freesurfer-rge/slothpu16/README.md

# slothpu16

This is a major revision of [an earlier project](http://www.github.com/freesurfer-rge/slothpu/) to build a computer from 7400-series logic.
This implements a simple 16-bit CPU with a load/store architecture.
