freesurfer-rge/slothpu16/python/ReadMe.md

# Python Code

This directory contains code other than that required for testing the PCBs.
