freesurfer-rge/slothpu16/(threads)

Thread 15 (2025-02-02):

[PCB] Missing silkscreen on ALU Carrier

freesurfer-rge, 2025-02-02:
Forgot to label the various edge connectors on the ALU carrier board.

Closed 2025-04-06.

Thread 20 (2025-05-16):

[PCB] Register File Carrier uses two 74HC04

freesurfer-rge, 2025-05-16:
When putting the JLCPCB order together, noticed that there were two different 74HC04 (hex inverters) present. Since neither was triggering the 'extended item' charges at the time, I didn't fix it. But if there is an revised board, this should be straightened out.
