freesurfer-rge/slothpu16/pcbs/SlothPU Backplane/SlothPU Backplane.kicad_pcb

## KiCad design pcbs/SlothPU Backplane/SlothPU Backplane.kicad_pcb (2025-09-15)

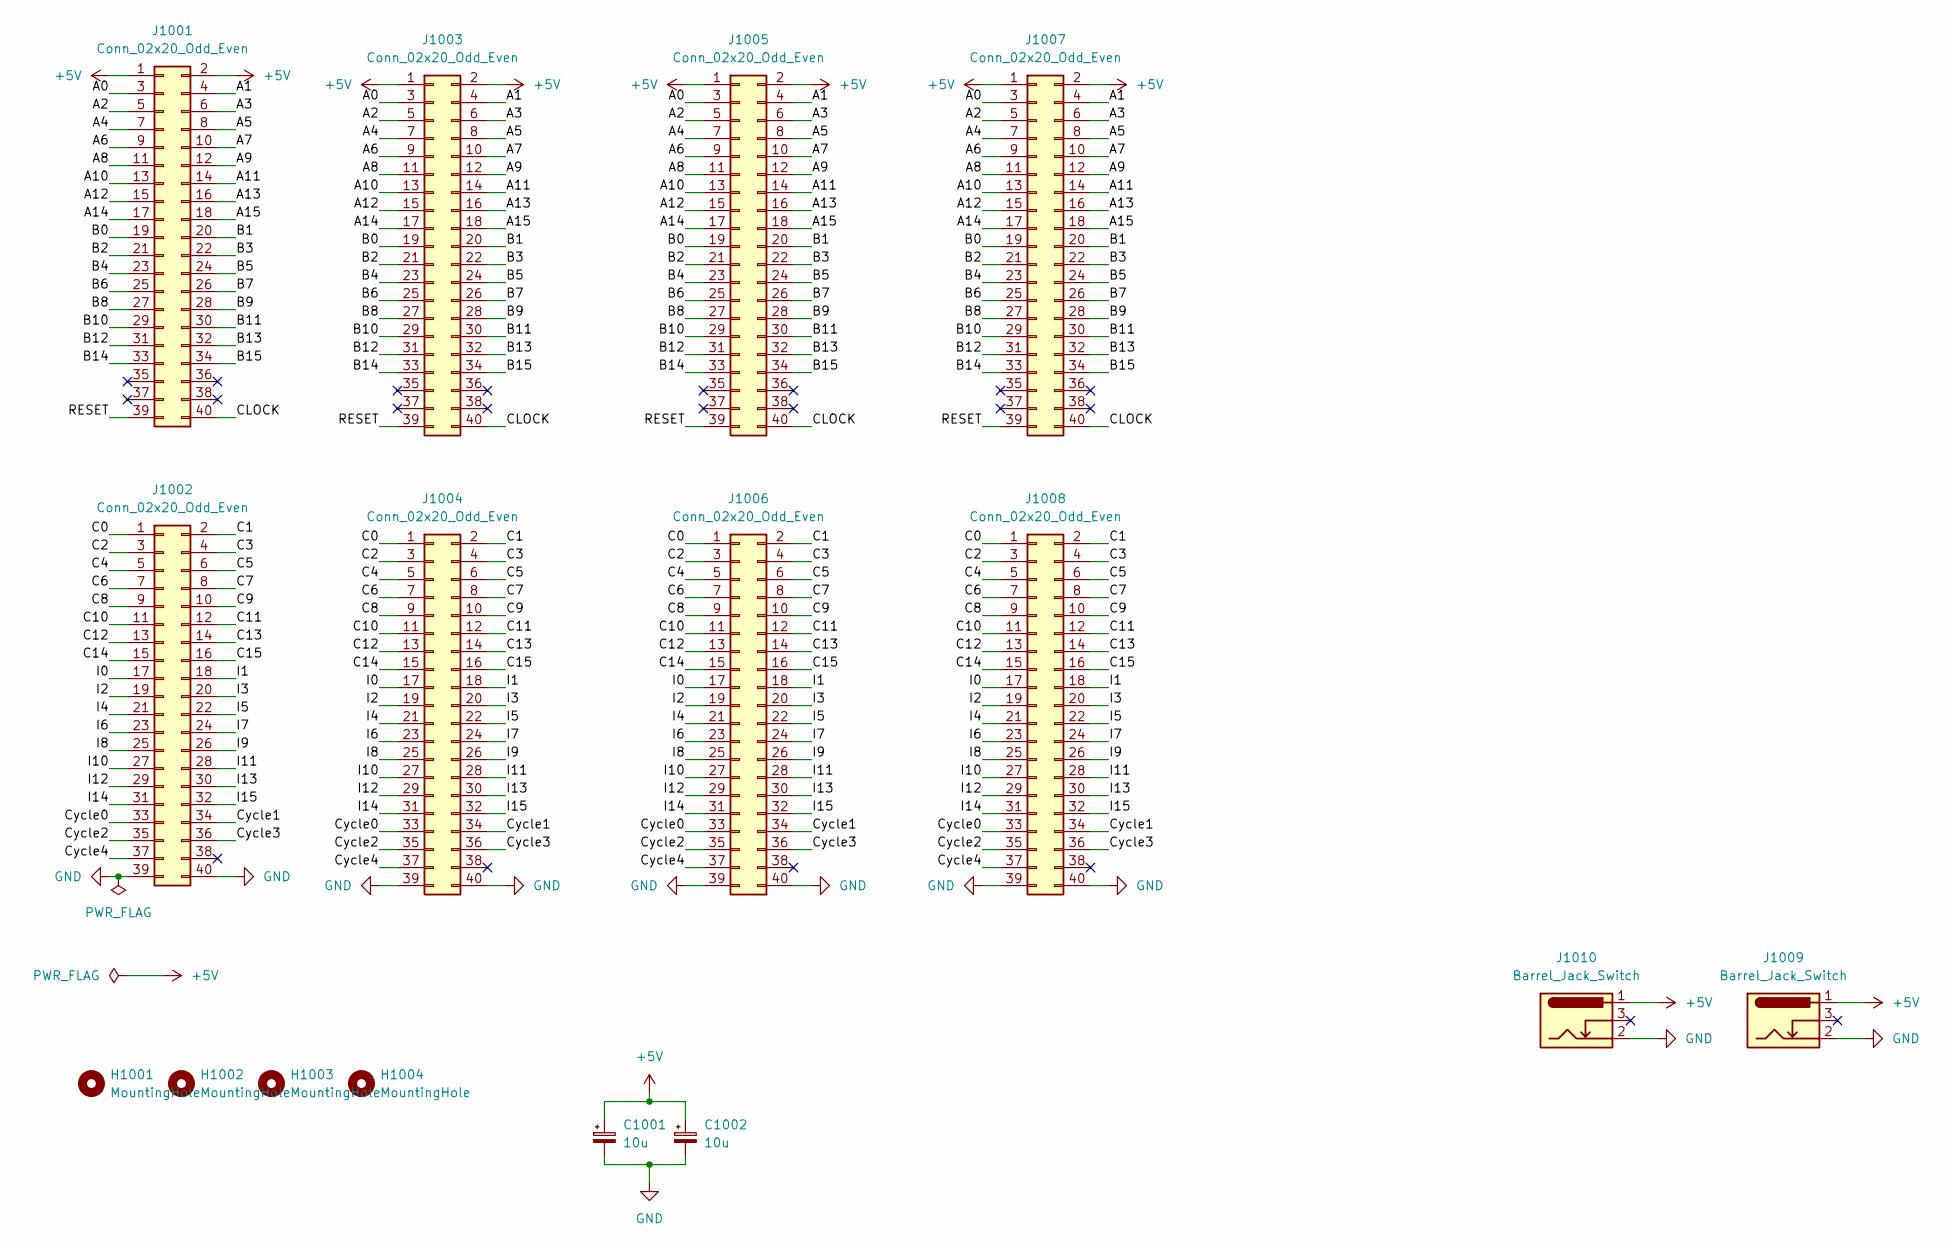
[picture p1: schematic SlothPU Backplane.kicad_sch]

Parts:
C1001, C1002: 10u; CP_Radial_D4.0mm_P1.50mm
H1001, H1002, H1003, H1004: MountingHole; MountingHole_2.7mm_M2.5_ISO7380
J1001, J1002, J1003, J1004, J1005, J1006, J1007, J1008: Conn_02x20_Odd_Even; PinHeader_2x20_P2.54mm_Vertical
J1009, J1010: Barrel_Jack_Switch; BarrelJack_Horizontal

Connections:
+5V: C1001.1, C1002.1, J1001.1, J1001.2, J1003.1, J1003.2, J1005.1, J1005.2, J1007.1, J1007.2, J1009.1, J1010.1
/A0: J1001.3, J1003.3, J1005.3, J1007.3
/A1: J1001.4, J1003.4, J1005.4, J1007.4
/A2: J1001.5, J1003.5, J1005.5, J1007.5
/A3: J1001.6, J1003.6, J1005.6, J1007.6
/A4: J1001.7, J1003.7, J1005.7, J1007.7
/A5: J1001.8, J1003.8, J1005.8, J1007.8
/A6: J1001.9, J1003.9, J1005.9, J1007.9
/A7: J1001.10, J1003.10, J1005.10, J1007.10
/A8: J1001.11, J1003.11, J1005.11, J1007.11
/A9: J1001.12, J1003.12, J1005.12, J1007.12
/A10: J1001.13, J1003.13, J1005.13, J1007.13
/A11: J1001.14, J1003.14, J1005.14, J1007.14
/A12: J1001.15, J1003.15, J1005.15, J1007.15
/A13: J1001.16, J1003.16, J1005.16, J1007.16
/A14: J1001.17, J1003.17, J1005.17, J1007.17
/A15: J1001.18, J1003.18, J1005.18, J1007.18
/B0: J1001.19, J1003.19, J1005.19, J1007.19
/B1: J1001.20, J1003.20, J1005.20, J1007.20
/B2: J1001.21, J1003.21, J1005.21, J1007.21
/B3: J1001.22, J1003.22, J1005.22, J1007.22
/B4: J1001.23, J1003.23, J1005.23, J1007.23
/B5: J1001.24, J1003.24, J1005.24, J1007.24
/B6: J1001.25, J1003.25, J1005.25, J1007.25
/B7: J1001.26, J1003.26, J1005.26, J1007.26
/B8: J1001.27, J1003.27, J1005.27, J1007.27
/B9: J1001.28, J1003.28, J1005.28, J1007.28
/B10: J1001.29, J1003.29, J1005.29, J1007.29
/B11: J1001.30, J1003.30, J1005.30, J1007.30
/B12: J1001.31, J1003.31, J1005.31, J1007.31
/B13: J1001.32, J1003.32, J1005.32, J1007.32
/B14: J1001.33, J1003.33, J1005.33, J1007.33
/B15: J1001.34, J1003.34, J1005.34, J1007.34
/C0: J1002.1, J1004.1, J1006.1, J1008.1
/C1: J1002.2, J1004.2, J1006.2, J1008.2
/C2: J1002.3, J1004.3, J1006.3, J1008.3
/C3: J1002.4, J1004.4, J1006.4, J1008.4
/C4: J1002.5, J1004.5, J1006.5, J1008.5
/C5: J1002.6, J1004.6, J1006.6, J1008.6
/C6: J1002.7, J1004.7, J1006.7, J1008.7
/C7: J1002.8, J1004.8, J1006.8, J1008.8
/C8: J1002.9, J1004.9, J1006.9, J1008.9
/C9: J1002.10, J1004.10, J1006.10, J1008.10
/C10: J1002.11, J1004.11, J1006.11, J1008.11
/C11: J1002.12, J1004.12, J1006.12, J1008.12
/C12: J1002.13, J1004.13, J1006.13, J1008.13
/C13: J1002.14, J1004.14, J1006.14, J1008.14
/C14: J1002.15, J1004.15, J1006.15, J1008.15
/C15: J1002.16, J1004.16, J1006.16, J1008.16
/CLOCK: J1001.40, J1003.40, J1005.40, J1007.40
/Cycle0: J1002.33, J1004.33, J1006.33, J1008.33
/Cycle1: J1002.34, J1004.34, J1006.34, J1008.34
/Cycle2: J1002.35, J1004.35, J1006.35, J1008.35
/Cycle3: J1002.36, J1004.36, J1006.36, J1008.36
/Cycle4: J1002.37, J1004.37, J1006.37, J1008.37
/I0: J1002.17, J1004.17, J1006.17, J1008.17
/I1: J1002.18, J1004.18, J1006.18, J1008.18
/I2: J1002.19, J1004.19, J1006.19, J1008.19
/I3: J1002.20, J1004.20, J1006.20, J1008.20
/I4: J1002.21, J1004.21, J1006.21, J1008.21
/I5: J1002.22, J1004.22, J1006.22, J1008.22
/I6: J1002.23, J1004.23, J1006.23, J1008.23
/I7: J1002.24, J1004.24, J1006.24, J1008.24
/I8: J1002.25, J1004.25, J1006.25, J1008.25
/I9: J1002.26, J1004.26, J1006.26, J1008.26
/I10: J1002.27, J1004.27, J1006.27, J1008.27
/I11: J1002.28, J1004.28, J1006.28, J1008.28
/I12: J1002.29, J1004.29, J1006.29, J1008.29
/I13: J1002.30, J1004.30, J1006.30, J1008.30
/I14: J1002.31, J1004.31, J1006.31, J1008.31
/I15: J1002.32, J1004.32, J1006.32, J1008.32
/RESET: J1001.39, J1003.39, J1005.39, J1007.39
GND: C1001.2, C1002.2, J1002.39, J1002.40, J1004.39, J1004.40, J1006.39, J1006.40, J1008.39, J1008.40, J1009.2, J1010.2

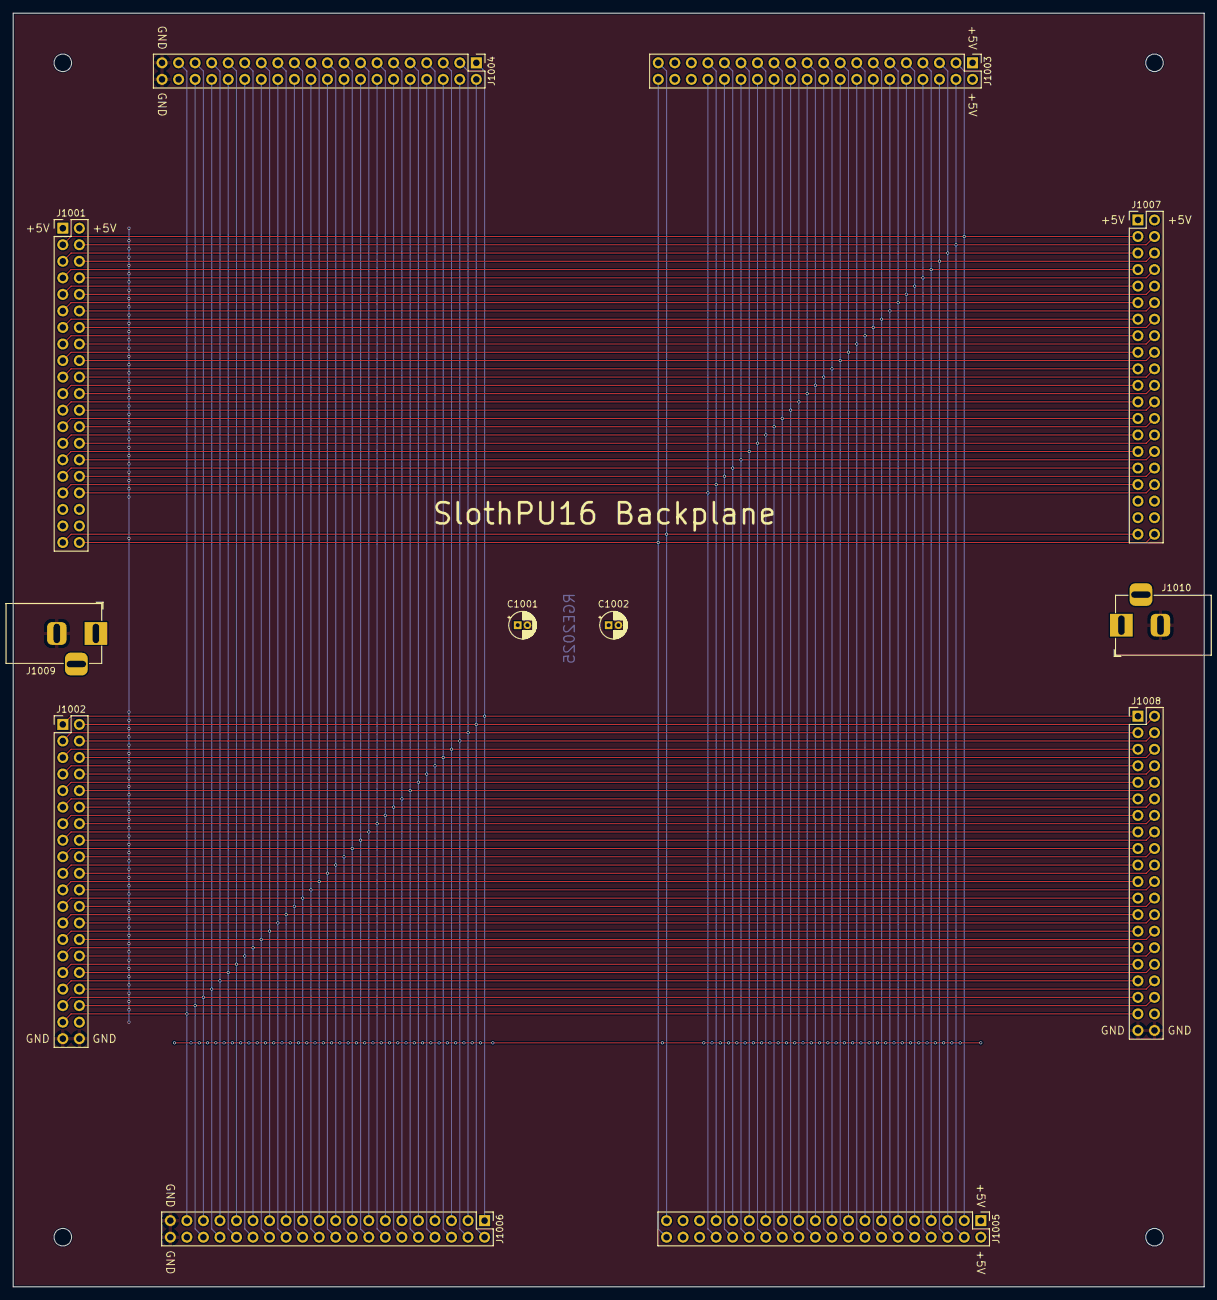
[picture p2: board SlothPU Backplane.kicad_pcb from above]

Board: 2 copper layers, 182.9 x 195.6 mm, 16 parts (0 on the bottom side), 73 nets.
