freesurfer-rge/slothpu16/pcbs/Instruction Register/Instruction Register.kicad_pcb

## KiCad design pcbs/Instruction Register/Instruction Register.kicad_pcb (2025-08-27)

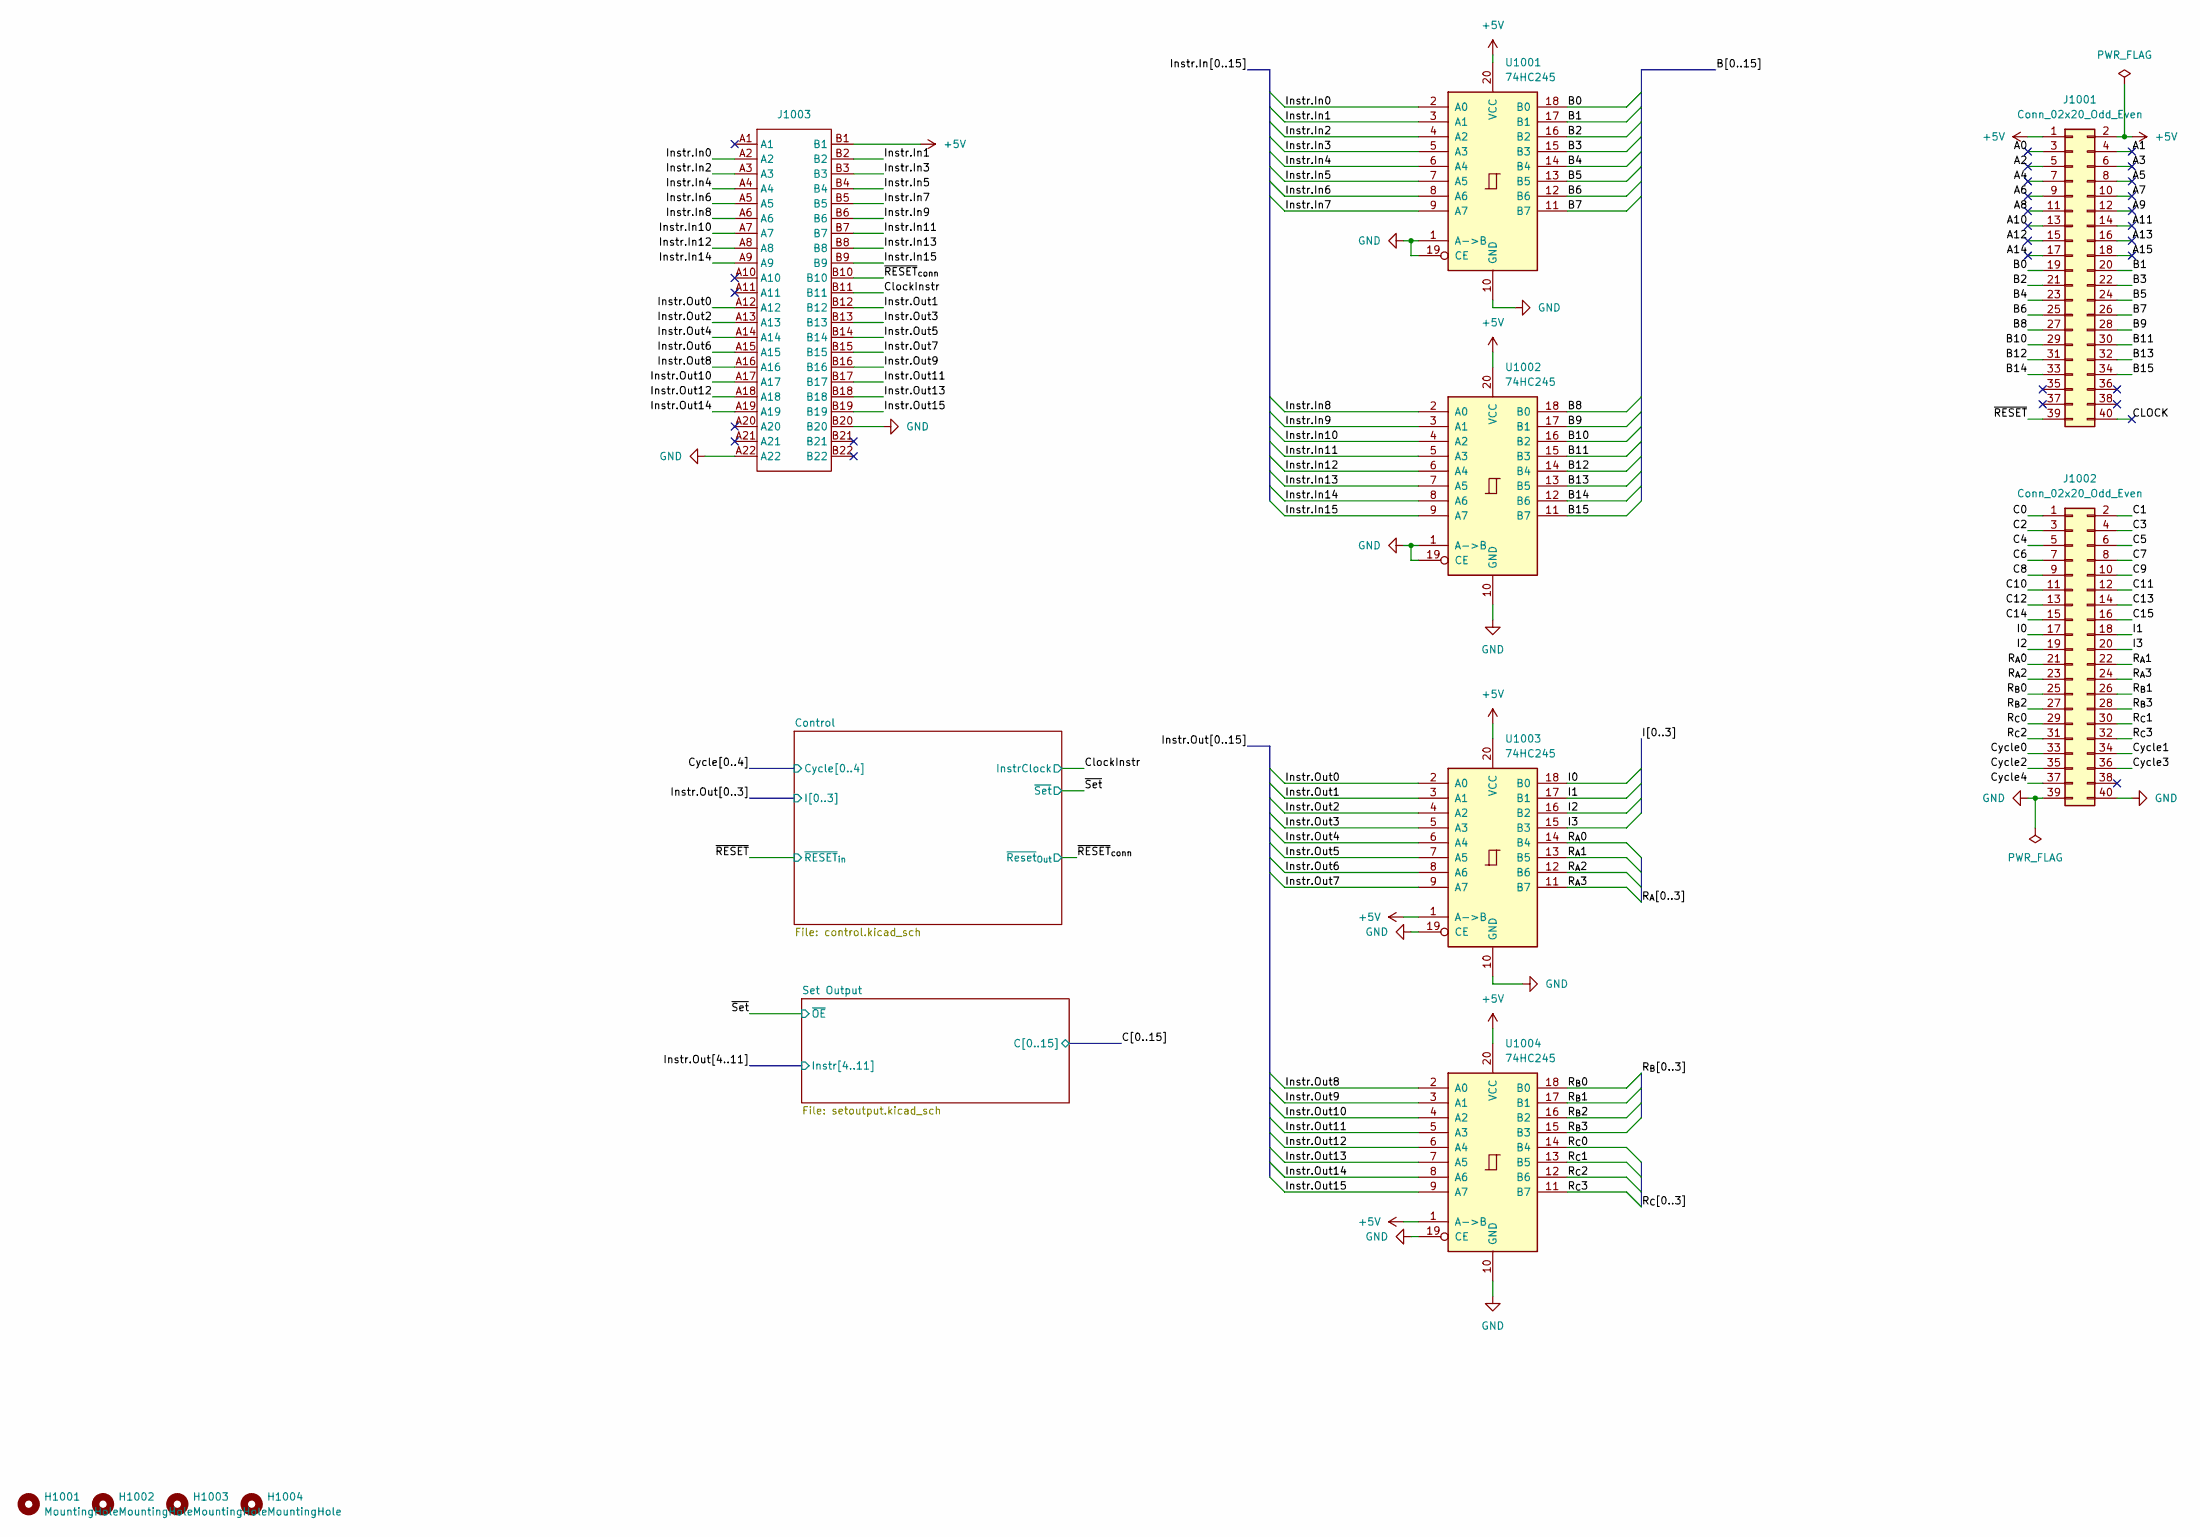
[picture p3: schematic Instruction Register.kicad_sch]

Parts:
H1001, H1002, H1003, H1004: MountingHole; MountingHole_2.7mm_M2.5_ISO7380
J1001, J1002: Conn_02x20_Odd_Even; PinHeader_2x20_P2.54mm_Vertical
J1003: TE-5530843-4-Mount
U1001, U1002, U1003, U1004: 74HC245; SOIC-20W_7.5x12.8mm_P1.27mm; LCSC C5625

Connections:
+5V: J1001.1, J1001.2, J1003.B1, U1001.20 (VCC), U1002.20 (VCC), U1003.1 (A->B), U1003.20 (VCC), U1004.1 (A->B), U1004.20 (VCC); also elsewhere on the board
/A0: J1001.3
/A1: J1001.4
/A2: J1001.5
/A3: J1001.6
/A4: J1001.7
/A5: J1001.8
/A6: J1001.9
/A7: J1001.10
/A8: J1001.11
/A9: J1001.12
/A10: J1001.13
/A11: J1001.14
/A12: J1001.15
/A13: J1001.16
/A14: J1001.17
/A15: J1001.18
/B0: J1001.19, U1001.18 (B0)
/B1: J1001.20, U1001.17 (B1)
/B2: J1001.21, U1001.16 (B2)
/B3: J1001.22, U1001.15 (B3)
/B4: J1001.23, U1001.14 (B4)
/B5: J1001.24, U1001.13 (B5)
/B6: J1001.25, U1001.12 (B6)
/B7: J1001.26, U1001.11 (B7)
/B8: J1001.27, U1002.18 (B0)
/B9: J1001.28, U1002.17 (B1)
/B10: J1001.29, U1002.16 (B2)
/B11: J1001.30, U1002.15 (B3)
/B12: J1001.31, U1002.14 (B4)
/B13: J1001.32, U1002.13 (B5)
/B14: J1001.33, U1002.12 (B6)
/B15: J1001.34, U1002.11 (B7)
/C0: J1002.1; also elsewhere on the board
/C1: J1002.2; also elsewhere on the board
/C2: J1002.3; also elsewhere on the board
/C3: J1002.4; also elsewhere on the board
/C4: J1002.5; also elsewhere on the board
/C5: J1002.6; also elsewhere on the board
/C6: J1002.7; also elsewhere on the board
/C7: J1002.8; also elsewhere on the board
/C8: J1002.9; also elsewhere on the board
/C9: J1002.10; also elsewhere on the board
/C10: J1002.11; also elsewhere on the board
/C11: J1002.12; also elsewhere on the board
/C12: J1002.13; also elsewhere on the board
/C13: J1002.14; also elsewhere on the board
/C14: J1002.15; also elsewhere on the board
/C15: J1002.16; also elsewhere on the board
/CLOCK: J1001.40
/ClockInstr: J1003.B11; also elsewhere on the board
/Cycle0: J1002.33
/Cycle1: J1002.34; also elsewhere on the board
/Cycle2: J1002.35; also elsewhere on the board
/Cycle3: J1002.36; also elsewhere on the board
/Cycle4: J1002.37; also elsewhere on the board
/I0: J1002.17, U1003.18 (B0)
/I1: J1002.18, U1003.17 (B1)
/I2: J1002.19, U1003.16 (B2)
/I3: J1002.20, U1003.15 (B3)
/Instr.In0: J1003.A2, U1001.2 (A0)
/Instr.In1: J1003.B2, U1001.3 (A1)
/Instr.In2: J1003.A3, U1001.4 (A2)
/Instr.In3: J1003.B3, U1001.5 (A3)
/Instr.In4: J1003.A4, U1001.6 (A4)
/Instr.In5: J1003.B4, U1001.7 (A5)
/Instr.In6: J1003.A5, U1001.8 (A6)
/Instr.In7: J1003.B5, U1001.9 (A7)
/Instr.In8: J1003.A6, U1002.2 (A0)
/Instr.In9: J1003.B6, U1002.3 (A1)
/Instr.In10: J1003.A7, U1002.4 (A2)
/Instr.In11: J1003.B7, U1002.5 (A3)
/Instr.In12: J1003.A8, U1002.6 (A4)
/Instr.In13: J1003.B8, U1002.7 (A5)
/Instr.In14: J1003.A9, U1002.8 (A6)
/Instr.In15: J1003.B9, U1002.9 (A7)
/Instr.Out0: J1003.A12, U1003.2 (A0); also elsewhere on the board
/Instr.Out1: J1003.B12, U1003.3 (A1); also elsewhere on the board
/Instr.Out2: J1003.A13, U1003.4 (A2); also elsewhere on the board
/Instr.Out3: J1003.B13, U1003.5 (A3); also elsewhere on the board
/Instr.Out4: J1003.A14, U1003.6 (A4); also elsewhere on the board
/Instr.Out5: J1003.B14, U1003.7 (A5); also elsewhere on the board
/Instr.Out6: J1003.A15, U1003.8 (A6); also elsewhere on the board
/Instr.Out7: J1003.B15, U1003.9 (A7); also elsewhere on the board
/Instr.Out8: J1003.A16, U1004.2 (A0); also elsewhere on the board
/Instr.Out9: J1003.B16, U1004.3 (A1); also elsewhere on the board
/Instr.Out10: J1003.A17, U1004.4 (A2); also elsewhere on the board
/Instr.Out11: J1003.B17, U1004.5 (A3); also elsewhere on the board
/Instr.Out12: J1003.A18, U1004.6 (A4)
/Instr.Out13: J1003.B18, U1004.7 (A5)
/Instr.Out14: J1003.A19, U1004.8 (A6)
/Instr.Out15: J1003.B19, U1004.9 (A7)
/R_{A}0: J1002.21, U1003.14 (B4)
/R_{A}1: J1002.22, U1003.13 (B5)
/R_{A}2: J1002.23, U1003.12 (B6)
/R_{A}3: J1002.24, U1003.11 (B7)
/R_{B}0: J1002.25, U1004.18 (B0)
/R_{B}1: J1002.26, U1004.17 (B1)
/R_{B}2: J1002.27, U1004.16 (B2)
/R_{B}3: J1002.28, U1004.15 (B3)
/R_{C}0: J1002.29, U1004.14 (B4)
/R_{C}1: J1002.30, U1004.13 (B5)
/R_{C}2: J1002.31, U1004.12 (B6)
/R_{C}3: J1002.32, U1004.11 (B7)
/~RESET: J1001.39; also elsewhere on the board
/~RESET_{conn}: J1003.B10; also elsewhere on the board
GND: J1002.39, J1002.40, J1003.A22, J1003.B20, U1001.1 (A->B), U1001.10 (GND), U1001.19 (CE), U1002.1 (A->B), U1002.10 (GND), U1002.19 (CE), U1003.10 (GND), U1003.19 (CE), U1004.10 (GND), U1004.19 (CE); also elsewhere on the board

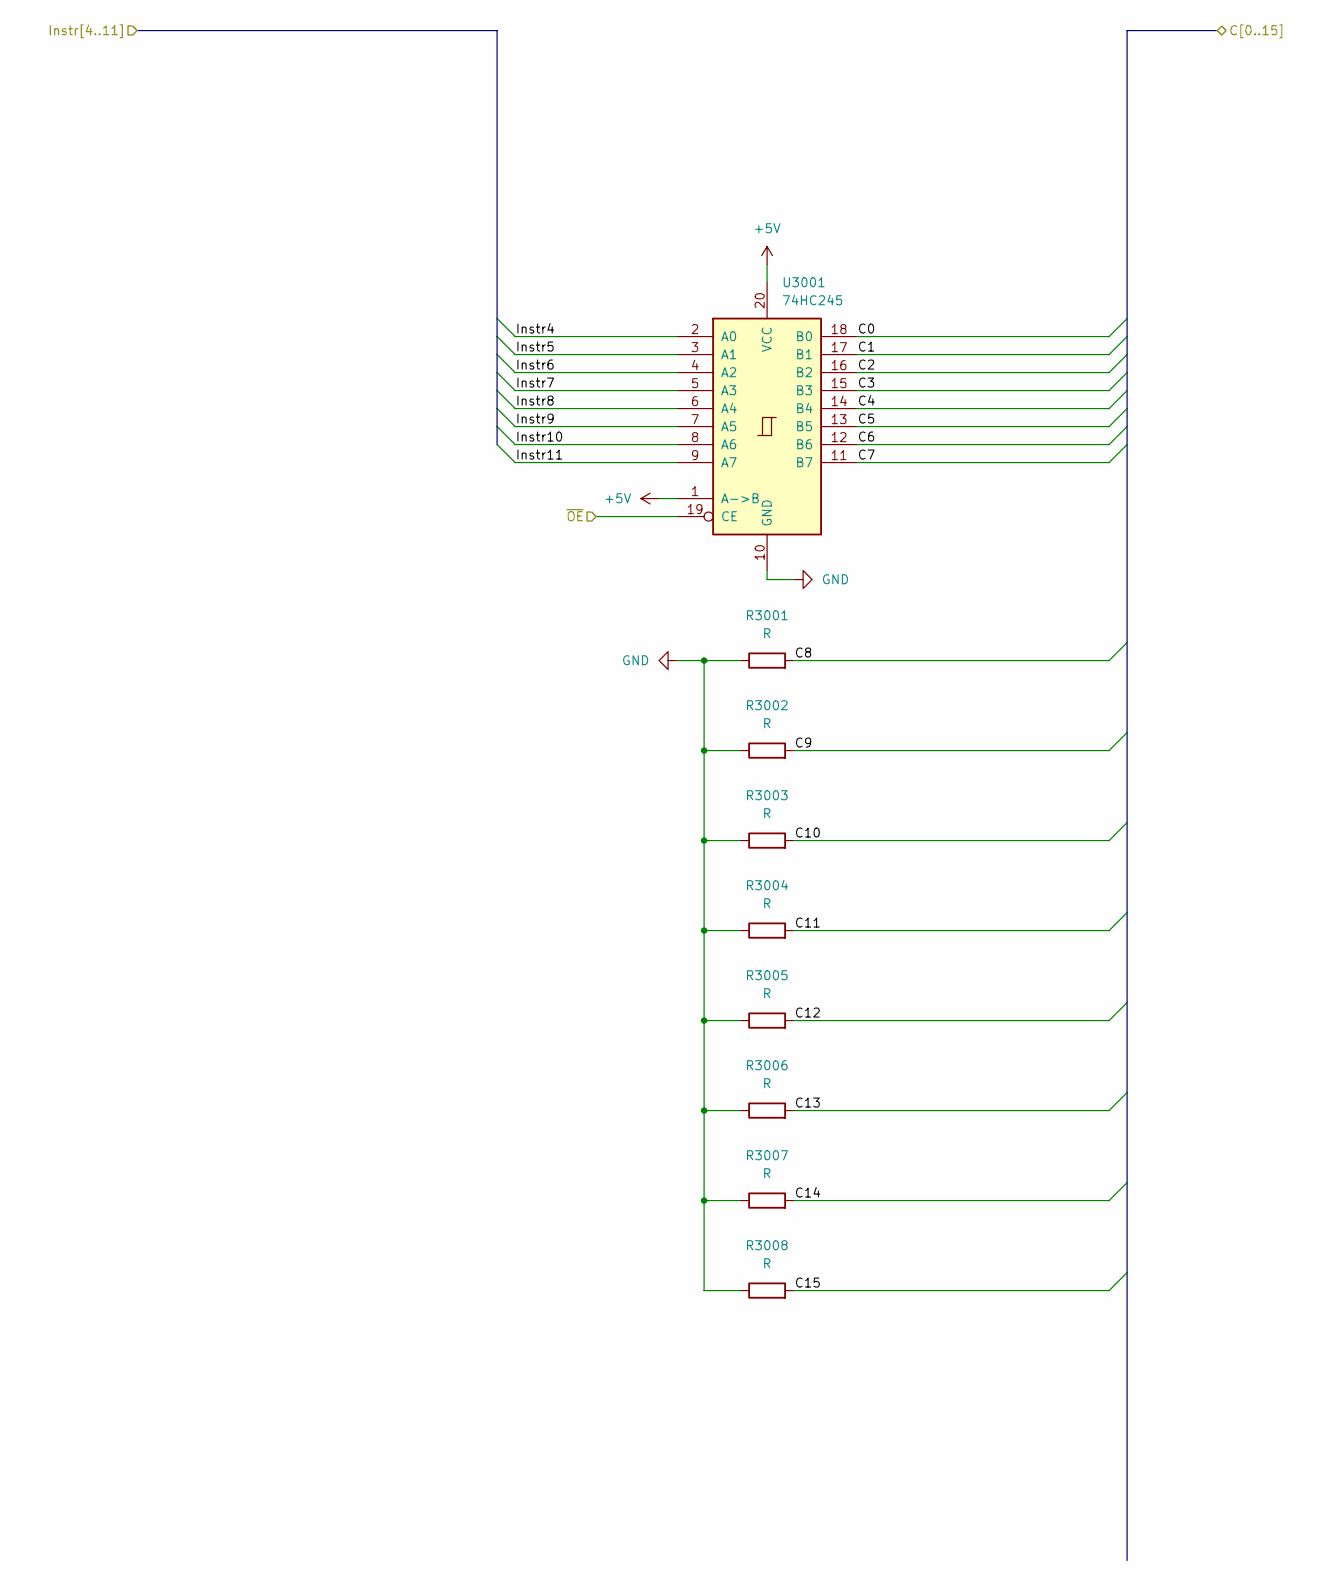
[picture p4: schematic setoutput.kicad_sch]

Parts:
R3001, R3002, R3003, R3004, R3005, R3006, R3007, R3008: R; R_0603_1608Metric; LCSC C22935
U3001: 74HC245; SOIC-20W_7.5x12.8mm_P1.27mm; LCSC C5625

Connections:
+5V: U3001.1 (A->B), U3001.20 (VCC); also elsewhere on the board
/C0: U3001.18 (B0); also elsewhere on the board
/C1: U3001.17 (B1); also elsewhere on the board
/C2: U3001.16 (B2); also elsewhere on the board
/C3: U3001.15 (B3); also elsewhere on the board
/C4: U3001.14 (B4); also elsewhere on the board
/C5: U3001.13 (B5); also elsewhere on the board
/C6: U3001.12 (B6); also elsewhere on the board
/C7: U3001.11 (B7); also elsewhere on the board
/C8: R3001.2; also elsewhere on the board
/C9: R3002.2; also elsewhere on the board
/C10: R3003.2; also elsewhere on the board
/C11: R3004.2; also elsewhere on the board
/C12: R3005.2; also elsewhere on the board
/C13: R3006.2; also elsewhere on the board
/C14: R3007.2; also elsewhere on the board
/C15: R3008.2; also elsewhere on the board
/Instr.Out4: U3001.2 (A0); also elsewhere on the board
/Instr.Out5: U3001.3 (A1); also elsewhere on the board
/Instr.Out6: U3001.4 (A2); also elsewhere on the board
/Instr.Out7: U3001.5 (A3); also elsewhere on the board
/Instr.Out8: U3001.6 (A4); also elsewhere on the board
/Instr.Out9: U3001.7 (A5); also elsewhere on the board
/Instr.Out10: U3001.8 (A6); also elsewhere on the board
/Instr.Out11: U3001.9 (A7); also elsewhere on the board
/~Set: U3001.19 (CE); also elsewhere on the board
GND: R3001.1, R3002.1, R3003.1, R3004.1, R3005.1, R3006.1, R3007.1, R3008.1, U3001.10 (GND); also elsewhere on the board

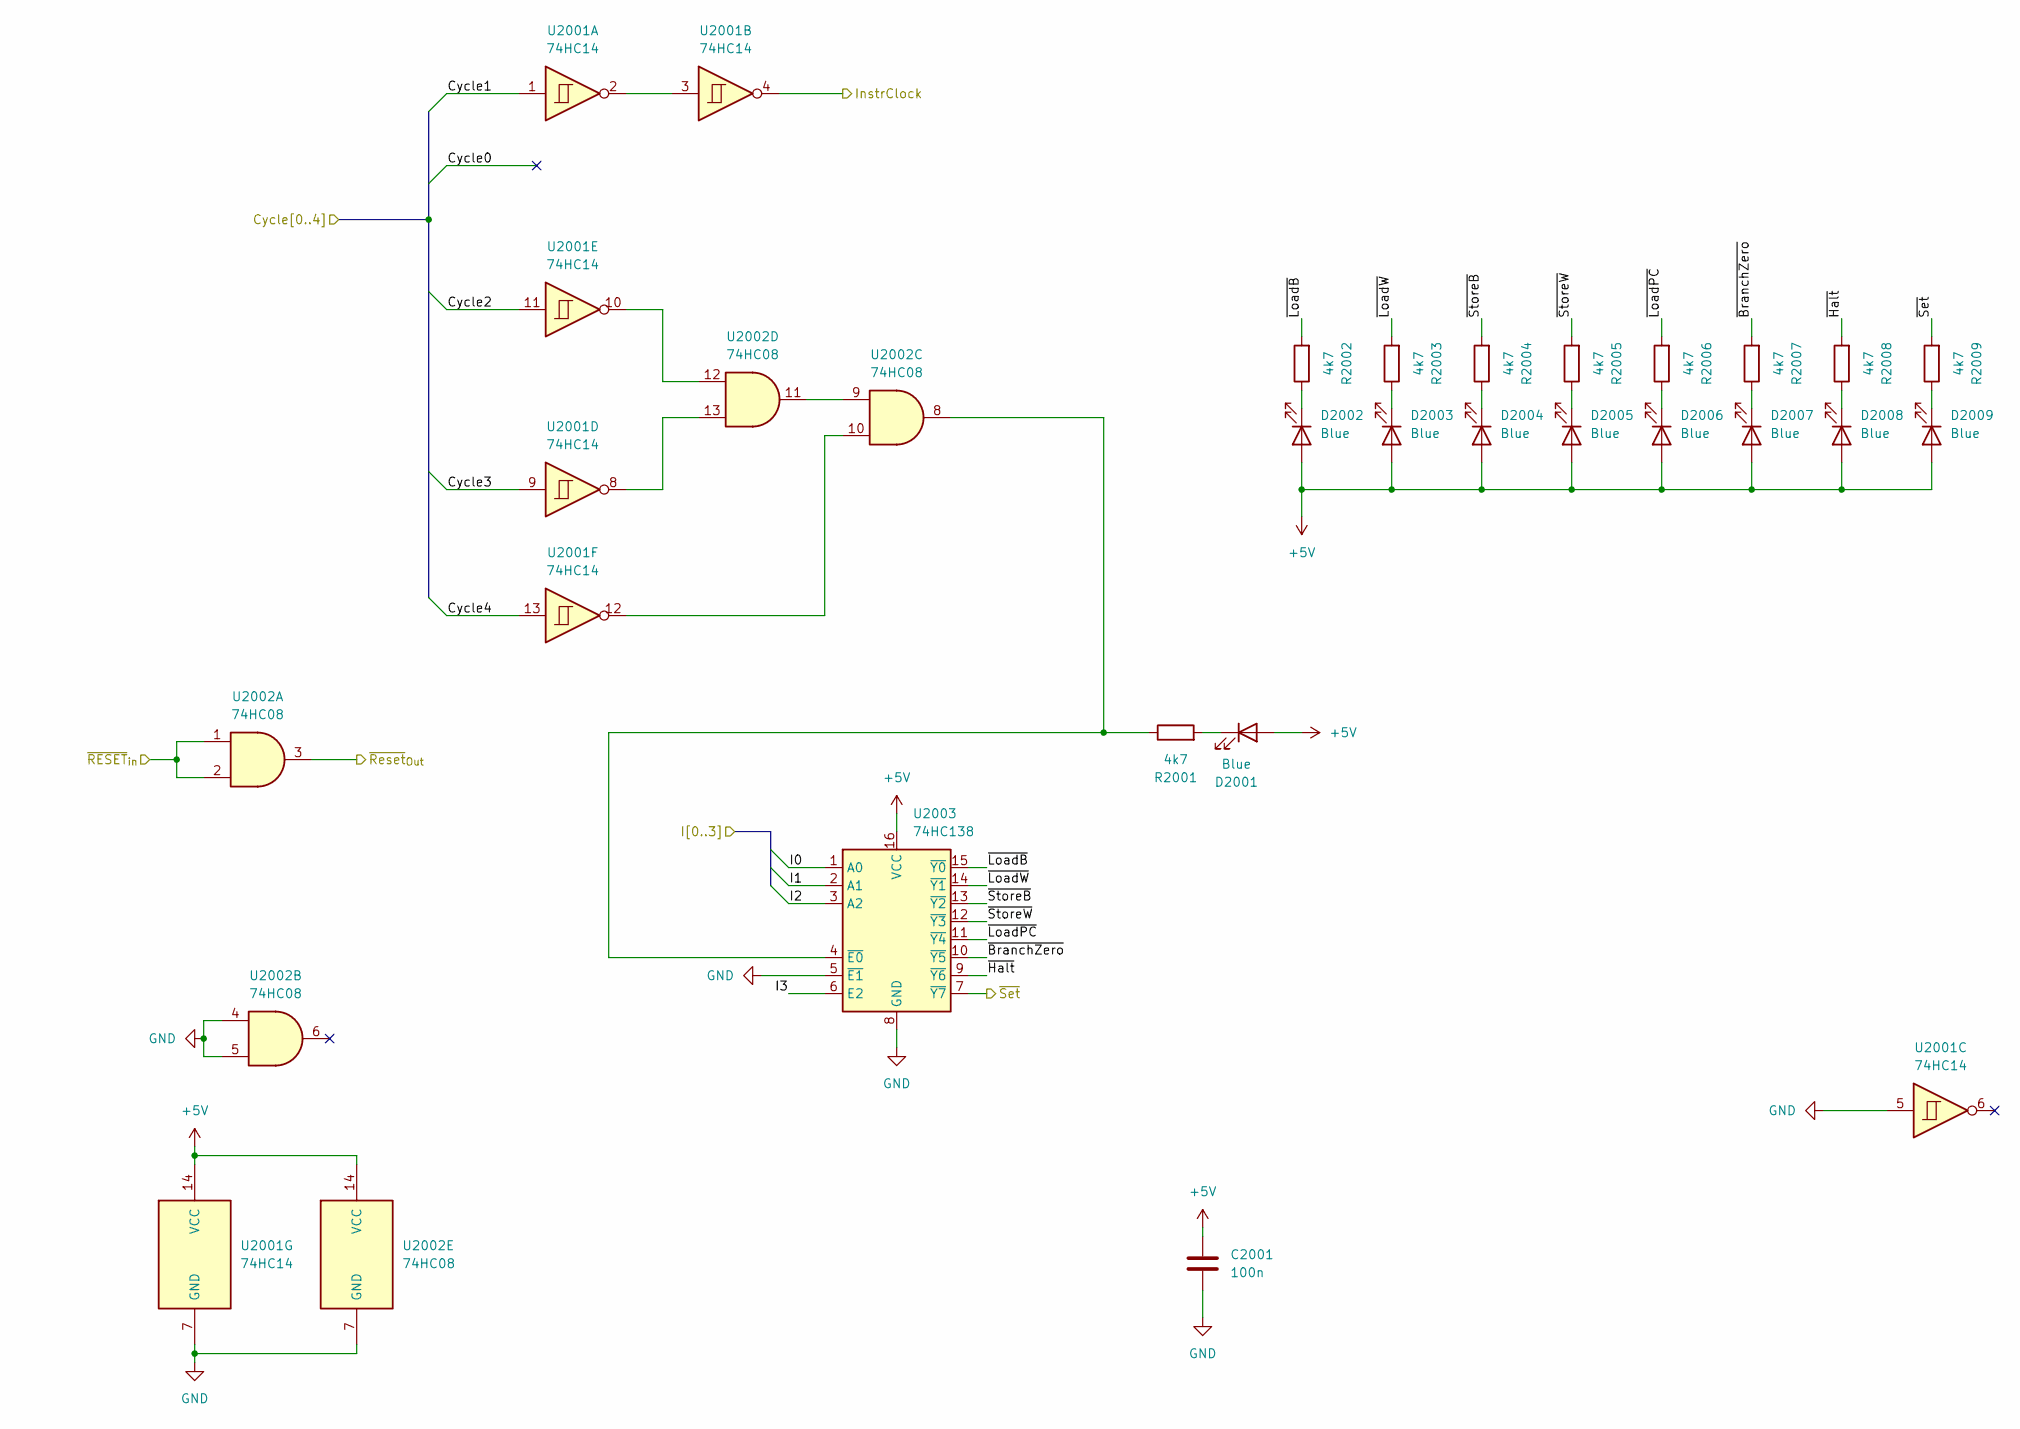
[picture p5: schematic control.kicad_sch]

Parts:
C2001: 100n; C_0603_1608Metric; LCSC C14663
D2001, D2002, D2003, D2004, D2005, D2006, D2007, D2008, D2009: Blue; LED_0603_1608Metric; LCSC C72041
R2001, R2002, R2003, R2004, R2005, R2006, R2007, R2008, R2009: 4k7; R_0603_1608Metric; LCSC C23162
U2001: 74HC14; SOIC-14_3.9x8.7mm_P1.27mm; LCSC C5605
U2002: 74HC08; SOIC-14_3.9x8.7mm_P1.27mm; LCSC C5593
U2003: 74HC138; DIP-16_W7.62mm_Socket

Connections:
+5V: C2001.1, D2001.2 (A), D2002.2 (A), D2003.2 (A), D2004.2 (A), D2005.2 (A), D2006.2 (A), D2007.2 (A), D2008.2 (A), D2009.2 (A), U2001.14 (VCC), U2002.14 (VCC), U2003.16 (VCC); also elsewhere on the board
/ClockInstr: U2001.4; also elsewhere on the board
/Control/~BranchZero: R2007.2, U2003.10 (~Y5)
/Control/~Halt: R2008.2, U2003.9 (~Y6)
/Control/~LoadB: R2002.2, U2003.15 (~Y0)
/Control/~LoadPC: R2006.2, U2003.11 (~Y4)
/Control/~LoadW: R2003.2, U2003.14 (~Y1)
/Control/~StoreB: R2004.2, U2003.13 (~Y2)
/Control/~StoreW: R2005.2, U2003.12 (~Y3)
/Cycle1: U2001.1; also elsewhere on the board
/Cycle2: U2001.11; also elsewhere on the board
/Cycle3: U2001.9; also elsewhere on the board
/Cycle4: U2001.13; also elsewhere on the board
/Instr.Out0: U2003.1 (A0); also elsewhere on the board
/Instr.Out1: U2003.2 (A1); also elsewhere on the board
/Instr.Out2: U2003.3 (A2); also elsewhere on the board
/Instr.Out3: U2003.6 (E2); also elsewhere on the board
/~RESET: U2002.1, U2002.2; also elsewhere on the board
/~RESET_{conn}: U2002.3; also elsewhere on the board
/~Set: R2009.2, U2003.7 (~Y7); also elsewhere on the board
GND: C2001.2, U2001.5, U2001.7 (GND), U2002.4, U2002.5, U2002.7 (GND), U2003.5 (~E1), U2003.8 (GND); also elsewhere on the board
unnamed: D2001.1 (K), R2001.2
unnamed: D2002.1 (K), R2002.1
unnamed: D2003.1 (K), R2003.1
unnamed: D2004.1 (K), R2004.1
unnamed: D2005.1 (K), R2005.1
unnamed: D2006.1 (K), R2006.1
unnamed: D2007.1 (K), R2007.1
unnamed: D2008.1 (K), R2008.1
unnamed: D2009.1 (K), R2009.1
unnamed: U2001.2, U2001.3
unnamed: U2001.8, U2002.13
unnamed: U2001.10, U2002.12
unnamed: U2001.12, U2002.10
unnamed: U2002.9, U2002.11
unnamed: R2001.1, U2002.8, U2003.4 (~E0)

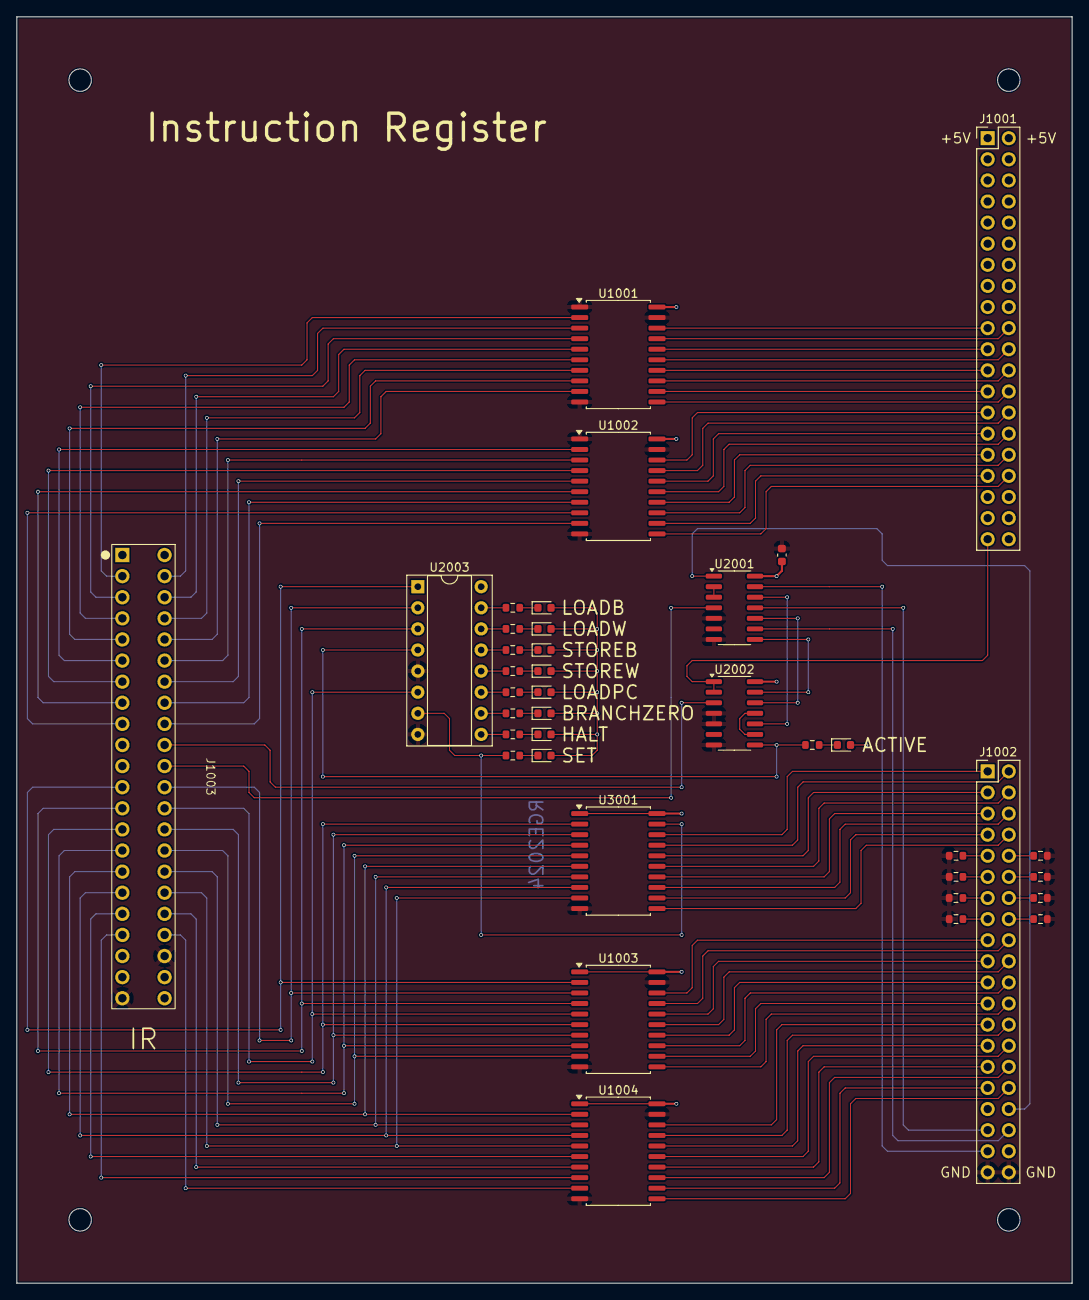
[picture p6: board Instruction Register.kicad_pcb from above]

Board: 2 copper layers, 127.0 x 152.4 mm, 42 parts (0 on the bottom side), 112 nets.
