freesurfer-rge/slothpu16/pcbs/Program Counter/Program Counter.kicad_pcb

## KiCad design pcbs/Program Counter/Program Counter.kicad_pcb (2025-07-27)

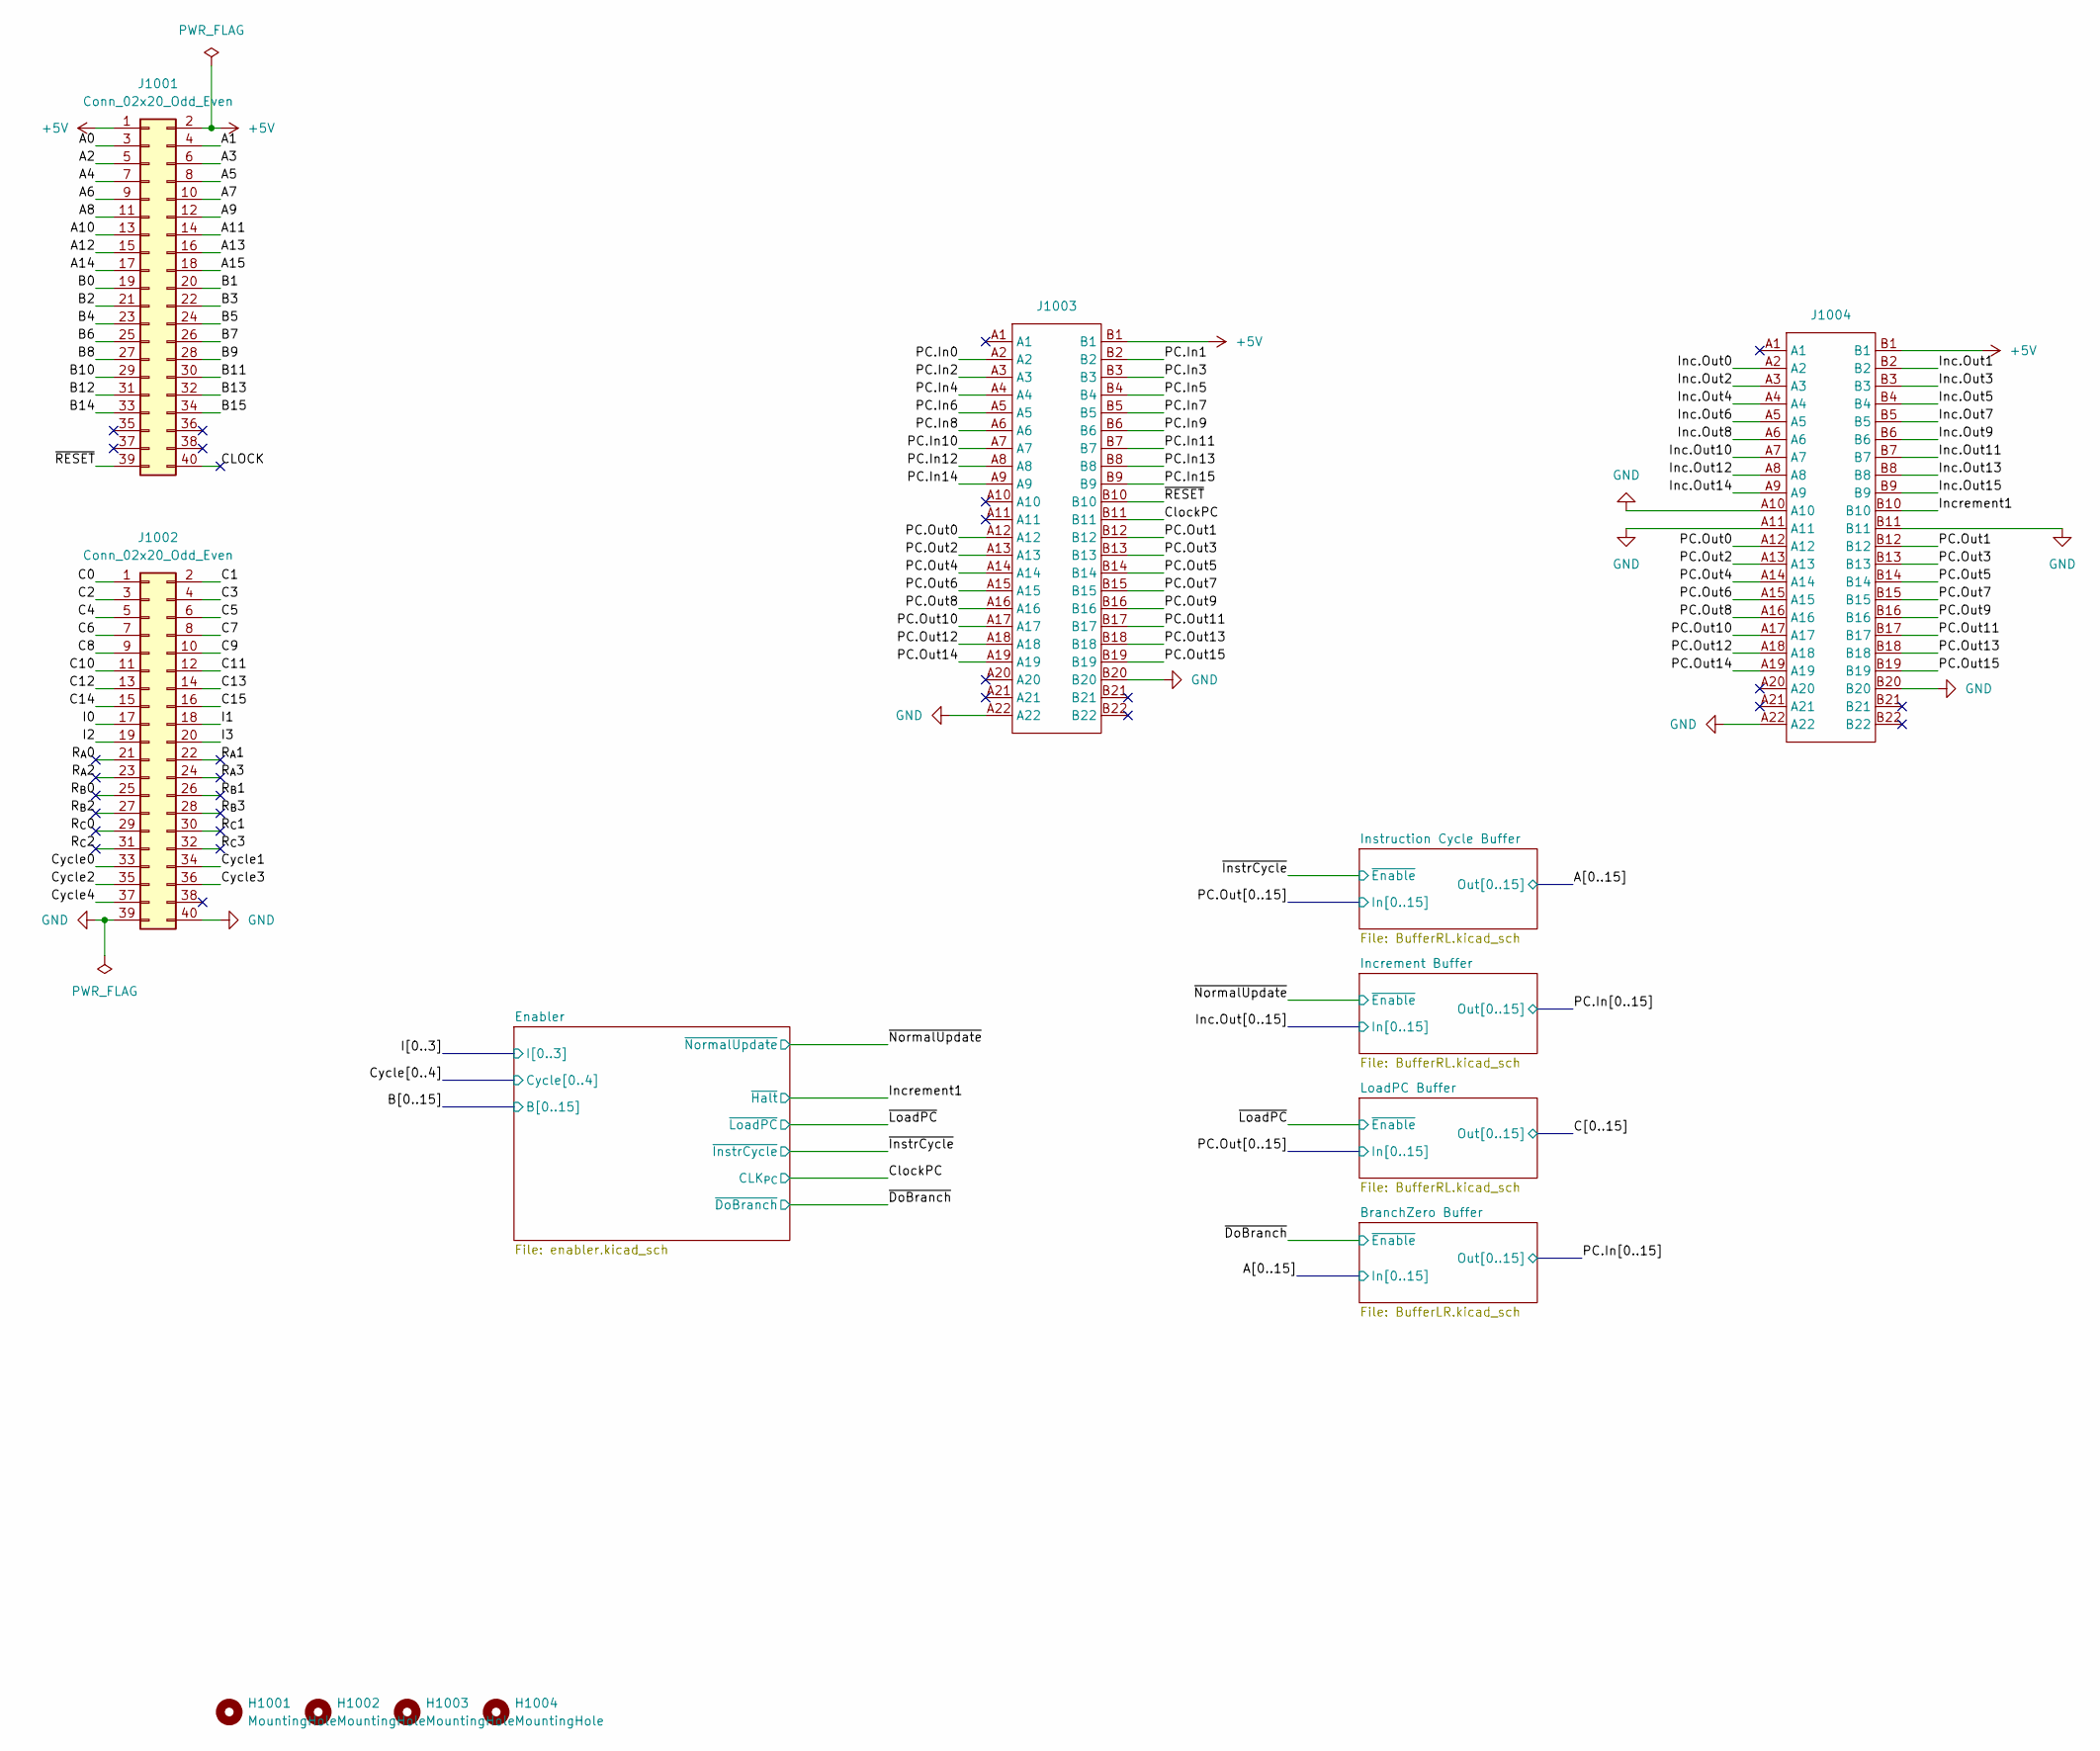
[picture p7: schematic Program Counter.kicad_sch]

Parts:
H1001, H1002, H1003, H1004: MountingHole; MountingHole_2.7mm_M2.5_ISO7380
J1001, J1002: Conn_02x20_Odd_Even; PinHeader_2x20_P2.54mm_Vertical
J1003, J1004: TE-5530843-4-Mount

Connections:
+5V: J1001.1, J1001.2, J1003.B1, J1004.B1; also elsewhere on the board
/A0: J1001.3; also elsewhere on the board
/A1: J1001.4; also elsewhere on the board
/A2: J1001.5; also elsewhere on the board
/A3: J1001.6; also elsewhere on the board
/A4: J1001.7; also elsewhere on the board
/A5: J1001.8; also elsewhere on the board
/A6: J1001.9; also elsewhere on the board
/A7: J1001.10; also elsewhere on the board
/A8: J1001.11; also elsewhere on the board
/A9: J1001.12; also elsewhere on the board
/A10: J1001.13; also elsewhere on the board
/A11: J1001.14; also elsewhere on the board
/A12: J1001.15; also elsewhere on the board
/A13: J1001.16; also elsewhere on the board
/A14: J1001.17; also elsewhere on the board
/A15: J1001.18; also elsewhere on the board
/B0: J1001.19; also elsewhere on the board
/B1: J1001.20; also elsewhere on the board
/B2: J1001.21; also elsewhere on the board
/B3: J1001.22; also elsewhere on the board
/B4: J1001.23; also elsewhere on the board
/B5: J1001.24; also elsewhere on the board
/B6: J1001.25; also elsewhere on the board
/B7: J1001.26; also elsewhere on the board
/B8: J1001.27; also elsewhere on the board
/B9: J1001.28; also elsewhere on the board
/B10: J1001.29; also elsewhere on the board
/B11: J1001.30; also elsewhere on the board
/B12: J1001.31; also elsewhere on the board
/B13: J1001.32; also elsewhere on the board
/B14: J1001.33; also elsewhere on the board
/B15: J1001.34; also elsewhere on the board
/C0: J1002.1; also elsewhere on the board
/C1: J1002.2; also elsewhere on the board
/C2: J1002.3; also elsewhere on the board
/C3: J1002.4; also elsewhere on the board
/C4: J1002.5; also elsewhere on the board
/C5: J1002.6; also elsewhere on the board
/C6: J1002.7; also elsewhere on the board
/C7: J1002.8; also elsewhere on the board
/C8: J1002.9; also elsewhere on the board
/C9: J1002.10; also elsewhere on the board
/C10: J1002.11; also elsewhere on the board
/C11: J1002.12; also elsewhere on the board
/C12: J1002.13; also elsewhere on the board
/C13: J1002.14; also elsewhere on the board
/C14: J1002.15; also elsewhere on the board
/C15: J1002.16; also elsewhere on the board
/CLOCK: J1001.40
/ClockPC: J1003.B11; also elsewhere on the board
/Cycle0: J1002.33; also elsewhere on the board
/Cycle1: J1002.34; also elsewhere on the board
/Cycle2: J1002.35; also elsewhere on the board
/Cycle3: J1002.36; also elsewhere on the board
/Cycle4: J1002.37; also elsewhere on the board
/I0: J1002.17; also elsewhere on the board
/I1: J1002.18; also elsewhere on the board
/I2: J1002.19; also elsewhere on the board
/I3: J1002.20; also elsewhere on the board
/Inc.Out0: J1004.A2; also elsewhere on the board
/Inc.Out1: J1004.B2; also elsewhere on the board
/Inc.Out2: J1004.A3; also elsewhere on the board
/Inc.Out3: J1004.B3; also elsewhere on the board
/Inc.Out4: J1004.A4; also elsewhere on the board
/Inc.Out5: J1004.B4; also elsewhere on the board
/Inc.Out6: J1004.A5; also elsewhere on the board
/Inc.Out7: J1004.B5; also elsewhere on the board
/Inc.Out8: J1004.A6; also elsewhere on the board
/Inc.Out9: J1004.B6; also elsewhere on the board
/Inc.Out10: J1004.A7; also elsewhere on the board
/Inc.Out11: J1004.B7; also elsewhere on the board
/Inc.Out12: J1004.A8; also elsewhere on the board
/Inc.Out13: J1004.B8; also elsewhere on the board
/Inc.Out14: J1004.A9; also elsewhere on the board
/Inc.Out15: J1004.B9; also elsewhere on the board
/Increment1: J1004.B10; also elsewhere on the board
/PC.In0: J1003.A2; also elsewhere on the board
/PC.In1: J1003.B2; also elsewhere on the board
/PC.In2: J1003.A3; also elsewhere on the board
/PC.In3: J1003.B3; also elsewhere on the board
/PC.In4: J1003.A4; also elsewhere on the board
/PC.In5: J1003.B4; also elsewhere on the board
/PC.In6: J1003.A5; also elsewhere on the board
/PC.In7: J1003.B5; also elsewhere on the board
/PC.In8: J1003.A6; also elsewhere on the board
/PC.In9: J1003.B6; also elsewhere on the board
/PC.In10: J1003.A7; also elsewhere on the board
/PC.In11: J1003.B7; also elsewhere on the board
/PC.In12: J1003.A8; also elsewhere on the board
/PC.In13: J1003.B8; also elsewhere on the board
/PC.In14: J1003.A9; also elsewhere on the board
/PC.In15: J1003.B9; also elsewhere on the board
/PC.Out0: J1003.A12, J1004.A12; also elsewhere on the board
/PC.Out1: J1003.B12, J1004.B12; also elsewhere on the board
/PC.Out2: J1003.A13, J1004.A13; also elsewhere on the board
/PC.Out3: J1003.B13, J1004.B13; also elsewhere on the board
/PC.Out4: J1003.A14, J1004.A14; also elsewhere on the board
/PC.Out5: J1003.B14, J1004.B14; also elsewhere on the board
/PC.Out6: J1003.A15, J1004.A15; also elsewhere on the board
/PC.Out7: J1003.B15, J1004.B15; also elsewhere on the board
/PC.Out8: J1003.A16, J1004.A16; also elsewhere on the board
/PC.Out9: J1003.B16, J1004.B16; also elsewhere on the board
/PC.Out10: J1003.A17, J1004.A17; also elsewhere on the board
/PC.Out11: J1003.B17, J1004.B17; also elsewhere on the board
/PC.Out12: J1003.A18, J1004.A18; also elsewhere on the board
/PC.Out13: J1003.B18, J1004.B18; also elsewhere on the board
/PC.Out14: J1003.A19, J1004.A19; also elsewhere on the board
/PC.Out15: J1003.B19, J1004.B19; also elsewhere on the board
/R_{A}0: J1002.21
/R_{A}1: J1002.22
/R_{A}2: J1002.23
/R_{A}3: J1002.24
/R_{B}0: J1002.25
/R_{B}1: J1002.26
/R_{B}2: J1002.27
/R_{B}3: J1002.28
/R_{C}0: J1002.29
/R_{C}1: J1002.30
/R_{C}2: J1002.31
/R_{C}3: J1002.32
/~RESET: J1001.39, J1003.B10
GND: J1002.39, J1002.40, J1003.A22, J1003.B20, J1004.A10, J1004.A11, J1004.A22, J1004.B11, J1004.B20; also elsewhere on the board

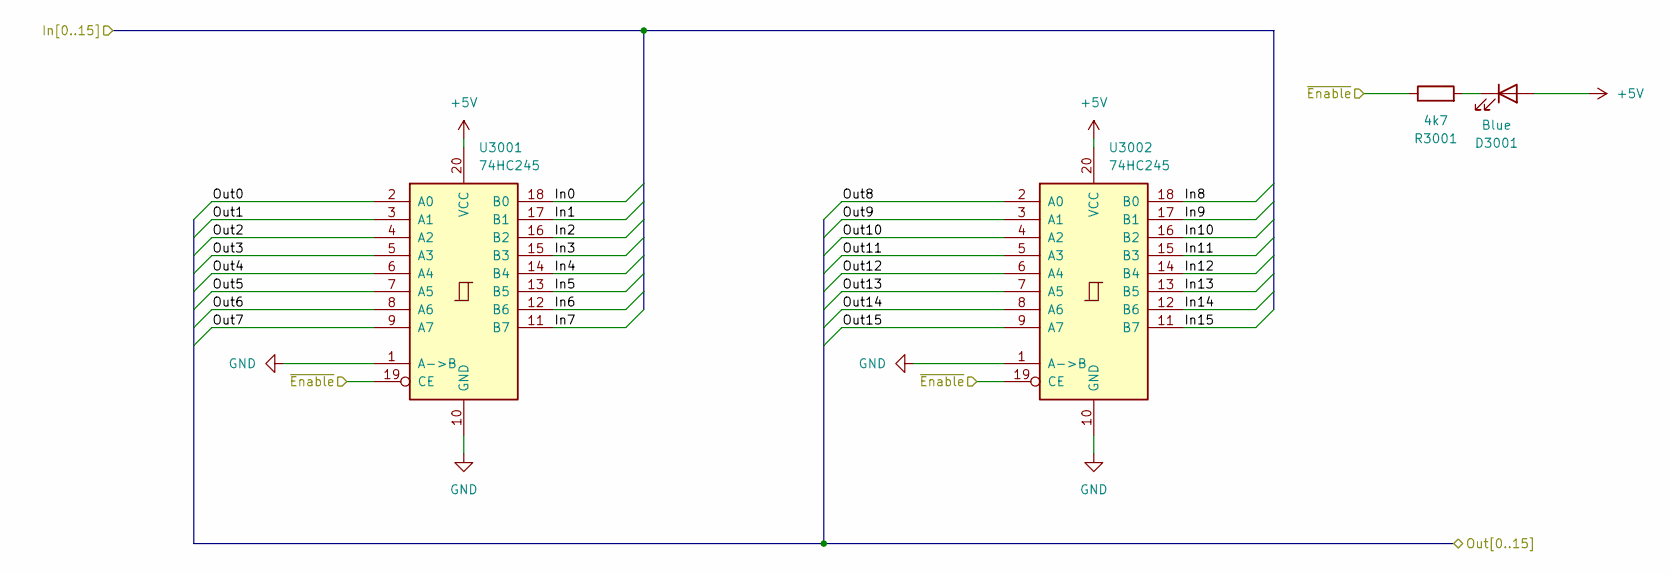
[picture p8: schematic BufferRL.kicad_sch]

Parts:
D3001: Blue; LED_0603_1608Metric; LCSC C72041
R3001: 4k7; R_0603_1608Metric; LCSC C23162
U3001, U3002: 74HC245; SOIC-20W_7.5x12.8mm_P1.27mm; LCSC C5625

Connections:
+5V: D3001.2 (A), U3001.20 (VCC), U3002.20 (VCC); also elsewhere on the board
/Inc.Out0: U3001.18 (B0); also elsewhere on the board
/Inc.Out1: U3001.17 (B1); also elsewhere on the board
/Inc.Out2: U3001.16 (B2); also elsewhere on the board
/Inc.Out3: U3001.15 (B3); also elsewhere on the board
/Inc.Out4: U3001.14 (B4); also elsewhere on the board
/Inc.Out5: U3001.13 (B5); also elsewhere on the board
/Inc.Out6: U3001.12 (B6); also elsewhere on the board
/Inc.Out7: U3001.11 (B7); also elsewhere on the board
/Inc.Out8: U3002.18 (B0); also elsewhere on the board
/Inc.Out9: U3002.17 (B1); also elsewhere on the board
/Inc.Out10: U3002.16 (B2); also elsewhere on the board
/Inc.Out11: U3002.15 (B3); also elsewhere on the board
/Inc.Out12: U3002.14 (B4); also elsewhere on the board
/Inc.Out13: U3002.13 (B5); also elsewhere on the board
/Inc.Out14: U3002.12 (B6); also elsewhere on the board
/Inc.Out15: U3002.11 (B7); also elsewhere on the board
/PC.In0: U3001.2 (A0); also elsewhere on the board
/PC.In1: U3001.3 (A1); also elsewhere on the board
/PC.In2: U3001.4 (A2); also elsewhere on the board
/PC.In3: U3001.5 (A3); also elsewhere on the board
/PC.In4: U3001.6 (A4); also elsewhere on the board
/PC.In5: U3001.7 (A5); also elsewhere on the board
/PC.In6: U3001.8 (A6); also elsewhere on the board
/PC.In7: U3001.9 (A7); also elsewhere on the board
/PC.In8: U3002.2 (A0); also elsewhere on the board
/PC.In9: U3002.3 (A1); also elsewhere on the board
/PC.In10: U3002.4 (A2); also elsewhere on the board
/PC.In11: U3002.5 (A3); also elsewhere on the board
/PC.In12: U3002.6 (A4); also elsewhere on the board
/PC.In13: U3002.7 (A5); also elsewhere on the board
/PC.In14: U3002.8 (A6); also elsewhere on the board
/PC.In15: U3002.9 (A7); also elsewhere on the board
/~NormalUpdate: R3001.1, U3001.19 (CE), U3002.19 (CE); also elsewhere on the board
GND: U3001.1 (A->B), U3001.10 (GND), U3002.1 (A->B), U3002.10 (GND); also elsewhere on the board
unnamed: D3001.1 (K), R3001.2

Parts of its further copies:
D2001, D4001: Blue; LED_0603_1608Metric; LCSC C72041
R2001, R4001: 4k7; R_0603_1608Metric; LCSC C23162
U2001, U2002, U4001, U4002: 74HC245; SOIC-20W_7.5x12.8mm_P1.27mm; LCSC C5625

Connections of its further copies:
+5V: D2001.2 (A), D4001.2 (A), U2001.20 (VCC), U2002.20 (VCC), U4001.20 (VCC), U4002.20 (VCC); also elsewhere on the board
/A0: U2001.2 (A0); also elsewhere on the board
/A1: U2001.3 (A1); also elsewhere on the board
/A2: U2001.4 (A2); also elsewhere on the board
/A3: U2001.5 (A3); also elsewhere on the board
/A4: U2001.6 (A4); also elsewhere on the board
/A5: U2001.7 (A5); also elsewhere on the board
/A6: U2001.8 (A6); also elsewhere on the board
/A7: U2001.9 (A7); also elsewhere on the board
/A8: U2002.2 (A0); also elsewhere on the board
/A9: U2002.3 (A1); also elsewhere on the board
/A10: U2002.4 (A2); also elsewhere on the board
/A11: U2002.5 (A3); also elsewhere on the board
/A12: U2002.6 (A4); also elsewhere on the board
/A13: U2002.7 (A5); also elsewhere on the board
/A14: U2002.8 (A6); also elsewhere on the board
/A15: U2002.9 (A7); also elsewhere on the board
/C0: U4001.2 (A0); also elsewhere on the board
/C1: U4001.3 (A1); also elsewhere on the board
/C2: U4001.4 (A2); also elsewhere on the board
/C3: U4001.5 (A3); also elsewhere on the board
/C4: U4001.6 (A4); also elsewhere on the board
/C5: U4001.7 (A5); also elsewhere on the board
/C6: U4001.8 (A6); also elsewhere on the board
/C7: U4001.9 (A7); also elsewhere on the board
/C8: U4002.2 (A0); also elsewhere on the board
/C9: U4002.3 (A1); also elsewhere on the board
/C10: U4002.4 (A2); also elsewhere on the board
/C11: U4002.5 (A3); also elsewhere on the board
/C12: U4002.6 (A4); also elsewhere on the board
/C13: U4002.7 (A5); also elsewhere on the board
/C14: U4002.8 (A6); also elsewhere on the board
/C15: U4002.9 (A7); also elsewhere on the board
/PC.Out0: U2001.18 (B0), U4001.18 (B0); also elsewhere on the board
/PC.Out1: U2001.17 (B1), U4001.17 (B1); also elsewhere on the board
/PC.Out2: U2001.16 (B2), U4001.16 (B2); also elsewhere on the board
/PC.Out3: U2001.15 (B3), U4001.15 (B3); also elsewhere on the board
/PC.Out4: U2001.14 (B4), U4001.14 (B4); also elsewhere on the board
/PC.Out5: U2001.13 (B5), U4001.13 (B5); also elsewhere on the board
/PC.Out6: U2001.12 (B6), U4001.12 (B6); also elsewhere on the board
/PC.Out7: U2001.11 (B7), U4001.11 (B7); also elsewhere on the board
/PC.Out8: U2002.18 (B0), U4002.18 (B0); also elsewhere on the board
/PC.Out9: U2002.17 (B1), U4002.17 (B1); also elsewhere on the board
/PC.Out10: U2002.16 (B2), U4002.16 (B2); also elsewhere on the board
/PC.Out11: U2002.15 (B3), U4002.15 (B3); also elsewhere on the board
/PC.Out12: U2002.14 (B4), U4002.14 (B4); also elsewhere on the board
/PC.Out13: U2002.13 (B5), U4002.13 (B5); also elsewhere on the board
/PC.Out14: U2002.12 (B6), U4002.12 (B6); also elsewhere on the board
/PC.Out15: U2002.11 (B7), U4002.11 (B7); also elsewhere on the board
/~InstrCycle: R2001.1, U2001.19 (CE), U2002.19 (CE); also elsewhere on the board
/~LoadPC: R4001.1, U4001.19 (CE), U4002.19 (CE); also elsewhere on the board
GND: U2001.1 (A->B), U2001.10 (GND), U2002.1 (A->B), U2002.10 (GND), U4001.1 (A->B), U4001.10 (GND), U4002.1 (A->B), U4002.10 (GND); also elsewhere on the board
unnamed: D2001.1 (K), R2001.2
unnamed: D4001.1 (K), R4001.2

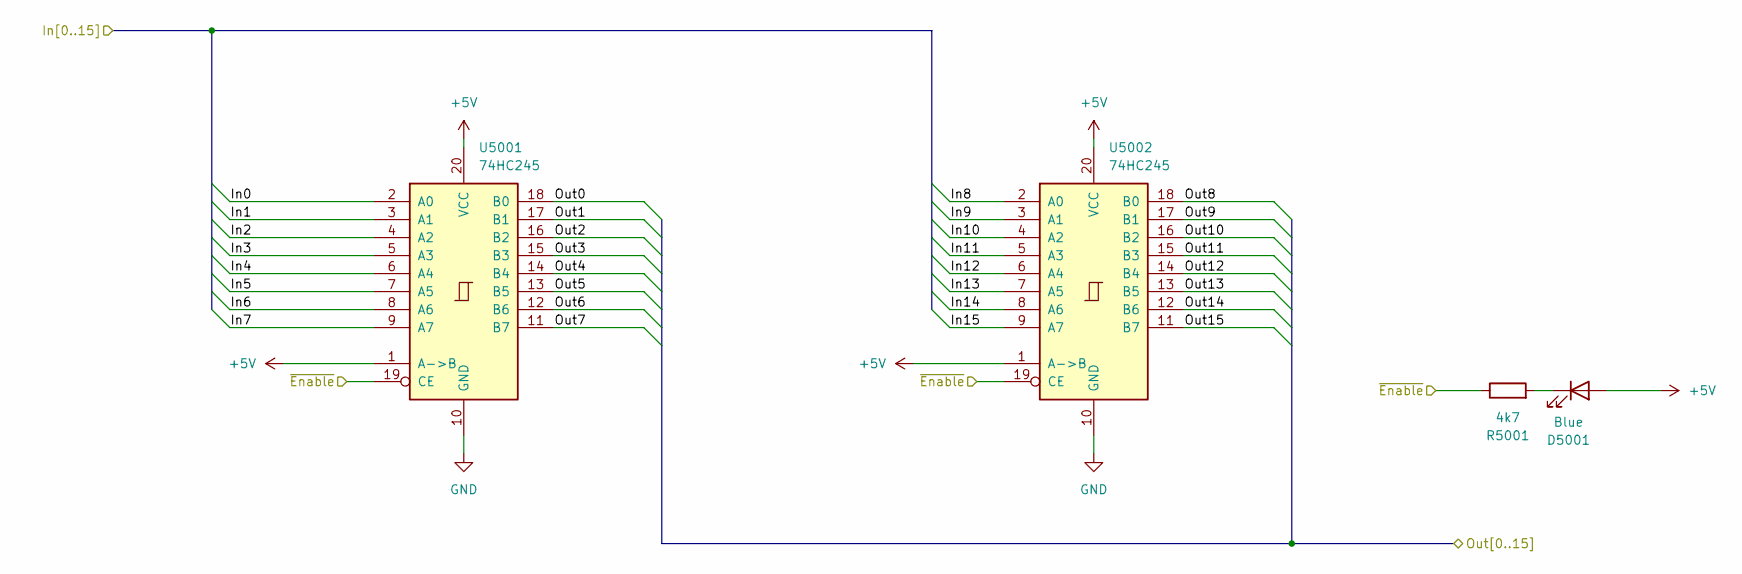
[picture p9: schematic BufferLR.kicad_sch]

Parts:
D5001: Blue; LED_0603_1608Metric; LCSC C72041
R5001: 4k7; R_0603_1608Metric; LCSC C23162
U5001, U5002: 74HC245; SOIC-20W_7.5x12.8mm_P1.27mm; LCSC C5625

Connections:
+5V: D5001.2 (A), U5001.1 (A->B), U5001.20 (VCC), U5002.1 (A->B), U5002.20 (VCC); also elsewhere on the board
/A0: U5001.2 (A0); also elsewhere on the board
/A1: U5001.3 (A1); also elsewhere on the board
/A2: U5001.4 (A2); also elsewhere on the board
/A3: U5001.5 (A3); also elsewhere on the board
/A4: U5001.6 (A4); also elsewhere on the board
/A5: U5001.7 (A5); also elsewhere on the board
/A6: U5001.8 (A6); also elsewhere on the board
/A7: U5001.9 (A7); also elsewhere on the board
/A8: U5002.2 (A0); also elsewhere on the board
/A9: U5002.3 (A1); also elsewhere on the board
/A10: U5002.4 (A2); also elsewhere on the board
/A11: U5002.5 (A3); also elsewhere on the board
/A12: U5002.6 (A4); also elsewhere on the board
/A13: U5002.7 (A5); also elsewhere on the board
/A14: U5002.8 (A6); also elsewhere on the board
/A15: U5002.9 (A7); also elsewhere on the board
/PC.In0: U5001.18 (B0); also elsewhere on the board
/PC.In1: U5001.17 (B1); also elsewhere on the board
/PC.In2: U5001.16 (B2); also elsewhere on the board
/PC.In3: U5001.15 (B3); also elsewhere on the board
/PC.In4: U5001.14 (B4); also elsewhere on the board
/PC.In5: U5001.13 (B5); also elsewhere on the board
/PC.In6: U5001.12 (B6); also elsewhere on the board
/PC.In7: U5001.11 (B7); also elsewhere on the board
/PC.In8: U5002.18 (B0); also elsewhere on the board
/PC.In9: U5002.17 (B1); also elsewhere on the board
/PC.In10: U5002.16 (B2); also elsewhere on the board
/PC.In11: U5002.15 (B3); also elsewhere on the board
/PC.In12: U5002.14 (B4); also elsewhere on the board
/PC.In13: U5002.13 (B5); also elsewhere on the board
/PC.In14: U5002.12 (B6); also elsewhere on the board
/PC.In15: U5002.11 (B7); also elsewhere on the board
/~DoBranch: R5001.1, U5001.19 (CE), U5002.19 (CE); also elsewhere on the board
GND: U5001.10 (GND), U5002.10 (GND); also elsewhere on the board
unnamed: D5001.1 (K), R5001.2

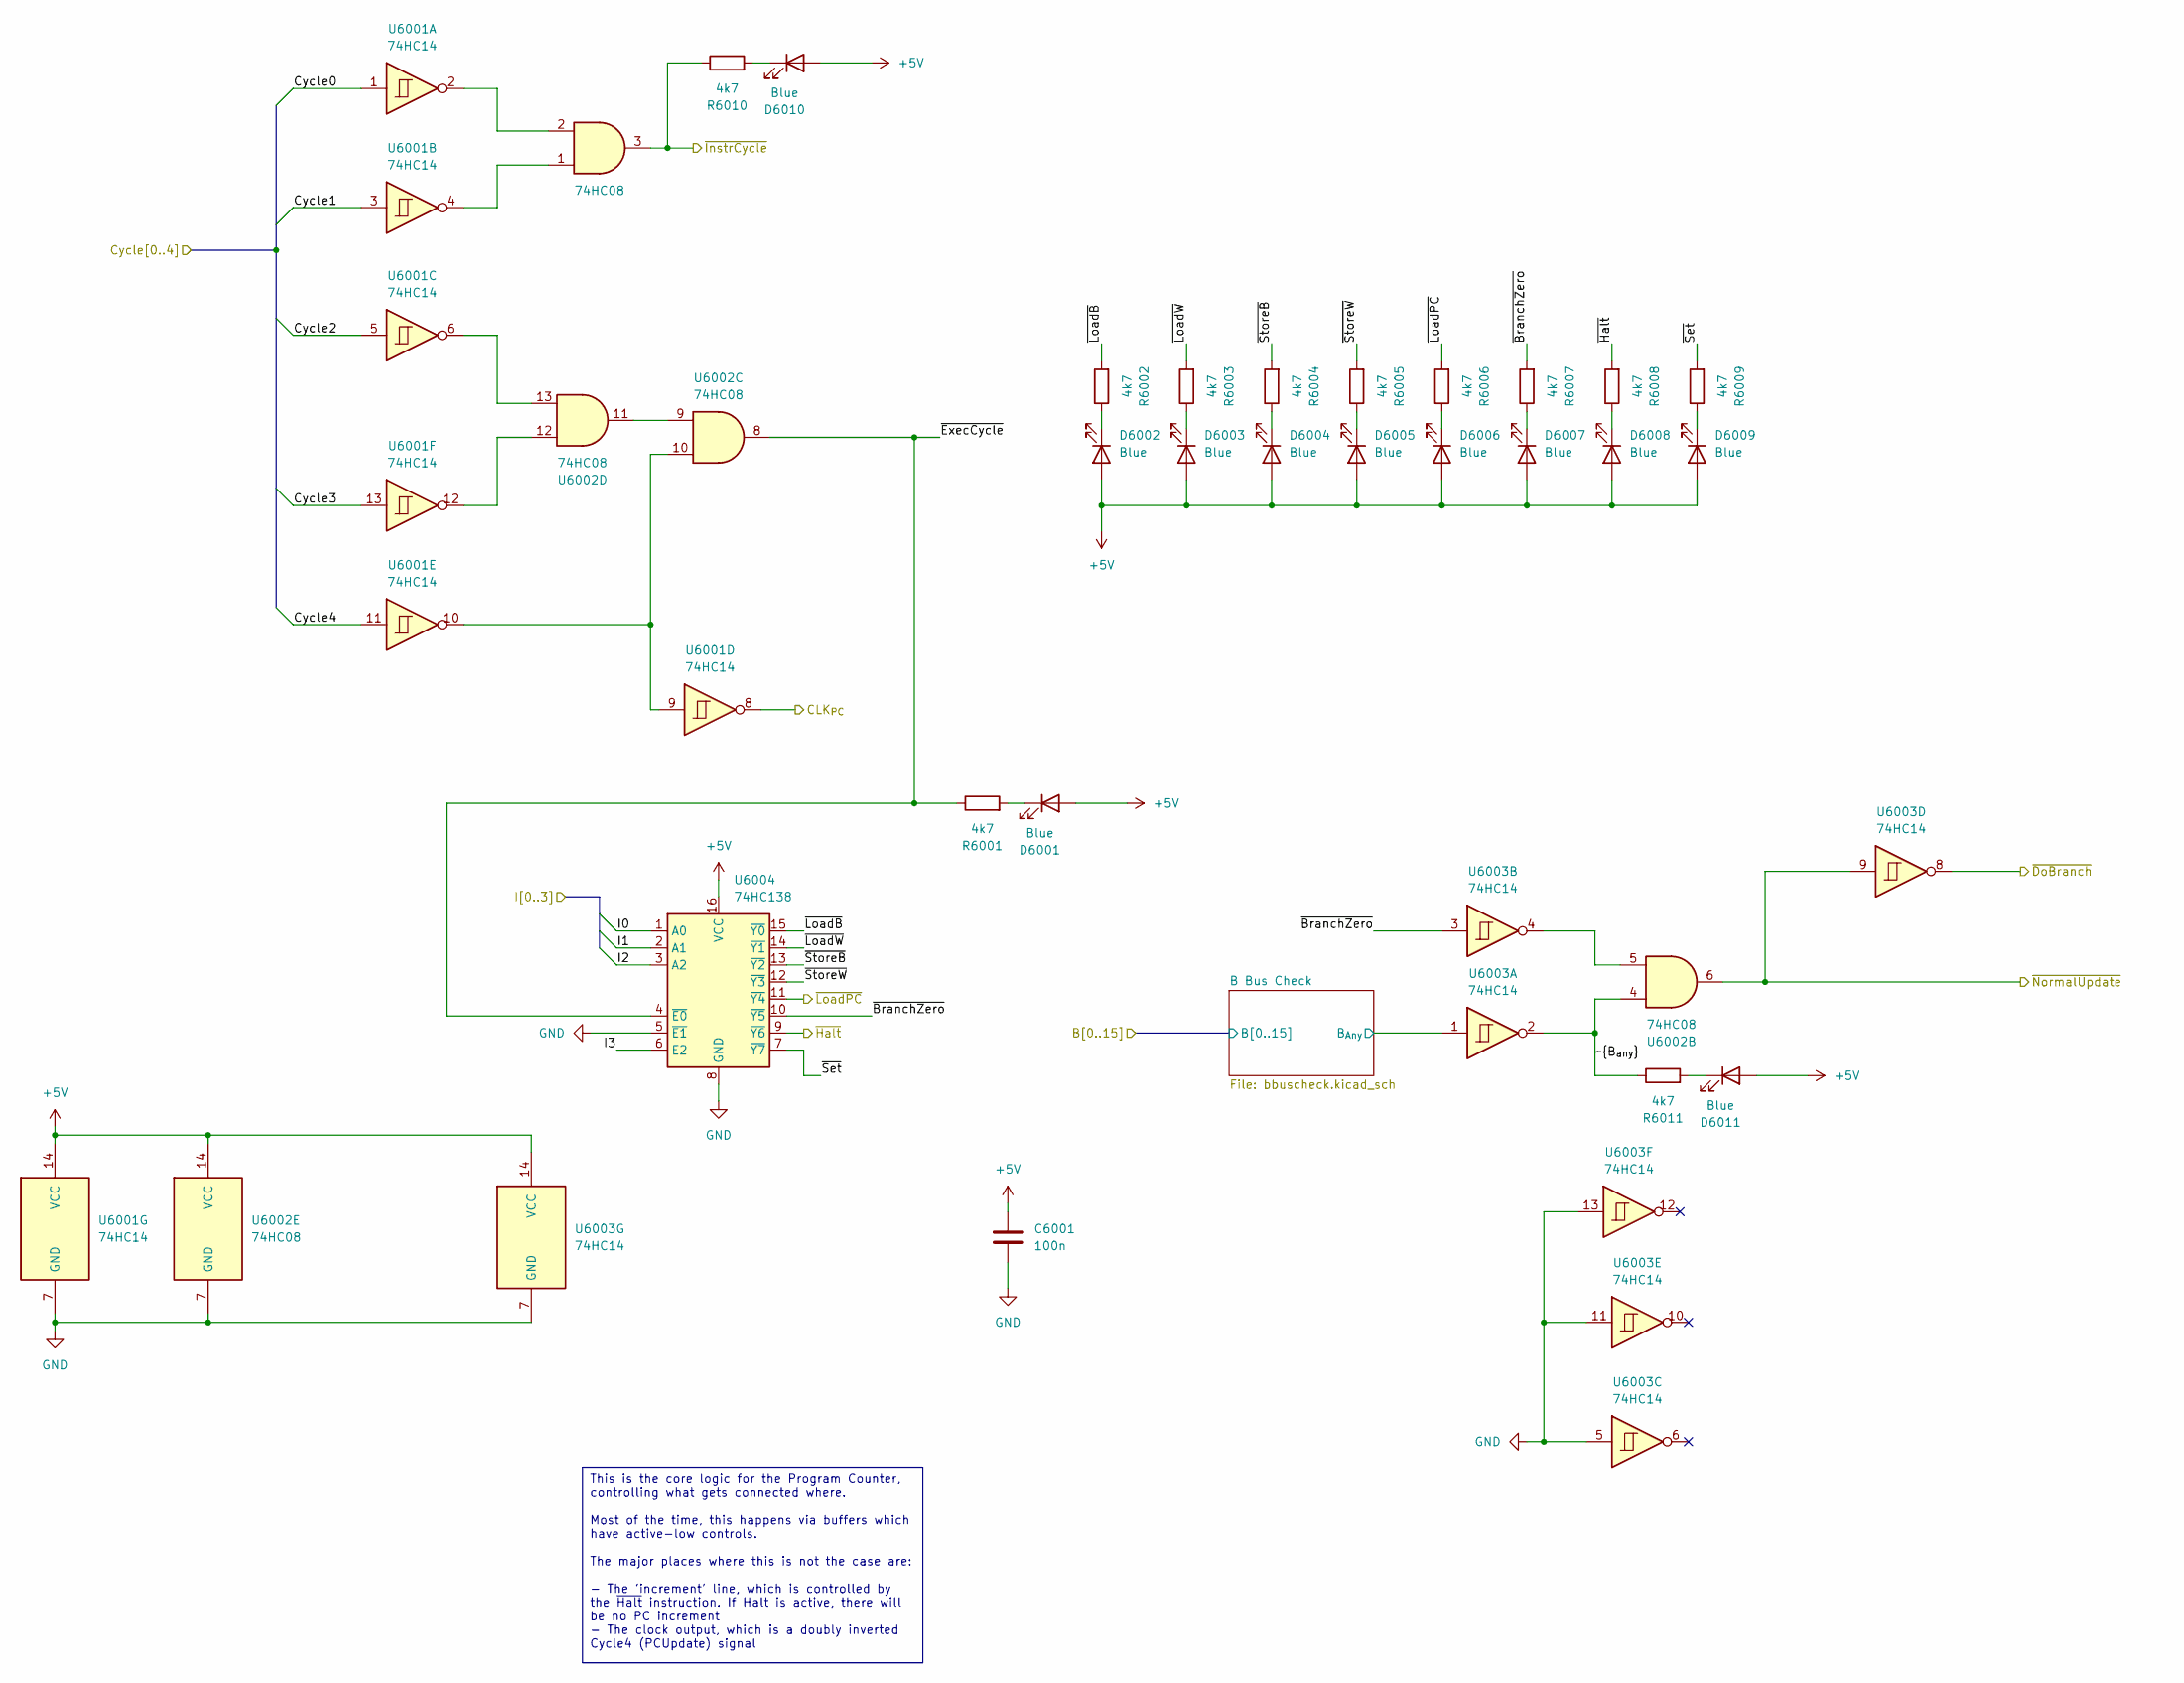
[picture p10: schematic enabler.kicad_sch]

Parts:
C6001: 100n; C_0603_1608Metric; LCSC C14663
D6001, D6002, D6003, D6004, D6005, D6006, D6007, D6008, D6009, D6010, D6011: Blue; LED_0603_1608Metric; LCSC C72041
R6001, R6002, R6003, R6004, R6005, R6006, R6007, R6008, R6009, R6010, R6011: 4k7; R_0603_1608Metric; LCSC C23162
U6001, U6003: 74HC14; SOIC-14_3.9x8.7mm_P1.27mm; LCSC C5605
U6002: 74HC08; SOIC-14_3.9x8.7mm_P1.27mm; LCSC C5593
U6004: 74HC138; DIP-16_W7.62mm_Socket

Connections:
+5V: C6001.1, D6001.2 (A), D6002.2 (A), D6003.2 (A), D6004.2 (A), D6005.2 (A), D6006.2 (A), D6007.2 (A), D6008.2 (A), D6009.2 (A), D6010.2 (A), D6011.2 (A), U6001.14 (VCC), U6002.14 (VCC), U6003.14 (VCC), U6004.16 (VCC); also elsewhere on the board
/ClockPC: U6001.8; also elsewhere on the board
/Cycle0: U6001.1; also elsewhere on the board
/Cycle1: U6001.3; also elsewhere on the board
/Cycle2: U6001.5; also elsewhere on the board
/Cycle3: U6001.13; also elsewhere on the board
/Cycle4: U6001.11; also elsewhere on the board
/Enabler/B Bus Check/B_{Any}: U6003.1; also elsewhere on the board
/Enabler/~B_{any}: R6011.1, U6002.4, U6003.2
/Enabler/~BranchZero: R6007.2, U6003.3, U6004.10 (~Y5)
/Enabler/~ExecCycle: R6001.1, U6002.8, U6004.4 (~E0)
/Enabler/~LoadB: R6002.2, U6004.15 (~Y0)
/Enabler/~LoadW: R6003.2, U6004.14 (~Y1)
/Enabler/~Set: R6009.2, U6004.7 (~Y7)
/Enabler/~StoreB: R6004.2, U6004.13 (~Y2)
/Enabler/~StoreW: R6005.2, U6004.12 (~Y3)
/I0: U6004.1 (A0); also elsewhere on the board
/I1: U6004.2 (A1); also elsewhere on the board
/I2: U6004.3 (A2); also elsewhere on the board
/I3: U6004.6 (E2); also elsewhere on the board
/Increment1: R6008.2, U6004.9 (~Y6); also elsewhere on the board
/~DoBranch: U6003.8; also elsewhere on the board
/~InstrCycle: R6010.1, U6002.3; also elsewhere on the board
/~LoadPC: R6006.2, U6004.11 (~Y4); also elsewhere on the board
/~NormalUpdate: U6002.6, U6003.9; also elsewhere on the board
GND: C6001.2, U6001.7 (GND), U6002.7 (GND), U6003.5, U6003.7 (GND), U6003.11, U6003.13, U6004.5 (~E1), U6004.8 (GND); also elsewhere on the board
unnamed: D6001.1 (K), R6001.2
unnamed: D6002.1 (K), R6002.1
unnamed: D6003.1 (K), R6003.1
unnamed: D6004.1 (K), R6004.1
unnamed: D6005.1 (K), R6005.1
unnamed: D6006.1 (K), R6006.1
unnamed: D6007.1 (K), R6007.1
unnamed: D6008.1 (K), R6008.1
unnamed: D6009.1 (K), R6009.1
unnamed: D6010.1 (K), R6010.2
unnamed: D6011.1 (K), R6011.2
unnamed: U6001.2, U6002.2
unnamed: U6001.4, U6002.1
unnamed: U6001.6, U6002.13
unnamed: U6001.9, U6001.10, U6002.10
unnamed: U6001.12, U6002.12
unnamed: U6002.5, U6003.4
unnamed: U6002.9, U6002.11

Notes on the sheet:
This is the core logic for the Program Counter, controlling what gets connected where. Most of the time, this happens via buffers which have active-low controls. The major places where this is not the case are: - The 'increment' line, which is controlled by the ~{Halt} instruction. If Halt is activ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

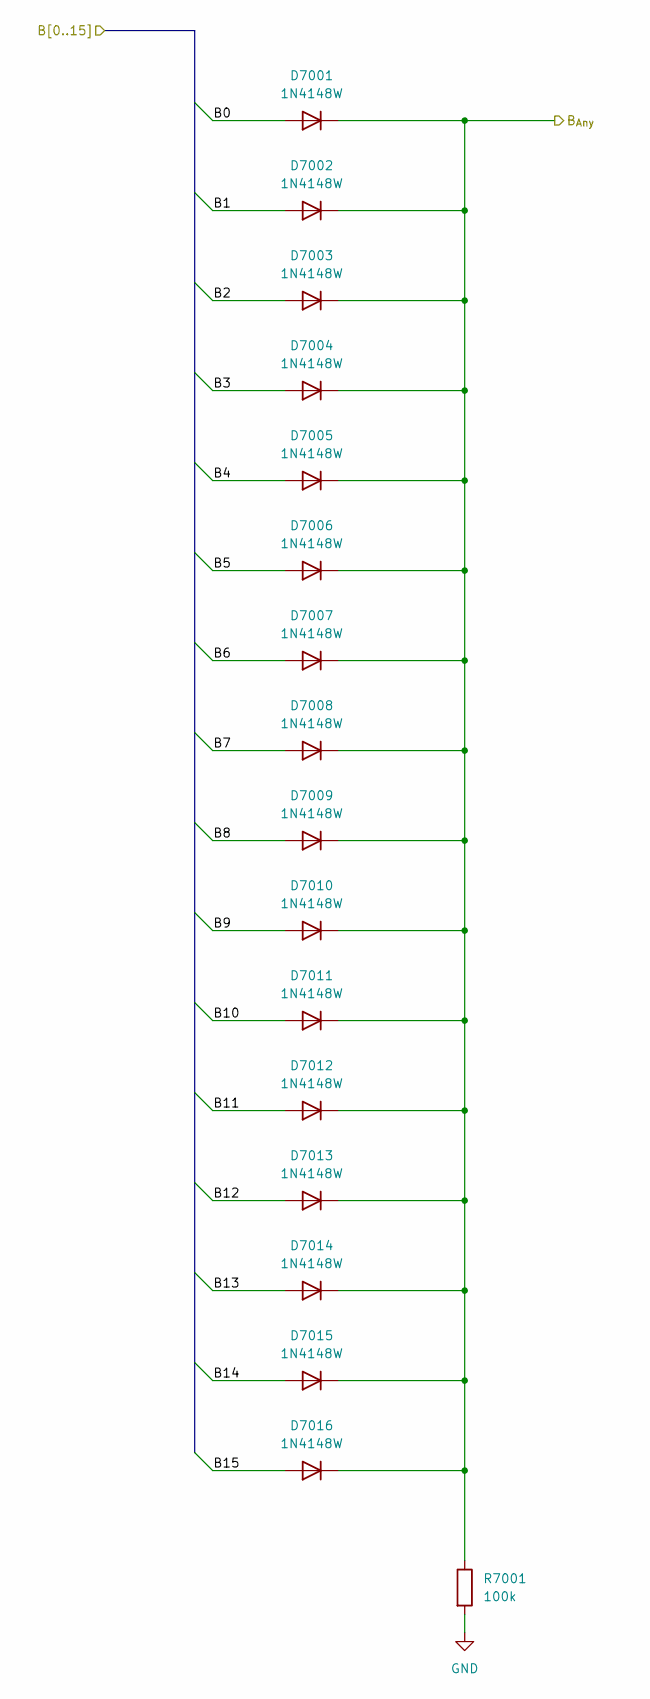
[picture p11: schematic bbuscheck.kicad_sch]

Parts:
D7001, D7002, D7003, D7004, D7005, D7006, D7007, D7008, D7009, D7010, D7011, D7012, D7013, D7014, D7015, D7016: 1N4148W; D_SOD-323; LCSC C2128
R7001: 100k; R_0603_1608Metric; LCSC C25803

Connections:
/B0: D7001.2 (A); also elsewhere on the board
/B1: D7002.2 (A); also elsewhere on the board
/B2: D7003.2 (A); also elsewhere on the board
/B3: D7004.2 (A); also elsewhere on the board
/B4: D7005.2 (A); also elsewhere on the board
/B5: D7006.2 (A); also elsewhere on the board
/B6: D7007.2 (A); also elsewhere on the board
/B7: D7008.2 (A); also elsewhere on the board
/B8: D7009.2 (A); also elsewhere on the board
/B9: D7010.2 (A); also elsewhere on the board
/B10: D7011.2 (A); also elsewhere on the board
/B11: D7012.2 (A); also elsewhere on the board
/B12: D7013.2 (A); also elsewhere on the board
/B13: D7014.2 (A); also elsewhere on the board
/B14: D7015.2 (A); also elsewhere on the board
/B15: D7016.2 (A); also elsewhere on the board
/Enabler/B Bus Check/B_{Any}: D7001.1 (K), D7002.1 (K), D7003.1 (K), D7004.1 (K), D7005.1 (K), D7006.1 (K), D7007.1 (K), D7008.1 (K), D7009.1 (K), D7010.1 (K), D7011.1 (K), D7012.1 (K), D7013.1 (K), D7014.1 (K), D7015.1 (K), D7016.1 (K), R7001.1; also elsewhere on the board
GND: R7001.2; also elsewhere on the board

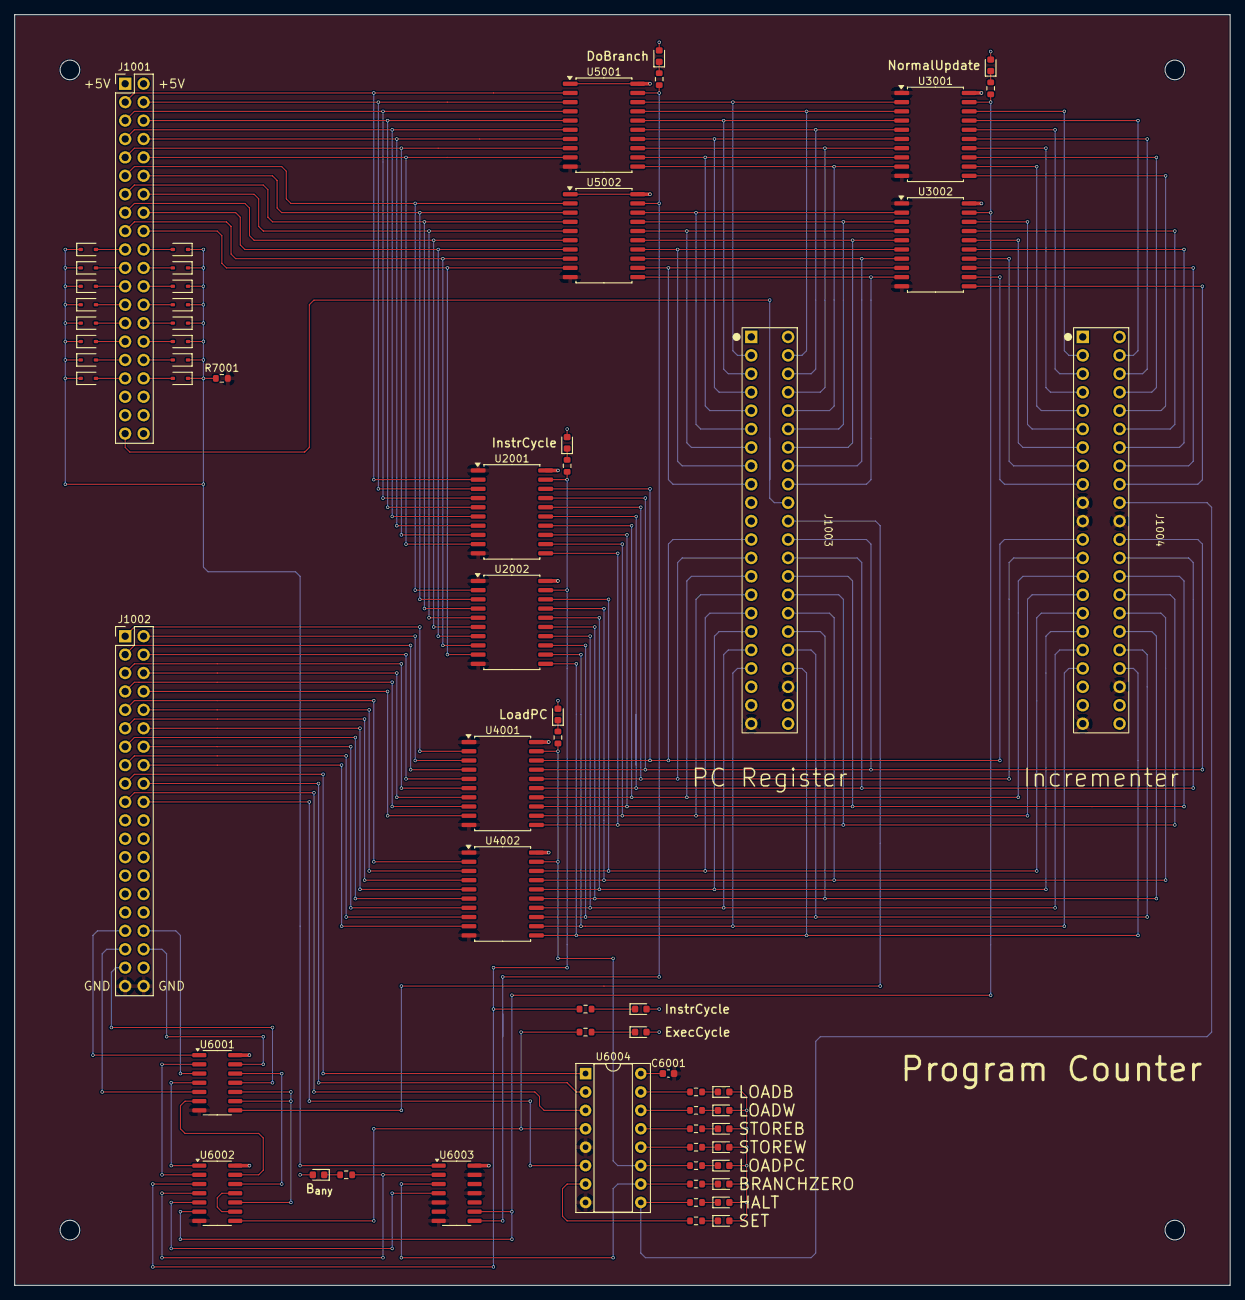
[picture p12: board Program Counter.kicad_pcb from above]

Board: 2 copper layers, 167.6 x 175.3 mm, 68 parts (0 on the bottom side), 145 nets.
