freesurfer-rge/slothpu16/pcbs/Register File Carrier/Register File Carrier.kicad_pcb

## KiCad design pcbs/Register File Carrier/Register File Carrier.kicad_pcb (2025-05-26)

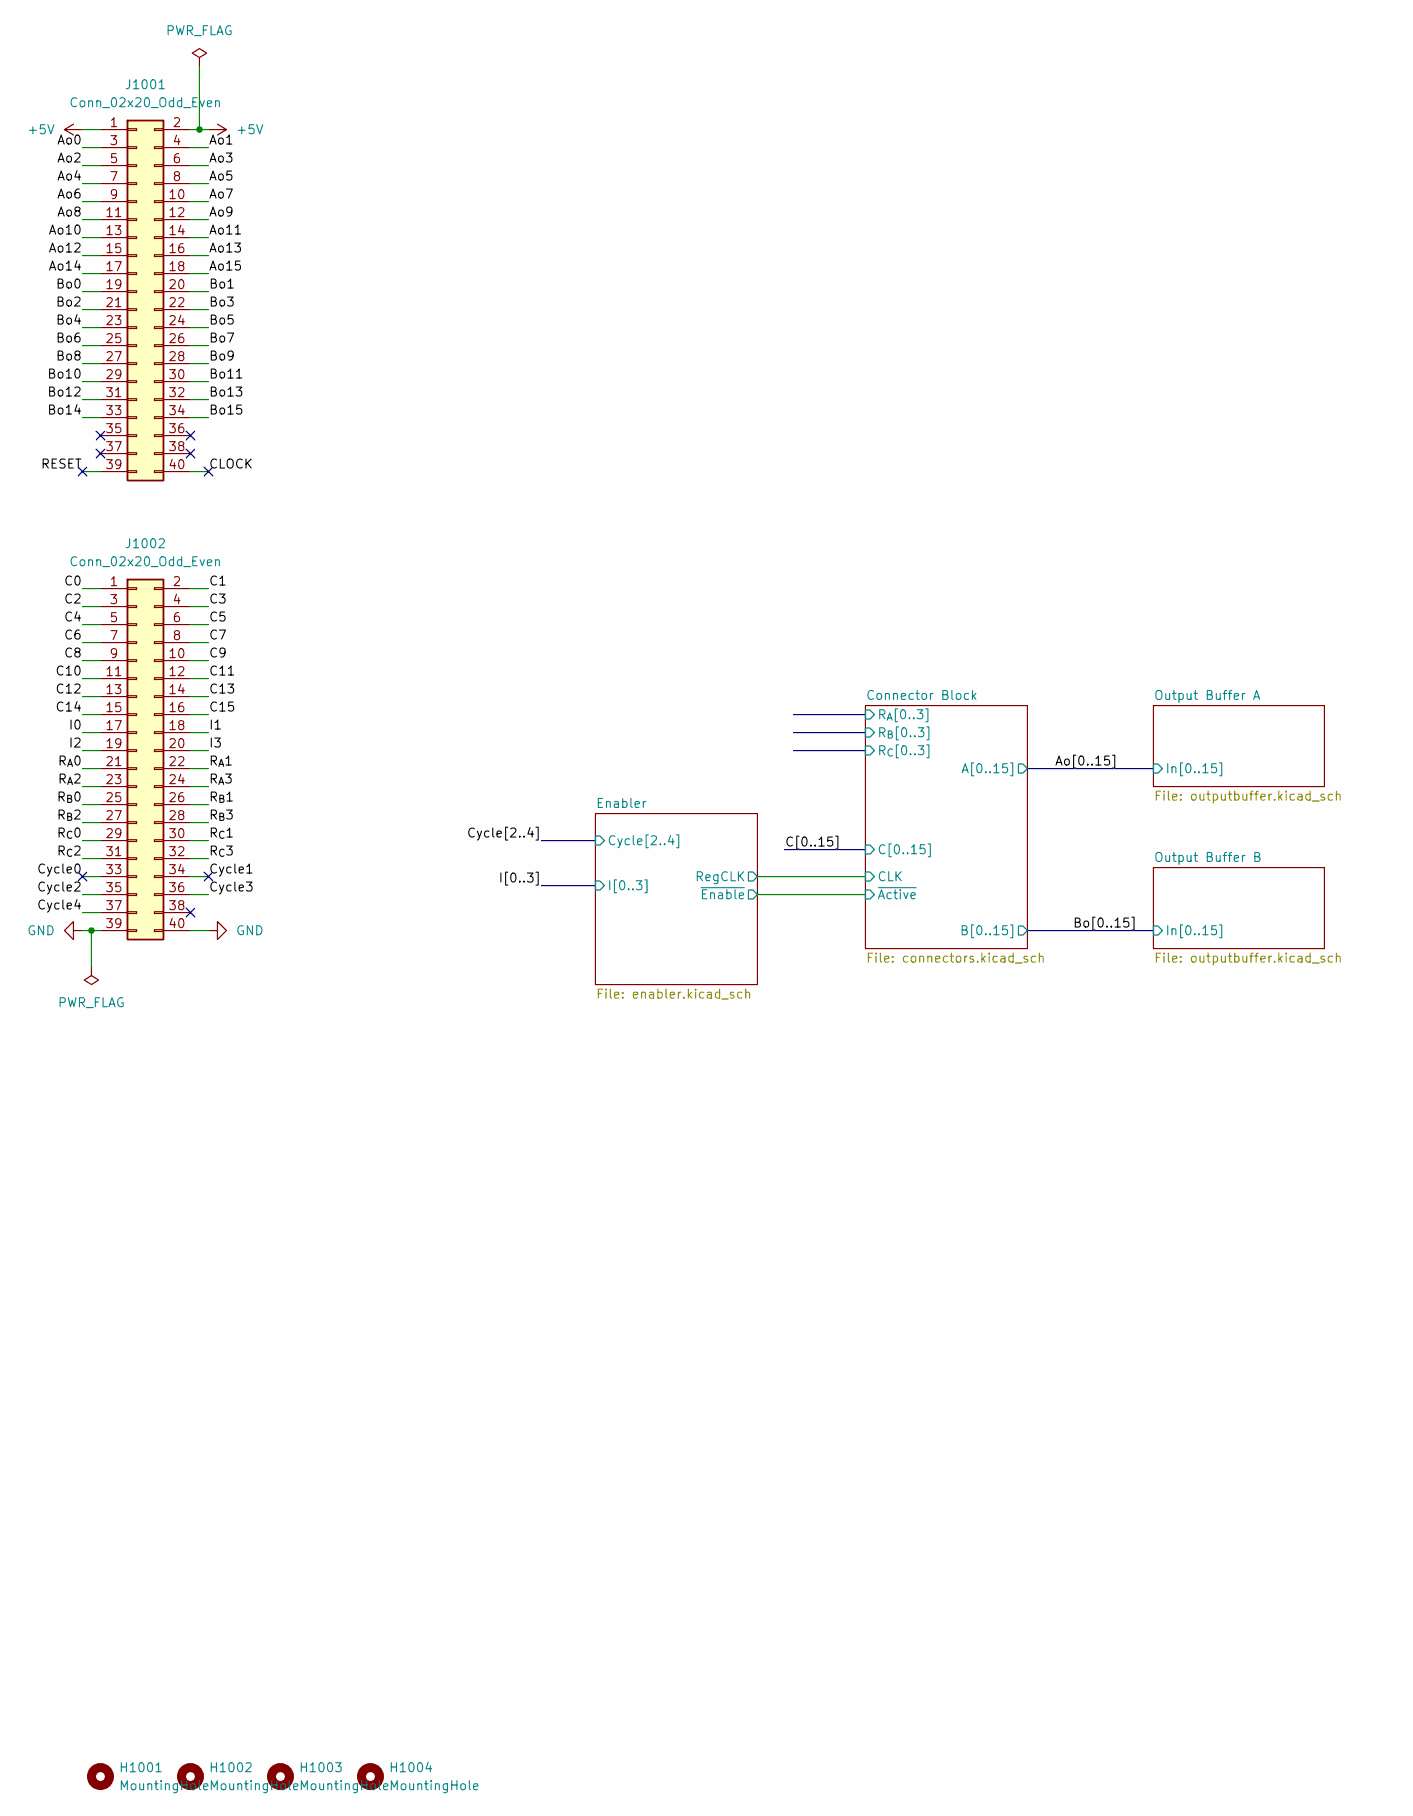
[picture p13: schematic Register File Carrier.kicad_sch]

Parts:
H1001, H1002, H1003, H1004: MountingHole; MountingHole_2.7mm_M2.5_ISO7380
J1001, J1002: Conn_02x20_Odd_Even; PinHeader_2x20_P2.54mm_Vertical

Connections:
+5V: J1001.1, J1001.2; also elsewhere on the board
/Ao0: J1001.3; also elsewhere on the board
/Ao1: J1001.4; also elsewhere on the board
/Ao2: J1001.5; also elsewhere on the board
/Ao3: J1001.6; also elsewhere on the board
/Ao4: J1001.7; also elsewhere on the board
/Ao5: J1001.8; also elsewhere on the board
/Ao6: J1001.9; also elsewhere on the board
/Ao7: J1001.10; also elsewhere on the board
/Ao8: J1001.11; also elsewhere on the board
/Ao9: J1001.12; also elsewhere on the board
/Ao10: J1001.13; also elsewhere on the board
/Ao11: J1001.14; also elsewhere on the board
/Ao12: J1001.15; also elsewhere on the board
/Ao13: J1001.16; also elsewhere on the board
/Ao14: J1001.17; also elsewhere on the board
/Ao15: J1001.18; also elsewhere on the board
/Bo0: J1001.19; also elsewhere on the board
/Bo1: J1001.20; also elsewhere on the board
/Bo2: J1001.21; also elsewhere on the board
/Bo3: J1001.22; also elsewhere on the board
/Bo4: J1001.23; also elsewhere on the board
/Bo5: J1001.24; also elsewhere on the board
/Bo6: J1001.25; also elsewhere on the board
/Bo7: J1001.26; also elsewhere on the board
/Bo8: J1001.27; also elsewhere on the board
/Bo9: J1001.28; also elsewhere on the board
/Bo10: J1001.29; also elsewhere on the board
/Bo11: J1001.30; also elsewhere on the board
/Bo12: J1001.31; also elsewhere on the board
/Bo13: J1001.32; also elsewhere on the board
/Bo14: J1001.33; also elsewhere on the board
/Bo15: J1001.34; also elsewhere on the board
/C0: J1002.1; also elsewhere on the board
/C1: J1002.2; also elsewhere on the board
/C2: J1002.3; also elsewhere on the board
/C3: J1002.4; also elsewhere on the board
/C4: J1002.5; also elsewhere on the board
/C5: J1002.6; also elsewhere on the board
/C6: J1002.7; also elsewhere on the board
/C7: J1002.8; also elsewhere on the board
/C8: J1002.9; also elsewhere on the board
/C9: J1002.10; also elsewhere on the board
/C10: J1002.11; also elsewhere on the board
/C11: J1002.12; also elsewhere on the board
/C12: J1002.13; also elsewhere on the board
/C13: J1002.14; also elsewhere on the board
/C14: J1002.15; also elsewhere on the board
/C15: J1002.16; also elsewhere on the board
/CLOCK: J1001.40
/Connector Block/R_{A}0: J1002.21; also elsewhere on the board
/Connector Block/R_{A}1: J1002.22; also elsewhere on the board
/Connector Block/R_{A}2: J1002.23; also elsewhere on the board
/Connector Block/R_{A}3: J1002.24; also elsewhere on the board
/Connector Block/R_{B}0: J1002.25; also elsewhere on the board
/Connector Block/R_{B}1: J1002.26; also elsewhere on the board
/Connector Block/R_{B}2: J1002.27; also elsewhere on the board
/Connector Block/R_{B}3: J1002.28; also elsewhere on the board
/Connector Block/R_{C}0: J1002.29; also elsewhere on the board
/Connector Block/R_{C}1: J1002.30; also elsewhere on the board
/Connector Block/R_{C}2: J1002.31; also elsewhere on the board
/Connector Block/R_{C}3: J1002.32; also elsewhere on the board
/Cycle0: J1002.33
/Cycle1: J1002.34
/Cycle2: J1002.35; also elsewhere on the board
/Cycle3: J1002.36; also elsewhere on the board
/Cycle4: J1002.37; also elsewhere on the board
/I0: J1002.17; also elsewhere on the board
/I1: J1002.18; also elsewhere on the board
/I2: J1002.19; also elsewhere on the board
/I3: J1002.20; also elsewhere on the board
/RESET: J1001.39
GND: J1002.39, J1002.40; also elsewhere on the board

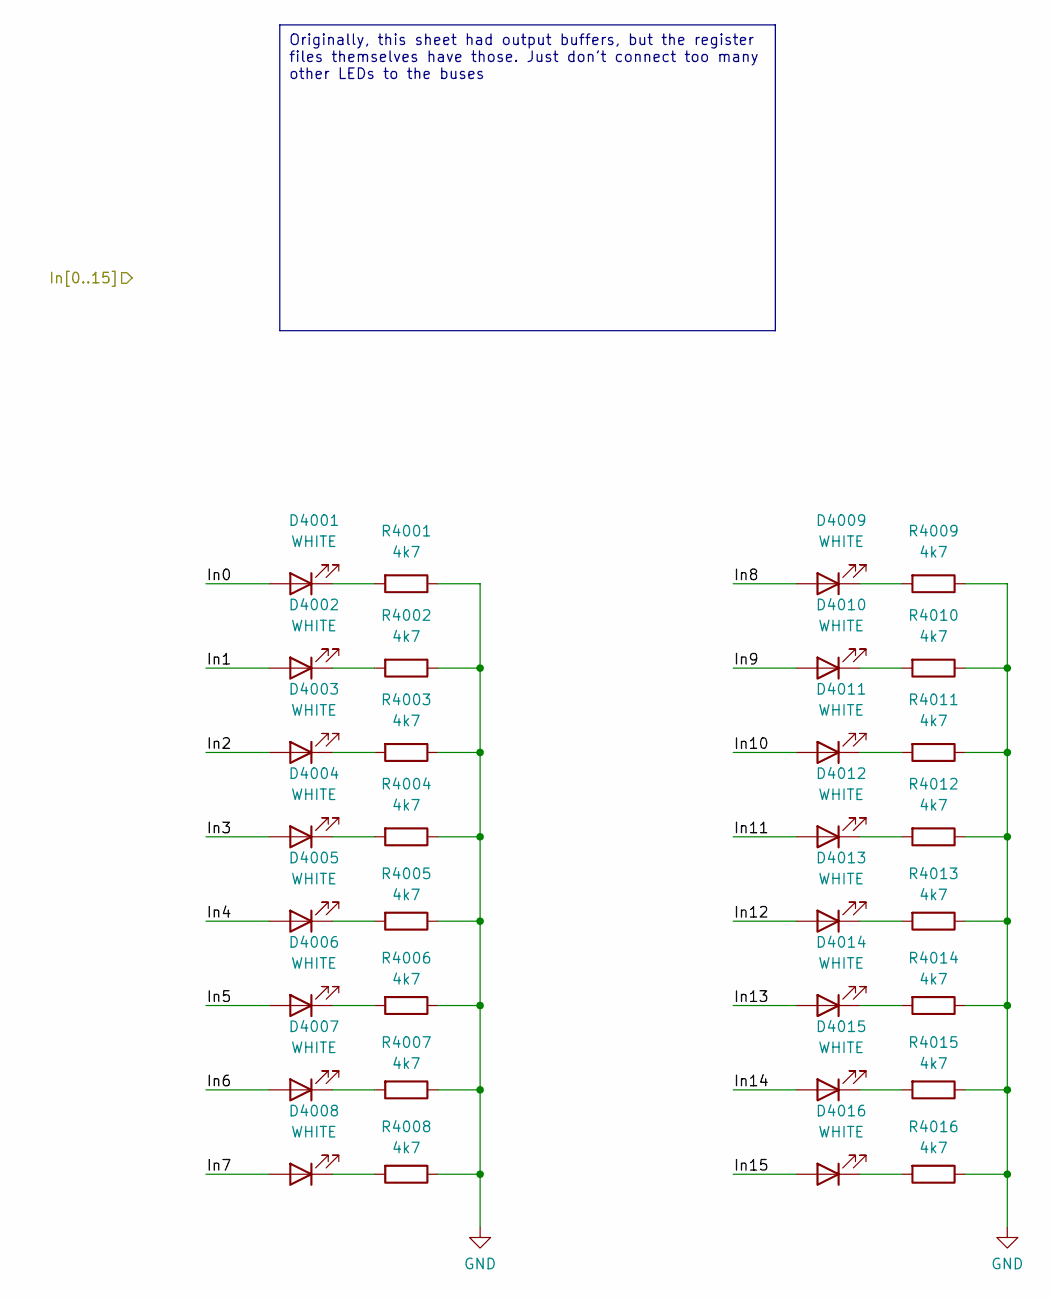
[picture p14: schematic outputbuffer.kicad_sch]

Parts:
D4001, D4002, D4003, D4004, D4005, D4006, D4007, D4008, D4009, D4010, D4011, D4012, D4013, D4014, D4015, D4016: WHITE; LED_0603_1608Metric; LCSC C2290
R4001, R4002, R4003, R4004, R4005, R4006, R4007, R4008, R4009, R4010, R4011, R4012, R4013, R4014, R4015, R4016: 4k7; R_0603_1608Metric; LCSC C23162

Connections:
/Ao0: D4001.2 (A); also elsewhere on the board
/Ao1: D4002.2 (A); also elsewhere on the board
/Ao2: D4003.2 (A); also elsewhere on the board
/Ao3: D4004.2 (A); also elsewhere on the board
/Ao4: D4005.2 (A); also elsewhere on the board
/Ao5: D4006.2 (A); also elsewhere on the board
/Ao6: D4007.2 (A); also elsewhere on the board
/Ao7: D4008.2 (A); also elsewhere on the board
/Ao8: D4009.2 (A); also elsewhere on the board
/Ao9: D4010.2 (A); also elsewhere on the board
/Ao10: D4011.2 (A); also elsewhere on the board
/Ao11: D4012.2 (A); also elsewhere on the board
/Ao12: D4013.2 (A); also elsewhere on the board
/Ao13: D4014.2 (A); also elsewhere on the board
/Ao14: D4015.2 (A); also elsewhere on the board
/Ao15: D4016.2 (A); also elsewhere on the board
GND: R4001.1, R4002.1, R4003.1, R4004.1, R4005.1, R4006.1, R4007.1, R4008.1, R4009.1, R4010.1, R4011.1, R4012.1, R4013.1, R4014.1, R4015.1, R4016.1; also elsewhere on the board
unnamed: D4001.1 (K), R4001.2
unnamed: D4002.1 (K), R4002.2
unnamed: D4003.1 (K), R4003.2
unnamed: D4004.1 (K), R4004.2
unnamed: D4005.1 (K), R4005.2
unnamed: D4006.1 (K), R4006.2
unnamed: D4007.1 (K), R4007.2
unnamed: D4008.1 (K), R4008.2
unnamed: D4009.1 (K), R4009.2
unnamed: D4010.1 (K), R4010.2
unnamed: D4011.1 (K), R4011.2
unnamed: D4012.1 (K), R4012.2
unnamed: D4013.1 (K), R4013.2
unnamed: D4014.1 (K), R4014.2
unnamed: D4015.1 (K), R4015.2
unnamed: D4016.1 (K), R4016.2

Parts of its further copies:
D5001, D5002, D5003, D5004, D5005, D5006, D5007, D5008, D5009, D5010, D5011, D5012, D5013, D5014, D5015, D5016: WHITE; LED_0603_1608Metric; LCSC C2290
R5001, R5002, R5003, R5004, R5005, R5006, R5007, R5008, R5009, R5010, R5011, R5012, R5013, R5014, R5015, R5016: 4k7; R_0603_1608Metric; LCSC C23162

Connections of its further copies:
/Bo0: D5001.2 (A); also elsewhere on the board
/Bo1: D5002.2 (A); also elsewhere on the board
/Bo2: D5003.2 (A); also elsewhere on the board
/Bo3: D5004.2 (A); also elsewhere on the board
/Bo4: D5005.2 (A); also elsewhere on the board
/Bo5: D5006.2 (A); also elsewhere on the board
/Bo6: D5007.2 (A); also elsewhere on the board
/Bo7: D5008.2 (A); also elsewhere on the board
/Bo8: D5009.2 (A); also elsewhere on the board
/Bo9: D5010.2 (A); also elsewhere on the board
/Bo10: D5011.2 (A); also elsewhere on the board
/Bo11: D5012.2 (A); also elsewhere on the board
/Bo12: D5013.2 (A); also elsewhere on the board
/Bo13: D5014.2 (A); also elsewhere on the board
/Bo14: D5015.2 (A); also elsewhere on the board
/Bo15: D5016.2 (A); also elsewhere on the board
GND: R5001.1, R5002.1, R5003.1, R5004.1, R5005.1, R5006.1, R5007.1, R5008.1, R5009.1, R5010.1, R5011.1, R5012.1, R5013.1, R5014.1, R5015.1, R5016.1; also elsewhere on the board
unnamed: D5001.1 (K), R5001.2
unnamed: D5002.1 (K), R5002.2
unnamed: D5003.1 (K), R5003.2
unnamed: D5004.1 (K), R5004.2
unnamed: D5005.1 (K), R5005.2
unnamed: D5006.1 (K), R5006.2
unnamed: D5007.1 (K), R5007.2
unnamed: D5008.1 (K), R5008.2
unnamed: D5009.1 (K), R5009.2
unnamed: D5010.1 (K), R5010.2
unnamed: D5011.1 (K), R5011.2
unnamed: D5012.1 (K), R5012.2
unnamed: D5013.1 (K), R5013.2
unnamed: D5014.1 (K), R5014.2
unnamed: D5015.1 (K), R5015.2
unnamed: D5016.1 (K), R5016.2

Notes on the sheet:
Originally, this sheet had output buffers, but the register files themselves have those. Just don't connect too many other LEDs to the buses

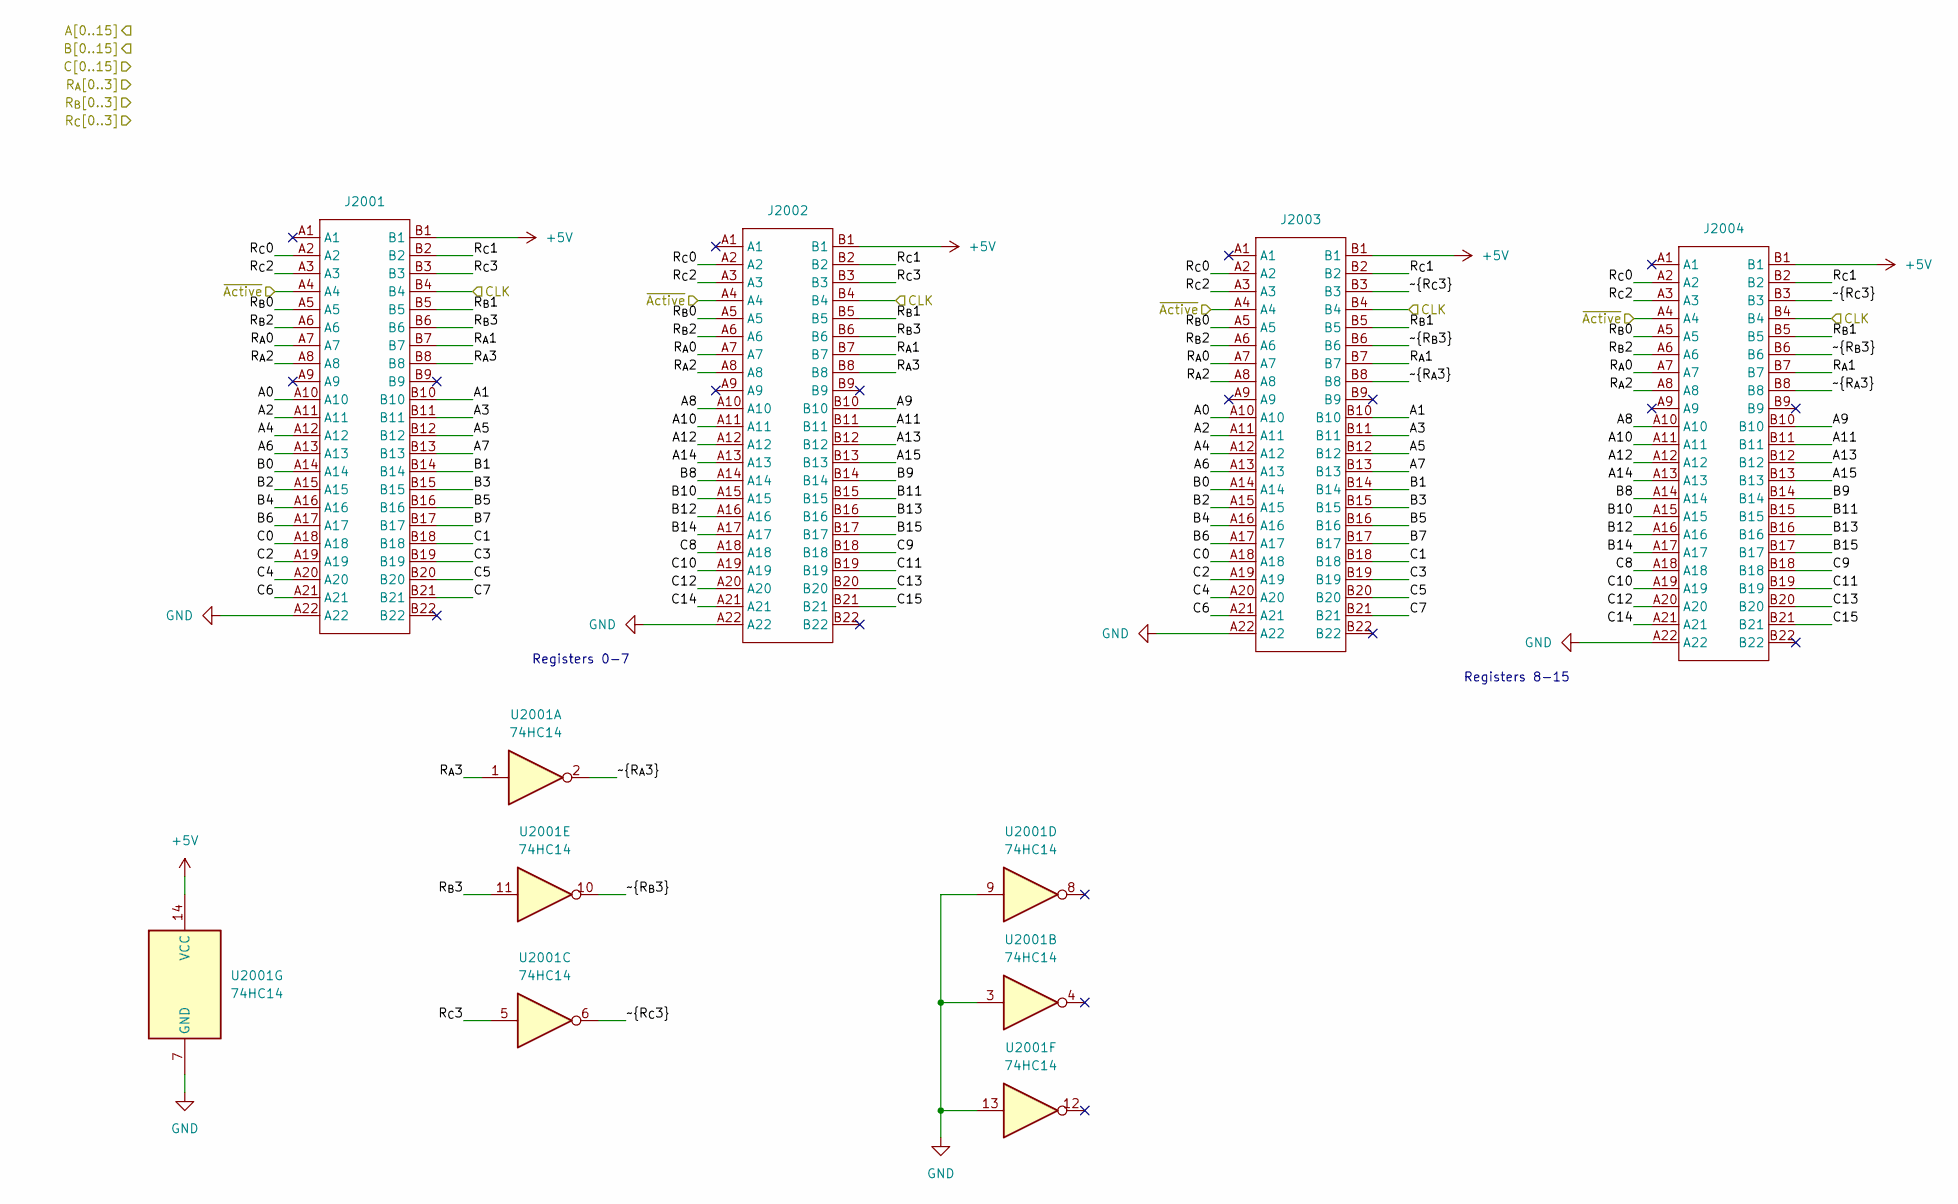
[picture p15: schematic connectors.kicad_sch]

Parts:
J2001, J2002, J2003, J2004: TE-5530843-4-Mount
U2001: 74HC14; SOIC-14_3.9x8.7mm_P1.27mm; LCSC C5605

Connections:
+5V: J2001.B1, J2002.B1, J2003.B1, J2004.B1, U2001.14 (VCC); also elsewhere on the board
/Ao0: J2001.A10, J2003.A10; also elsewhere on the board
/Ao1: J2001.B10, J2003.B10; also elsewhere on the board
/Ao2: J2001.A11, J2003.A11; also elsewhere on the board
/Ao3: J2001.B11, J2003.B11; also elsewhere on the board
/Ao4: J2001.A12, J2003.A12; also elsewhere on the board
/Ao5: J2001.B12, J2003.B12; also elsewhere on the board
/Ao6: J2001.A13, J2003.A13; also elsewhere on the board
/Ao7: J2001.B13, J2003.B13; also elsewhere on the board
/Ao8: J2002.A10, J2004.A10; also elsewhere on the board
/Ao9: J2002.B10, J2004.B10; also elsewhere on the board
/Ao10: J2002.A11, J2004.A11; also elsewhere on the board
/Ao11: J2002.B11, J2004.B11; also elsewhere on the board
/Ao12: J2002.A12, J2004.A12; also elsewhere on the board
/Ao13: J2002.B12, J2004.B12; also elsewhere on the board
/Ao14: J2002.A13, J2004.A13; also elsewhere on the board
/Ao15: J2002.B13, J2004.B13; also elsewhere on the board
/Bo0: J2001.A14, J2003.A14; also elsewhere on the board
/Bo1: J2001.B14, J2003.B14; also elsewhere on the board
/Bo2: J2001.A15, J2003.A15; also elsewhere on the board
/Bo3: J2001.B15, J2003.B15; also elsewhere on the board
/Bo4: J2001.A16, J2003.A16; also elsewhere on the board
/Bo5: J2001.B16, J2003.B16; also elsewhere on the board
/Bo6: J2001.A17, J2003.A17; also elsewhere on the board
/Bo7: J2001.B17, J2003.B17; also elsewhere on the board
/Bo8: J2002.A14, J2004.A14; also elsewhere on the board
/Bo9: J2002.B14, J2004.B14; also elsewhere on the board
/Bo10: J2002.A15, J2004.A15; also elsewhere on the board
/Bo11: J2002.B15, J2004.B15; also elsewhere on the board
/Bo12: J2002.A16, J2004.A16; also elsewhere on the board
/Bo13: J2002.B16, J2004.B16; also elsewhere on the board
/Bo14: J2002.A17, J2004.A17; also elsewhere on the board
/Bo15: J2002.B17, J2004.B17; also elsewhere on the board
/C0: J2001.A18, J2003.A18; also elsewhere on the board
/C1: J2001.B18, J2003.B18; also elsewhere on the board
/C2: J2001.A19, J2003.A19; also elsewhere on the board
/C3: J2001.B19, J2003.B19; also elsewhere on the board
/C4: J2001.A20, J2003.A20; also elsewhere on the board
/C5: J2001.B20, J2003.B20; also elsewhere on the board
/C6: J2001.A21, J2003.A21; also elsewhere on the board
/C7: J2001.B21, J2003.B21; also elsewhere on the board
/C8: J2002.A18, J2004.A18; also elsewhere on the board
/C9: J2002.B18, J2004.B18; also elsewhere on the board
/C10: J2002.A19, J2004.A19; also elsewhere on the board
/C11: J2002.B19, J2004.B19; also elsewhere on the board
/C12: J2002.A20, J2004.A20; also elsewhere on the board
/C13: J2002.B20, J2004.B20; also elsewhere on the board
/C14: J2002.A21, J2004.A21; also elsewhere on the board
/C15: J2002.B21, J2004.B21; also elsewhere on the board
/Connector Block/CLK: J2001.B4, J2002.B4, J2003.B4, J2004.B4; also elsewhere on the board
/Connector Block/R_{A}0: J2001.A7, J2002.A7, J2003.A7, J2004.A7; also elsewhere on the board
/Connector Block/R_{A}1: J2001.B7, J2002.B7, J2003.B7, J2004.B7; also elsewhere on the board
/Connector Block/R_{A}2: J2001.A8, J2002.A8, J2003.A8, J2004.A8; also elsewhere on the board
/Connector Block/R_{A}3: J2001.B8, J2002.B8, U2001.1; also elsewhere on the board
/Connector Block/R_{B}0: J2001.A5, J2002.A5, J2003.A5, J2004.A5; also elsewhere on the board
/Connector Block/R_{B}1: J2001.B5, J2002.B5, J2003.B5, J2004.B5; also elsewhere on the board
/Connector Block/R_{B}2: J2001.A6, J2002.A6, J2003.A6, J2004.A6; also elsewhere on the board
/Connector Block/R_{B}3: J2001.B6, J2002.B6, U2001.11; also elsewhere on the board
/Connector Block/R_{C}0: J2001.A2, J2002.A2, J2003.A2, J2004.A2; also elsewhere on the board
/Connector Block/R_{C}1: J2001.B2, J2002.B2, J2003.B2, J2004.B2; also elsewhere on the board
/Connector Block/R_{C}2: J2001.A3, J2002.A3, J2003.A3, J2004.A3; also elsewhere on the board
/Connector Block/R_{C}3: J2001.B3, J2002.B3, U2001.5; also elsewhere on the board
/Connector Block/~Active: J2001.A4, J2002.A4, J2003.A4, J2004.A4; also elsewhere on the board
/Connector Block/~R_{A3}: J2003.B8, J2004.B8, U2001.2
/Connector Block/~R_{B3}: J2003.B6, J2004.B6, U2001.10
/Connector Block/~R_{C3}: J2003.B3, J2004.B3, U2001.6
GND: J2001.A22, J2002.A22, J2003.A22, J2004.A22, U2001.3, U2001.7 (GND), U2001.9, U2001.13; also elsewhere on the board

Notes on the sheet:
Registers 8-15
Registers 0-7

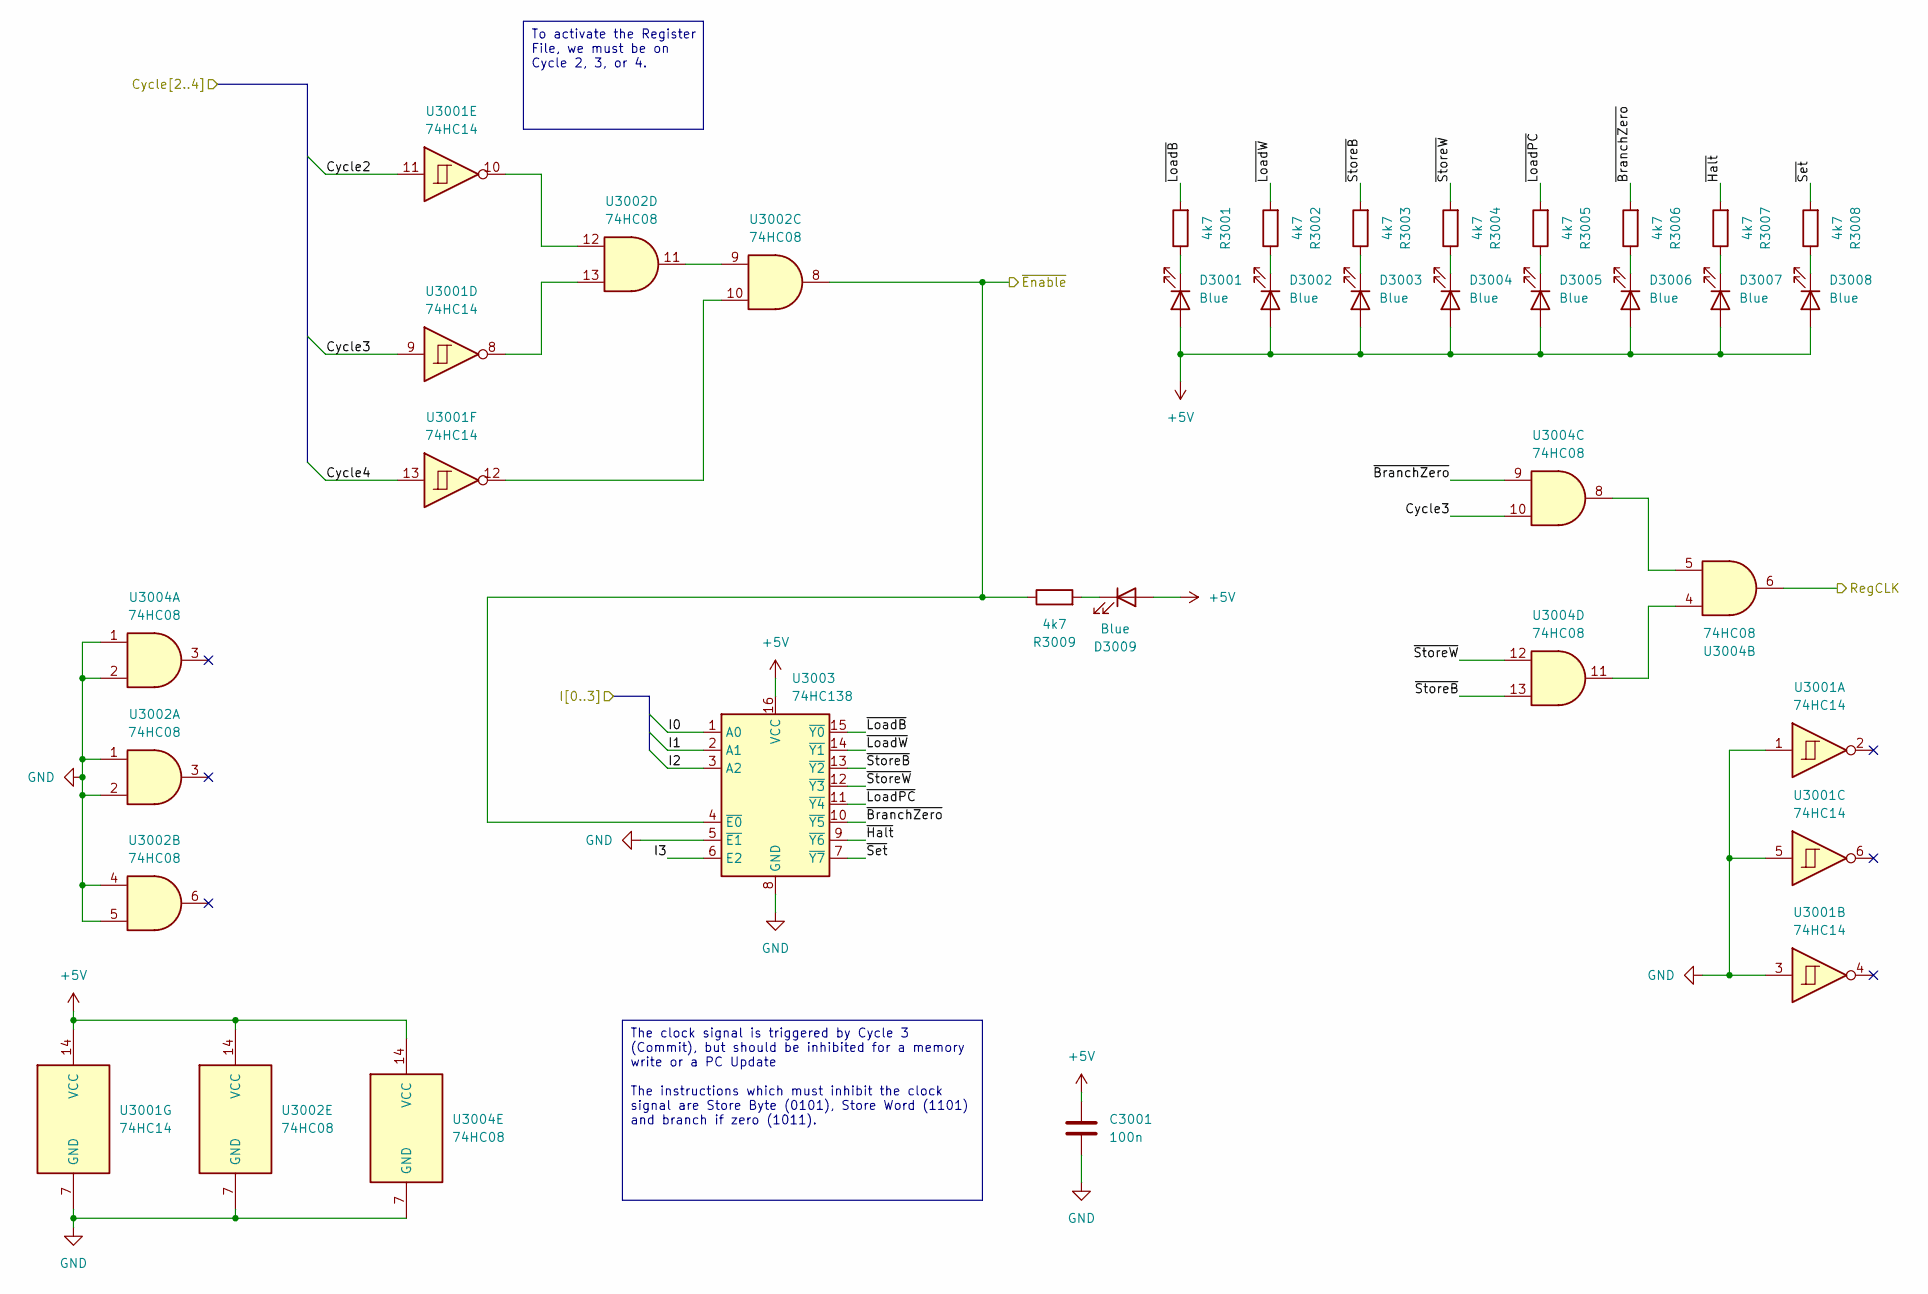
[picture p16: schematic enabler.kicad_sch]

Parts:
C3001: 100n; C_0603_1608Metric; LCSC C14663
D3001, D3002, D3003, D3004, D3005, D3006, D3007, D3008, D3009: Blue; LED_0603_1608Metric; LCSC C72041
R3001, R3002, R3003, R3004, R3005, R3006, R3007, R3008, R3009: 4k7; R_0603_1608Metric; LCSC C23162
U3001: 74HC14; SOIC-14_3.9x8.7mm_P1.27mm; LCSC C5605
U3002, U3004: 74HC08; SOIC-14_3.9x8.7mm_P1.27mm; LCSC C5593
U3003: 74HC138; DIP-16_W7.62mm_Socket

Connections:
+5V: C3001.1, D3001.2 (A), D3002.2 (A), D3003.2 (A), D3004.2 (A), D3005.2 (A), D3006.2 (A), D3007.2 (A), D3008.2 (A), D3009.2 (A), U3001.14 (VCC), U3002.14 (VCC), U3003.16 (VCC), U3004.14 (VCC); also elsewhere on the board
/Connector Block/CLK: U3004.6; also elsewhere on the board
/Connector Block/~Active: R3009.1, U3002.8, U3003.4 (~E0); also elsewhere on the board
/Cycle2: U3001.11; also elsewhere on the board
/Cycle3: U3001.9, U3004.10; also elsewhere on the board
/Cycle4: U3001.13; also elsewhere on the board
/Enabler/~BranchZero: R3006.2, U3003.10 (~Y5), U3004.9
/Enabler/~Halt: R3007.2, U3003.9 (~Y6)
/Enabler/~LoadB: R3001.2, U3003.15 (~Y0)
/Enabler/~LoadPC: R3005.2, U3003.11 (~Y4)
/Enabler/~LoadW: R3002.2, U3003.14 (~Y1)
/Enabler/~Set: R3008.2, U3003.7 (~Y7)
/Enabler/~StoreB: R3003.2, U3003.13 (~Y2), U3004.13
/Enabler/~StoreW: R3004.2, U3003.12 (~Y3), U3004.12
/I0: U3003.1 (A0); also elsewhere on the board
/I1: U3003.2 (A1); also elsewhere on the board
/I2: U3003.3 (A2); also elsewhere on the board
/I3: U3003.6 (E2); also elsewhere on the board
GND: C3001.2, U3001.1, U3001.3, U3001.5, U3001.7 (GND), U3002.1, U3002.2, U3002.4, U3002.5, U3002.7 (GND), U3003.5 (~E1), U3003.8 (GND), U3004.1, U3004.2, U3004.7 (GND); also elsewhere on the board
unnamed: D3001.1 (K), R3001.1
unnamed: D3002.1 (K), R3002.1
unnamed: D3003.1 (K), R3003.1
unnamed: D3004.1 (K), R3004.1
unnamed: D3005.1 (K), R3005.1
unnamed: D3006.1 (K), R3006.1
unnamed: D3007.1 (K), R3007.1
unnamed: D3008.1 (K), R3008.1
unnamed: D3009.1 (K), R3009.2
unnamed: U3001.8, U3002.13
unnamed: U3001.10, U3002.12
unnamed: U3001.12, U3002.10
unnamed: U3002.9, U3002.11
unnamed: U3004.5, U3004.8
unnamed: U3004.4, U3004.11

Notes on the sheet:
The clock signal is triggered by Cycle 3 (Commit), but should be inhibited for a memory write or a PC Update The instructions which must inhibit the clock signal are Store Byte (0101), Store Word (1101) and branch if zero (1011).
To activate the Register File, we must be on Cycle 2, 3, or 4.

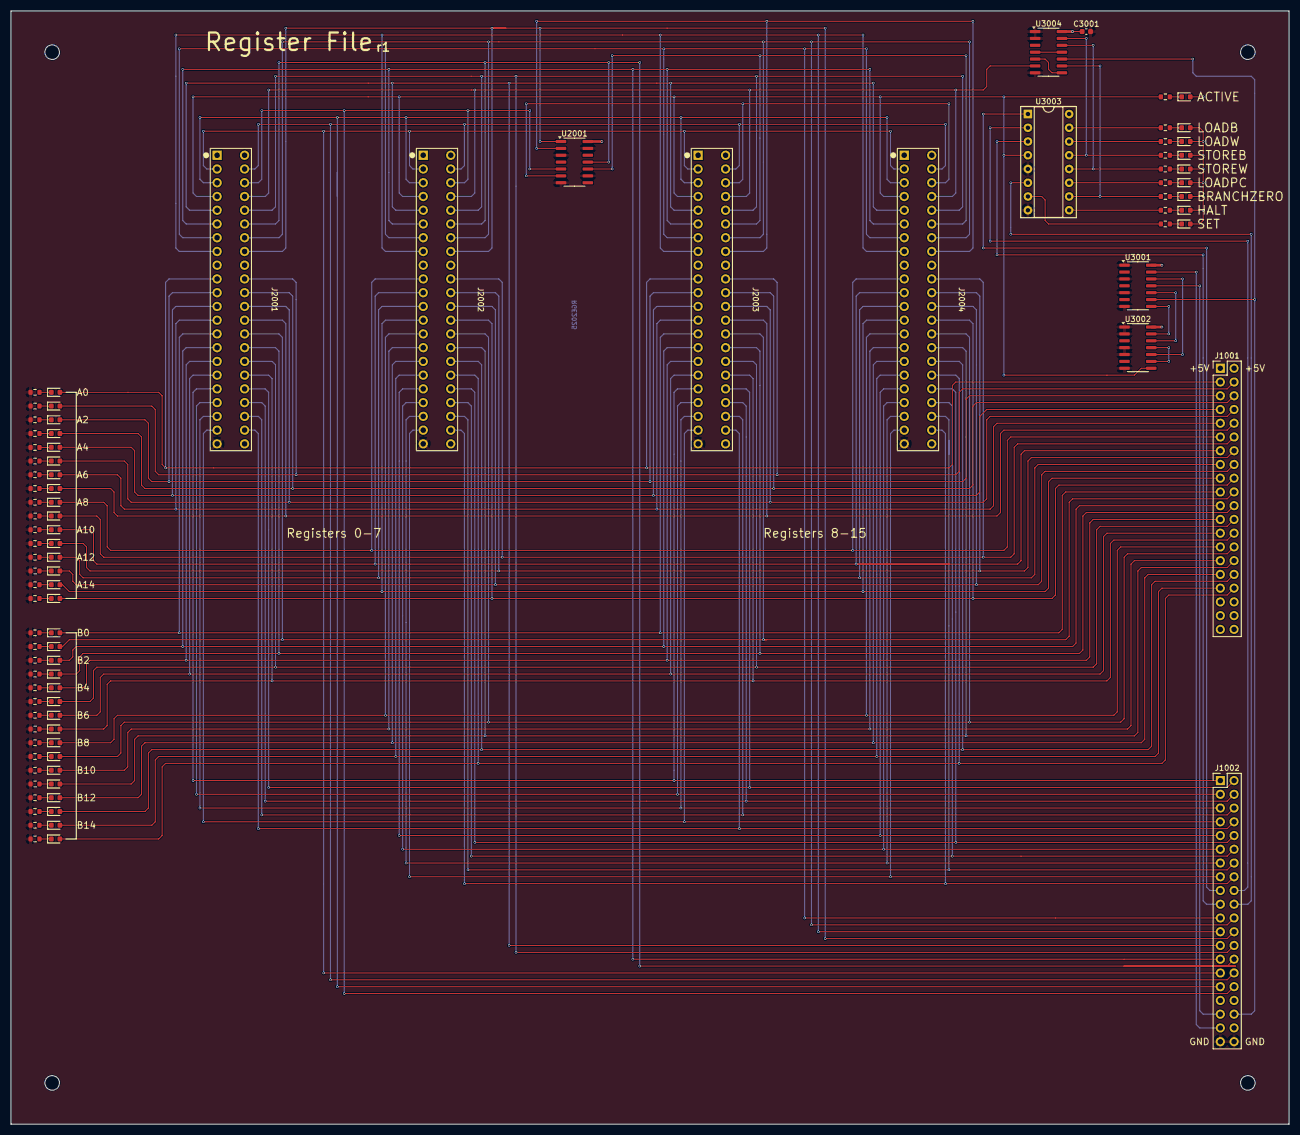
[picture p17: board Register File Carrier.kicad_pcb from above]

Board: 2 copper layers, 236.2 x 205.7 mm, 98 parts (0 on the bottom side), 129 nets.
