freesurfer-rge/slothpu16/pcbs/ALU Carrier/ALU Carrier.kicad_pcb

## KiCad design pcbs/ALU Carrier/ALU Carrier.kicad_pcb (2025-04-06)

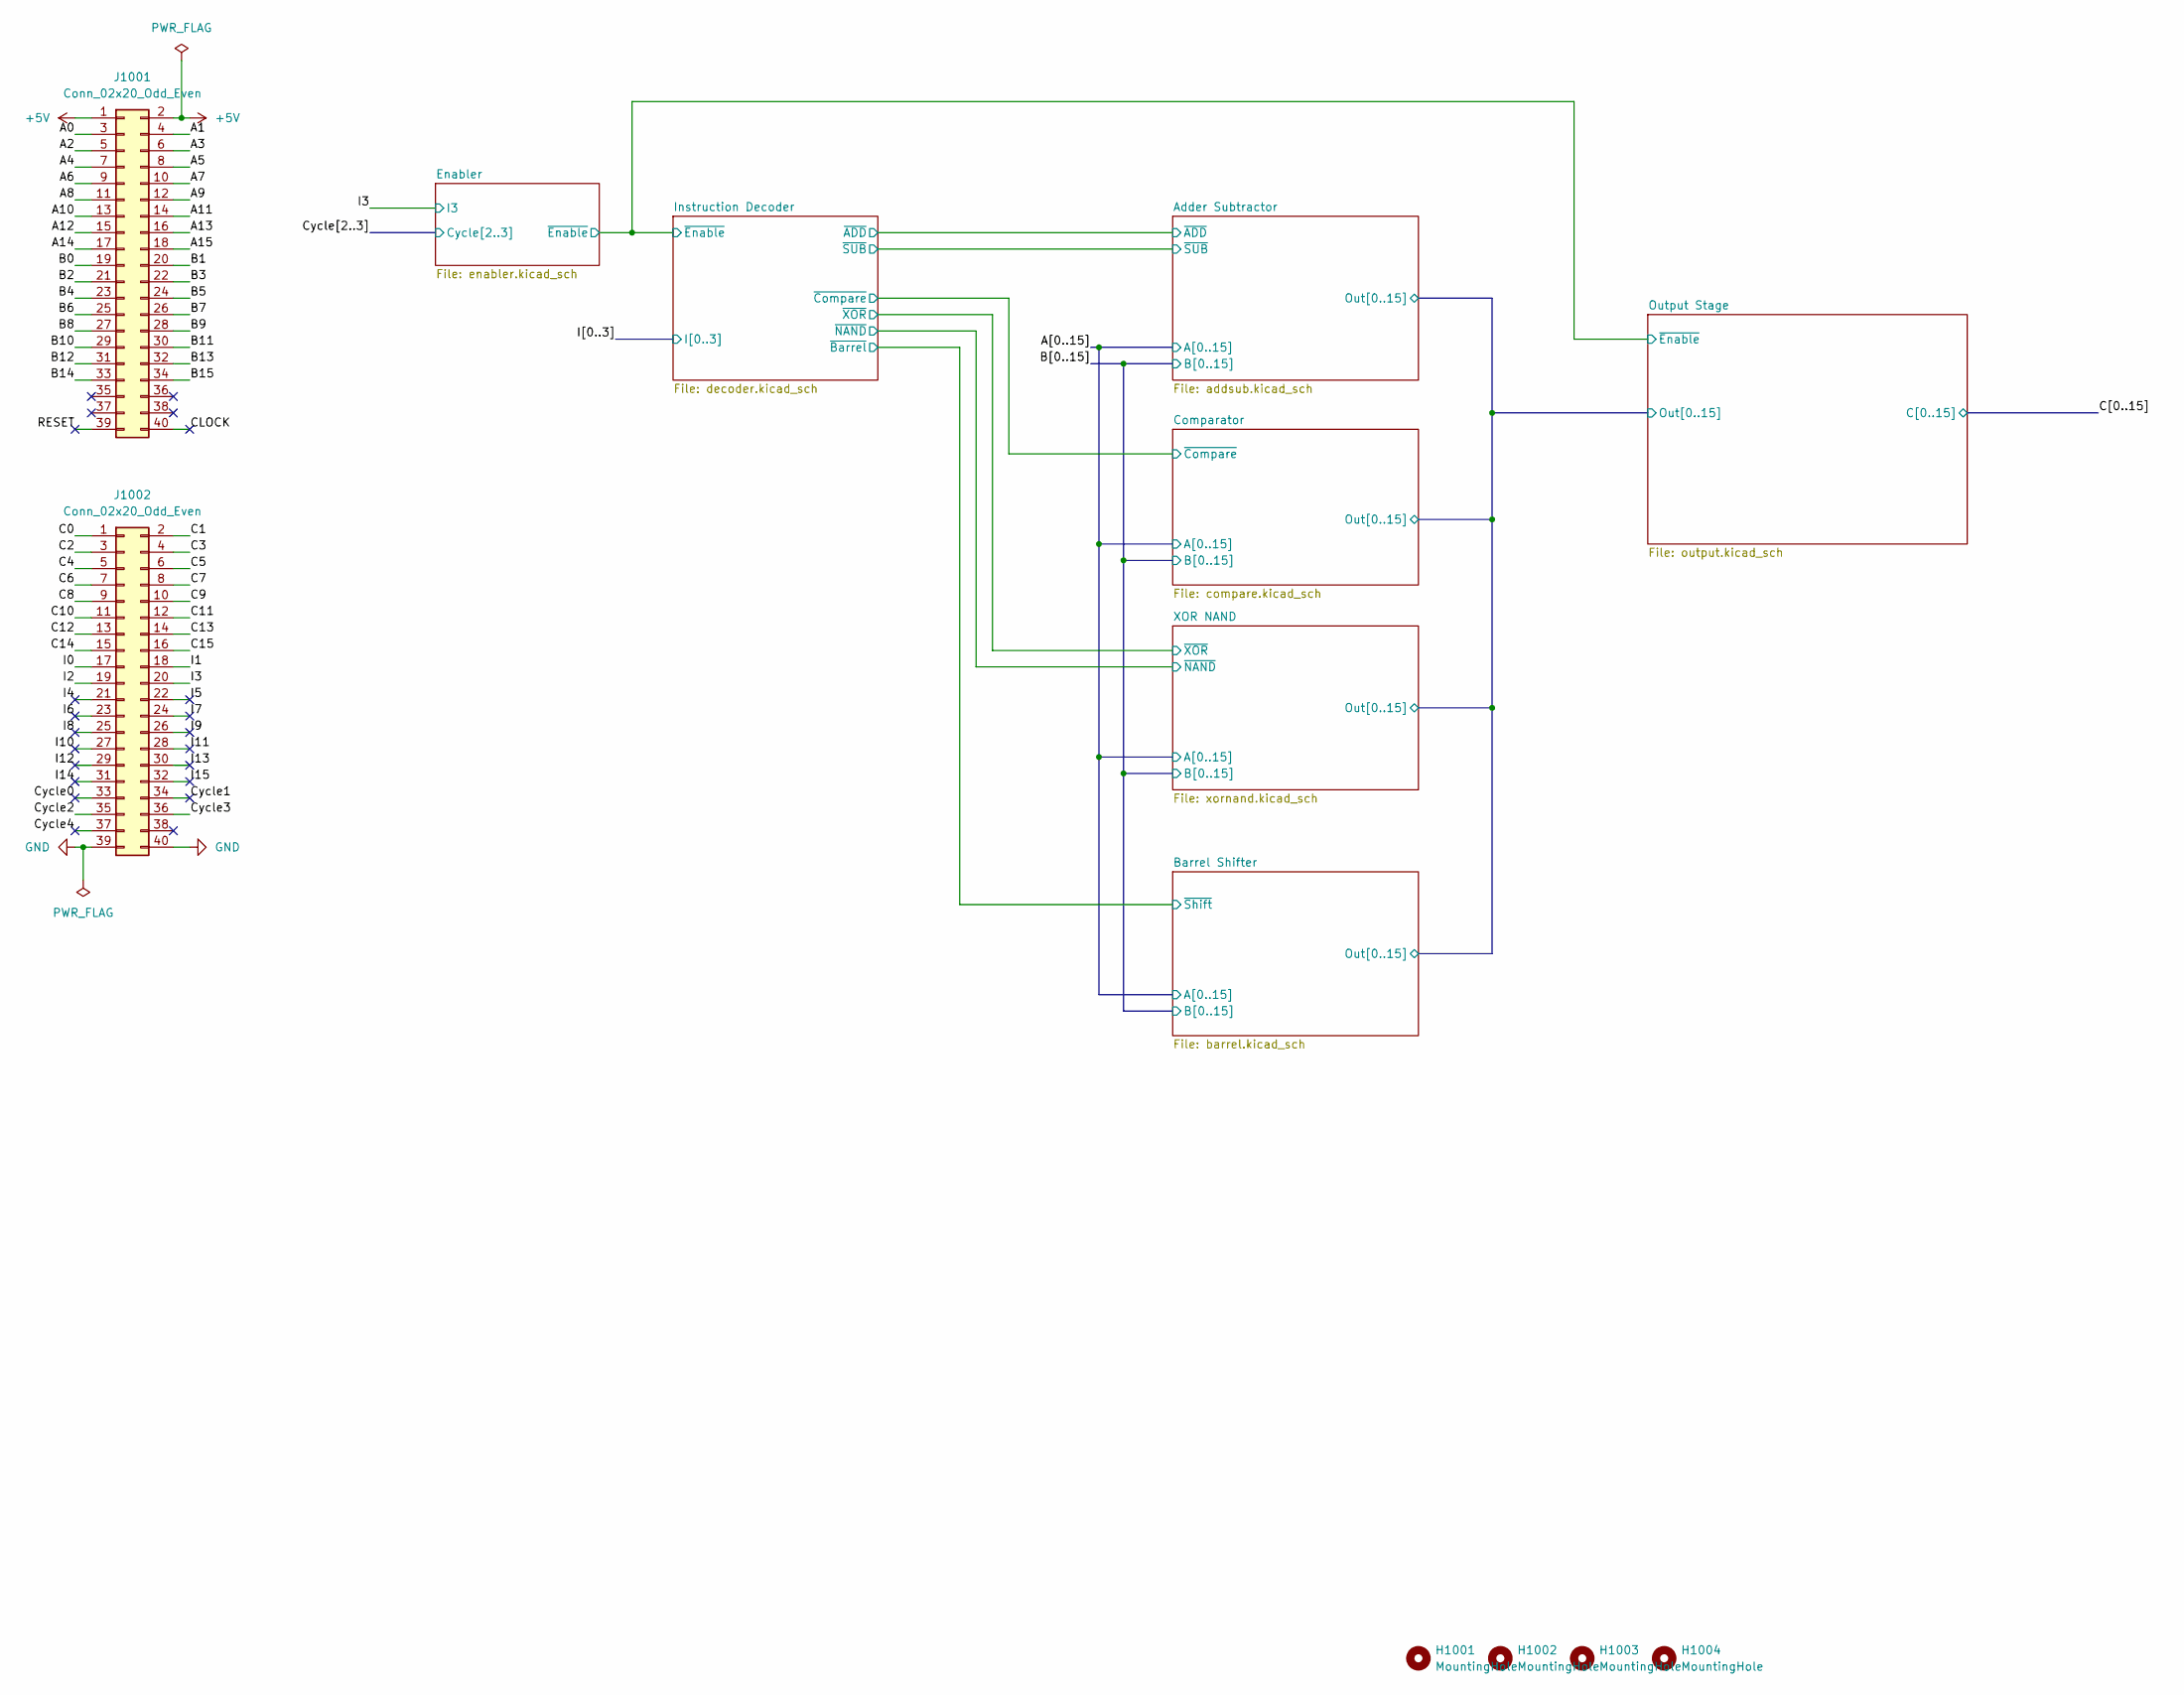
[picture p18: schematic ALU Carrier.kicad_sch]

Parts:
H1001, H1002, H1003, H1004: MountingHole; MountingHole_2.7mm_M2.5_ISO7380
J1001, J1002: Conn_02x20_Odd_Even; PinHeader_2x20_P2.54mm_Vertical

Connections:
+5V: J1001.1, J1001.2; also elsewhere on the board
/A0: J1001.3; also elsewhere on the board
/A1: J1001.4; also elsewhere on the board
/A2: J1001.5; also elsewhere on the board
/A3: J1001.6; also elsewhere on the board
/A4: J1001.7; also elsewhere on the board
/A5: J1001.8; also elsewhere on the board
/A6: J1001.9; also elsewhere on the board
/A7: J1001.10; also elsewhere on the board
/A8: J1001.11; also elsewhere on the board
/A9: J1001.12; also elsewhere on the board
/A10: J1001.13; also elsewhere on the board
/A11: J1001.14; also elsewhere on the board
/A12: J1001.15; also elsewhere on the board
/A13: J1001.16; also elsewhere on the board
/A14: J1001.17; also elsewhere on the board
/A15: J1001.18; also elsewhere on the board
/B0: J1001.19; also elsewhere on the board
/B1: J1001.20; also elsewhere on the board
/B2: J1001.21; also elsewhere on the board
/B3: J1001.22; also elsewhere on the board
/B4: J1001.23; also elsewhere on the board
/B5: J1001.24; also elsewhere on the board
/B6: J1001.25; also elsewhere on the board
/B7: J1001.26; also elsewhere on the board
/B8: J1001.27; also elsewhere on the board
/B9: J1001.28; also elsewhere on the board
/B10: J1001.29; also elsewhere on the board
/B11: J1001.30; also elsewhere on the board
/B12: J1001.31; also elsewhere on the board
/B13: J1001.32; also elsewhere on the board
/B14: J1001.33; also elsewhere on the board
/B15: J1001.34; also elsewhere on the board
/C0: J1002.1; also elsewhere on the board
/C1: J1002.2; also elsewhere on the board
/C2: J1002.3; also elsewhere on the board
/C3: J1002.4; also elsewhere on the board
/C4: J1002.5; also elsewhere on the board
/C5: J1002.6; also elsewhere on the board
/C6: J1002.7; also elsewhere on the board
/C7: J1002.8; also elsewhere on the board
/C8: J1002.9; also elsewhere on the board
/C9: J1002.10; also elsewhere on the board
/C10: J1002.11; also elsewhere on the board
/C11: J1002.12; also elsewhere on the board
/C12: J1002.13; also elsewhere on the board
/C13: J1002.14; also elsewhere on the board
/C14: J1002.15; also elsewhere on the board
/C15: J1002.16; also elsewhere on the board
/CLOCK: J1001.40
/Cycle0: J1002.33
/Cycle1: J1002.34
/Cycle2: J1002.35; also elsewhere on the board
/Cycle3: J1002.36; also elsewhere on the board
/Cycle4: J1002.37
/I0: J1002.17; also elsewhere on the board
/I1: J1002.18; also elsewhere on the board
/I2: J1002.19; also elsewhere on the board
/I3: J1002.20; also elsewhere on the board
/I4: J1002.21
/I5: J1002.22
/I6: J1002.23
/I7: J1002.24
/I8: J1002.25
/I9: J1002.26
/I10: J1002.27
/I11: J1002.28
/I12: J1002.29
/I13: J1002.30
/I14: J1002.31
/I15: J1002.32
/RESET: J1001.39
GND: J1002.39, J1002.40; also elsewhere on the board

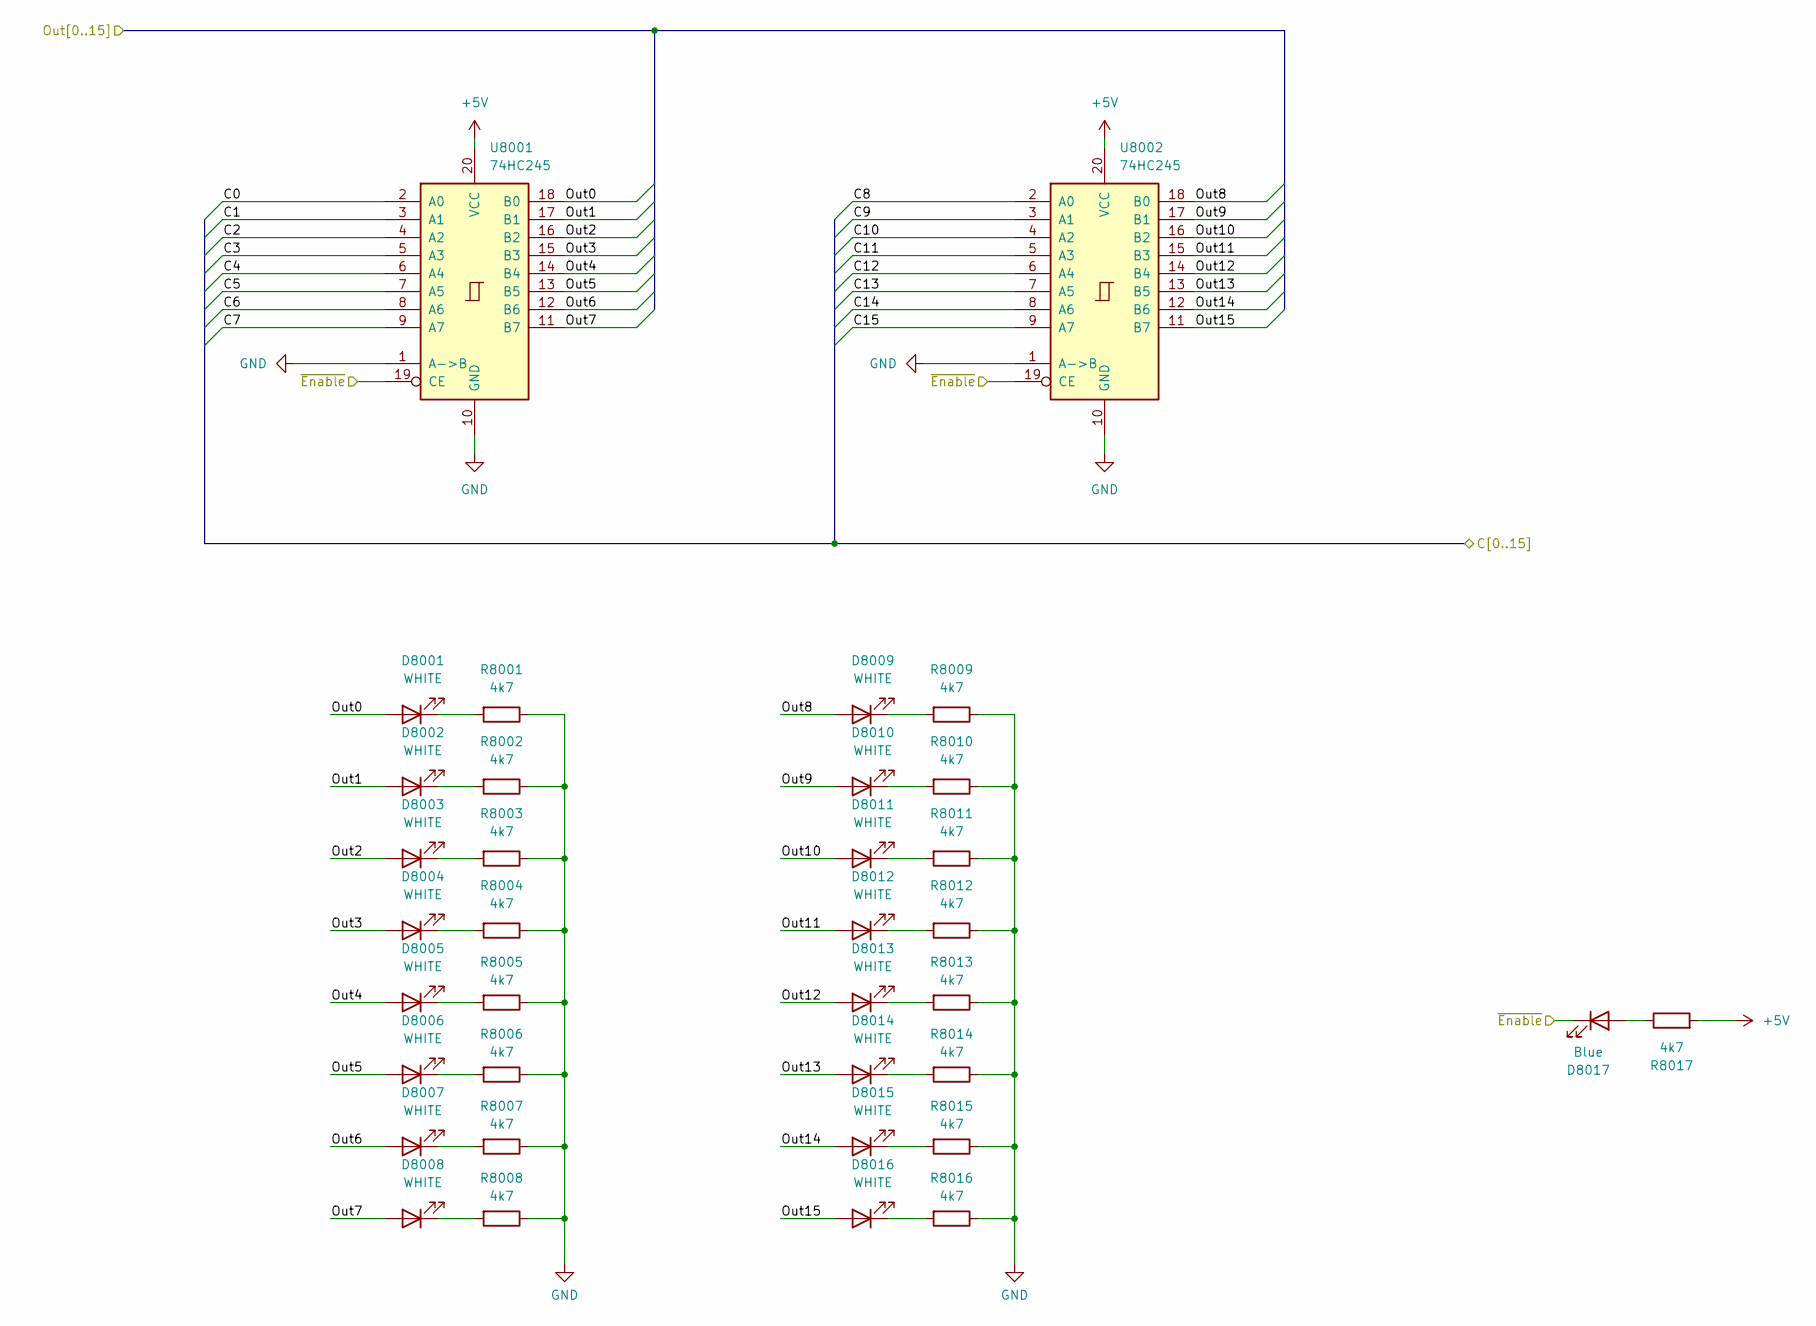
[picture p19: schematic output.kicad_sch]

Parts:
D8001, D8002, D8003, D8004, D8005, D8006, D8007, D8008, D8009, D8010, D8011, D8012, D8013, D8014, D8015, D8016: WHITE; LED_0603_1608Metric; LCSC C2290
D8017: Blue; LED_0603_1608Metric; LCSC C72041
R8001, R8002, R8003, R8004, R8005, R8006, R8007, R8008, R8009, R8010, R8011, R8012, R8013, R8014, R8015, R8016, R8017: 4k7; R_0603_1608Metric; LCSC C23162
U8001, U8002: 74HC245; SOIC-20W_7.5x12.8mm_P1.27mm; LCSC C5625

Connections:
+5V: R8017.2, U8001.20 (VCC), U8002.20 (VCC); also elsewhere on the board
/Adder Subtractor/Out0: D8001.2 (A), U8001.18 (B0); also elsewhere on the board
/Adder Subtractor/Out1: D8002.2 (A), U8001.17 (B1); also elsewhere on the board
/Adder Subtractor/Out2: D8003.2 (A), U8001.16 (B2); also elsewhere on the board
/Adder Subtractor/Out3: D8004.2 (A), U8001.15 (B3); also elsewhere on the board
/Adder Subtractor/Out4: D8005.2 (A), U8001.14 (B4); also elsewhere on the board
/Adder Subtractor/Out5: D8006.2 (A), U8001.13 (B5); also elsewhere on the board
/Adder Subtractor/Out6: D8007.2 (A), U8001.12 (B6); also elsewhere on the board
/Adder Subtractor/Out7: D8008.2 (A), U8001.11 (B7); also elsewhere on the board
/Adder Subtractor/Out8: D8009.2 (A), U8002.18 (B0); also elsewhere on the board
/Adder Subtractor/Out9: D8010.2 (A), U8002.17 (B1); also elsewhere on the board
/Adder Subtractor/Out10: D8011.2 (A), U8002.16 (B2); also elsewhere on the board
/Adder Subtractor/Out11: D8012.2 (A), U8002.15 (B3); also elsewhere on the board
/Adder Subtractor/Out12: D8013.2 (A), U8002.14 (B4); also elsewhere on the board
/Adder Subtractor/Out13: D8014.2 (A), U8002.13 (B5); also elsewhere on the board
/Adder Subtractor/Out14: D8015.2 (A), U8002.12 (B6); also elsewhere on the board
/Adder Subtractor/Out15: D8016.2 (A), U8002.11 (B7); also elsewhere on the board
/C0: U8001.2 (A0); also elsewhere on the board
/C1: U8001.3 (A1); also elsewhere on the board
/C2: U8001.4 (A2); also elsewhere on the board
/C3: U8001.5 (A3); also elsewhere on the board
/C4: U8001.6 (A4); also elsewhere on the board
/C5: U8001.7 (A5); also elsewhere on the board
/C6: U8001.8 (A6); also elsewhere on the board
/C7: U8001.9 (A7); also elsewhere on the board
/C8: U8002.2 (A0); also elsewhere on the board
/C9: U8002.3 (A1); also elsewhere on the board
/C10: U8002.4 (A2); also elsewhere on the board
/C11: U8002.5 (A3); also elsewhere on the board
/C12: U8002.6 (A4); also elsewhere on the board
/C13: U8002.7 (A5); also elsewhere on the board
/C14: U8002.8 (A6); also elsewhere on the board
/C15: U8002.9 (A7); also elsewhere on the board
/Enabler/~Enable: D8017.1 (K), U8001.19 (CE), U8002.19 (CE); also elsewhere on the board
GND: R8001.1, R8002.1, R8003.1, R8004.1, R8005.1, R8006.1, R8007.1, R8008.1, R8009.1, R8010.1, R8011.1, R8012.1, R8013.1, R8014.1, R8015.1, R8016.1, U8001.1 (A->B), U8001.10 (GND), U8002.1 (A->B), U8002.10 (GND); also elsewhere on the board
unnamed: D8001.1 (K), R8001.2
unnamed: D8002.1 (K), R8002.2
unnamed: D8003.1 (K), R8003.2
unnamed: D8004.1 (K), R8004.2
unnamed: D8005.1 (K), R8005.2
unnamed: D8006.1 (K), R8006.2
unnamed: D8007.1 (K), R8007.2
unnamed: D8008.1 (K), R8008.2
unnamed: D8009.1 (K), R8009.2
unnamed: D8010.1 (K), R8010.2
unnamed: D8011.1 (K), R8011.2
unnamed: D8012.1 (K), R8012.2
unnamed: D8013.1 (K), R8013.2
unnamed: D8014.1 (K), R8014.2
unnamed: D8015.1 (K), R8015.2
unnamed: D8016.1 (K), R8016.2
unnamed: D8017.2 (A), R8017.1

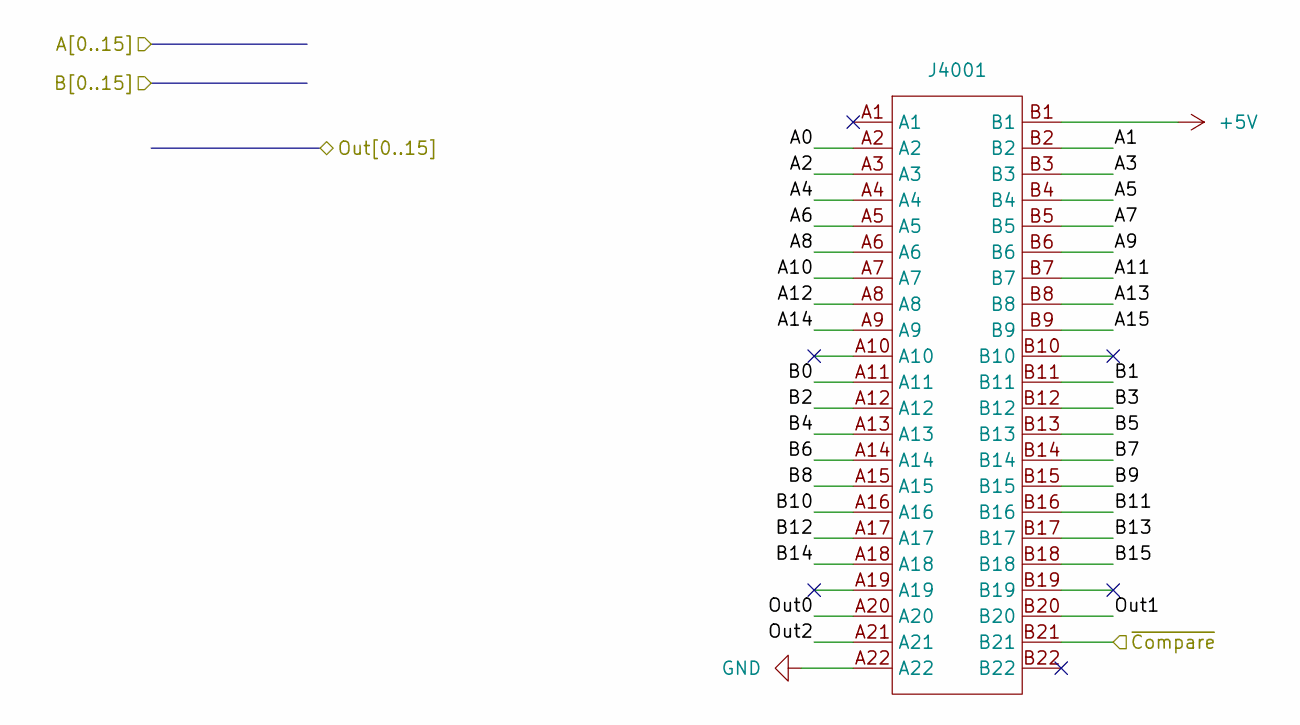
[picture p20: schematic compare.kicad_sch]

Parts:
J4001: TE-5530843-4-Mount

Connections:
+5V: J4001.B1; also elsewhere on the board
/A0: J4001.A2; also elsewhere on the board
/A1: J4001.B2; also elsewhere on the board
/A2: J4001.A3; also elsewhere on the board
/A3: J4001.B3; also elsewhere on the board
/A4: J4001.A4; also elsewhere on the board
/A5: J4001.B4; also elsewhere on the board
/A6: J4001.A5; also elsewhere on the board
/A7: J4001.B5; also elsewhere on the board
/A8: J4001.A6; also elsewhere on the board
/A9: J4001.B6; also elsewhere on the board
/A10: J4001.A7; also elsewhere on the board
/A11: J4001.B7; also elsewhere on the board
/A12: J4001.A8; also elsewhere on the board
/A13: J4001.B8; also elsewhere on the board
/A14: J4001.A9; also elsewhere on the board
/A15: J4001.B9; also elsewhere on the board
/Adder Subtractor/Out0: J4001.A20; also elsewhere on the board
/Adder Subtractor/Out1: J4001.B20; also elsewhere on the board
/Adder Subtractor/Out2: J4001.A21; also elsewhere on the board
/B0: J4001.A11; also elsewhere on the board
/B1: J4001.B11; also elsewhere on the board
/B2: J4001.A12; also elsewhere on the board
/B3: J4001.B12; also elsewhere on the board
/B4: J4001.A13; also elsewhere on the board
/B5: J4001.B13; also elsewhere on the board
/B6: J4001.A14; also elsewhere on the board
/B7: J4001.B14; also elsewhere on the board
/B8: J4001.A15; also elsewhere on the board
/B9: J4001.B15; also elsewhere on the board
/B10: J4001.A16; also elsewhere on the board
/B11: J4001.B16; also elsewhere on the board
/B12: J4001.A17; also elsewhere on the board
/B13: J4001.B17; also elsewhere on the board
/B14: J4001.A18; also elsewhere on the board
/B15: J4001.B18; also elsewhere on the board
/Comparator/~Compare: J4001.B21; also elsewhere on the board
GND: J4001.A22; also elsewhere on the board

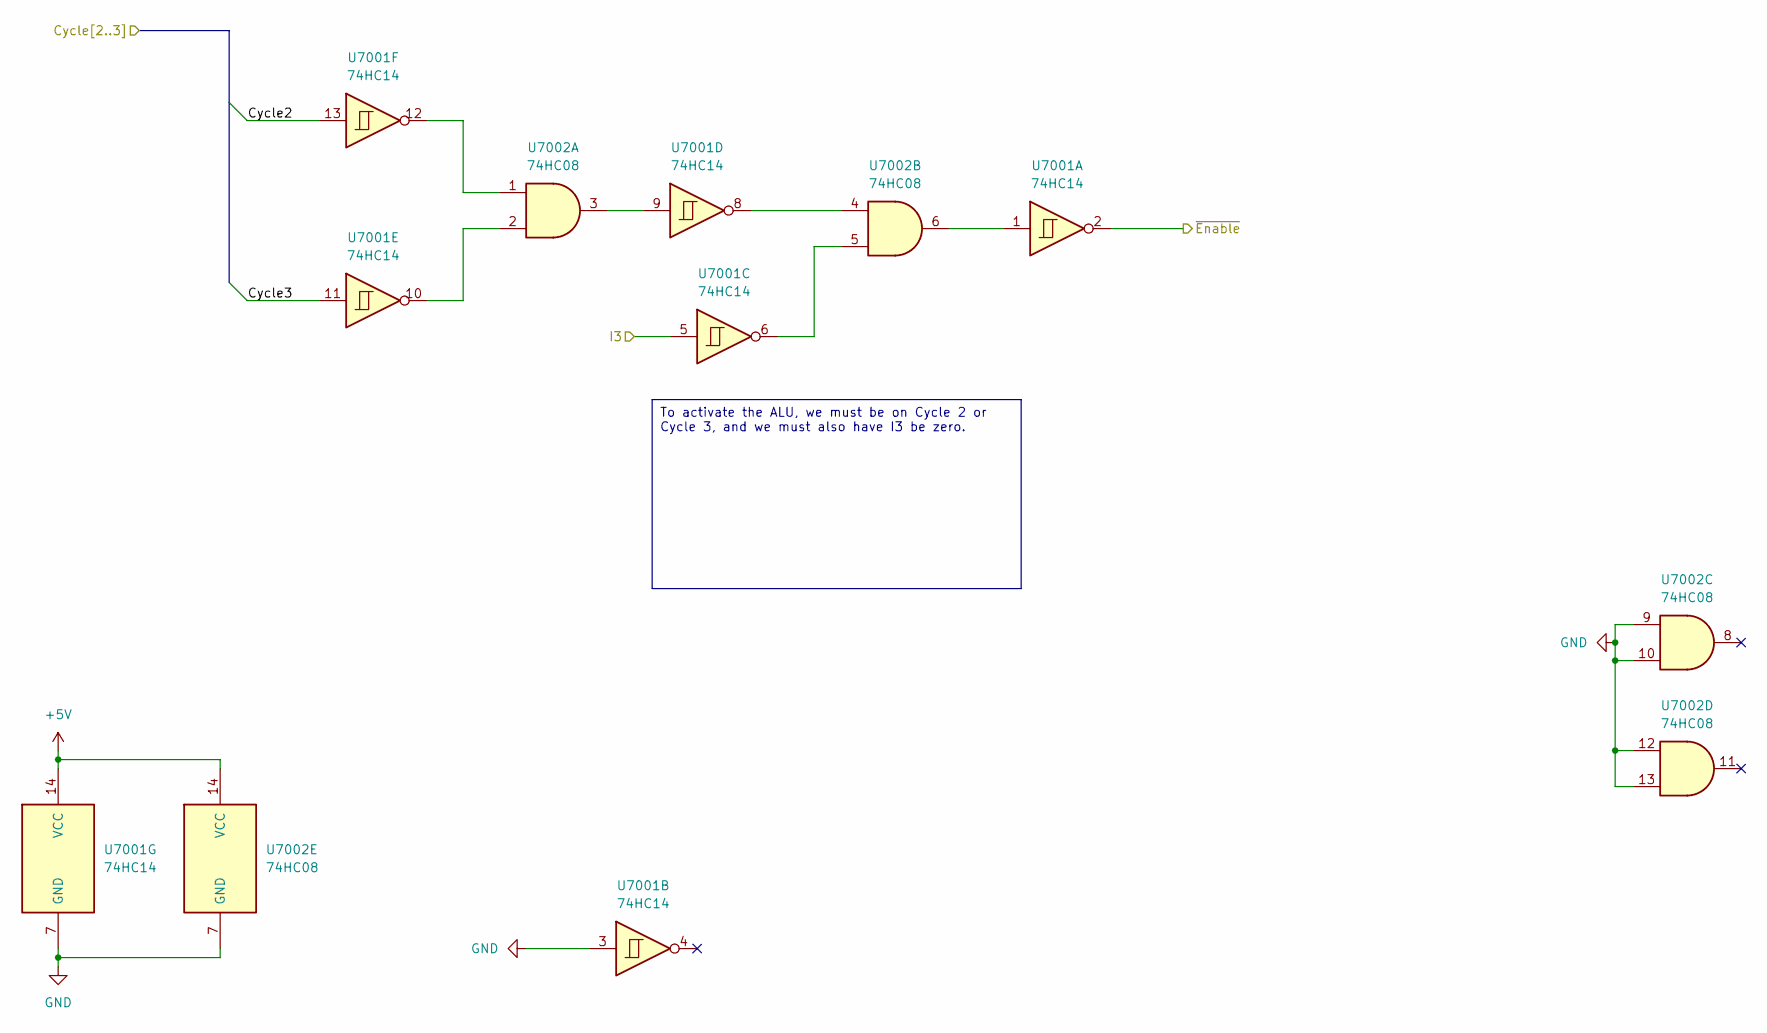
[picture p21: schematic enabler.kicad_sch]

Parts:
U7001: 74HC14; SOIC-14_3.9x8.7mm_P1.27mm; LCSC C5605
U7002: 74HC08; SOIC-14_3.9x8.7mm_P1.27mm; LCSC C5593

Connections:
+5V: U7001.14 (VCC), U7002.14 (VCC); also elsewhere on the board
/Cycle2: U7001.13; also elsewhere on the board
/Cycle3: U7001.11; also elsewhere on the board
/Enabler/~Enable: U7001.2; also elsewhere on the board
/I3: U7001.5; also elsewhere on the board
GND: U7001.3, U7001.7 (GND), U7002.7 (GND), U7002.9, U7002.10, U7002.12, U7002.13; also elsewhere on the board
unnamed: U7001.1, U7002.6
unnamed: U7001.6, U7002.5
unnamed: U7001.8, U7002.4
unnamed: U7001.9, U7002.3
unnamed: U7001.10, U7002.2
unnamed: U7001.12, U7002.1

Notes on the sheet:
To activate the ALU, we must be on Cycle 2 or Cycle 3, and we must also have I3 be zero.

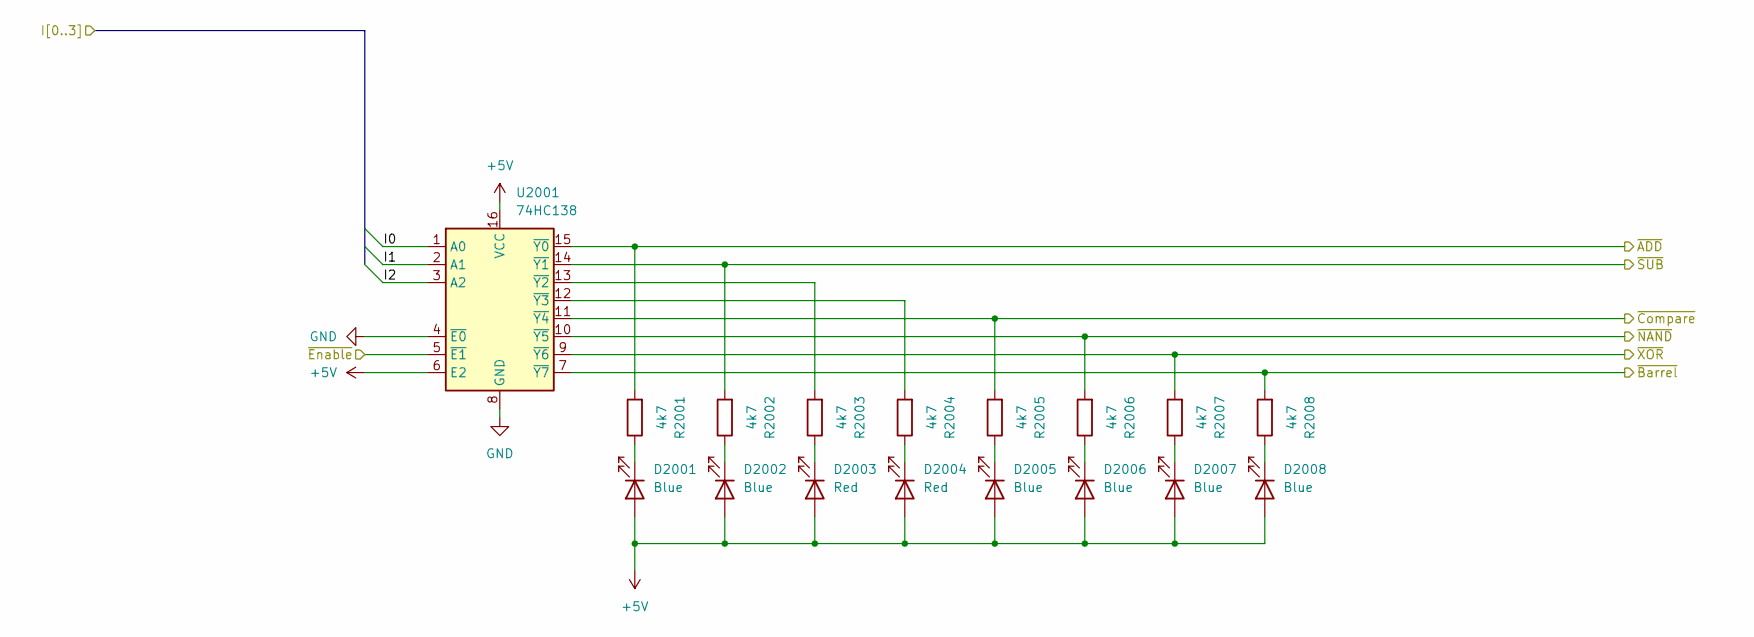
[picture p22: schematic decoder.kicad_sch]

Parts:
D2001, D2002, D2005, D2006, D2007, D2008: Blue; LED_0603_1608Metric; LCSC C72041
D2003, D2004: Red; LED_0603_1608Metric; LCSC C2286
R2001, R2002, R2003, R2004, R2005, R2006, R2007, R2008: 4k7; R_0603_1608Metric; LCSC C23162
U2001: 74HC138; DIP-16_W7.62mm_Socket

Connections:
+5V: D2001.2 (A), D2002.2 (A), D2003.2 (A), D2004.2 (A), D2005.2 (A), D2006.2 (A), D2007.2 (A), D2008.2 (A), U2001.6 (E2), U2001.16 (VCC); also elsewhere on the board
/Adder Subtractor/~ADD: R2001.2, U2001.15 (~Y0); also elsewhere on the board
/Adder Subtractor/~SUB: R2002.2, U2001.14 (~Y1); also elsewhere on the board
/Barrel Shifter/~Shift: R2008.2, U2001.7 (~Y7); also elsewhere on the board
/Comparator/~Compare: R2005.2, U2001.11 (~Y4); also elsewhere on the board
/Enabler/~Enable: U2001.5 (~E1); also elsewhere on the board
/I0: U2001.1 (A0); also elsewhere on the board
/I1: U2001.2 (A1); also elsewhere on the board
/I2: U2001.3 (A2); also elsewhere on the board
/Instruction Decoder/~NAND: R2006.2, U2001.10 (~Y5); also elsewhere on the board
/Instruction Decoder/~XOR: R2007.2, U2001.9 (~Y6); also elsewhere on the board
GND: U2001.4 (~E0), U2001.8 (GND); also elsewhere on the board
unnamed: D2001.1 (K), R2001.1
unnamed: D2002.1 (K), R2002.1
unnamed: D2003.1 (K), R2003.1
unnamed: D2004.1 (K), R2004.1
unnamed: D2005.1 (K), R2005.1
unnamed: D2006.1 (K), R2006.1
unnamed: D2007.1 (K), R2007.1
unnamed: D2008.1 (K), R2008.1
unnamed: R2003.2, U2001.13 (~Y2)
unnamed: R2004.2, U2001.12 (~Y3)

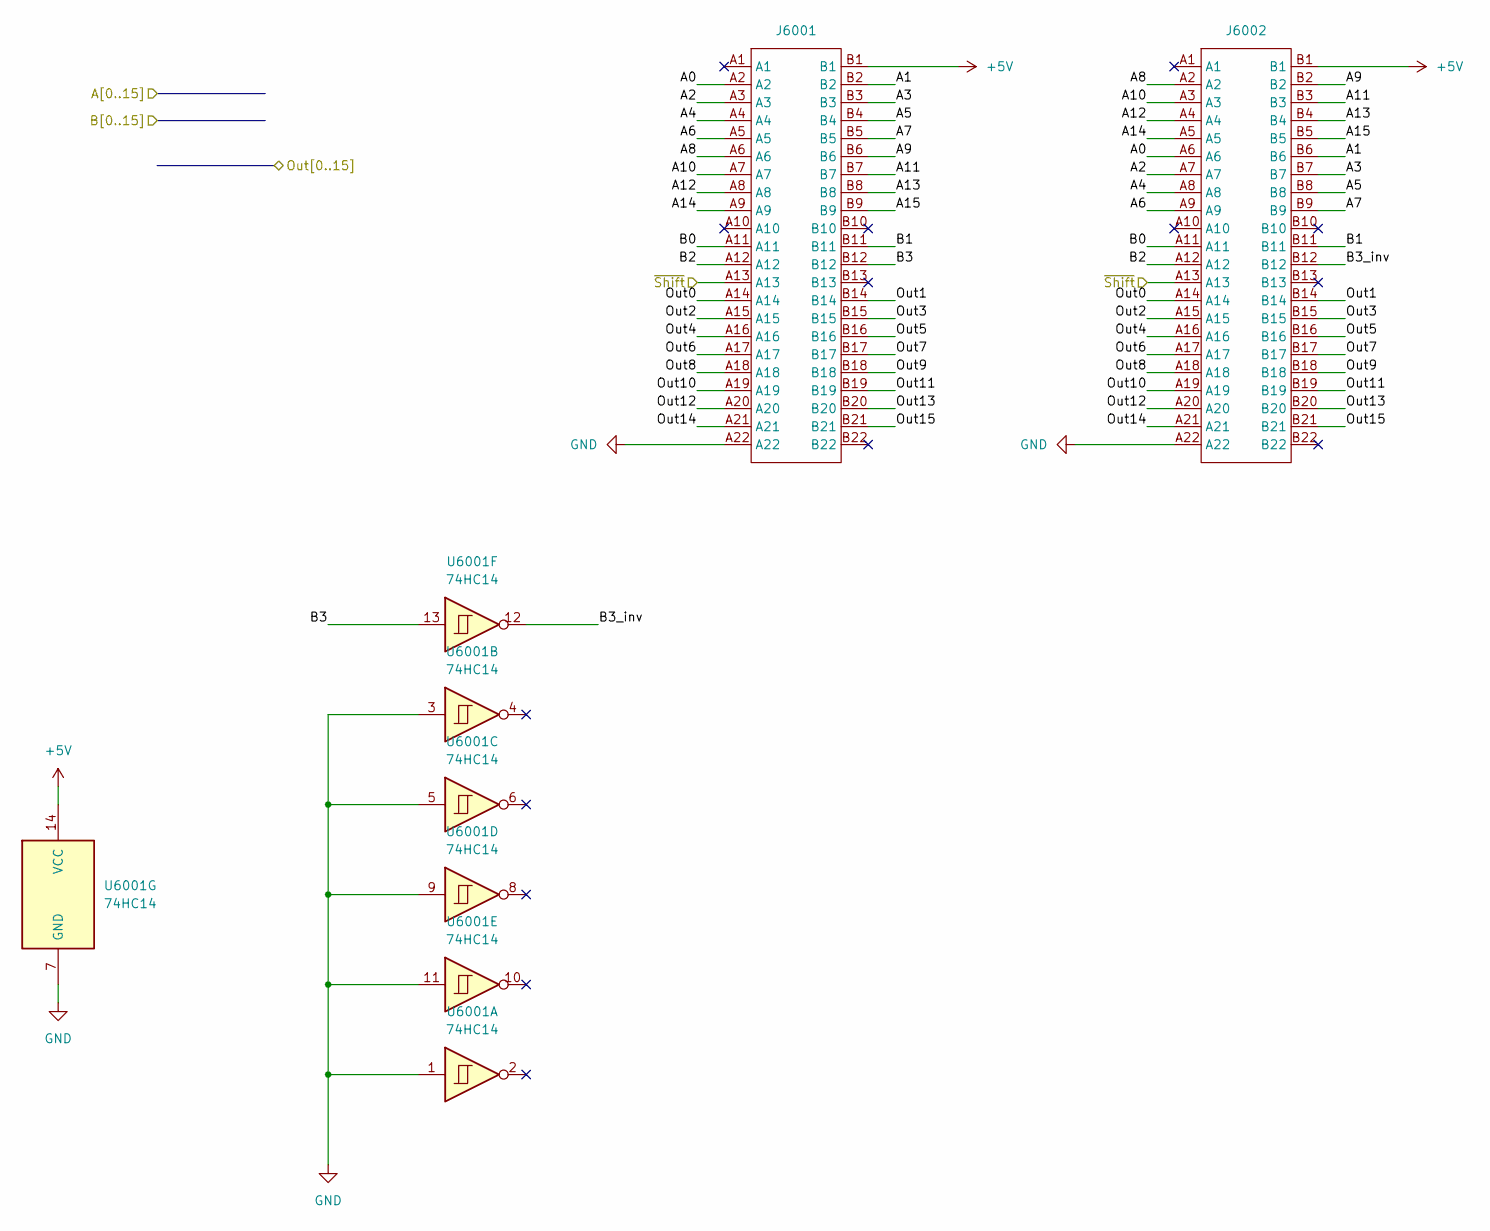
[picture p23: schematic barrel.kicad_sch]

Parts:
J6001, J6002: TE-5530843-4-Mount
U6001: 74HC14; SOIC-14_3.9x8.7mm_P1.27mm; LCSC C5605

Connections:
+5V: J6001.B1, J6002.B1, U6001.14 (VCC); also elsewhere on the board
/A0: J6001.A2, J6002.A6; also elsewhere on the board
/A1: J6001.B2, J6002.B6; also elsewhere on the board
/A2: J6001.A3, J6002.A7; also elsewhere on the board
/A3: J6001.B3, J6002.B7; also elsewhere on the board
/A4: J6001.A4, J6002.A8; also elsewhere on the board
/A5: J6001.B4, J6002.B8; also elsewhere on the board
/A6: J6001.A5, J6002.A9; also elsewhere on the board
/A7: J6001.B5, J6002.B9; also elsewhere on the board
/A8: J6001.A6, J6002.A2; also elsewhere on the board
/A9: J6001.B6, J6002.B2; also elsewhere on the board
/A10: J6001.A7, J6002.A3; also elsewhere on the board
/A11: J6001.B7, J6002.B3; also elsewhere on the board
/A12: J6001.A8, J6002.A4; also elsewhere on the board
/A13: J6001.B8, J6002.B4; also elsewhere on the board
/A14: J6001.A9, J6002.A5; also elsewhere on the board
/A15: J6001.B9, J6002.B5; also elsewhere on the board
/Adder Subtractor/Out0: J6001.A14, J6002.A14; also elsewhere on the board
/Adder Subtractor/Out1: J6001.B14, J6002.B14; also elsewhere on the board
/Adder Subtractor/Out2: J6001.A15, J6002.A15; also elsewhere on the board
/Adder Subtractor/Out3: J6001.B15, J6002.B15; also elsewhere on the board
/Adder Subtractor/Out4: J6001.A16, J6002.A16; also elsewhere on the board
/Adder Subtractor/Out5: J6001.B16, J6002.B16; also elsewhere on the board
/Adder Subtractor/Out6: J6001.A17, J6002.A17; also elsewhere on the board
/Adder Subtractor/Out7: J6001.B17, J6002.B17; also elsewhere on the board
/Adder Subtractor/Out8: J6001.A18, J6002.A18; also elsewhere on the board
/Adder Subtractor/Out9: J6001.B18, J6002.B18; also elsewhere on the board
/Adder Subtractor/Out10: J6001.A19, J6002.A19; also elsewhere on the board
/Adder Subtractor/Out11: J6001.B19, J6002.B19; also elsewhere on the board
/Adder Subtractor/Out12: J6001.A20, J6002.A20; also elsewhere on the board
/Adder Subtractor/Out13: J6001.B20, J6002.B20; also elsewhere on the board
/Adder Subtractor/Out14: J6001.A21, J6002.A21; also elsewhere on the board
/Adder Subtractor/Out15: J6001.B21, J6002.B21; also elsewhere on the board
/B0: J6001.A11, J6002.A11; also elsewhere on the board
/B1: J6001.B11, J6002.B11; also elsewhere on the board
/B2: J6001.A12, J6002.A12; also elsewhere on the board
/B3: J6001.B12, U6001.13; also elsewhere on the board
/Barrel Shifter/B3_inv: J6002.B12, U6001.12
/Barrel Shifter/~Shift: J6001.A13, J6002.A13; also elsewhere on the board
GND: J6001.A22, J6002.A22, U6001.1, U6001.3, U6001.5, U6001.7 (GND), U6001.9, U6001.11; also elsewhere on the board

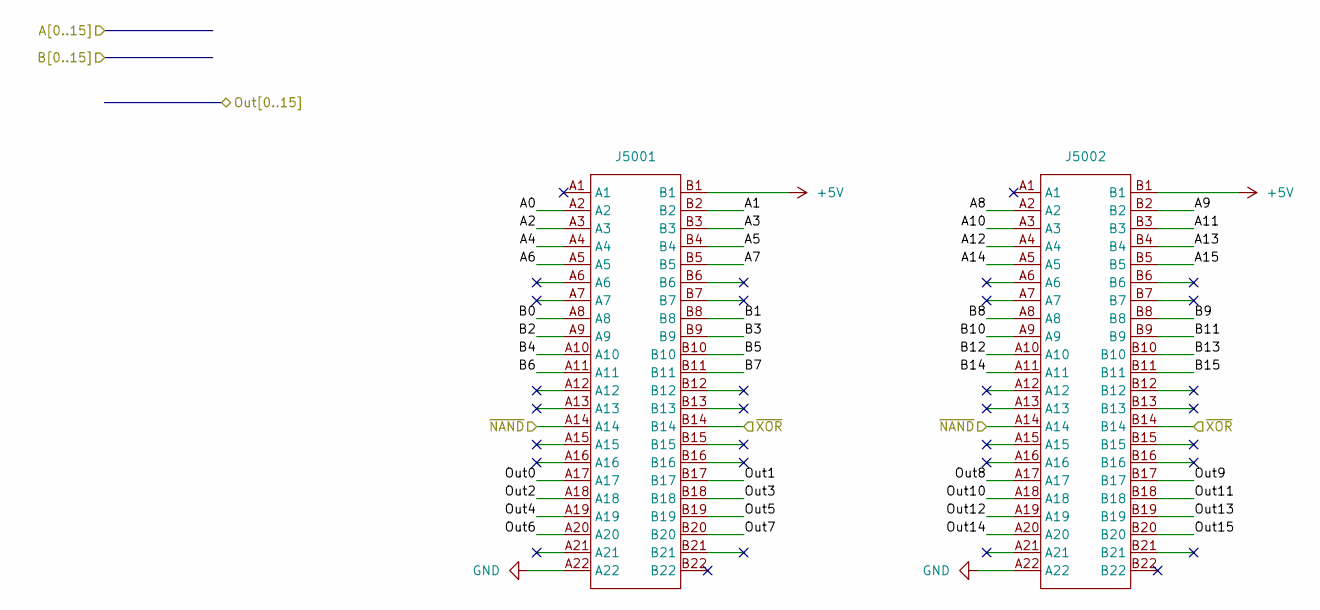
[picture p24: schematic xornand.kicad_sch]

Parts:
J5001, J5002: TE-5530843-4-Mount

Connections:
+5V: J5001.B1, J5002.B1; also elsewhere on the board
/A0: J5001.A2; also elsewhere on the board
/A1: J5001.B2; also elsewhere on the board
/A2: J5001.A3; also elsewhere on the board
/A3: J5001.B3; also elsewhere on the board
/A4: J5001.A4; also elsewhere on the board
/A5: J5001.B4; also elsewhere on the board
/A6: J5001.A5; also elsewhere on the board
/A7: J5001.B5; also elsewhere on the board
/A8: J5002.A2; also elsewhere on the board
/A9: J5002.B2; also elsewhere on the board
/A10: J5002.A3; also elsewhere on the board
/A11: J5002.B3; also elsewhere on the board
/A12: J5002.A4; also elsewhere on the board
/A13: J5002.B4; also elsewhere on the board
/A14: J5002.A5; also elsewhere on the board
/A15: J5002.B5; also elsewhere on the board
/Adder Subtractor/Out0: J5001.A17; also elsewhere on the board
/Adder Subtractor/Out1: J5001.B17; also elsewhere on the board
/Adder Subtractor/Out2: J5001.A18; also elsewhere on the board
/Adder Subtractor/Out3: J5001.B18; also elsewhere on the board
/Adder Subtractor/Out4: J5001.A19; also elsewhere on the board
/Adder Subtractor/Out5: J5001.B19; also elsewhere on the board
/Adder Subtractor/Out6: J5001.A20; also elsewhere on the board
/Adder Subtractor/Out7: J5001.B20; also elsewhere on the board
/Adder Subtractor/Out8: J5002.A17; also elsewhere on the board
/Adder Subtractor/Out9: J5002.B17; also elsewhere on the board
/Adder Subtractor/Out10: J5002.A18; also elsewhere on the board
/Adder Subtractor/Out11: J5002.B18; also elsewhere on the board
/Adder Subtractor/Out12: J5002.A19; also elsewhere on the board
/Adder Subtractor/Out13: J5002.B19; also elsewhere on the board
/Adder Subtractor/Out14: J5002.A20; also elsewhere on the board
/Adder Subtractor/Out15: J5002.B20; also elsewhere on the board
/B0: J5001.A8; also elsewhere on the board
/B1: J5001.B8; also elsewhere on the board
/B2: J5001.A9; also elsewhere on the board
/B3: J5001.B9; also elsewhere on the board
/B4: J5001.A10; also elsewhere on the board
/B5: J5001.B10; also elsewhere on the board
/B6: J5001.A11; also elsewhere on the board
/B7: J5001.B11; also elsewhere on the board
/B8: J5002.A8; also elsewhere on the board
/B9: J5002.B8; also elsewhere on the board
/B10: J5002.A9; also elsewhere on the board
/B11: J5002.B9; also elsewhere on the board
/B12: J5002.A10; also elsewhere on the board
/B13: J5002.B10; also elsewhere on the board
/B14: J5002.A11; also elsewhere on the board
/B15: J5002.B11; also elsewhere on the board
/Instruction Decoder/~NAND: J5001.A14, J5002.A14; also elsewhere on the board
/Instruction Decoder/~XOR: J5001.B14, J5002.B14; also elsewhere on the board
GND: J5001.A22, J5002.A22; also elsewhere on the board
