freesurfer-rge/slothpu16/pcbs/ALU Carrier/ALU Carrier.kicad_pcb

## KiCad design pcbs/ALU Carrier/ALU Carrier.kicad_pcb (continued)

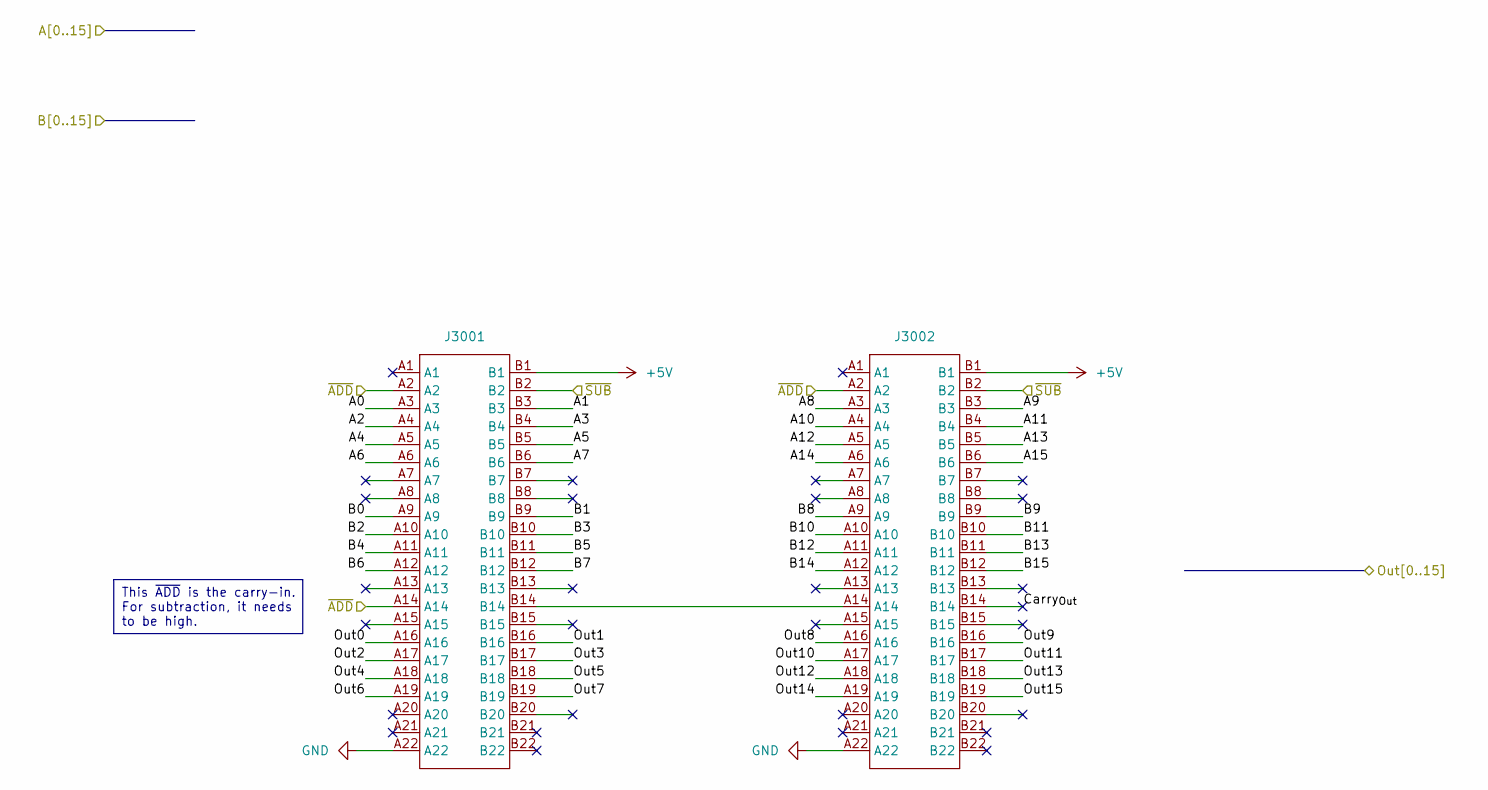
[picture p25: schematic addsub.kicad_sch]

Parts:
J3001, J3002: TE-5530843-4-Mount

Connections:
+5V: J3001.B1, J3002.B1; also elsewhere on the board
/A0: J3001.A3; also elsewhere on the board
/A1: J3001.B3; also elsewhere on the board
/A2: J3001.A4; also elsewhere on the board
/A3: J3001.B4; also elsewhere on the board
/A4: J3001.A5; also elsewhere on the board
/A5: J3001.B5; also elsewhere on the board
/A6: J3001.A6; also elsewhere on the board
/A7: J3001.B6; also elsewhere on the board
/A8: J3002.A3; also elsewhere on the board
/A9: J3002.B3; also elsewhere on the board
/A10: J3002.A4; also elsewhere on the board
/A11: J3002.B4; also elsewhere on the board
/A12: J3002.A5; also elsewhere on the board
/A13: J3002.B5; also elsewhere on the board
/A14: J3002.A6; also elsewhere on the board
/A15: J3002.B6; also elsewhere on the board
/Adder Subtractor/Carry_{Out}: J3002.B14
/Adder Subtractor/Out0: J3001.A16; also elsewhere on the board
/Adder Subtractor/Out1: J3001.B16; also elsewhere on the board
/Adder Subtractor/Out2: J3001.A17; also elsewhere on the board
/Adder Subtractor/Out3: J3001.B17; also elsewhere on the board
/Adder Subtractor/Out4: J3001.A18; also elsewhere on the board
/Adder Subtractor/Out5: J3001.B18; also elsewhere on the board
/Adder Subtractor/Out6: J3001.A19; also elsewhere on the board
/Adder Subtractor/Out7: J3001.B19; also elsewhere on the board
/Adder Subtractor/Out8: J3002.A16; also elsewhere on the board
/Adder Subtractor/Out9: J3002.B16; also elsewhere on the board
/Adder Subtractor/Out10: J3002.A17; also elsewhere on the board
/Adder Subtractor/Out11: J3002.B17; also elsewhere on the board
/Adder Subtractor/Out12: J3002.A18; also elsewhere on the board
/Adder Subtractor/Out13: J3002.B18; also elsewhere on the board
/Adder Subtractor/Out14: J3002.A19; also elsewhere on the board
/Adder Subtractor/Out15: J3002.B19; also elsewhere on the board
/Adder Subtractor/~ADD: J3001.A2, J3001.A14, J3002.A2; also elsewhere on the board
/Adder Subtractor/~SUB: J3001.B2, J3002.B2; also elsewhere on the board
/B0: J3001.A9; also elsewhere on the board
/B1: J3001.B9; also elsewhere on the board
/B2: J3001.A10; also elsewhere on the board
/B3: J3001.B10; also elsewhere on the board
/B4: J3001.A11; also elsewhere on the board
/B5: J3001.B11; also elsewhere on the board
/B6: J3001.A12; also elsewhere on the board
/B7: J3001.B12; also elsewhere on the board
/B8: J3002.A9; also elsewhere on the board
/B9: J3002.B9; also elsewhere on the board
/B10: J3002.A10; also elsewhere on the board
/B11: J3002.B10; also elsewhere on the board
/B12: J3002.A11; also elsewhere on the board
/B13: J3002.B11; also elsewhere on the board
/B14: J3002.A12; also elsewhere on the board
/B15: J3002.B12; also elsewhere on the board
GND: J3001.A22, J3002.A22; also elsewhere on the board
unnamed: J3001.B14, J3002.A14

Notes on the sheet:
This ~{ADD} is the carry-in. For subtraction, it needs to be high.

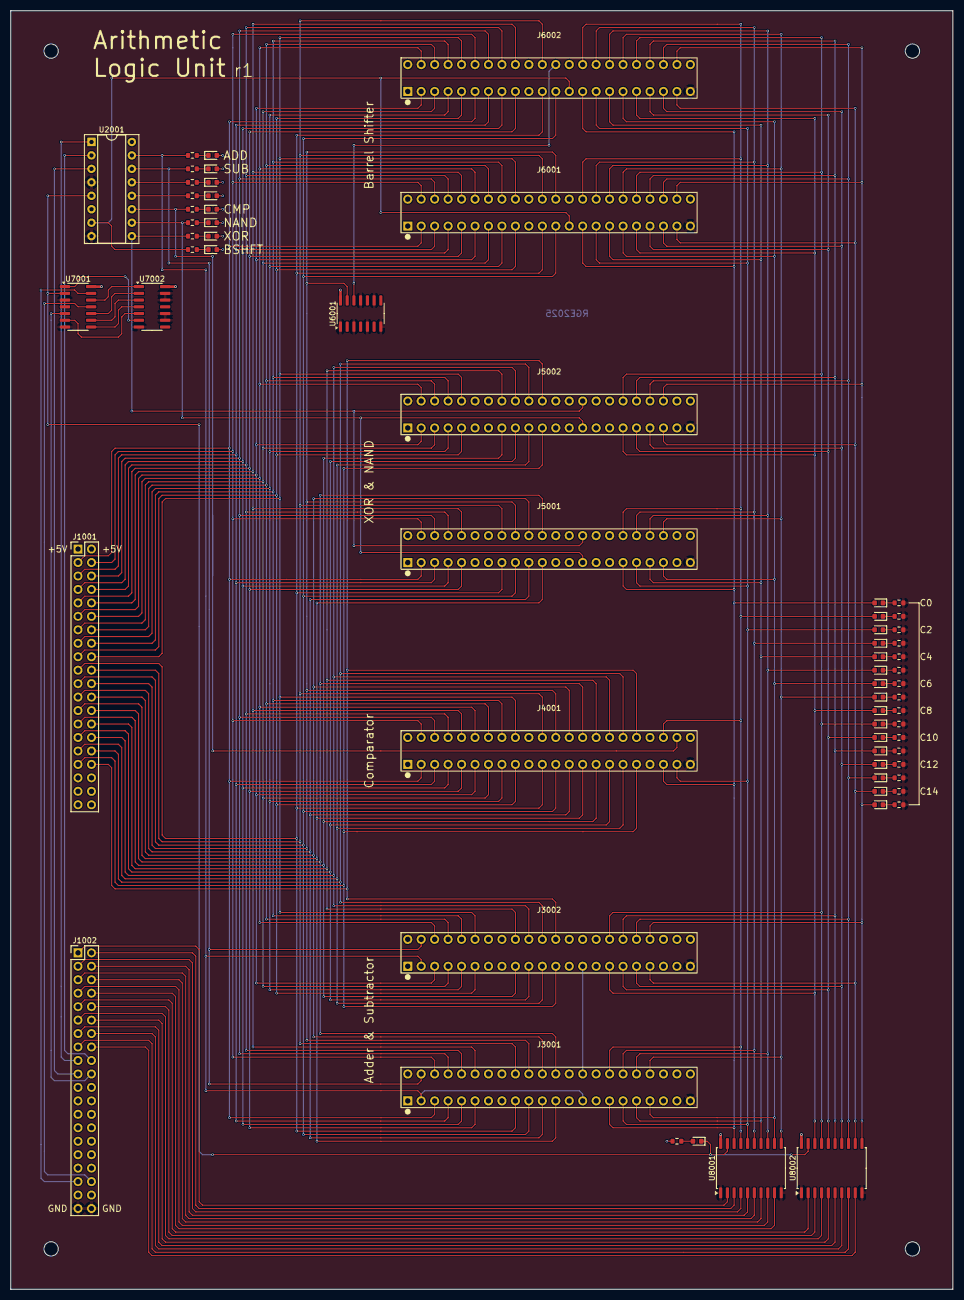
[picture p26: board ALU Carrier.kicad_pcb from above]

Board: 2 copper layers, 177.8 x 241.3 mm, 69 parts (0 on the bottom side), 114 nets.
