freesurfer-rge/slothpu16/pcbs/Pi Backplane Connector/Pi Backplane Connector.kicad_pcb

## KiCad design pcbs/Pi Backplane Connector/Pi Backplane Connector.kicad_pcb (2025-01-11)

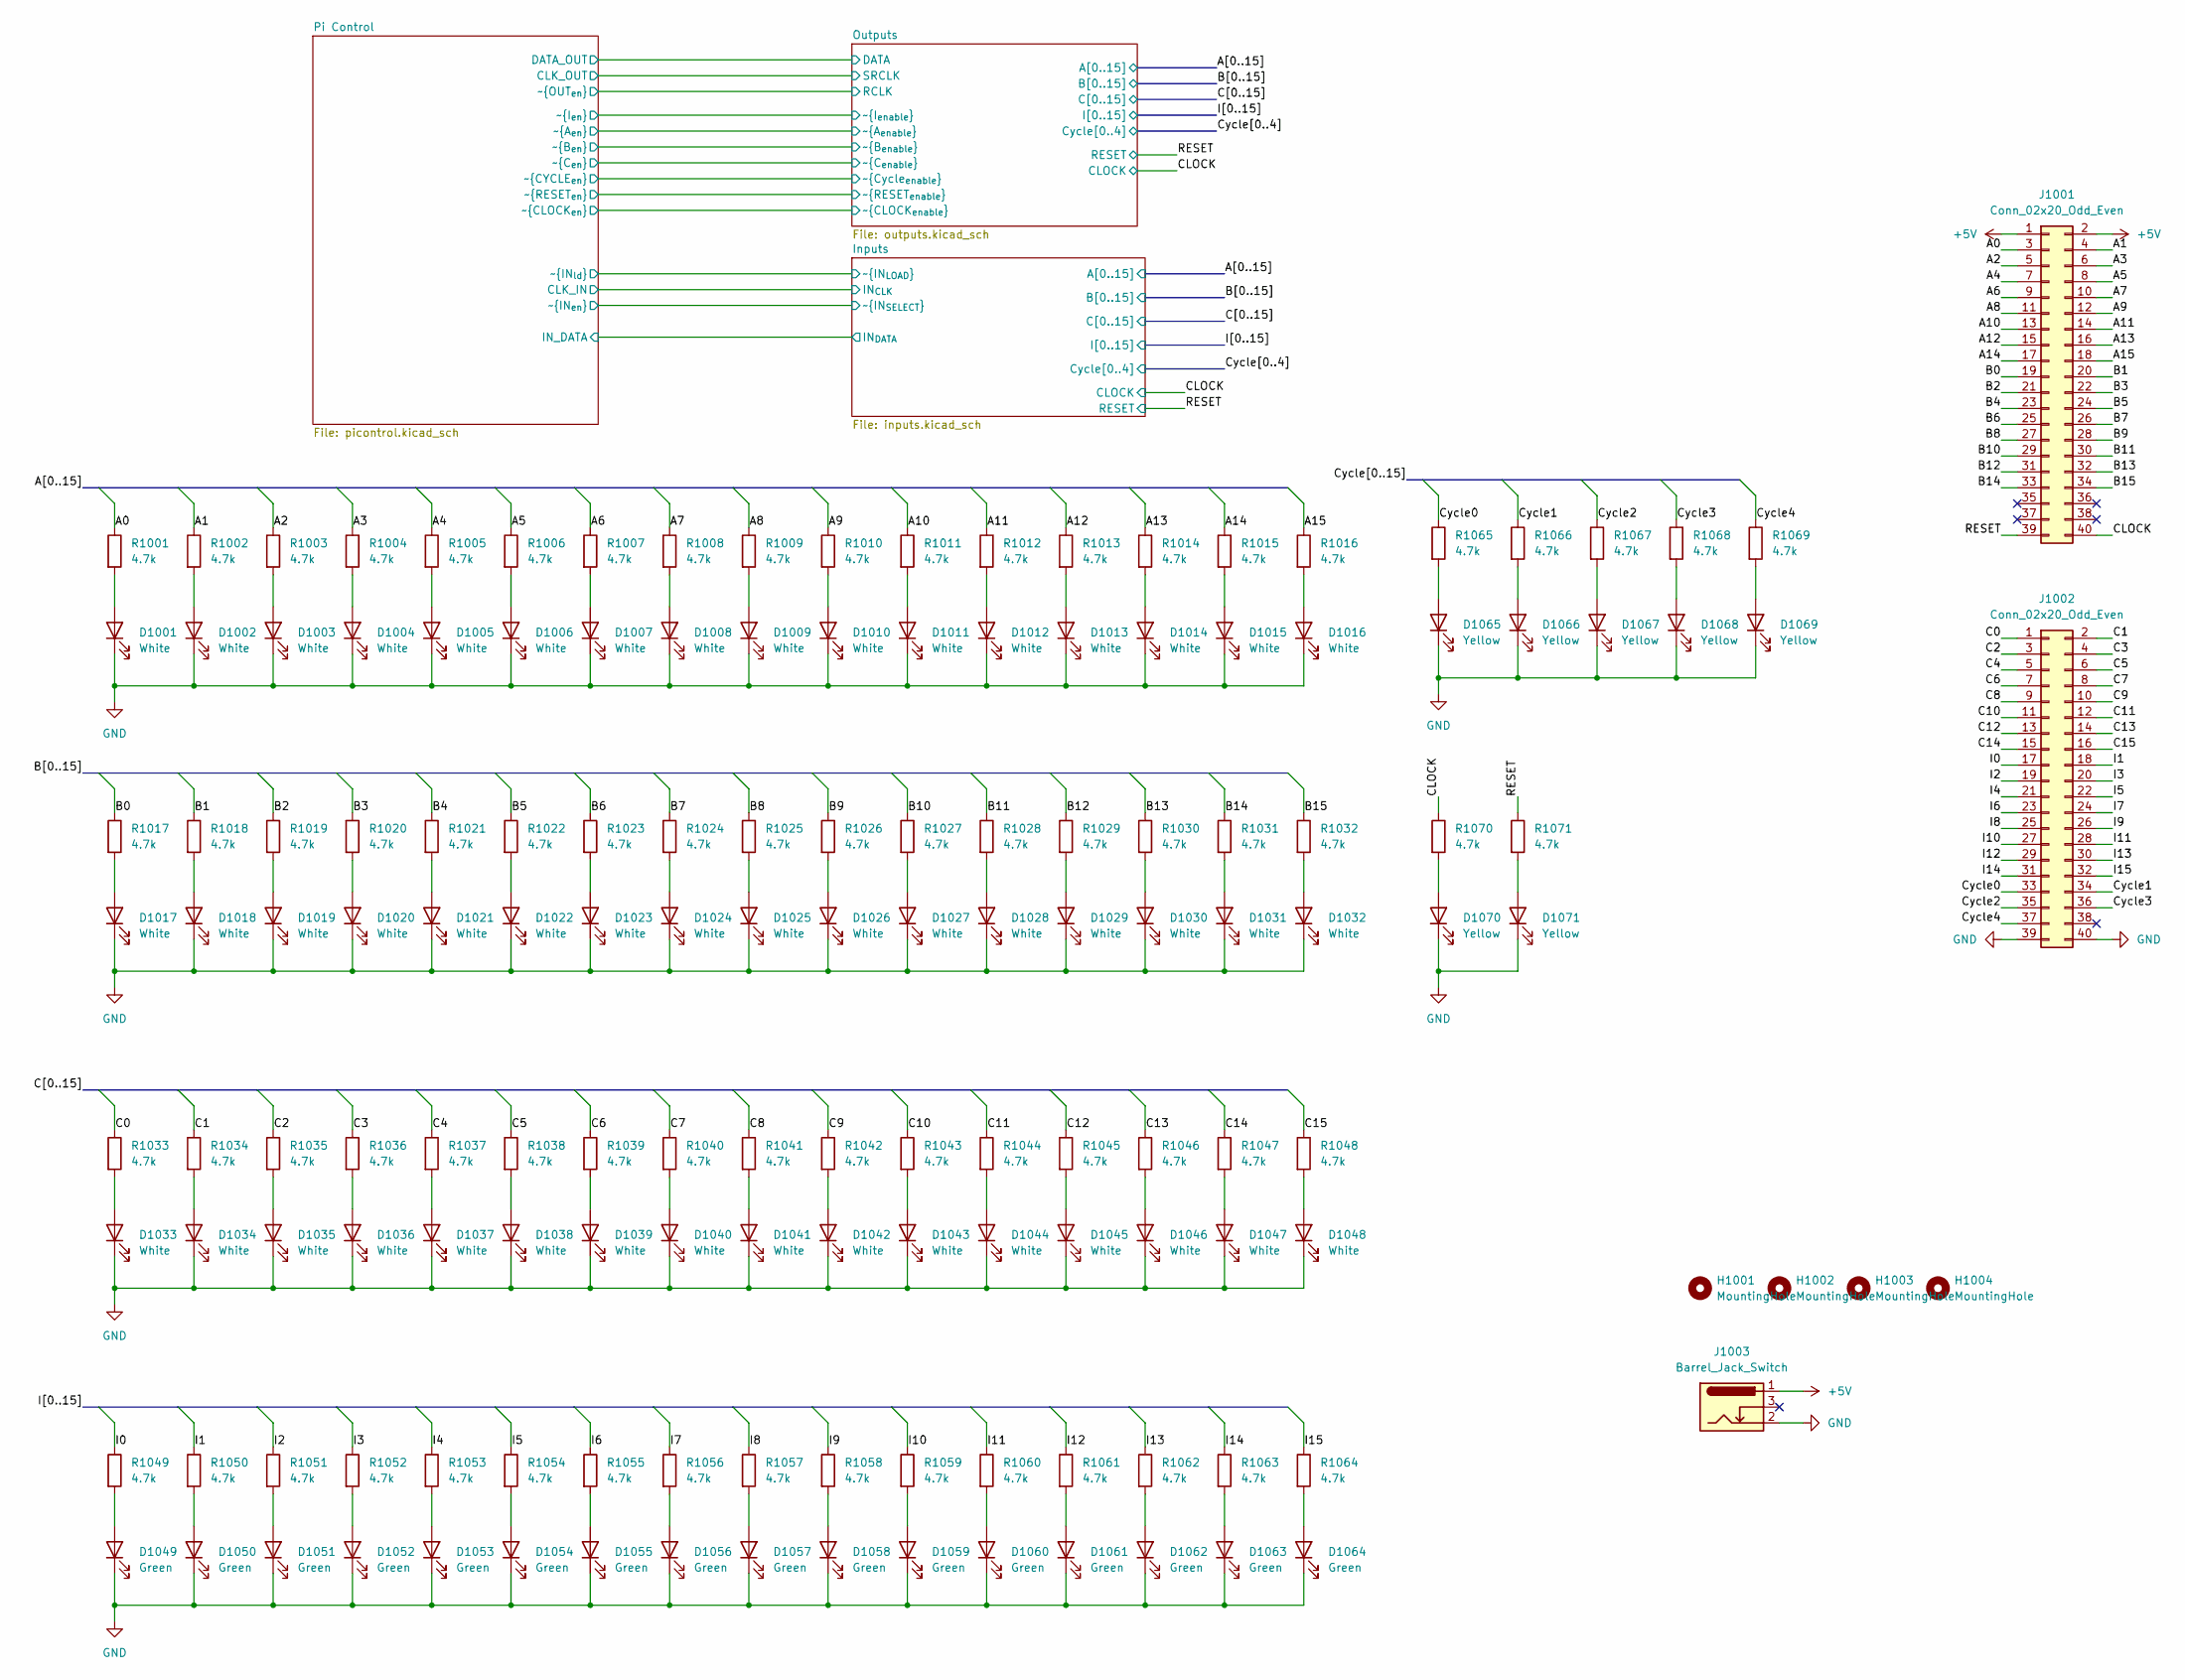
[picture p27: schematic Pi Backplane Connector.kicad_sch]

Parts:
D1001, D1002, D1003, D1004, D1005, D1006, D1007, D1008, D1009, D1010, D1011, D1012, D1013, D1014, D1015, D1016, D1017, D1018, D1019, D1020, D1021, D1022, D1023, D1024, D1025, D1026, D1027, D1028, D1029, D1030, D1031, D1032, D1033, D1034, D1035, D1036, D1037, D1038, D1039, D1040, D1041, D1042, D1043, D1044, D1045, D1046, D1047, D1048: White; LED_0603_1608Metric; LCSC C2290
D1049, D1050, D1051, D1052, D1053, D1054, D1055, D1056, D1057, D1058, D1059, D1060, D1061, D1062, D1063, D1064: Green; LED_0603_1608Metric; LCSC C72043
D1065, D1066, D1067, D1068, D1069, D1070, D1071: Yellow; LED_0603_1608Metric; LCSC C72038
H1001, H1002, H1003, H1004: MountingHole; MountingHole_2.7mm_M2.5_ISO7380
J1001, J1002: Conn_02x20_Odd_Even; PinHeader_2x20_P2.54mm_Vertical
J1003: Barrel_Jack_Switch; BarrelJack_Horizontal
R1001, R1002, R1003, R1004, R1005, R1006, R1007, R1008, R1009, R1010, R1011, R1012, R1013, R1014, R1015, R1016, R1017, R1018, R1019, R1020, R1021, R1022, R1023, R1024, R1025, R1026, R1027, R1028, R1029, R1030, R1031, R1032, R1033, R1034, R1035, R1036, R1037, R1038, R1039, R1040, R1041, R1042, R1043, R1044, R1045, R1046, R1047, R1048, R1049, R1050, R1051, R1052, R1053, R1054, R1055, R1056, R1057, R1058, R1059, R1060, R1061, R1062, R1063, R1064, R1065, R1066, R1067, R1068, R1069, R1070, R1071: 4.7k; R_0603_1608Metric; LCSC C23162

Connections:
+5V: J1001.1, J1001.2, J1003.1; also elsewhere on the board
/A0: J1001.3, R1001.1; also elsewhere on the board
/A1: J1001.4, R1002.1; also elsewhere on the board
/A2: J1001.5, R1003.1; also elsewhere on the board
/A3: J1001.6, R1004.1; also elsewhere on the board
/A4: J1001.7, R1005.1; also elsewhere on the board
/A5: J1001.8, R1006.1; also elsewhere on the board
/A6: J1001.9, R1007.1; also elsewhere on the board
/A7: J1001.10, R1008.1; also elsewhere on the board
/A8: J1001.11, R1009.1; also elsewhere on the board
/A9: J1001.12, R1010.1; also elsewhere on the board
/A10: J1001.13, R1011.1; also elsewhere on the board
/A11: J1001.14, R1012.1; also elsewhere on the board
/A12: J1001.15, R1013.1; also elsewhere on the board
/A13: J1001.16, R1014.1; also elsewhere on the board
/A14: J1001.17, R1015.1; also elsewhere on the board
/A15: J1001.18, R1016.1; also elsewhere on the board
/B0: J1001.19, R1017.1; also elsewhere on the board
/B1: J1001.20, R1018.1; also elsewhere on the board
/B2: J1001.21, R1019.1; also elsewhere on the board
/B3: J1001.22, R1020.1; also elsewhere on the board
/B4: J1001.23, R1021.1; also elsewhere on the board
/B5: J1001.24, R1022.1; also elsewhere on the board
/B6: J1001.25, R1023.1; also elsewhere on the board
/B7: J1001.26, R1024.1; also elsewhere on the board
/B8: J1001.27, R1025.1; also elsewhere on the board
/B9: J1001.28, R1026.1; also elsewhere on the board
/B10: J1001.29, R1027.1; also elsewhere on the board
/B11: J1001.30, R1028.1; also elsewhere on the board
/B12: J1001.31, R1029.1; also elsewhere on the board
/B13: J1001.32, R1030.1; also elsewhere on the board
/B14: J1001.33, R1031.1; also elsewhere on the board
/B15: J1001.34, R1032.1; also elsewhere on the board
/C0: J1002.1, R1033.1; also elsewhere on the board
/C1: J1002.2, R1034.1; also elsewhere on the board
/C2: J1002.3, R1035.1; also elsewhere on the board
/C3: J1002.4, R1036.1; also elsewhere on the board
/C4: J1002.5, R1037.1; also elsewhere on the board
/C5: J1002.6, R1038.1; also elsewhere on the board
/C6: J1002.7, R1039.1; also elsewhere on the board
/C7: J1002.8, R1040.1; also elsewhere on the board
/C8: J1002.9, R1041.1; also elsewhere on the board
/C9: J1002.10, R1042.1; also elsewhere on the board
/C10: J1002.11, R1043.1; also elsewhere on the board
/C11: J1002.12, R1044.1; also elsewhere on the board
/C12: J1002.13, R1045.1; also elsewhere on the board
/C13: J1002.14, R1046.1; also elsewhere on the board
/C14: J1002.15, R1047.1; also elsewhere on the board
/C15: J1002.16, R1048.1; also elsewhere on the board
/CLOCK: J1001.40, R1070.1; also elsewhere on the board
/Cycle0: J1002.33, R1065.1; also elsewhere on the board
/Cycle1: J1002.34, R1066.1; also elsewhere on the board
/Cycle2: J1002.35, R1067.1; also elsewhere on the board
/Cycle3: J1002.36, R1068.1; also elsewhere on the board
/Cycle4: J1002.37, R1069.1; also elsewhere on the board
/I0: J1002.17, R1049.1; also elsewhere on the board
/I1: J1002.18, R1050.1; also elsewhere on the board
/I2: J1002.19, R1051.1; also elsewhere on the board
/I3: J1002.20, R1052.1; also elsewhere on the board
/I4: J1002.21, R1053.1; also elsewhere on the board
/I5: J1002.22, R1054.1; also elsewhere on the board
/I6: J1002.23, R1055.1; also elsewhere on the board
/I7: J1002.24, R1056.1; also elsewhere on the board
/I8: J1002.25, R1057.1; also elsewhere on the board
/I9: J1002.26, R1058.1; also elsewhere on the board
/I10: J1002.27, R1059.1; also elsewhere on the board
/I11: J1002.28, R1060.1; also elsewhere on the board
/I12: J1002.29, R1061.1; also elsewhere on the board
/I13: J1002.30, R1062.1; also elsewhere on the board
/I14: J1002.31, R1063.1; also elsewhere on the board
/I15: J1002.32, R1064.1; also elsewhere on the board
/RESET: J1001.39, R1071.1; also elsewhere on the board
GND: D1001.1 (K), D1002.1 (K), D1003.1 (K), D1004.1 (K), D1005.1 (K), D1006.1 (K), D1007.1 (K), D1008.1 (K), D1009.1 (K), D1010.1 (K), D1011.1 (K), D1012.1 (K), D1013.1 (K), D1014.1 (K), D1015.1 (K), D1016.1 (K), D1017.1 (K), D1018.1 (K), D1019.1 (K), D1020.1 (K), D1021.1 (K), D1022.1 (K), D1023.1 (K), D1024.1 (K), D1025.1 (K), D1026.1 (K), D1027.1 (K), D1028.1 (K), D1029.1 (K), D1030.1 (K), D1031.1 (K), D1032.1 (K), D1033.1 (K), D1034.1 (K), D1035.1 (K), D1036.1 (K), D1037.1 (K), D1038.1 (K), D1039.1 (K), D1040.1 (K), D1041.1 (K), D1042.1 (K), D1043.1 (K), D1044.1 (K), D1045.1 (K), D1046.1 (K), D1047.1 (K), D1048.1 (K), D1049.1 (K), D1050.1 (K), D1051.1 (K), D1052.1 (K), D1053.1 (K), D1054.1 (K), D1055.1 (K), D1056.1 (K), D1057.1 (K), D1058.1 (K), D1059.1 (K), D1060.1 (K), D1061.1 (K), D1062.1 (K), D1063.1 (K), D1064.1 (K), D1065.1 (K), D1066.1 (K), D1067.1 (K), D1068.1 (K), D1069.1 (K), D1070.1 (K), D1071.1 (K), J1002.39, J1002.40, J1003.2; also elsewhere on the board
unnamed: D1001.2 (A), R1001.2
unnamed: D1002.2 (A), R1002.2
unnamed: D1003.2 (A), R1003.2
unnamed: D1004.2 (A), R1004.2
unnamed: D1005.2 (A), R1005.2
unnamed: D1006.2 (A), R1006.2
unnamed: D1007.2 (A), R1007.2
unnamed: D1008.2 (A), R1008.2
unnamed: D1009.2 (A), R1009.2
unnamed: D1010.2 (A), R1010.2
unnamed: D1011.2 (A), R1011.2
unnamed: D1012.2 (A), R1012.2
unnamed: D1013.2 (A), R1013.2
unnamed: D1014.2 (A), R1014.2
unnamed: D1015.2 (A), R1015.2
unnamed: D1016.2 (A), R1016.2
unnamed: D1017.2 (A), R1017.2
unnamed: D1018.2 (A), R1018.2
unnamed: D1019.2 (A), R1019.2
unnamed: D1020.2 (A), R1020.2
unnamed: D1021.2 (A), R1021.2
unnamed: D1022.2 (A), R1022.2
unnamed: D1023.2 (A), R1023.2
unnamed: D1024.2 (A), R1024.2
unnamed: D1025.2 (A), R1025.2
unnamed: D1026.2 (A), R1026.2
unnamed: D1027.2 (A), R1027.2
unnamed: D1028.2 (A), R1028.2
unnamed: D1029.2 (A), R1029.2
unnamed: D1030.2 (A), R1030.2
unnamed: D1031.2 (A), R1031.2
unnamed: D1032.2 (A), R1032.2
unnamed: D1033.2 (A), R1033.2
unnamed: D1034.2 (A), R1034.2
unnamed: D1035.2 (A), R1035.2
unnamed: D1036.2 (A), R1036.2
unnamed: D1037.2 (A), R1037.2
unnamed: D1038.2 (A), R1038.2
unnamed: D1039.2 (A), R1039.2
unnamed: D1040.2 (A), R1040.2
unnamed: D1041.2 (A), R1041.2
unnamed: D1042.2 (A), R1042.2
unnamed: D1043.2 (A), R1043.2
unnamed: D1044.2 (A), R1044.2
unnamed: D1045.2 (A), R1045.2
unnamed: D1046.2 (A), R1046.2
unnamed: D1047.2 (A), R1047.2
unnamed: D1048.2 (A), R1048.2
unnamed: D1049.2 (A), R1049.2
unnamed: D1050.2 (A), R1050.2
unnamed: D1051.2 (A), R1051.2
unnamed: D1052.2 (A), R1052.2
unnamed: D1053.2 (A), R1053.2
unnamed: D1054.2 (A), R1054.2
unnamed: D1055.2 (A), R1055.2
unnamed: D1056.2 (A), R1056.2
unnamed: D1057.2 (A), R1057.2
unnamed: D1058.2 (A), R1058.2
unnamed: D1059.2 (A), R1059.2
unnamed: D1060.2 (A), R1060.2
unnamed: D1061.2 (A), R1061.2
unnamed: D1062.2 (A), R1062.2
unnamed: D1063.2 (A), R1063.2
unnamed: D1064.2 (A), R1064.2
unnamed: D1065.2 (A), R1065.2
unnamed: D1066.2 (A), R1066.2
unnamed: D1067.2 (A), R1067.2
unnamed: D1068.2 (A), R1068.2
unnamed: D1069.2 (A), R1069.2
unnamed: D1070.2 (A), R1070.2
unnamed: D1071.2 (A), R1071.2

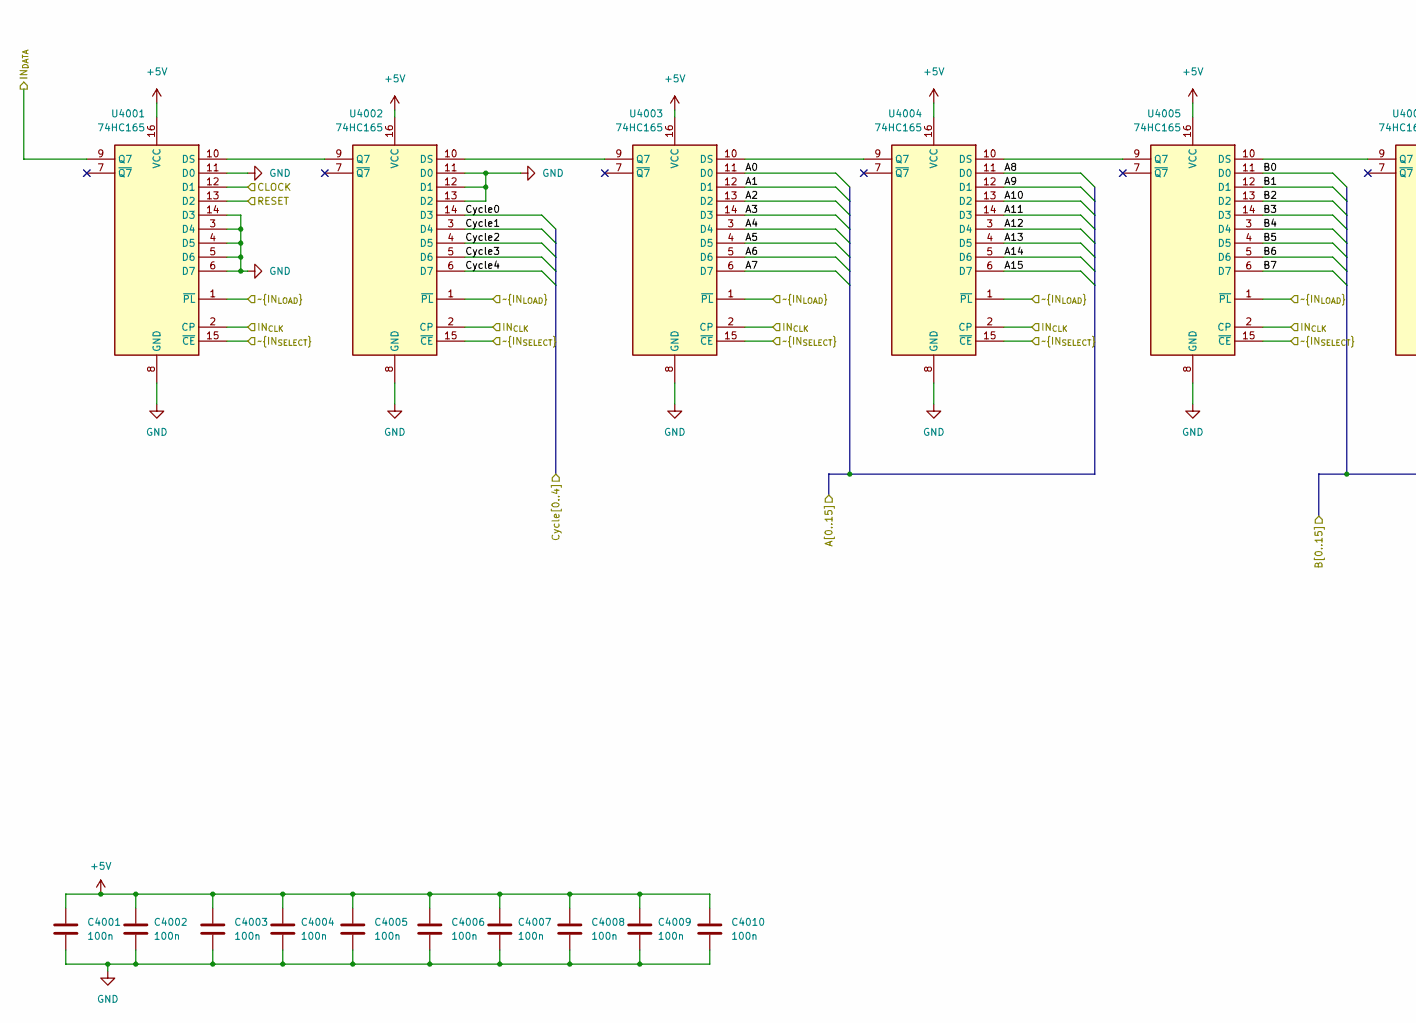
[picture p28: schematic inputs.kicad_sch, part in row 1, column 1]

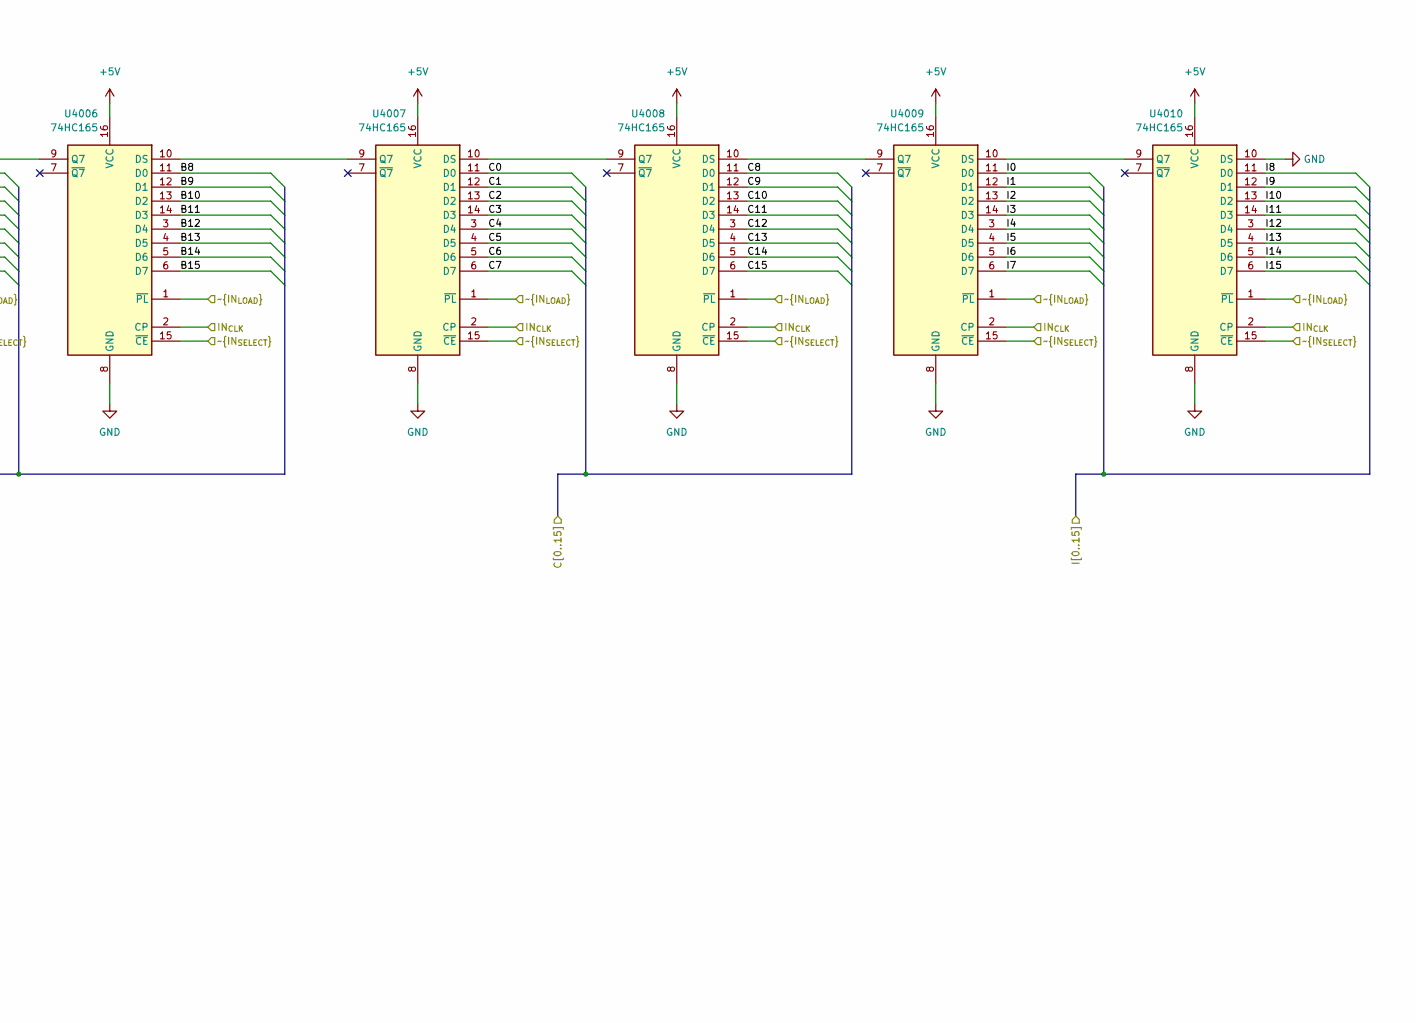
[picture p29: schematic inputs.kicad_sch, part in row 1, column 2]

Parts:
C4001, C4002, C4003, C4004, C4005, C4006, C4007, C4008, C4009, C4010: 100n; C_0603_1608Metric; LCSC C14663
U4001, U4002, U4003, U4004, U4005, U4006, U4007, U4008, U4009, U4010: 74HC165; SOIC-16_3.9x9.9mm_P1.27mm; LCSC C5613

Connections:
+5V: C4001.2, C4002.2, C4003.2, C4004.2, C4005.2, C4006.2, C4007.2, C4008.2, C4009.2, C4010.2, U4001.16 (VCC), U4002.16 (VCC), U4003.16 (VCC), U4004.16 (VCC), U4005.16 (VCC), U4006.16 (VCC), U4007.16 (VCC), U4008.16 (VCC), U4009.16 (VCC), U4010.16 (VCC); also elsewhere on the board
/A0: U4003.11 (D0); also elsewhere on the board
/A1: U4003.12 (D1); also elsewhere on the board
/A2: U4003.13 (D2); also elsewhere on the board
/A3: U4003.14 (D3); also elsewhere on the board
/A4: U4003.3 (D4); also elsewhere on the board
/A5: U4003.4 (D5); also elsewhere on the board
/A6: U4003.5 (D6); also elsewhere on the board
/A7: U4003.6 (D7); also elsewhere on the board
/A8: U4004.11 (D0); also elsewhere on the board
/A9: U4004.12 (D1); also elsewhere on the board
/A10: U4004.13 (D2); also elsewhere on the board
/A11: U4004.14 (D3); also elsewhere on the board
/A12: U4004.3 (D4); also elsewhere on the board
/A13: U4004.4 (D5); also elsewhere on the board
/A14: U4004.5 (D6); also elsewhere on the board
/A15: U4004.6 (D7); also elsewhere on the board
/B0: U4005.11 (D0); also elsewhere on the board
/B1: U4005.12 (D1); also elsewhere on the board
/B2: U4005.13 (D2); also elsewhere on the board
/B3: U4005.14 (D3); also elsewhere on the board
/B4: U4005.3 (D4); also elsewhere on the board
/B5: U4005.4 (D5); also elsewhere on the board
/B6: U4005.5 (D6); also elsewhere on the board
/B7: U4005.6 (D7); also elsewhere on the board
/B8: U4006.11 (D0); also elsewhere on the board
/B9: U4006.12 (D1); also elsewhere on the board
/B10: U4006.13 (D2); also elsewhere on the board
/B11: U4006.14 (D3); also elsewhere on the board
/B12: U4006.3 (D4); also elsewhere on the board
/B13: U4006.4 (D5); also elsewhere on the board
/B14: U4006.5 (D6); also elsewhere on the board
/B15: U4006.6 (D7); also elsewhere on the board
/C0: U4007.11 (D0); also elsewhere on the board
/C1: U4007.12 (D1); also elsewhere on the board
/C2: U4007.13 (D2); also elsewhere on the board
/C3: U4007.14 (D3); also elsewhere on the board
/C4: U4007.3 (D4); also elsewhere on the board
/C5: U4007.4 (D5); also elsewhere on the board
/C6: U4007.5 (D6); also elsewhere on the board
/C7: U4007.6 (D7); also elsewhere on the board
/C8: U4008.11 (D0); also elsewhere on the board
/C9: U4008.12 (D1); also elsewhere on the board
/C10: U4008.13 (D2); also elsewhere on the board
/C11: U4008.14 (D3); also elsewhere on the board
/C12: U4008.3 (D4); also elsewhere on the board
/C13: U4008.4 (D5); also elsewhere on the board
/C14: U4008.5 (D6); also elsewhere on the board
/C15: U4008.6 (D7); also elsewhere on the board
/CLOCK: U4001.12 (D1); also elsewhere on the board
/Cycle0: U4002.14 (D3); also elsewhere on the board
/Cycle1: U4002.3 (D4); also elsewhere on the board
/Cycle2: U4002.4 (D5); also elsewhere on the board
/Cycle3: U4002.5 (D6); also elsewhere on the board
/Cycle4: U4002.6 (D7); also elsewhere on the board
/I0: U4009.11 (D0); also elsewhere on the board
/I1: U4009.12 (D1); also elsewhere on the board
/I2: U4009.13 (D2); also elsewhere on the board
/I3: U4009.14 (D3); also elsewhere on the board
/I4: U4009.3 (D4); also elsewhere on the board
/I5: U4009.4 (D5); also elsewhere on the board
/I6: U4009.5 (D6); also elsewhere on the board
/I7: U4009.6 (D7); also elsewhere on the board
/I8: U4010.11 (D0); also elsewhere on the board
/I9: U4010.12 (D1); also elsewhere on the board
/I10: U4010.13 (D2); also elsewhere on the board
/I11: U4010.14 (D3); also elsewhere on the board
/I12: U4010.3 (D4); also elsewhere on the board
/I13: U4010.4 (D5); also elsewhere on the board
/I14: U4010.5 (D6); also elsewhere on the board
/I15: U4010.6 (D7); also elsewhere on the board
/Inputs/IN_{CLK}: U4001.2 (CP), U4002.2 (CP), U4003.2 (CP), U4004.2 (CP), U4005.2 (CP), U4006.2 (CP), U4007.2 (CP), U4008.2 (CP), U4009.2 (CP), U4010.2 (CP); also elsewhere on the board
/Inputs/IN_{DATA}: U4001.9 (Q7); also elsewhere on the board
/Inputs/~IN_{LOAD}: U4001.1 (~PL), U4002.1 (~PL), U4003.1 (~PL), U4004.1 (~PL), U4005.1 (~PL), U4006.1 (~PL), U4007.1 (~PL), U4008.1 (~PL), U4009.1 (~PL), U4010.1 (~PL); also elsewhere on the board
/Inputs/~IN_{SELECT}: U4001.15 (~CE), U4002.15 (~CE), U4003.15 (~CE), U4004.15 (~CE), U4005.15 (~CE), U4006.15 (~CE), U4007.15 (~CE), U4008.15 (~CE), U4009.15 (~CE), U4010.15 (~CE); also elsewhere on the board
/RESET: U4001.13 (D2); also elsewhere on the board
GND: C4001.1, C4002.1, C4003.1, C4004.1, C4005.1, C4006.1, C4007.1, C4008.1, C4009.1, C4010.1, U4001.3 (D4), U4001.4 (D5), U4001.5 (D6), U4001.6 (D7), U4001.8 (GND), U4001.11 (D0), U4001.14 (D3), U4002.8 (GND), U4002.11 (D0), U4002.12 (D1), U4002.13 (D2), U4003.8 (GND), U4004.8 (GND), U4005.8 (GND), U4006.8 (GND), U4007.8 (GND), U4008.8 (GND), U4009.8 (GND), U4010.8 (GND), U4010.10 (DS); also elsewhere on the board
unnamed: U4001.10 (DS), U4002.9 (Q7)
unnamed: U4002.10 (DS), U4003.9 (Q7)
unnamed: U4003.10 (DS), U4004.9 (Q7)
unnamed: U4004.10 (DS), U4005.9 (Q7)
unnamed: U4005.10 (DS), U4006.9 (Q7)
unnamed: U4006.10 (DS), U4007.9 (Q7)
unnamed: U4007.10 (DS), U4008.9 (Q7)
unnamed: U4008.10 (DS), U4009.9 (Q7)
unnamed: U4009.10 (DS), U4010.9 (Q7)
