freesurfer-rge/slothpu16/pcbs/Pi Backplane Connector/Pi Backplane Connector.kicad_pcb

## KiCad design pcbs/Pi Backplane Connector/Pi Backplane Connector.kicad_pcb (continued)

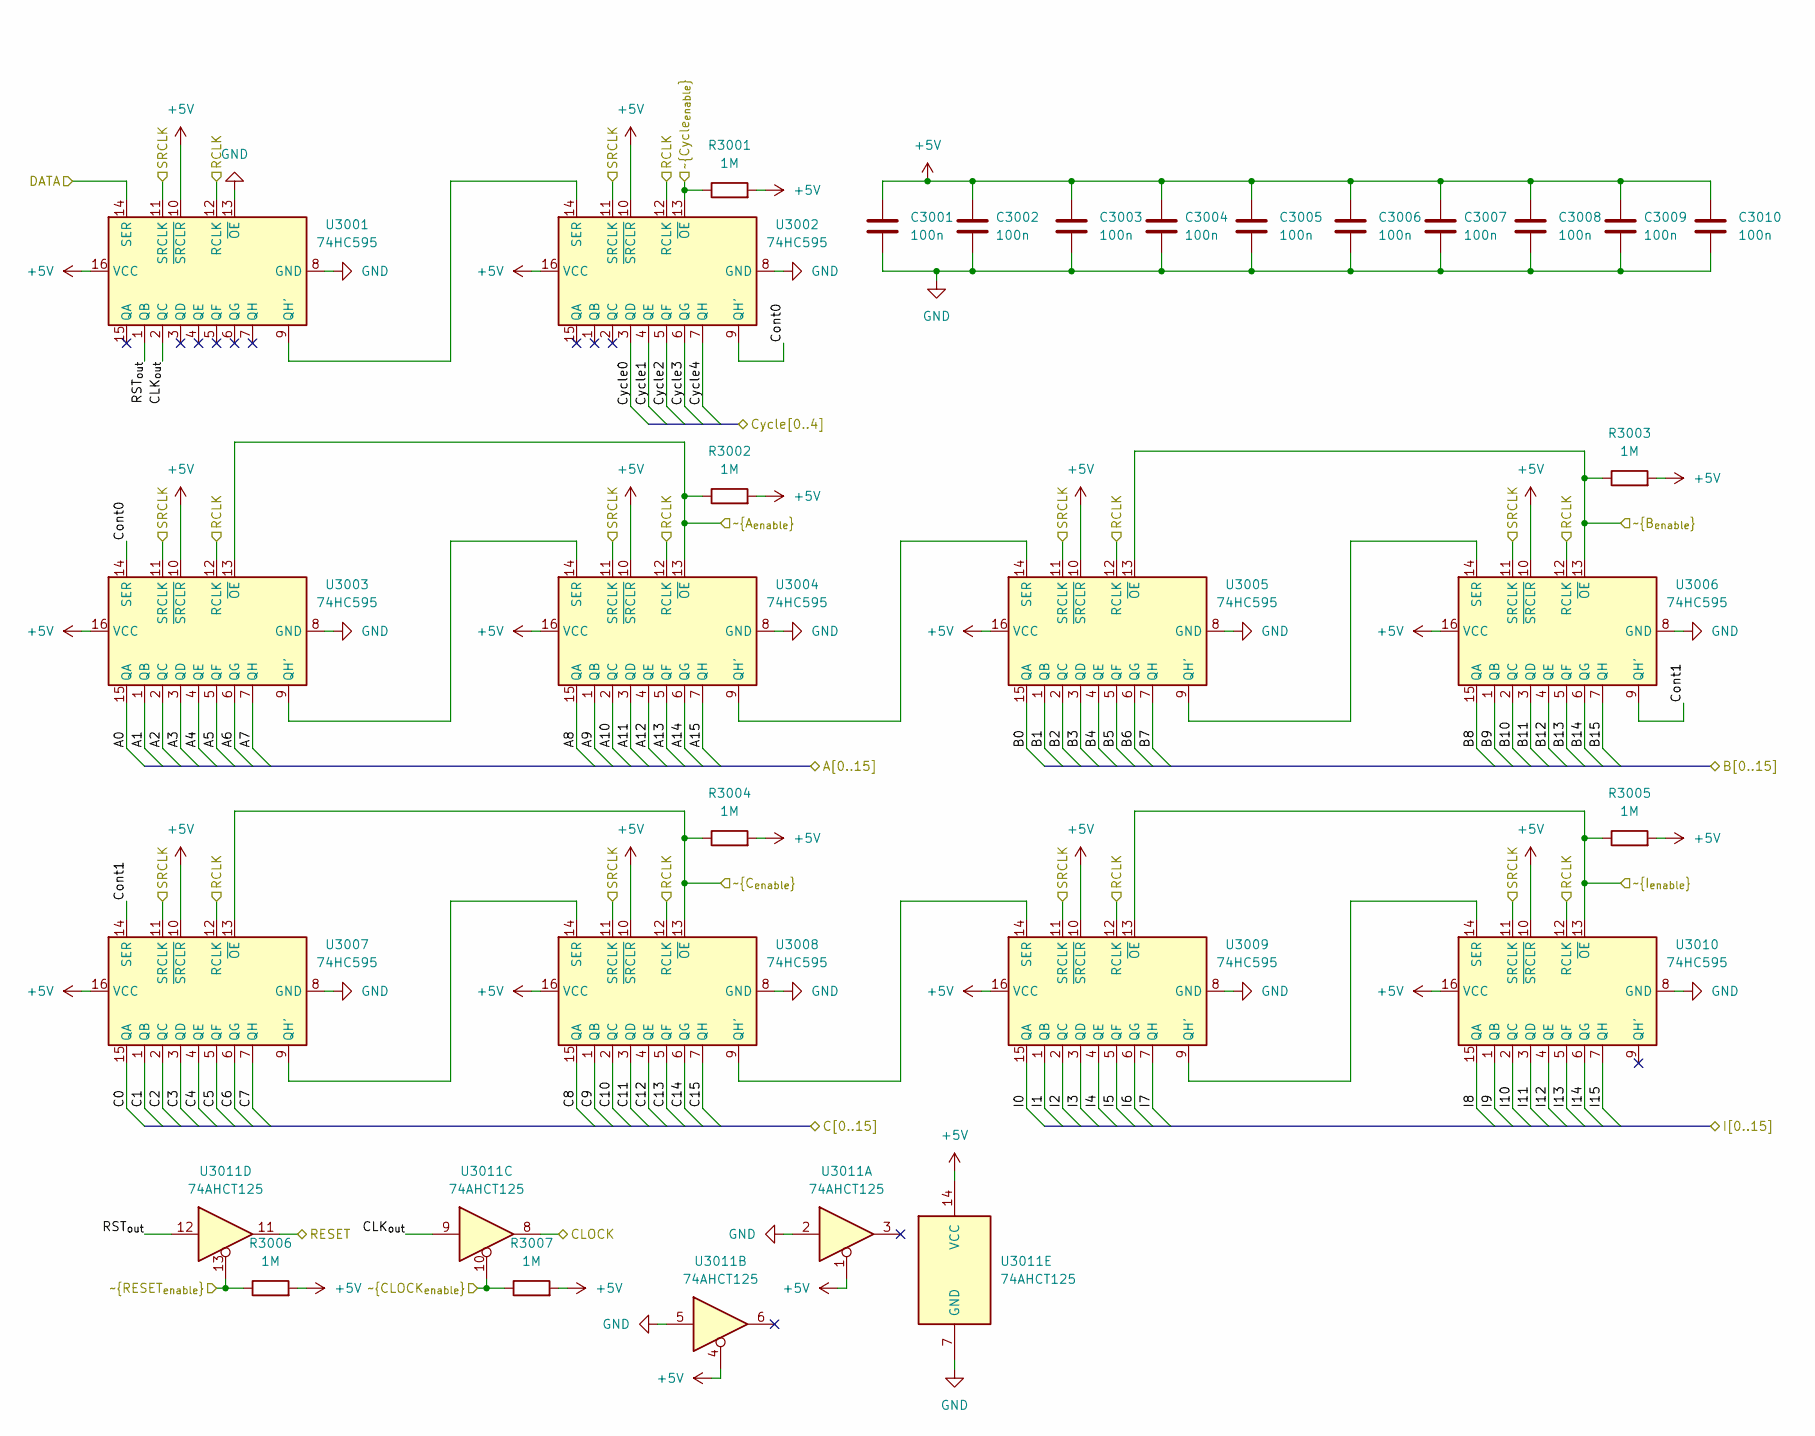
[picture p30: schematic outputs.kicad_sch]

Parts:
C3001, C3002, C3003, C3004, C3005, C3006, C3007, C3008, C3009, C3010: 100n; C_0603_1608Metric; LCSC C14663
R3001, R3002, R3003, R3004, R3005, R3006, R3007: 1M; R_0603_1608Metric; LCSC C22935
U3001, U3002, U3003, U3004, U3005, U3006, U3007, U3008, U3009, U3010: 74HC595; SO-16_3.9x9.9mm_P1.27mm; LCSC C5947
U3011: 74AHCT125; DIP-14_W7.62mm_Socket

Connections:
+5V: C3001.2, C3002.2, C3003.2, C3004.2, C3005.2, C3006.2, C3007.2, C3008.2, C3009.2, C3010.2, R3001.2, R3002.2, R3003.2, R3004.2, R3005.2, R3006.2, R3007.2, U3001.10 (~SRCLR), U3001.16 (VCC), U3002.10 (~SRCLR), U3002.16 (VCC), U3003.10 (~SRCLR), U3003.16 (VCC), U3004.10 (~SRCLR), U3004.16 (VCC), U3005.10 (~SRCLR), U3005.16 (VCC), U3006.10 (~SRCLR), U3006.16 (VCC), U3007.10 (~SRCLR), U3007.16 (VCC), U3008.10 (~SRCLR), U3008.16 (VCC), U3009.10 (~SRCLR), U3009.16 (VCC), U3010.10 (~SRCLR), U3010.16 (VCC), U3011.1, U3011.4, U3011.14 (VCC); also elsewhere on the board
/A0: U3003.15 (QA); also elsewhere on the board
/A1: U3003.1 (QB); also elsewhere on the board
/A2: U3003.2 (QC); also elsewhere on the board
/A3: U3003.3 (QD); also elsewhere on the board
/A4: U3003.4 (QE); also elsewhere on the board
/A5: U3003.5 (QF); also elsewhere on the board
/A6: U3003.6 (QG); also elsewhere on the board
/A7: U3003.7 (QH); also elsewhere on the board
/A8: U3004.15 (QA); also elsewhere on the board
/A9: U3004.1 (QB); also elsewhere on the board
/A10: U3004.2 (QC); also elsewhere on the board
/A11: U3004.3 (QD); also elsewhere on the board
/A12: U3004.4 (QE); also elsewhere on the board
/A13: U3004.5 (QF); also elsewhere on the board
/A14: U3004.6 (QG); also elsewhere on the board
/A15: U3004.7 (QH); also elsewhere on the board
/B0: U3005.15 (QA); also elsewhere on the board
/B1: U3005.1 (QB); also elsewhere on the board
/B2: U3005.2 (QC); also elsewhere on the board
/B3: U3005.3 (QD); also elsewhere on the board
/B4: U3005.4 (QE); also elsewhere on the board
/B5: U3005.5 (QF); also elsewhere on the board
/B6: U3005.6 (QG); also elsewhere on the board
/B7: U3005.7 (QH); also elsewhere on the board
/B8: U3006.15 (QA); also elsewhere on the board
/B9: U3006.1 (QB); also elsewhere on the board
/B10: U3006.2 (QC); also elsewhere on the board
/B11: U3006.3 (QD); also elsewhere on the board
/B12: U3006.4 (QE); also elsewhere on the board
/B13: U3006.5 (QF); also elsewhere on the board
/B14: U3006.6 (QG); also elsewhere on the board
/B15: U3006.7 (QH); also elsewhere on the board
/C0: U3007.15 (QA); also elsewhere on the board
/C1: U3007.1 (QB); also elsewhere on the board
/C2: U3007.2 (QC); also elsewhere on the board
/C3: U3007.3 (QD); also elsewhere on the board
/C4: U3007.4 (QE); also elsewhere on the board
/C5: U3007.5 (QF); also elsewhere on the board
/C6: U3007.6 (QG); also elsewhere on the board
/C7: U3007.7 (QH); also elsewhere on the board
/C8: U3008.15 (QA); also elsewhere on the board
/C9: U3008.1 (QB); also elsewhere on the board
/C10: U3008.2 (QC); also elsewhere on the board
/C11: U3008.3 (QD); also elsewhere on the board
/C12: U3008.4 (QE); also elsewhere on the board
/C13: U3008.5 (QF); also elsewhere on the board
/C14: U3008.6 (QG); also elsewhere on the board
/C15: U3008.7 (QH); also elsewhere on the board
/CLOCK: U3011.8; also elsewhere on the board
/Cycle0: U3002.3 (QD); also elsewhere on the board
/Cycle1: U3002.4 (QE); also elsewhere on the board
/Cycle2: U3002.5 (QF); also elsewhere on the board
/Cycle3: U3002.6 (QG); also elsewhere on the board
/Cycle4: U3002.7 (QH); also elsewhere on the board
/I0: U3009.15 (QA); also elsewhere on the board
/I1: U3009.1 (QB); also elsewhere on the board
/I2: U3009.2 (QC); also elsewhere on the board
/I3: U3009.3 (QD); also elsewhere on the board
/I4: U3009.4 (QE); also elsewhere on the board
/I5: U3009.5 (QF); also elsewhere on the board
/I6: U3009.6 (QG); also elsewhere on the board
/I7: U3009.7 (QH); also elsewhere on the board
/I8: U3010.15 (QA); also elsewhere on the board
/I9: U3010.1 (QB); also elsewhere on the board
/I10: U3010.2 (QC); also elsewhere on the board
/I11: U3010.3 (QD); also elsewhere on the board
/I12: U3010.4 (QE); also elsewhere on the board
/I13: U3010.5 (QF); also elsewhere on the board
/I14: U3010.6 (QG); also elsewhere on the board
/I15: U3010.7 (QH); also elsewhere on the board
/Outputs/CLK_{out}: U3001.2 (QC), U3011.9
/Outputs/Cont0: U3002.9 (QH'), U3003.14 (SER)
/Outputs/Cont1: U3006.9 (QH'), U3007.14 (SER)
/Outputs/DATA: U3001.14 (SER); also elsewhere on the board
/Outputs/RCLK: U3001.12 (RCLK), U3002.12 (RCLK), U3003.12 (RCLK), U3004.12 (RCLK), U3005.12 (RCLK), U3006.12 (RCLK), U3007.12 (RCLK), U3008.12 (RCLK), U3009.12 (RCLK), U3010.12 (RCLK); also elsewhere on the board
/Outputs/RST_{out}: U3001.1 (QB), U3011.12
/Outputs/SRCLK: U3001.11 (SRCLK), U3002.11 (SRCLK), U3003.11 (SRCLK), U3004.11 (SRCLK), U3005.11 (SRCLK), U3006.11 (SRCLK), U3007.11 (SRCLK), U3008.11 (SRCLK), U3009.11 (SRCLK), U3010.11 (SRCLK); also elsewhere on the board
/Outputs/~A_{enable}: R3002.1, U3003.13 (~OE), U3004.13 (~OE); also elsewhere on the board
/Outputs/~B_{enable}: R3003.1, U3005.13 (~OE), U3006.13 (~OE); also elsewhere on the board
/Outputs/~CLOCK_{enable}: R3007.1, U3011.10; also elsewhere on the board
/Outputs/~C_{enable}: R3004.1, U3007.13 (~OE), U3008.13 (~OE); also elsewhere on the board
/Outputs/~Cycle_{enable}: R3001.1, U3002.13 (~OE); also elsewhere on the board
/Outputs/~I_{enable}: R3005.1, U3009.13 (~OE), U3010.13 (~OE); also elsewhere on the board
/Outputs/~RESET_{enable}: R3006.1, U3011.13; also elsewhere on the board
/RESET: U3011.11; also elsewhere on the board
GND: C3001.1, C3002.1, C3003.1, C3004.1, C3005.1, C3006.1, C3007.1, C3008.1, C3009.1, C3010.1, U3001.8 (GND), U3001.13 (~OE), U3002.8 (GND), U3003.8 (GND), U3004.8 (GND), U3005.8 (GND), U3006.8 (GND), U3007.8 (GND), U3008.8 (GND), U3009.8 (GND), U3010.8 (GND), U3011.2, U3011.5, U3011.7 (GND); also elsewhere on the board
unnamed: U3001.9 (QH'), U3002.14 (SER)
unnamed: U3003.9 (QH'), U3004.14 (SER)
unnamed: U3004.9 (QH'), U3005.14 (SER)
unnamed: U3005.9 (QH'), U3006.14 (SER)
unnamed: U3007.9 (QH'), U3008.14 (SER)
unnamed: U3008.9 (QH'), U3009.14 (SER)
unnamed: U3009.9 (QH'), U3010.14 (SER)

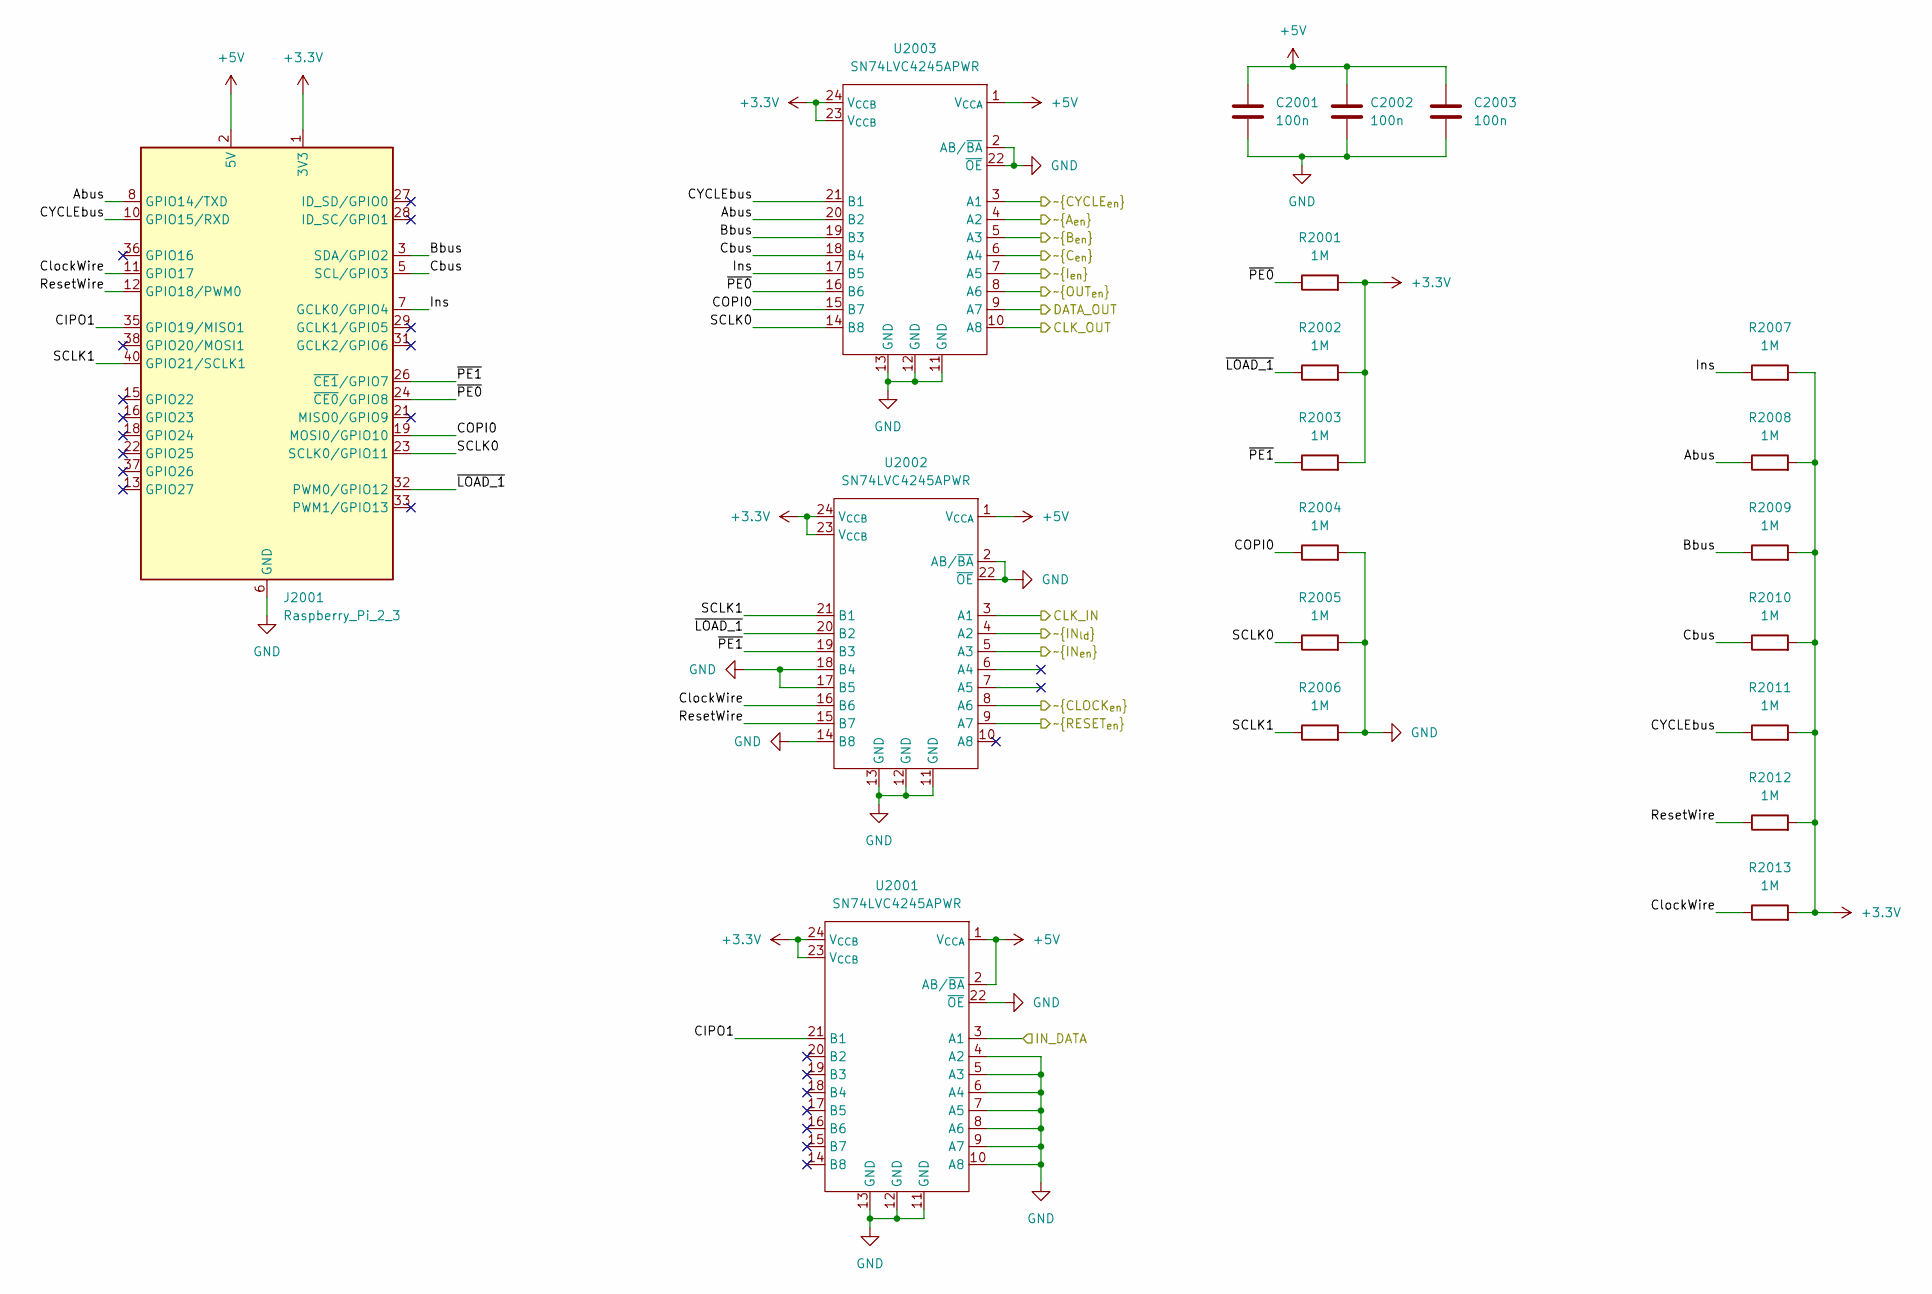
[picture p31: schematic picontrol.kicad_sch]

Parts:
C2001, C2002, C2003: 100n; C_0603_1608Metric; LCSC C14663
J2001: Raspberry_Pi_2_3; PinHeader_2x20_P2.54mm_Vertical
R2001, R2002, R2003, R2004, R2005, R2006, R2007, R2008, R2009, R2010, R2011, R2012, R2013: 1M; R_0603_1608Metric; LCSC C22935
U2001, U2002, U2003: SN74LVC4245APWR; TSSOP-24_4.4x7.8mm_P0.65mm; LCSC C7859

Connections:
+3.3V: J2001.1 (3V3), J2001.17 (3V3), R2001.2, R2002.2, R2003.2, R2007.2, R2008.2, R2009.2, R2010.2, R2011.2, R2012.2, R2013.2, U2001.23 (V_{CCB}), U2001.24 (V_{CCB}), U2002.23 (V_{CCB}), U2002.24 (V_{CCB}), U2003.23 (V_{CCB}), U2003.24 (V_{CCB})
+5V: C2001.2, C2002.2, C2003.2, J2001.2 (5V), J2001.4 (5V), U2001.1 (V_{CCA}), U2001.2 (AB/~BA), U2002.1 (V_{CCA}), U2003.1 (V_{CCA}); also elsewhere on the board
/Inputs/IN_{CLK}: U2002.3 (A1); also elsewhere on the board
/Inputs/IN_{DATA}: U2001.3 (A1); also elsewhere on the board
/Inputs/~IN_{LOAD}: U2002.4 (A2); also elsewhere on the board
/Inputs/~IN_{SELECT}: U2002.5 (A3); also elsewhere on the board
/Outputs/DATA: U2003.9 (A7); also elsewhere on the board
/Outputs/RCLK: U2003.8 (A6); also elsewhere on the board
/Outputs/SRCLK: U2003.10 (A8); also elsewhere on the board
/Outputs/~A_{enable}: U2003.4 (A2); also elsewhere on the board
/Outputs/~B_{enable}: U2003.5 (A3); also elsewhere on the board
/Outputs/~CLOCK_{enable}: U2002.8 (A6); also elsewhere on the board
/Outputs/~C_{enable}: U2003.6 (A4); also elsewhere on the board
/Outputs/~Cycle_{enable}: U2003.3 (A1); also elsewhere on the board
/Outputs/~I_{enable}: U2003.7 (A5); also elsewhere on the board
/Outputs/~RESET_{enable}: U2002.9 (A7); also elsewhere on the board
/Pi Control/Abus: J2001.8 (GPIO14/TXD), R2008.1, U2003.20 (B2)
/Pi Control/Bbus: J2001.3 (SDA/GPIO2), R2009.1, U2003.19 (B3)
/Pi Control/CIPO1: J2001.35 (GPIO19/MISO1), U2001.21 (B1)
/Pi Control/COPI0: J2001.19 (MOSI0/GPIO10), R2004.1, U2003.15 (B7)
/Pi Control/CYCLEbus: J2001.10 (GPIO15/RXD), R2011.1, U2003.21 (B1)
/Pi Control/Cbus: J2001.5 (SCL/GPIO3), R2010.1, U2003.18 (B4)
/Pi Control/ClockWire: J2001.11 (GPIO17), R2013.1, U2002.16 (B6)
/Pi Control/Ins: J2001.7 (GCLK0/GPIO4), R2007.1, U2003.17 (B5)
/Pi Control/ResetWire: J2001.12 (GPIO18/PWM0), R2012.1, U2002.15 (B7)
/Pi Control/SCLK0: J2001.23 (SCLK0/GPIO11), R2005.1, U2003.14 (B8)
/Pi Control/SCLK1: J2001.40 (GPIO21/SCLK1), R2006.1, U2002.21 (B1)
/Pi Control/~LOAD_1: J2001.32 (PWM0/GPIO12), R2002.1, U2002.20 (B2)
/Pi Control/~PE0: J2001.24 (~CE0/GPIO8), R2001.1, U2003.16 (B6)
/Pi Control/~PE1: J2001.26 (~CE1/GPIO7), R2003.1, U2002.19 (B3)
GND: C2001.1, C2002.1, C2003.1, J2001.6 (GND), J2001.9 (GND), J2001.14 (GND), J2001.20 (GND), J2001.25 (GND), J2001.30 (GND), J2001.34 (GND), J2001.39 (GND), R2004.2, R2005.2, R2006.2, U2001.4 (A2), U2001.5 (A3), U2001.6 (A4), U2001.7 (A5), U2001.8 (A6), U2001.9 (A7), U2001.10 (A8), U2001.11 (GND), U2001.12 (GND), U2001.13 (GND), U2001.22 (~OE), U2002.2 (AB/~BA), U2002.11 (GND), U2002.12 (GND), U2002.13 (GND), U2002.14 (B8), U2002.17 (B5), U2002.18 (B4), U2002.22 (~OE), U2003.2 (AB/~BA), U2003.11 (GND), U2003.12 (GND), U2003.13 (GND), U2003.22 (~OE); also elsewhere on the board

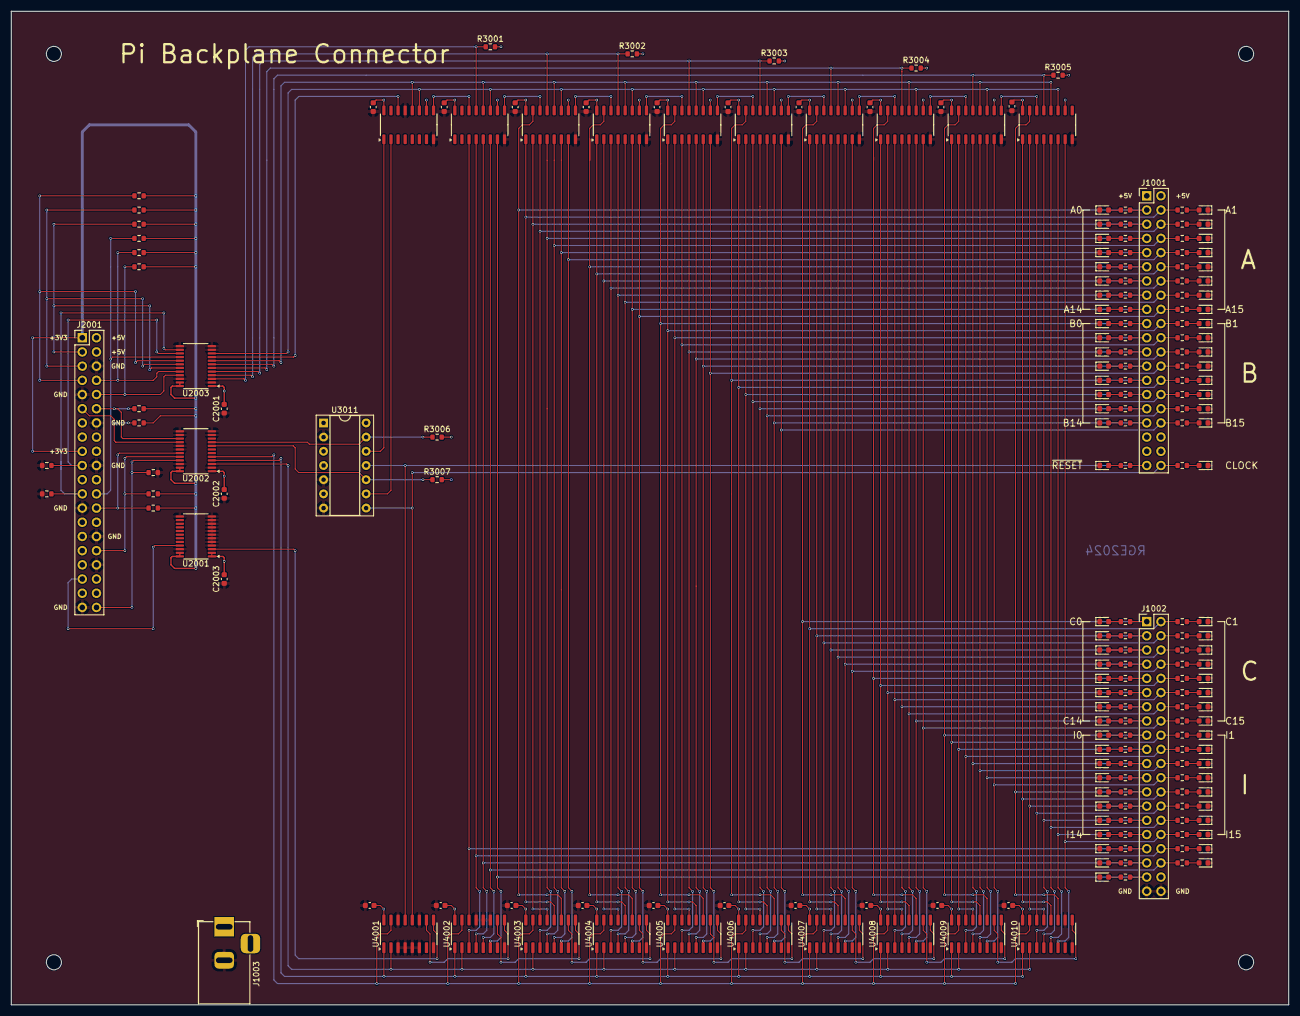
[picture p32: board Pi Backplane Connector.kicad_pcb from above]

Board: 2 copper layers, 228.6 x 177.8 mm, 217 parts (0 on the bottom side), 193 nets.
