freesurfer-rge/slothpu16/pcbs/NAND XOR/NAND XOR.kicad_pcb

## KiCad design pcbs/NAND XOR/NAND XOR.kicad_pcb (2024-12-24)

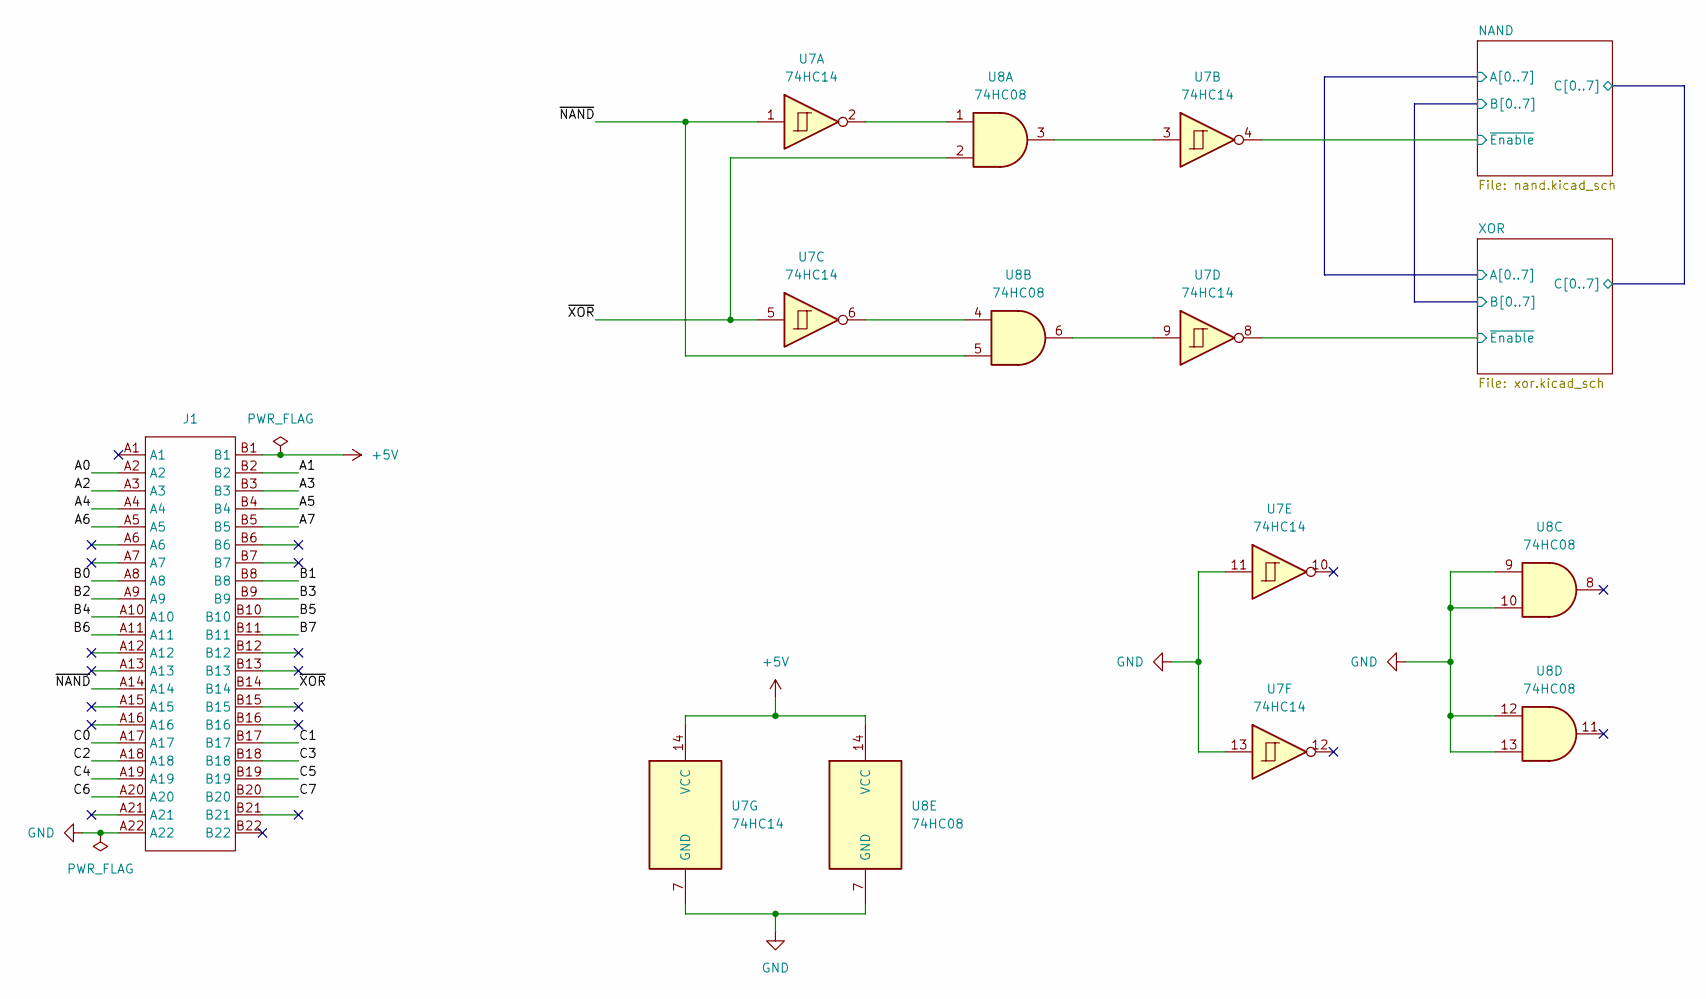
[picture p33: schematic NAND XOR.kicad_sch]

Parts:
J1: TE-5530843-4-Edge
U7: 74HC14; SOIC-14_3.9x8.7mm_P1.27mm; LCSC C5605
U8: 74HC08; SOIC-14_3.9x8.7mm_P1.27mm; LCSC C5593

Connections:
+5V: J1.B1, U7.14 (VCC), U8.14 (VCC); also elsewhere on the board
/NAND/A0: J1.A2; also elsewhere on the board
/NAND/A1: J1.B2; also elsewhere on the board
/NAND/A2: J1.A3; also elsewhere on the board
/NAND/A3: J1.B3; also elsewhere on the board
/NAND/A4: J1.A4; also elsewhere on the board
/NAND/A5: J1.B4; also elsewhere on the board
/NAND/A6: J1.A5; also elsewhere on the board
/NAND/A7: J1.B5; also elsewhere on the board
/NAND/B0: J1.A8; also elsewhere on the board
/NAND/B1: J1.B8; also elsewhere on the board
/NAND/B2: J1.A9; also elsewhere on the board
/NAND/B3: J1.B9; also elsewhere on the board
/NAND/B4: J1.A10; also elsewhere on the board
/NAND/B5: J1.B10; also elsewhere on the board
/NAND/B6: J1.A11; also elsewhere on the board
/NAND/B7: J1.B11; also elsewhere on the board
/NAND/C0: J1.A17; also elsewhere on the board
/NAND/C1: J1.B17; also elsewhere on the board
/NAND/C2: J1.A18; also elsewhere on the board
/NAND/C3: J1.B18; also elsewhere on the board
/NAND/C4: J1.A19; also elsewhere on the board
/NAND/C5: J1.B19; also elsewhere on the board
/NAND/C6: J1.A20; also elsewhere on the board
/NAND/C7: J1.B20; also elsewhere on the board
/NAND/~Enable: U7.4; also elsewhere on the board
/XOR/~Enable: U7.8; also elsewhere on the board
/~NAND: J1.A14, U7.1, U8.5
/~XOR: J1.B14, U7.5, U8.2
GND: J1.A22, U7.7 (GND), U7.11, U7.13, U8.7 (GND), U8.9, U8.10, U8.12, U8.13; also elsewhere on the board
unnamed: U7.2, U8.1
unnamed: U7.3, U8.3
unnamed: U7.6, U8.4
unnamed: U7.9, U8.6

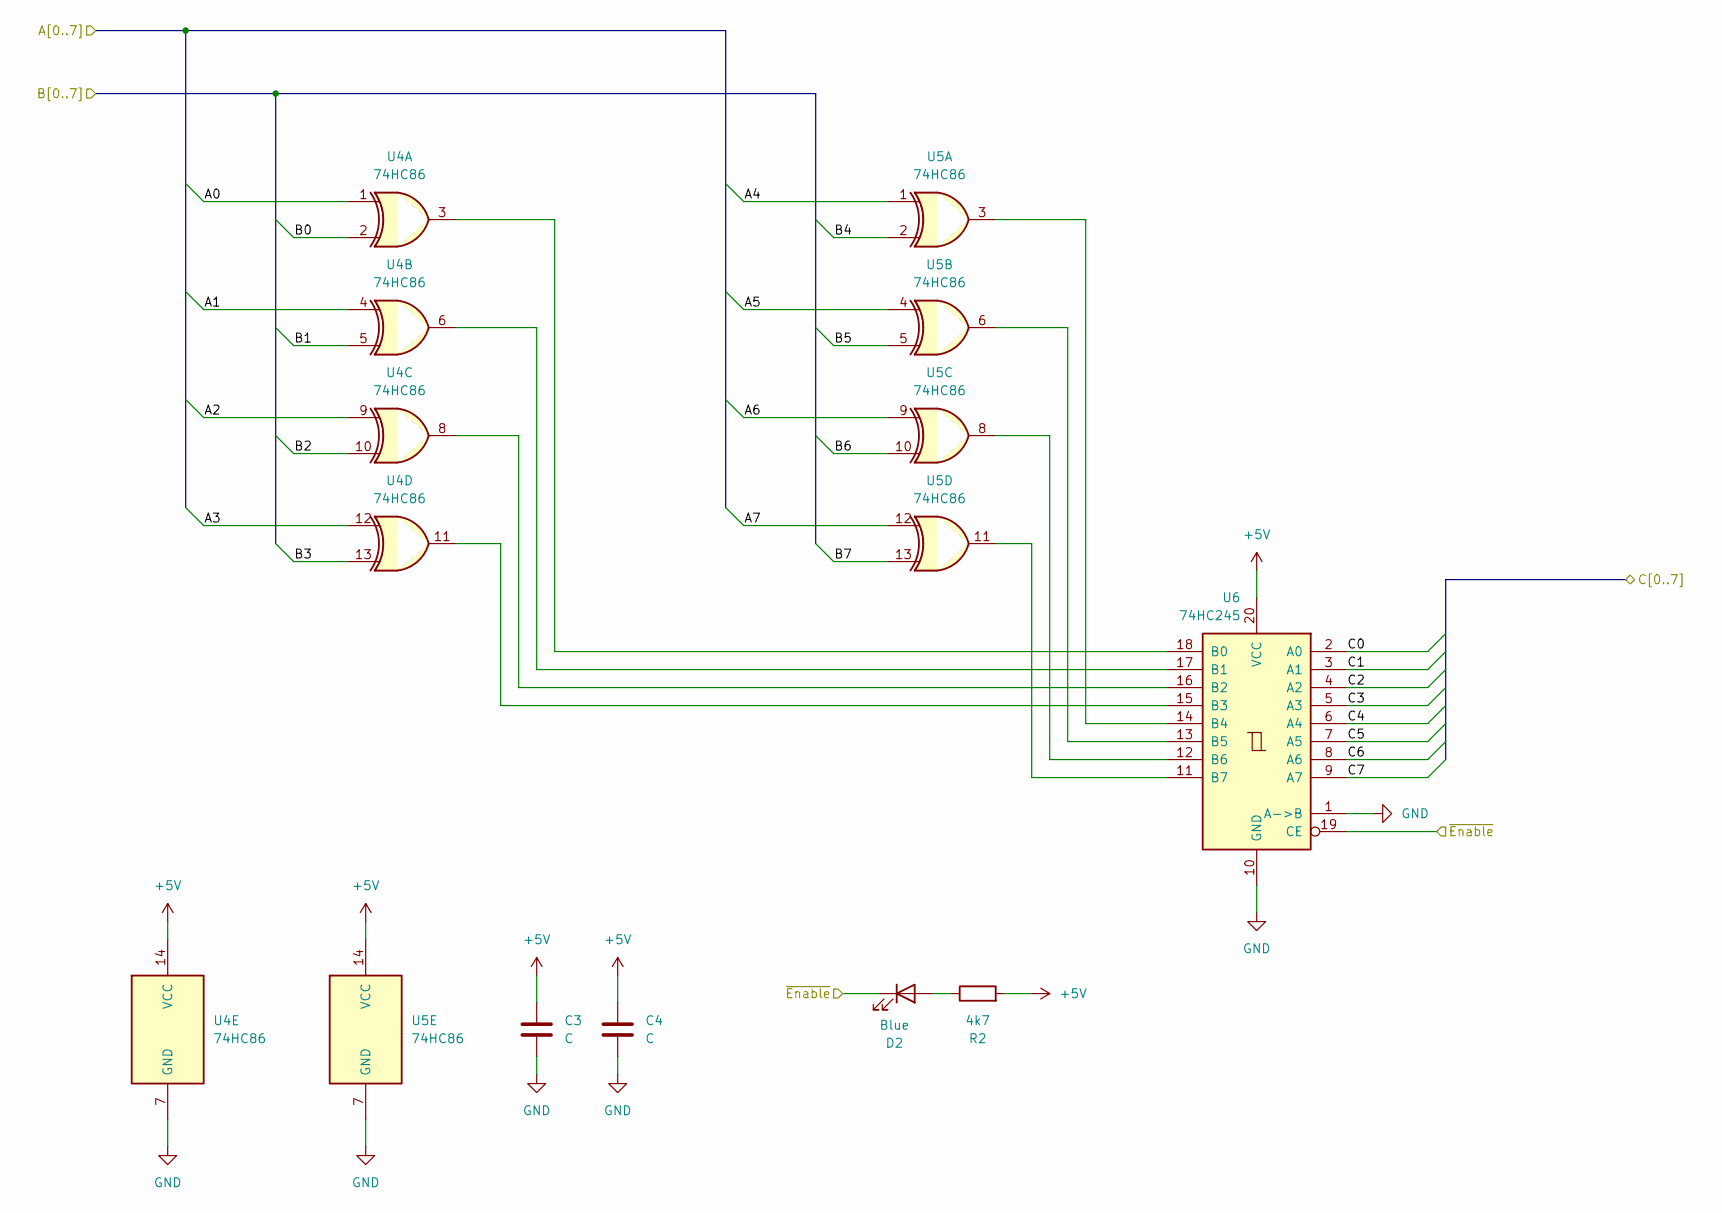
[picture p34: schematic xor.kicad_sch]

Parts:
C3, C4: C; C_0603_1608Metric; LCSC C14663
D2: Blue; LED_0603_1608Metric; LCSC C72041
R2: 4k7; R_0603_1608Metric; LCSC C23162
U4, U5: 74HC86; DIP-14_W7.62mm_Socket
U6: 74HC245; SOIC-20W_7.5x12.8mm_P1.27mm; LCSC C5625

Connections:
+5V: C3.1, C4.1, R2.2, U4.14 (VCC), U5.14 (VCC), U6.20 (VCC); also elsewhere on the board
/NAND/A0: U4.1; also elsewhere on the board
/NAND/A1: U4.4; also elsewhere on the board
/NAND/A2: U4.9; also elsewhere on the board
/NAND/A3: U4.12; also elsewhere on the board
/NAND/A4: U5.1; also elsewhere on the board
/NAND/A5: U5.4; also elsewhere on the board
/NAND/A6: U5.9; also elsewhere on the board
/NAND/A7: U5.12; also elsewhere on the board
/NAND/B0: U4.2; also elsewhere on the board
/NAND/B1: U4.5; also elsewhere on the board
/NAND/B2: U4.10; also elsewhere on the board
/NAND/B3: U4.13; also elsewhere on the board
/NAND/B4: U5.2; also elsewhere on the board
/NAND/B5: U5.5; also elsewhere on the board
/NAND/B6: U5.10; also elsewhere on the board
/NAND/B7: U5.13; also elsewhere on the board
/NAND/C0: U6.2 (A0); also elsewhere on the board
/NAND/C1: U6.3 (A1); also elsewhere on the board
/NAND/C2: U6.4 (A2); also elsewhere on the board
/NAND/C3: U6.5 (A3); also elsewhere on the board
/NAND/C4: U6.6 (A4); also elsewhere on the board
/NAND/C5: U6.7 (A5); also elsewhere on the board
/NAND/C6: U6.8 (A6); also elsewhere on the board
/NAND/C7: U6.9 (A7); also elsewhere on the board
/XOR/~Enable: D2.1 (K), U6.19 (CE); also elsewhere on the board
GND: C3.2, C4.2, U4.7 (GND), U5.7 (GND), U6.1 (A->B), U6.10 (GND); also elsewhere on the board
unnamed: D2.2 (A), R2.1
unnamed: U4.3, U6.18 (B0)
unnamed: U4.6, U6.17 (B1)
unnamed: U4.8, U6.16 (B2)
unnamed: U4.11, U6.15 (B3)
unnamed: U5.3, U6.14 (B4)
unnamed: U5.6, U6.13 (B5)
unnamed: U5.8, U6.12 (B6)
unnamed: U5.11, U6.11 (B7)

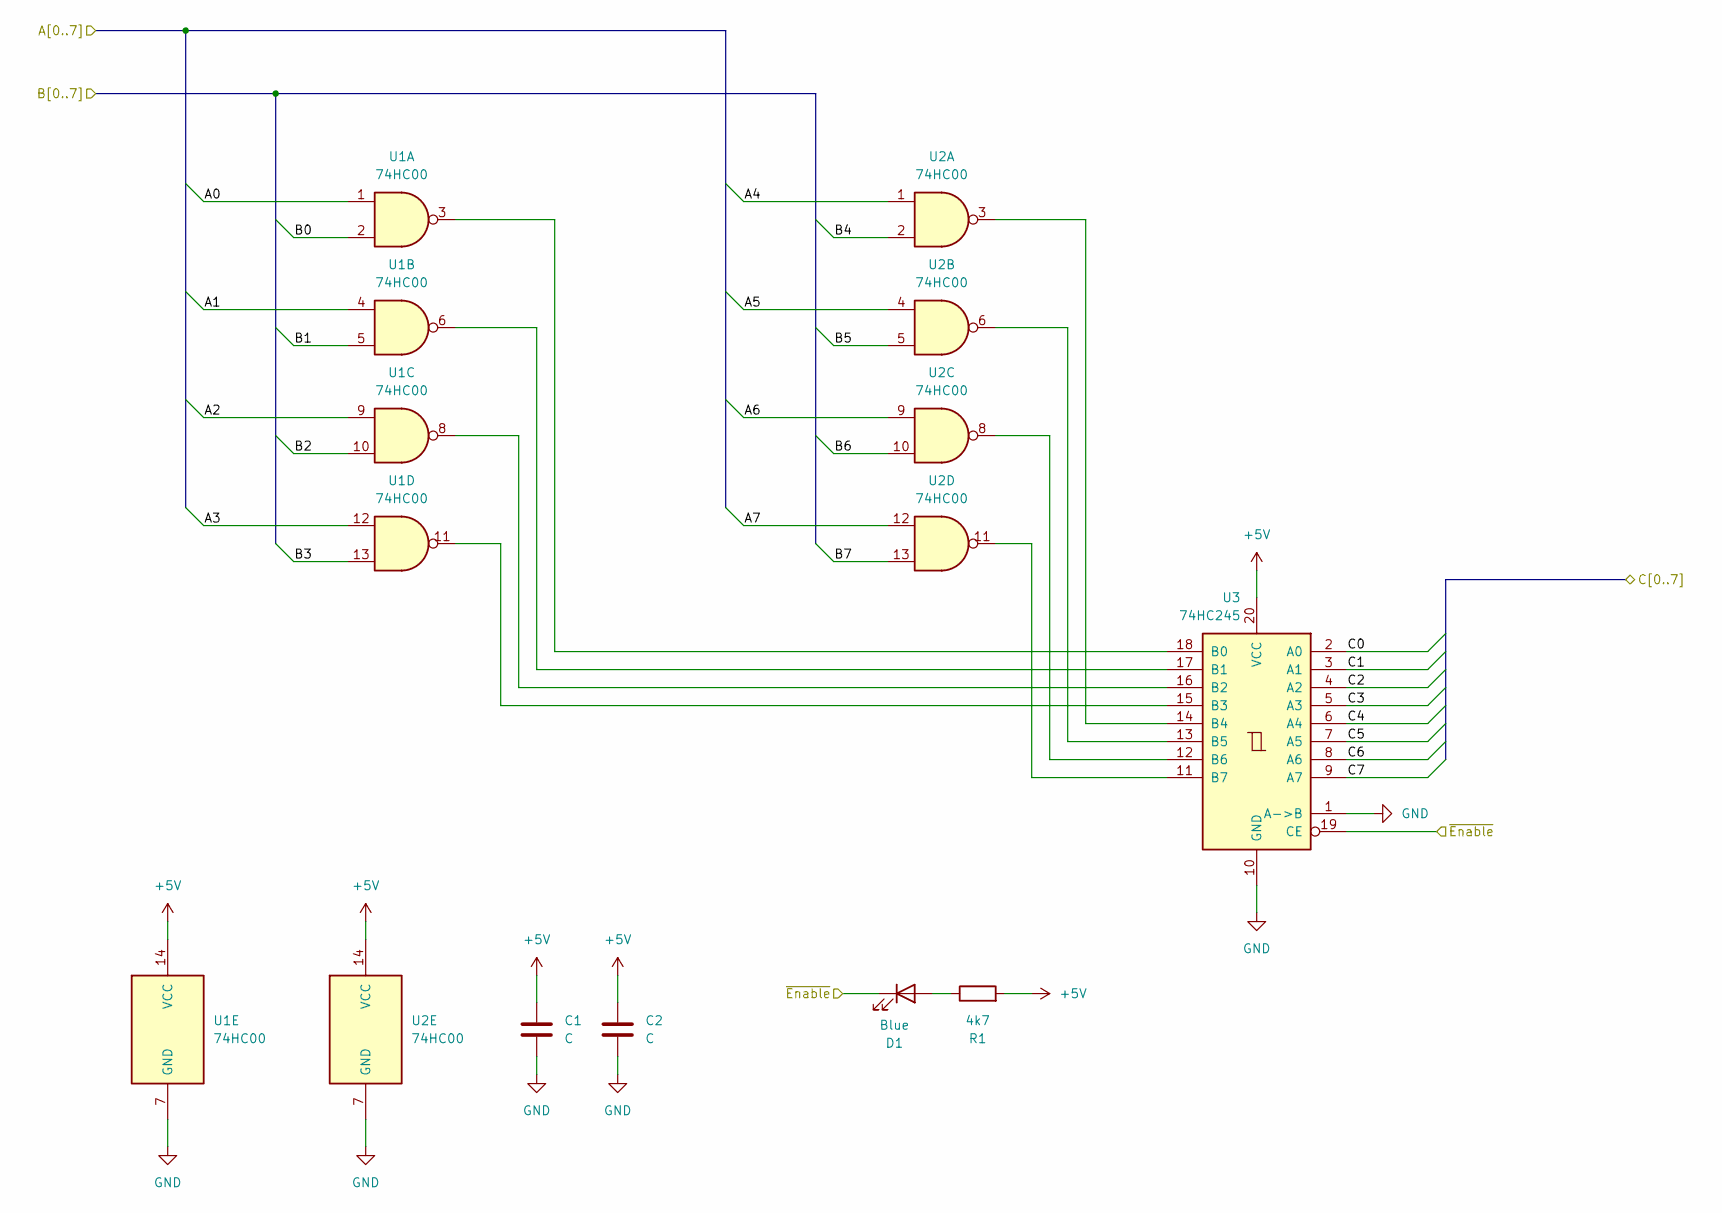
[picture p35: schematic nand.kicad_sch]

Parts:
C1, C2: C; C_0603_1608Metric; LCSC C14663
D1: Blue; LED_0603_1608Metric; LCSC C72041
R1: 4k7; R_0603_1608Metric; LCSC C23162
U1, U2: 74HC00; DIP-14_W7.62mm_Socket
U3: 74HC245; SOIC-20W_7.5x12.8mm_P1.27mm; LCSC C5625

Connections:
+5V: C1.1, C2.1, R1.2, U1.14 (VCC), U2.14 (VCC), U3.20 (VCC); also elsewhere on the board
/NAND/A0: U1.1; also elsewhere on the board
/NAND/A1: U1.4; also elsewhere on the board
/NAND/A2: U1.9; also elsewhere on the board
/NAND/A3: U1.12; also elsewhere on the board
/NAND/A4: U2.1; also elsewhere on the board
/NAND/A5: U2.4; also elsewhere on the board
/NAND/A6: U2.9; also elsewhere on the board
/NAND/A7: U2.12; also elsewhere on the board
/NAND/B0: U1.2; also elsewhere on the board
/NAND/B1: U1.5; also elsewhere on the board
/NAND/B2: U1.10; also elsewhere on the board
/NAND/B3: U1.13; also elsewhere on the board
/NAND/B4: U2.2; also elsewhere on the board
/NAND/B5: U2.5; also elsewhere on the board
/NAND/B6: U2.10; also elsewhere on the board
/NAND/B7: U2.13; also elsewhere on the board
/NAND/C0: U3.2 (A0); also elsewhere on the board
/NAND/C1: U3.3 (A1); also elsewhere on the board
/NAND/C2: U3.4 (A2); also elsewhere on the board
/NAND/C3: U3.5 (A3); also elsewhere on the board
/NAND/C4: U3.6 (A4); also elsewhere on the board
/NAND/C5: U3.7 (A5); also elsewhere on the board
/NAND/C6: U3.8 (A6); also elsewhere on the board
/NAND/C7: U3.9 (A7); also elsewhere on the board
/NAND/~Enable: D1.1 (K), U3.19 (CE); also elsewhere on the board
GND: C1.2, C2.2, U1.7 (GND), U2.7 (GND), U3.1 (A->B), U3.10 (GND); also elsewhere on the board
unnamed: D1.2 (A), R1.1
unnamed: U1.3, U3.18 (B0)
unnamed: U1.6, U3.17 (B1)
unnamed: U1.8, U3.16 (B2)
unnamed: U1.11, U3.15 (B3)
unnamed: U2.3, U3.14 (B4)
unnamed: U2.6, U3.13 (B5)
unnamed: U2.8, U3.12 (B6)
unnamed: U2.11, U3.11 (B7)

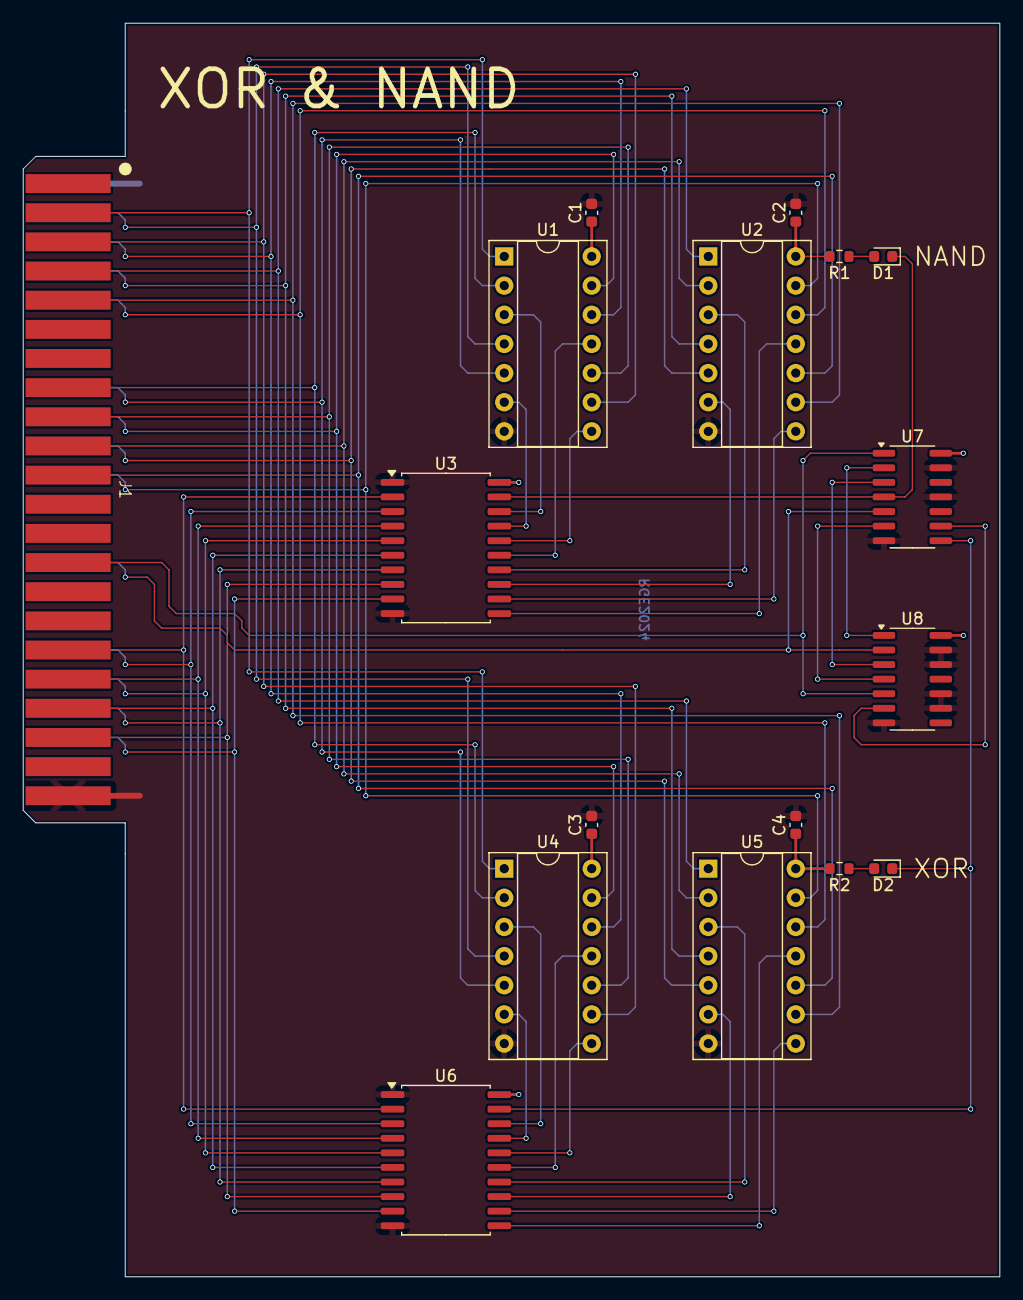
[picture p36: board NAND XOR.kicad_pcb from above]

Board: 2 copper layers, 85.1 x 109.2 mm, 17 parts (0 on the bottom side), 52 nets.
