freesurfer-rge/slothpu16/pcbs/ALU Test Connector/ALU Test Connector.kicad_pcb

## KiCad design pcbs/ALU Test Connector/ALU Test Connector.kicad_pcb (2024-12-24)

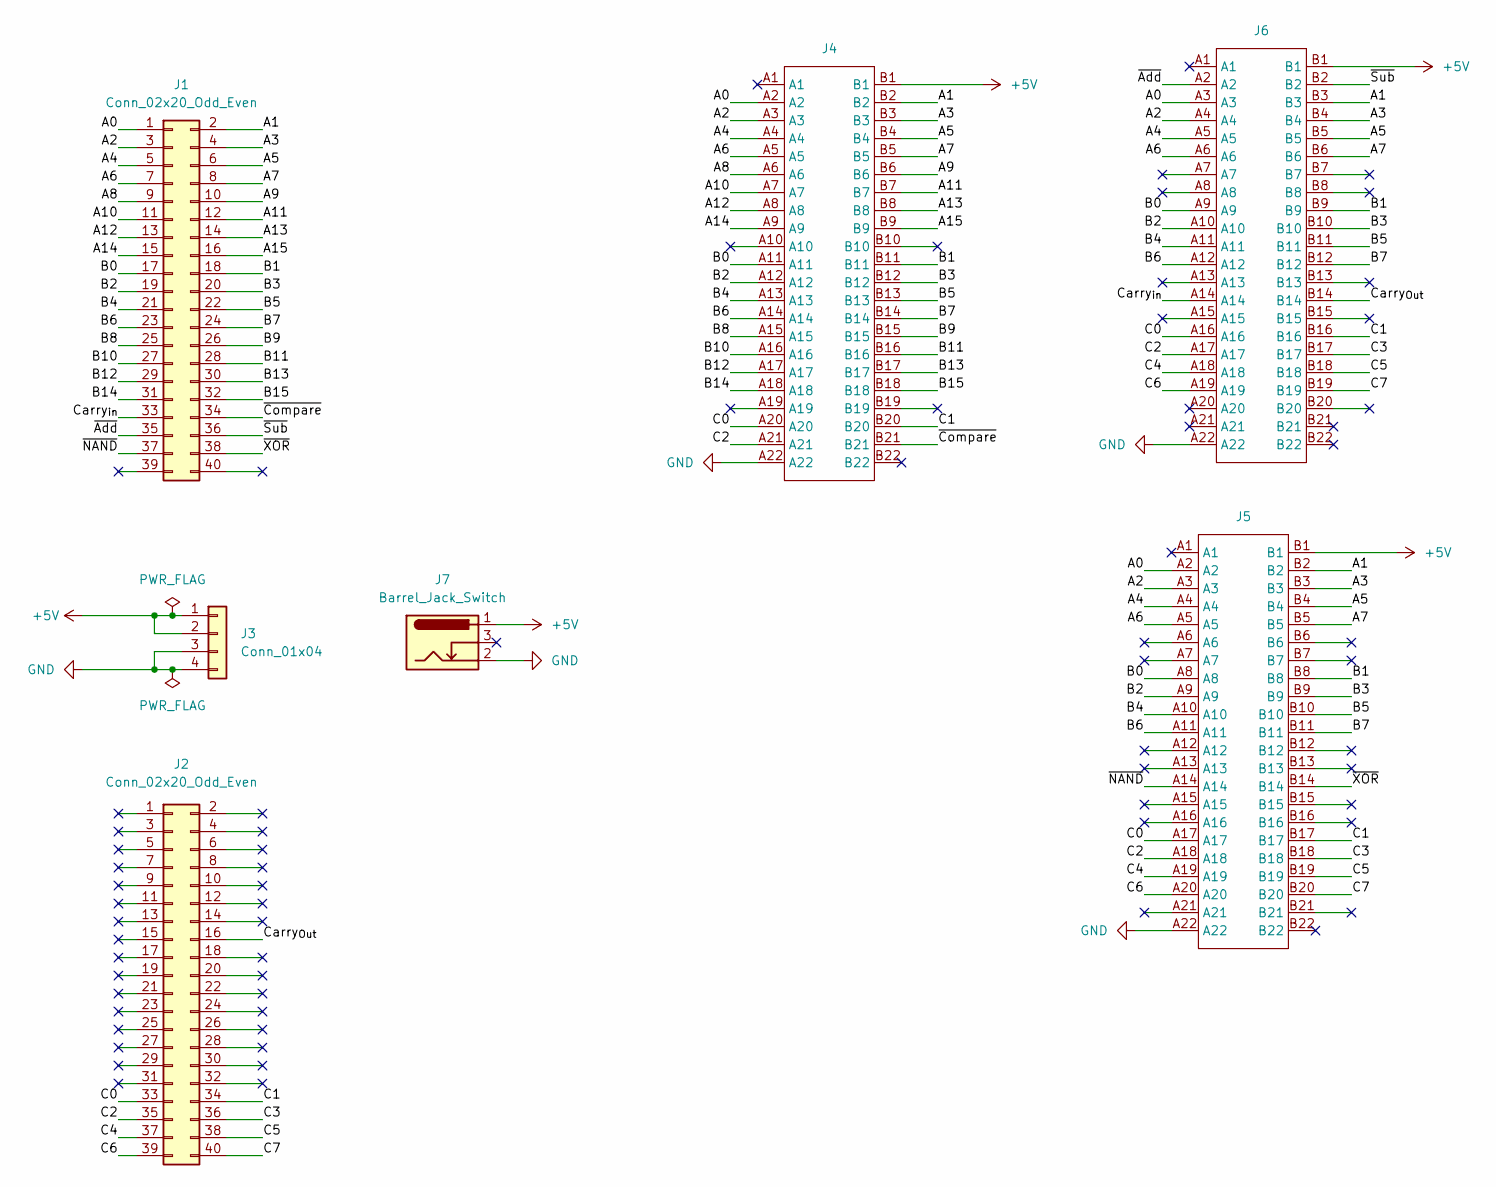
[picture p37: schematic ALU Test Connector.kicad_sch]

Parts:
J1, J2: Conn_02x20_Odd_Even; PinHeader_2x20_P2.54mm_Vertical
J3: Conn_01x04; PinHeader_1x04_P2.54mm_Vertical
J4, J5, J6: TE-5530843-4-Mount
J7: Barrel_Jack_Switch; BarrelJack_Horizontal

Connections:
+5V: J3.1, J3.2, J4.B1, J5.B1, J6.B1, J7.1
/A0: J1.1, J4.A2, J5.A2, J6.A3
/A1: J1.2, J4.B2, J5.B2, J6.B3
/A2: J1.3, J4.A3, J5.A3, J6.A4
/A3: J1.4, J4.B3, J5.B3, J6.B4
/A4: J1.5, J4.A4, J5.A4, J6.A5
/A5: J1.6, J4.B4, J5.B4, J6.B5
/A6: J1.7, J4.A5, J5.A5, J6.A6
/A7: J1.8, J4.B5, J5.B5, J6.B6
/A8: J1.9, J4.A6
/A9: J1.10, J4.B6
/A10: J1.11, J4.A7
/A11: J1.12, J4.B7
/A12: J1.13, J4.A8
/A13: J1.14, J4.B8
/A14: J1.15, J4.A9
/A15: J1.16, J4.B9
/B0: J1.17, J4.A11, J5.A8, J6.A9
/B1: J1.18, J4.B11, J5.B8, J6.B9
/B2: J1.19, J4.A12, J5.A9, J6.A10
/B3: J1.20, J4.B12, J5.B9, J6.B10
/B4: J1.21, J4.A13, J5.A10, J6.A11
/B5: J1.22, J4.B13, J5.B10, J6.B11
/B6: J1.23, J4.A14, J5.A11, J6.A12
/B7: J1.24, J4.B14, J5.B11, J6.B12
/B8: J1.25, J4.A15
/B9: J1.26, J4.B15
/B10: J1.27, J4.A16
/B11: J1.28, J4.B16
/B12: J1.29, J4.A17
/B13: J1.30, J4.B17
/B14: J1.31, J4.A18
/B15: J1.32, J4.B18
/C0: J2.33, J4.A20, J5.A17, J6.A16
/C1: J2.34, J4.B20, J5.B17, J6.B16
/C2: J2.35, J4.A21, J5.A18, J6.A17
/C3: J2.36, J5.B18, J6.B17
/C4: J2.37, J5.A19, J6.A18
/C5: J2.38, J5.B19, J6.B18
/C6: J2.39, J5.A20, J6.A19
/C7: J2.40, J5.B20, J6.B19
/Carry_{Out}: J2.16, J6.B14
/Carry_{in}: J1.33, J6.A14
/~Add: J1.35, J6.A2
/~Compare: J1.34, J4.B21
/~NAND: J1.37, J5.A14
/~Sub: J1.36, J6.B2
/~XOR: J1.38, J5.B14
GND: J3.3, J3.4, J4.A22, J5.A22, J6.A22, J7.2

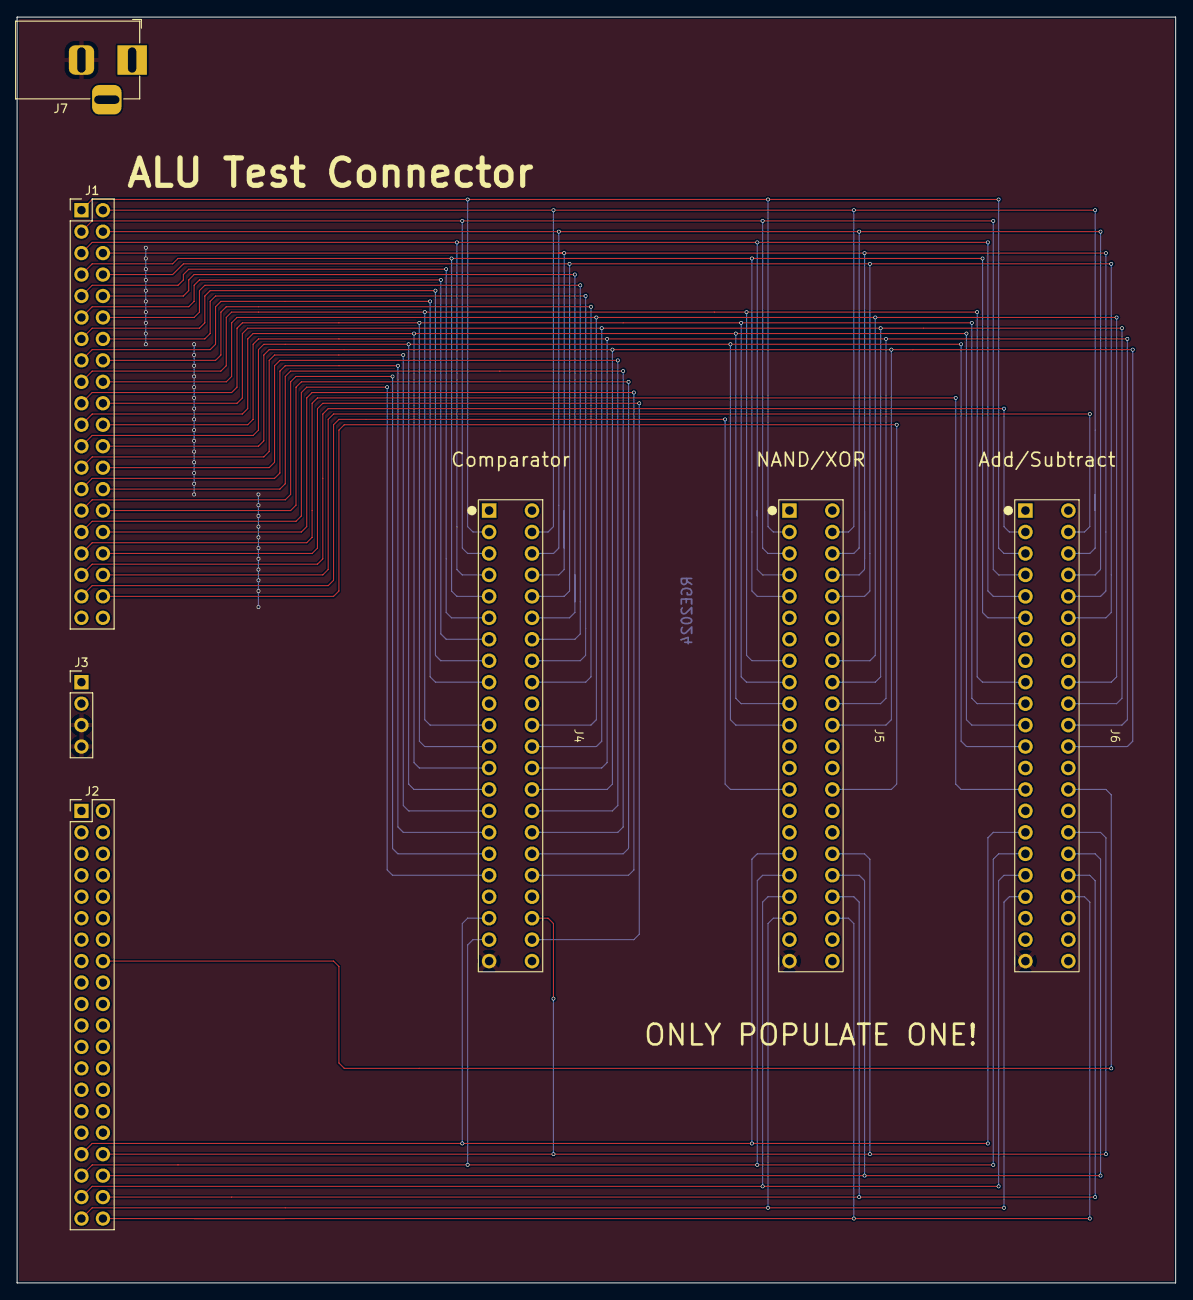
[picture p38: board ALU Test Connector.kicad_pcb from above]

Board: 2 copper layers, 137.2 x 149.9 mm, 7 parts (0 on the bottom side), 49 nets.
