freesurfer-rge/slothpu16/pcbs/Comparator/Comparator.kicad_pcb

## KiCad design pcbs/Comparator/Comparator.kicad_pcb (2024-12-24)

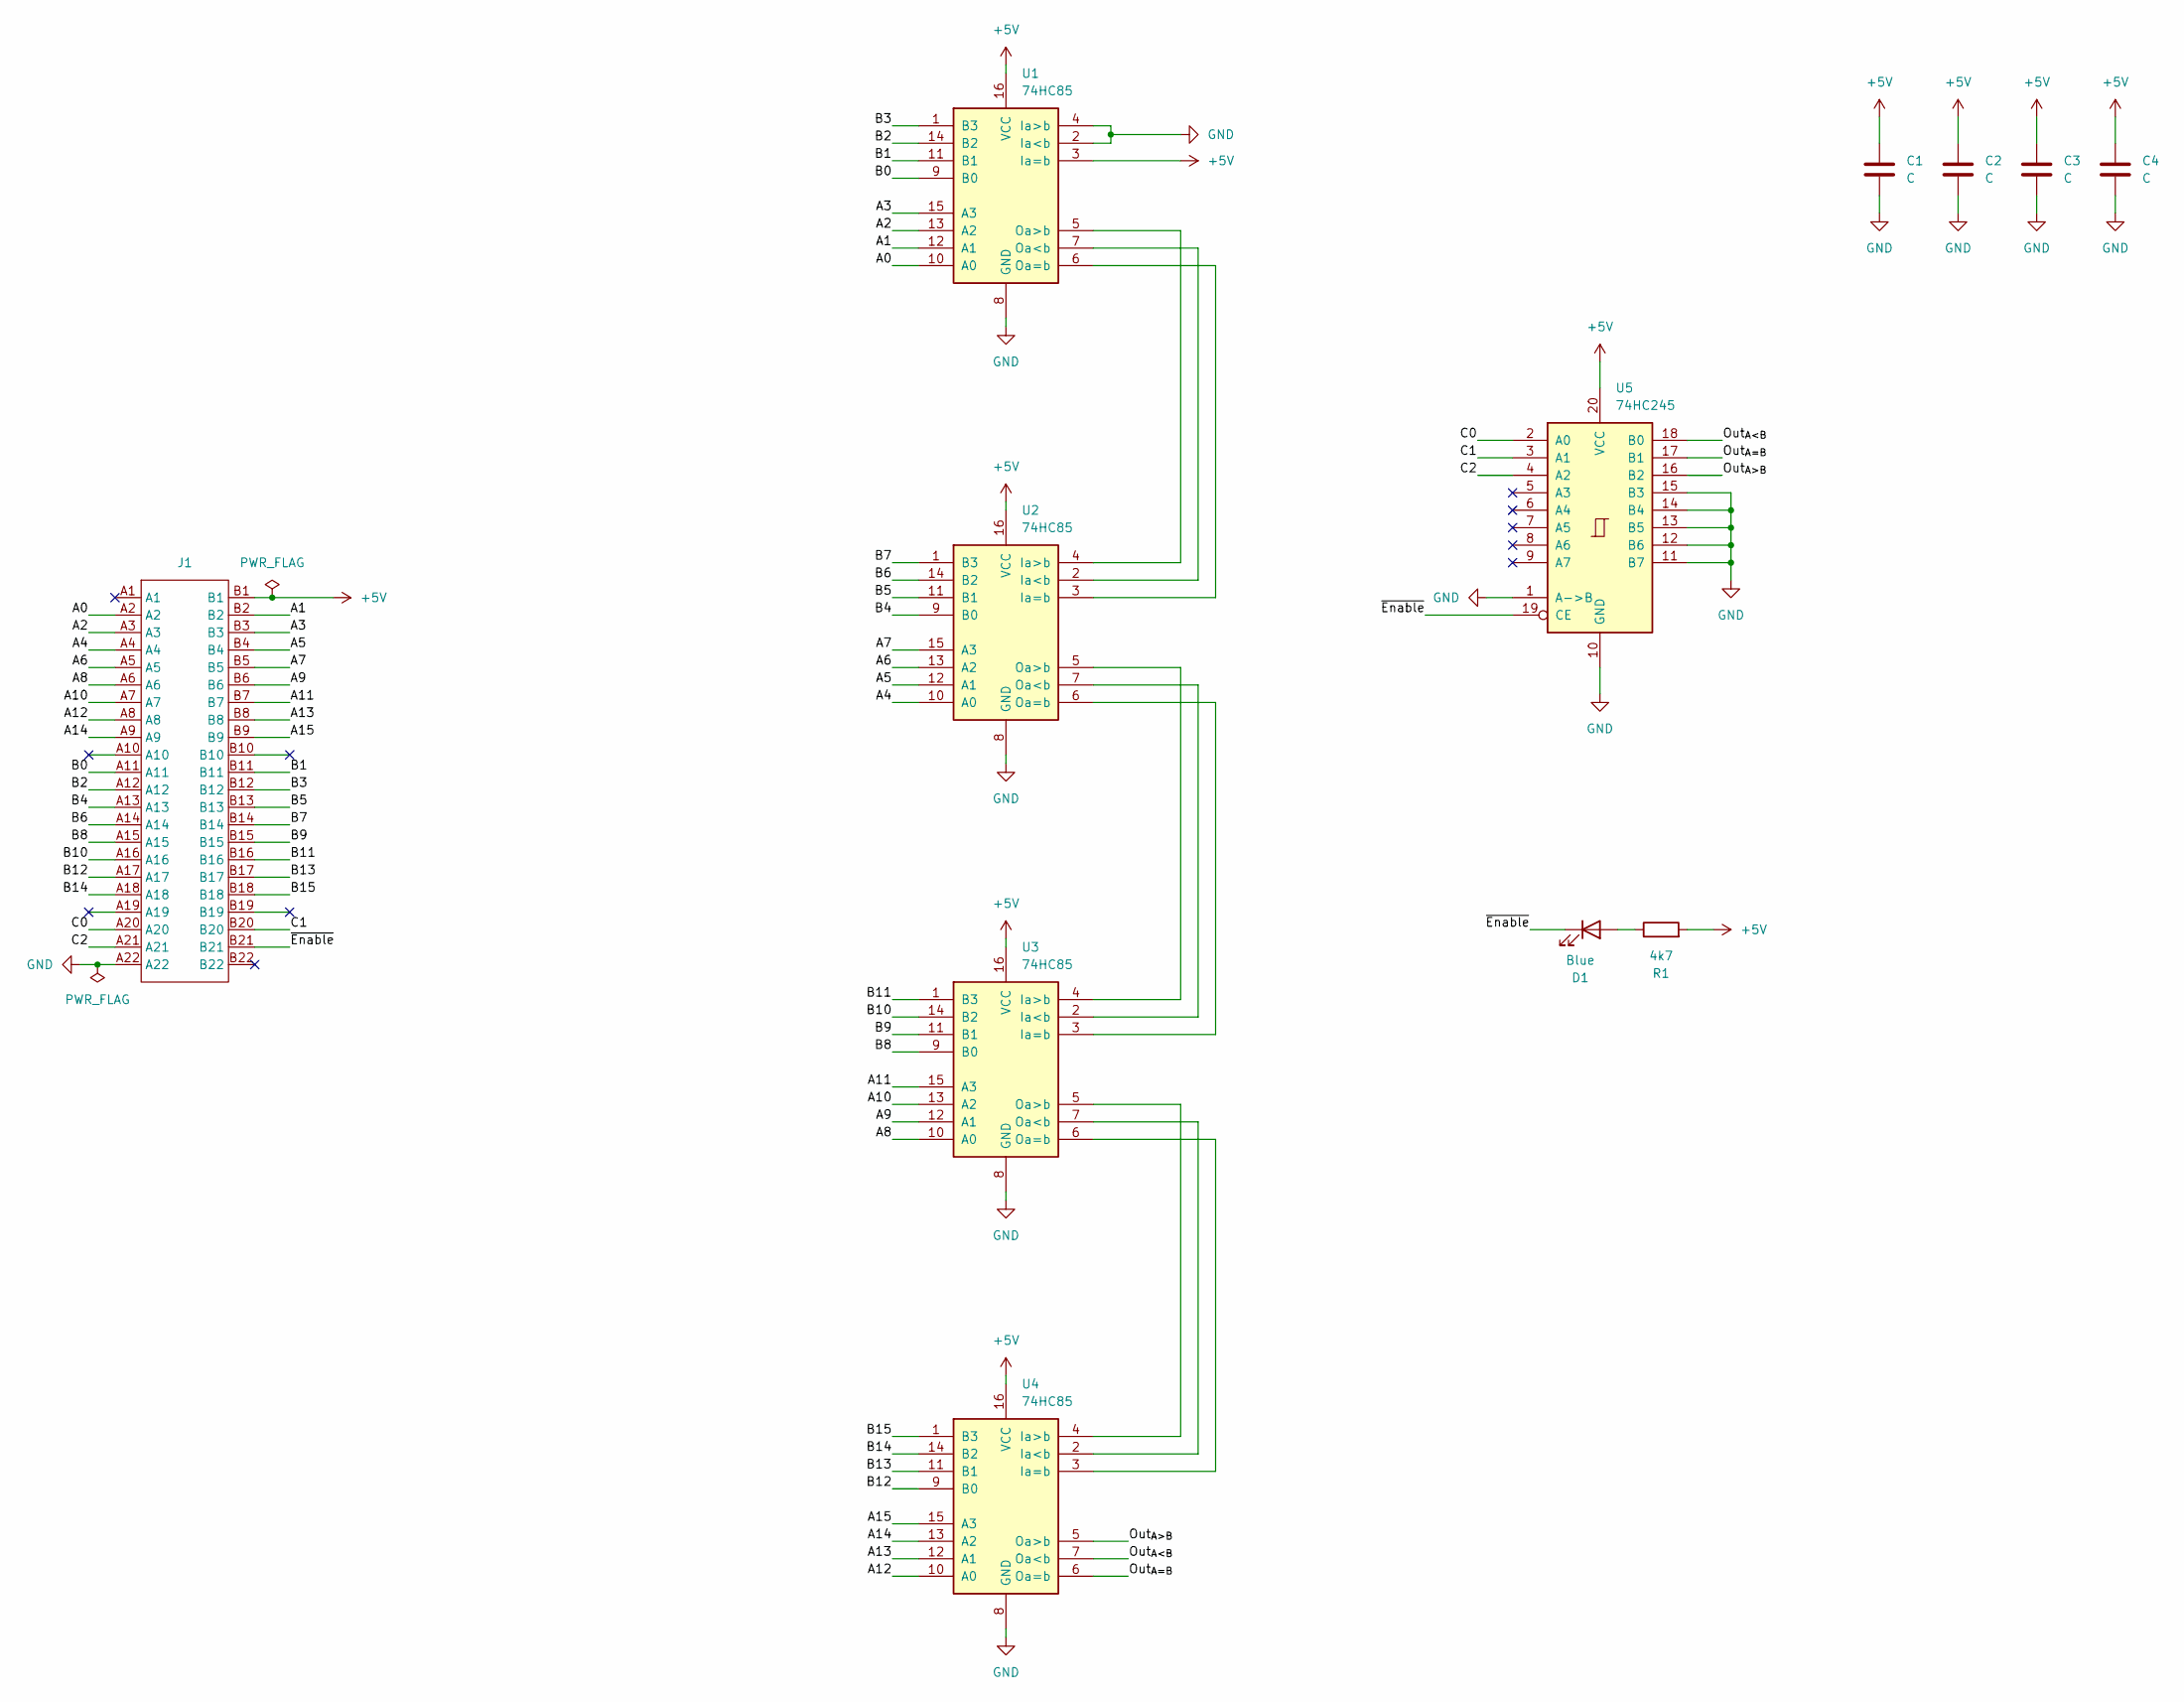
[picture p39: schematic Comparator.kicad_sch]

Parts:
C1, C2, C3, C4: C; C_0603_1608Metric; LCSC C14663
D1: Blue; LED_0603_1608Metric; LCSC C72041
J1: TE-5530843-4-Edge
R1: 4k7; R_0603_1608Metric; LCSC C23162
U1, U2, U3, U4: 74HC85; DIP-16_W7.62mm_Socket
U5: 74HC245; SOIC-20W_7.5x12.8mm_P1.27mm; LCSC C5625

Connections:
+5V: C1.1, C2.1, C3.1, C4.1, J1.B1, R1.2, U1.3 (Ia=b), U1.16 (VCC), U2.16 (VCC), U3.16 (VCC), U4.16 (VCC), U5.20 (VCC)
/A0: J1.A2, U1.10 (A0)
/A1: J1.B2, U1.12 (A1)
/A2: J1.A3, U1.13 (A2)
/A3: J1.B3, U1.15 (A3)
/A4: J1.A4, U2.10 (A0)
/A5: J1.B4, U2.12 (A1)
/A6: J1.A5, U2.13 (A2)
/A7: J1.B5, U2.15 (A3)
/A8: J1.A6, U3.10 (A0)
/A9: J1.B6, U3.12 (A1)
/A10: J1.A7, U3.13 (A2)
/A11: J1.B7, U3.15 (A3)
/A12: J1.A8, U4.10 (A0)
/A13: J1.B8, U4.12 (A1)
/A14: J1.A9, U4.13 (A2)
/A15: J1.B9, U4.15 (A3)
/B0: J1.A11, U1.9 (B0)
/B1: J1.B11, U1.11 (B1)
/B2: J1.A12, U1.14 (B2)
/B3: J1.B12, U1.1 (B3)
/B4: J1.A13, U2.9 (B0)
/B5: J1.B13, U2.11 (B1)
/B6: J1.A14, U2.14 (B2)
/B7: J1.B14, U2.1 (B3)
/B8: J1.A15, U3.9 (B0)
/B9: J1.B15, U3.11 (B1)
/B10: J1.A16, U3.14 (B2)
/B11: J1.B16, U3.1 (B3)
/B12: J1.A17, U4.9 (B0)
/B13: J1.B17, U4.11 (B1)
/B14: J1.A18, U4.14 (B2)
/B15: J1.B18, U4.1 (B3)
/C0: J1.A20, U5.2 (A0)
/C1: J1.B20, U5.3 (A1)
/C2: J1.A21, U5.4 (A2)
/Out_{A<B}: U4.7 (Oa<b), U5.18 (B0)
/Out_{A=B}: U4.6 (Oa=b), U5.17 (B1)
/Out_{A>B}: U4.5 (Oa>b), U5.16 (B2)
/~Enable: D1.1 (K), J1.B21, U5.19 (CE)
GND: C1.2, C2.2, C3.2, C4.2, J1.A22, U1.2 (Ia<b), U1.4 (Ia>b), U1.8 (GND), U2.8 (GND), U3.8 (GND), U4.8 (GND), U5.1 (A->B), U5.10 (GND), U5.11 (B7), U5.12 (B6), U5.13 (B5), U5.14 (B4), U5.15 (B3)
unnamed: D1.2 (A), R1.1
unnamed: U1.7 (Oa<b), U2.2 (Ia<b)
unnamed: U1.6 (Oa=b), U2.3 (Ia=b)
unnamed: U1.5 (Oa>b), U2.4 (Ia>b)
unnamed: U2.7 (Oa<b), U3.2 (Ia<b)
unnamed: U2.6 (Oa=b), U3.3 (Ia=b)
unnamed: U2.5 (Oa>b), U3.4 (Ia>b)
unnamed: U3.7 (Oa<b), U4.2 (Ia<b)
unnamed: U3.6 (Oa=b), U4.3 (Ia=b)
unnamed: U3.5 (Oa>b), U4.4 (Ia>b)

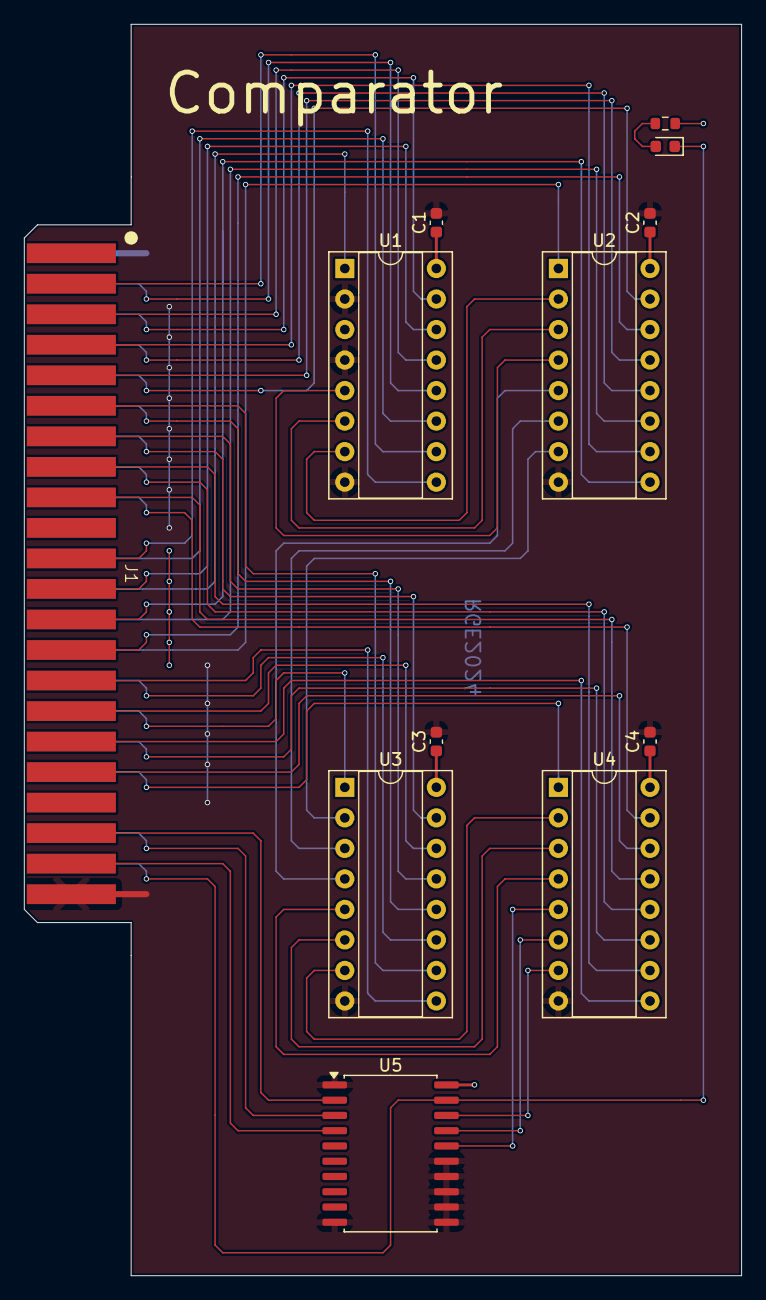
[picture p40: board Comparator.kicad_pcb from above]

Board: 2 copper layers, 59.7 x 104.1 mm, 12 parts (0 on the bottom side), 51 nets.
