freesurfer-rge/slothpu16/pcbs/Adder Subtractor/Adder Subtractor.kicad_pcb

## KiCad design pcbs/Adder Subtractor/Adder Subtractor.kicad_pcb (2024-12-24)

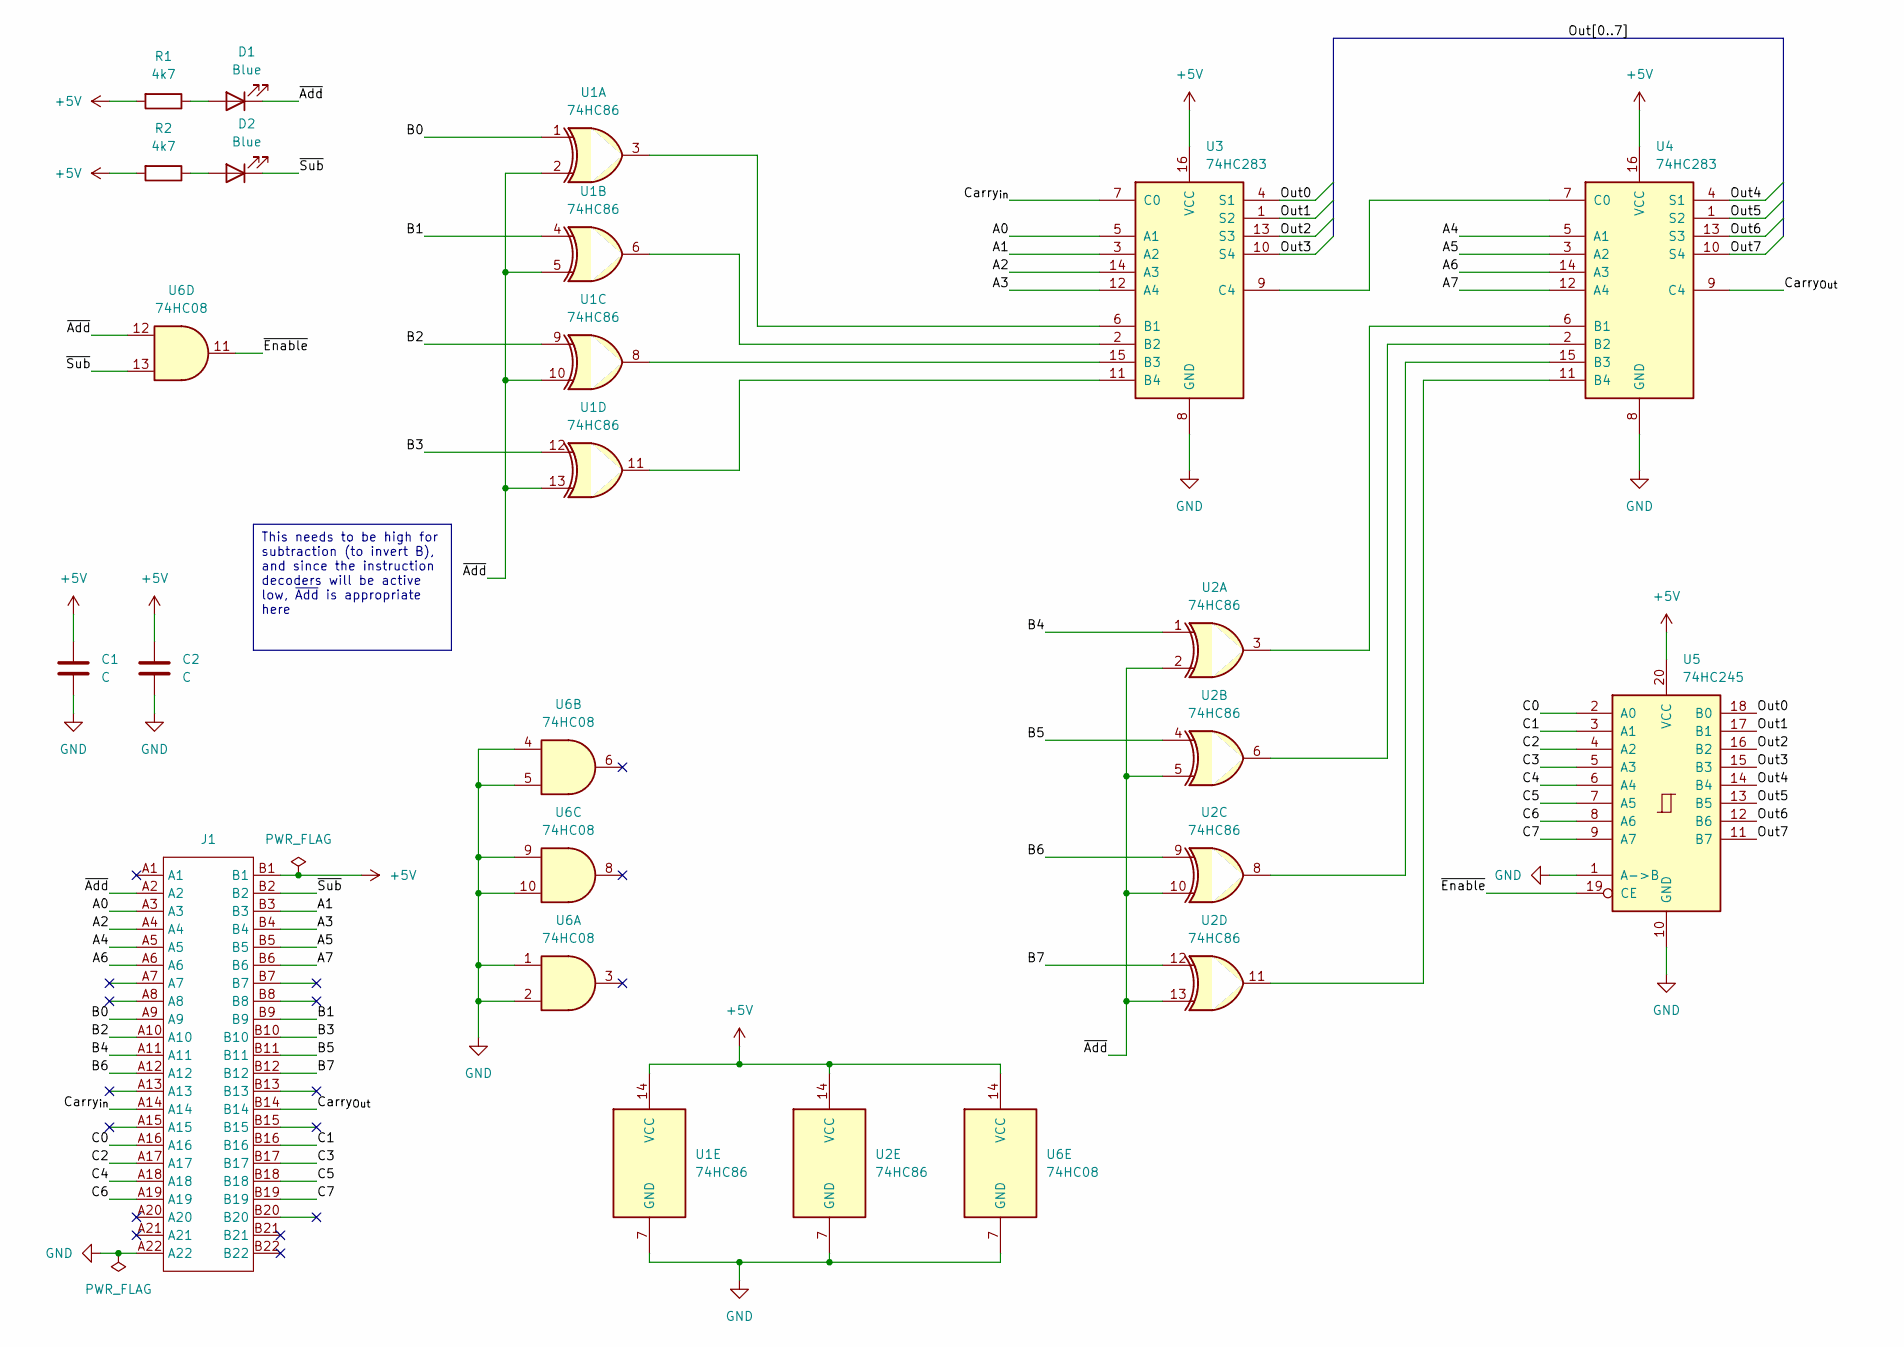
[picture p41: schematic Adder Subtractor.kicad_sch]

Parts:
C1, C2: C; C_0603_1608Metric; LCSC C14663
D1, D2: Blue; LED_0603_1608Metric; LCSC C72041
J1: TE-5530843-4-Edge
R1, R2: 4k7; R_0603_1608Metric; LCSC C23162
U1, U2: 74HC86; DIP-14_W7.62mm_Socket
U3, U4: 74HC283; DIP-16_W7.62mm_Socket
U5: 74HC245; SOIC-20W_7.5x12.8mm_P1.27mm; LCSC C5625
U6: 74HC08; SOIC-14_3.9x8.7mm_P1.27mm; LCSC C5593

Connections:
+5V: C1.1, C2.1, J1.B1, R1.2, R2.2, U1.14 (VCC), U2.14 (VCC), U3.16 (VCC), U4.16 (VCC), U5.20 (VCC), U6.14 (VCC)
/A0: J1.A3, U3.5 (A1)
/A1: J1.B3, U3.3 (A2)
/A2: J1.A4, U3.14 (A3)
/A3: J1.B4, U3.12 (A4)
/A4: J1.A5, U4.5 (A1)
/A5: J1.B5, U4.3 (A2)
/A6: J1.A6, U4.14 (A3)
/A7: J1.B6, U4.12 (A4)
/B0: J1.A9, U1.1
/B1: J1.B9, U1.4
/B2: J1.A10, U1.9
/B3: J1.B10, U1.12
/B4: J1.A11, U2.1
/B5: J1.B11, U2.4
/B6: J1.A12, U2.9
/B7: J1.B12, U2.12
/C0: J1.A16, U5.2 (A0)
/C1: J1.B16, U5.3 (A1)
/C2: J1.A17, U5.4 (A2)
/C3: J1.B17, U5.5 (A3)
/C4: J1.A18, U5.6 (A4)
/C5: J1.B18, U5.7 (A5)
/C6: J1.A19, U5.8 (A6)
/C7: J1.B19, U5.9 (A7)
/Carry_{Out}: J1.B14, U4.9 (C4)
/Carry_{in}: J1.A14, U3.7 (C0)
/Out0: U3.4 (S1), U5.18 (B0)
/Out1: U3.1 (S2), U5.17 (B1)
/Out2: U3.13 (S3), U5.16 (B2)
/Out3: U3.10 (S4), U5.15 (B3)
/Out4: U4.4 (S1), U5.14 (B4)
/Out5: U4.1 (S2), U5.13 (B5)
/Out6: U4.13 (S3), U5.12 (B6)
/Out7: U4.10 (S4), U5.11 (B7)
/~Add: D1.1 (K), J1.A2, U1.2, U1.5, U1.10, U1.13, U2.2, U2.5, U2.10, U2.13, U6.12
/~Enable: U5.19 (CE), U6.11
/~Sub: D2.1 (K), J1.B2, U6.13
GND: C1.2, C2.2, J1.A22, U1.7 (GND), U2.7 (GND), U3.8 (GND), U4.8 (GND), U5.1 (A->B), U5.10 (GND), U6.1, U6.2, U6.4, U6.5, U6.7 (GND), U6.9, U6.10
unnamed: D1.2 (A), R1.1
unnamed: D2.2 (A), R2.1
unnamed: U1.3, U3.6 (B1)
unnamed: U1.6, U3.2 (B2)
unnamed: U1.8, U3.15 (B3)
unnamed: U1.11, U3.11 (B4)
unnamed: U3.9 (C4), U4.7 (C0)
unnamed: U2.3, U4.6 (B1)
unnamed: U2.6, U4.2 (B2)
unnamed: U2.8, U4.15 (B3)
unnamed: U2.11, U4.11 (B4)

Notes on the sheet:
This needs to be high for subtraction (to invert B), and since the instruction decoders will be active low, ~{Add} is appropriate here

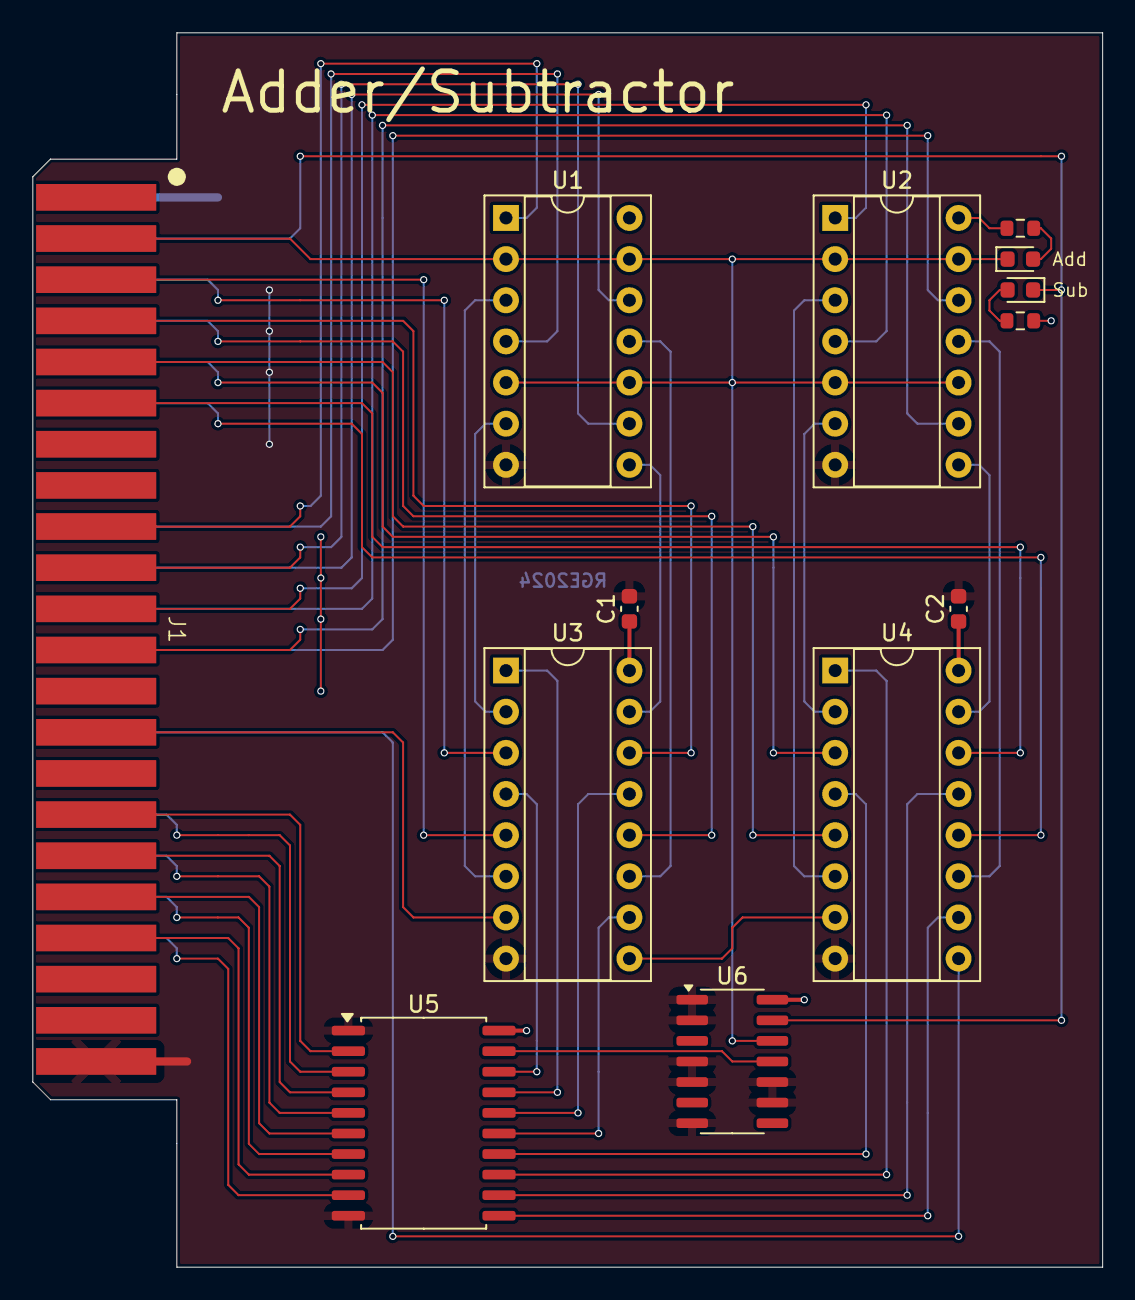
[picture p42: board Adder Subtractor.kicad_pcb from above]

Board: 2 copper layers, 66.0 x 76.2 mm, 13 parts (0 on the bottom side), 50 nets.
