freesurfer-rge/slothpu16/pcbs/Barrel Shifter Connector/Barrel Shifter Connector.kicad_pcb

## KiCad design pcbs/Barrel Shifter Connector/Barrel Shifter Connector.kicad_pcb (2024-12-08)

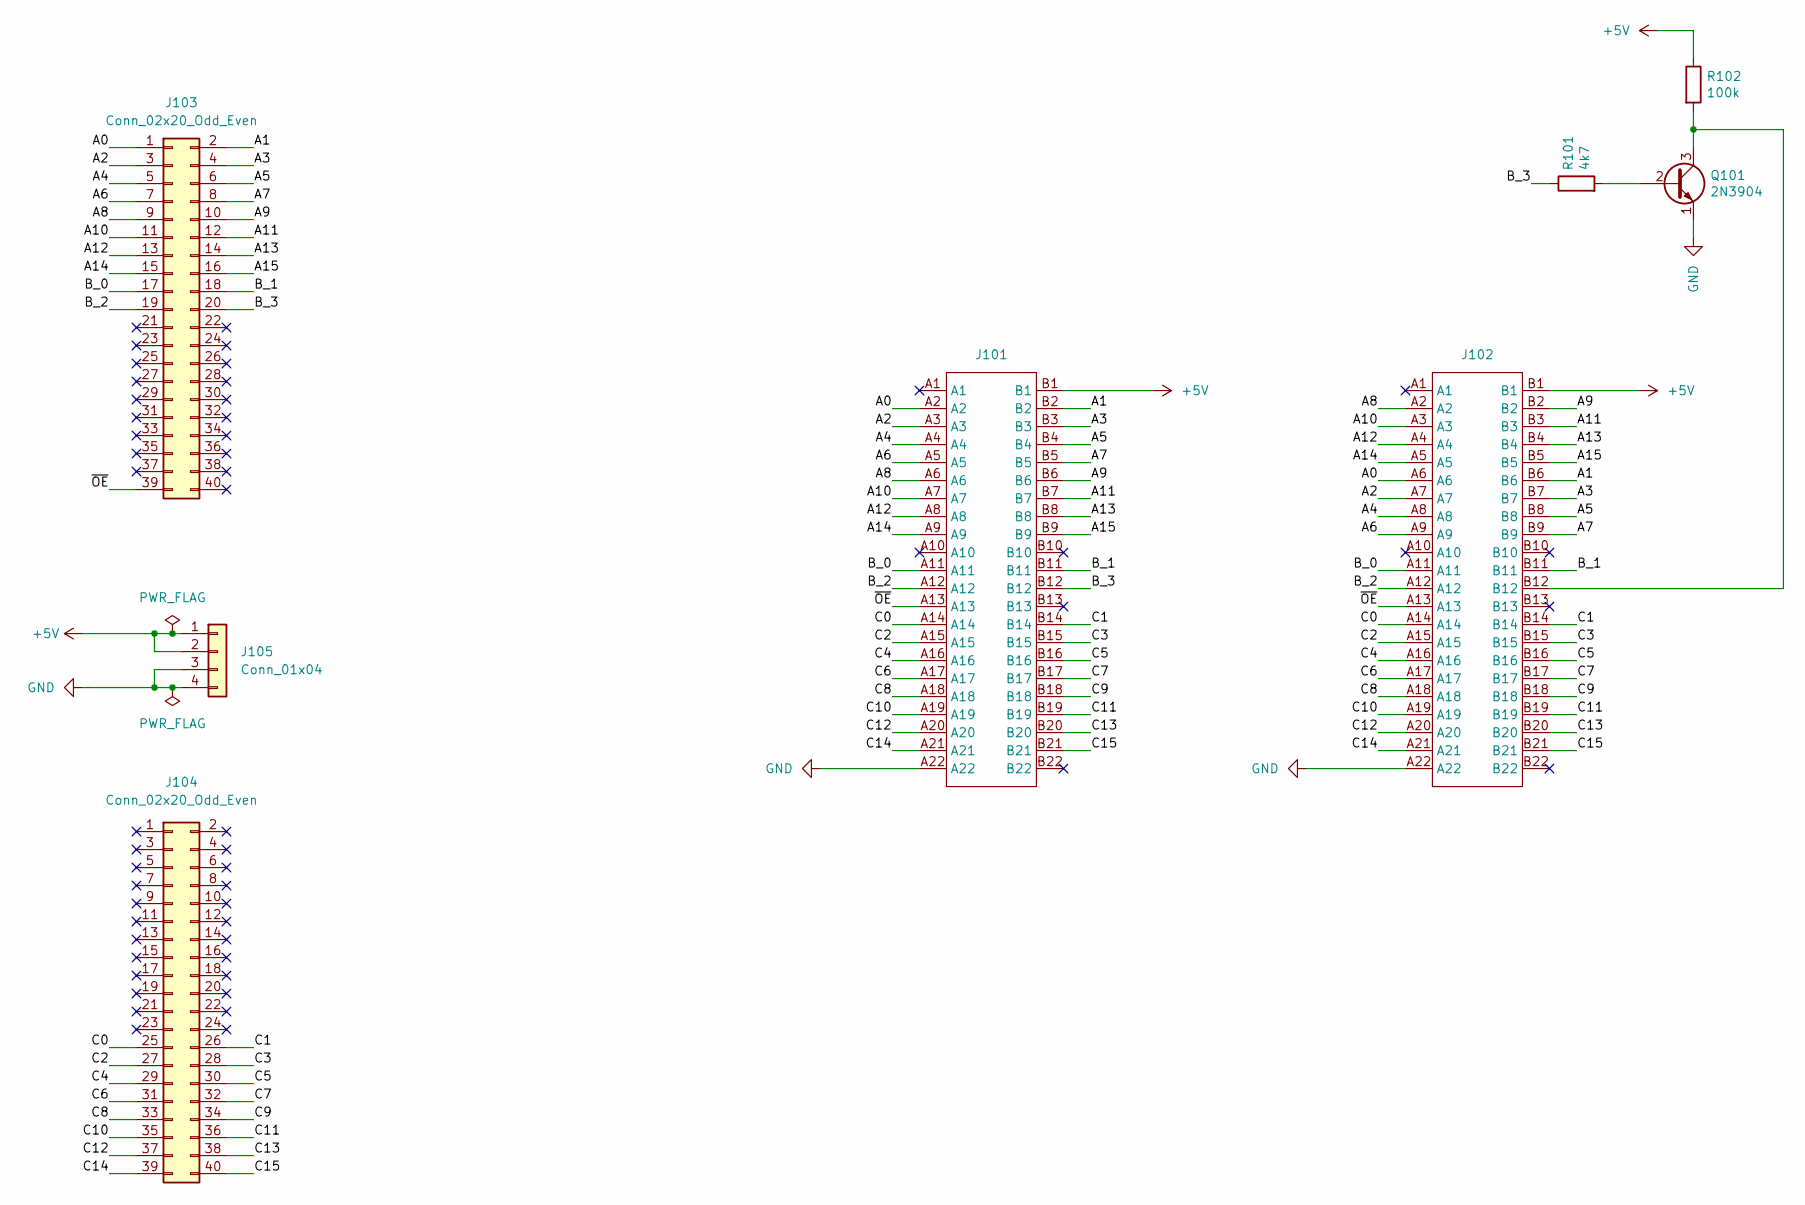
[picture p43: schematic Barrel Shifter Connector.kicad_sch]

Parts:
J101, J102: TE-5530843-4-Mount
J103, J104: Conn_02x20_Odd_Even; PinHeader_2x20_P2.54mm_Vertical
J105: Conn_01x04; PinHeader_1x04_P2.54mm_Vertical
Q101: 2N3904; TO-92_Wide
R101: 4k7; R_Axial_DIN0207_L6.3mm_D2.5mm_P7.62mm_Horizontal
R102: 100k; R_Axial_DIN0207_L6.3mm_D2.5mm_P7.62mm_Horizontal

Connections:
+5V: J101.B1, J102.B1, J105.1, J105.2, R102.1
/A0: J101.A2, J102.A6, J103.1
/A1: J101.B2, J102.B6, J103.2
/A2: J101.A3, J102.A7, J103.3
/A3: J101.B3, J102.B7, J103.4
/A4: J101.A4, J102.A8, J103.5
/A5: J101.B4, J102.B8, J103.6
/A6: J101.A5, J102.A9, J103.7
/A7: J101.B5, J102.B9, J103.8
/A8: J101.A6, J102.A2, J103.9
/A9: J101.B6, J102.B2, J103.10
/A10: J101.A7, J102.A3, J103.11
/A11: J101.B7, J102.B3, J103.12
/A12: J101.A8, J102.A4, J103.13
/A13: J101.B8, J102.B4, J103.14
/A14: J101.A9, J102.A5, J103.15
/A15: J101.B9, J102.B5, J103.16
/B_0: J101.A11, J102.A11, J103.17
/B_1: J101.B11, J102.B11, J103.18
/B_2: J101.A12, J102.A12, J103.19
/B_3: J101.B12, J103.20, R101.1
/C0: J101.A14, J102.A14, J104.25
/C1: J101.B14, J102.B14, J104.26
/C2: J101.A15, J102.A15, J104.27
/C3: J101.B15, J102.B15, J104.28
/C4: J101.A16, J102.A16, J104.29
/C5: J101.B16, J102.B16, J104.30
/C6: J101.A17, J102.A17, J104.31
/C7: J101.B17, J102.B17, J104.32
/C8: J101.A18, J102.A18, J104.33
/C9: J101.B18, J102.B18, J104.34
/C10: J101.A19, J102.A19, J104.35
/C11: J101.B19, J102.B19, J104.36
/C12: J101.A20, J102.A20, J104.37
/C13: J101.B20, J102.B20, J104.38
/C14: J101.A21, J102.A21, J104.39
/C15: J101.B21, J102.B21, J104.40
/~OE: J101.A13, J102.A13, J103.39
GND: J101.A22, J102.A22, J105.3, J105.4, Q101.1 (E)
unnamed: Q101.2 (B), R101.2
unnamed: J102.B12, Q101.3 (C), R102.2

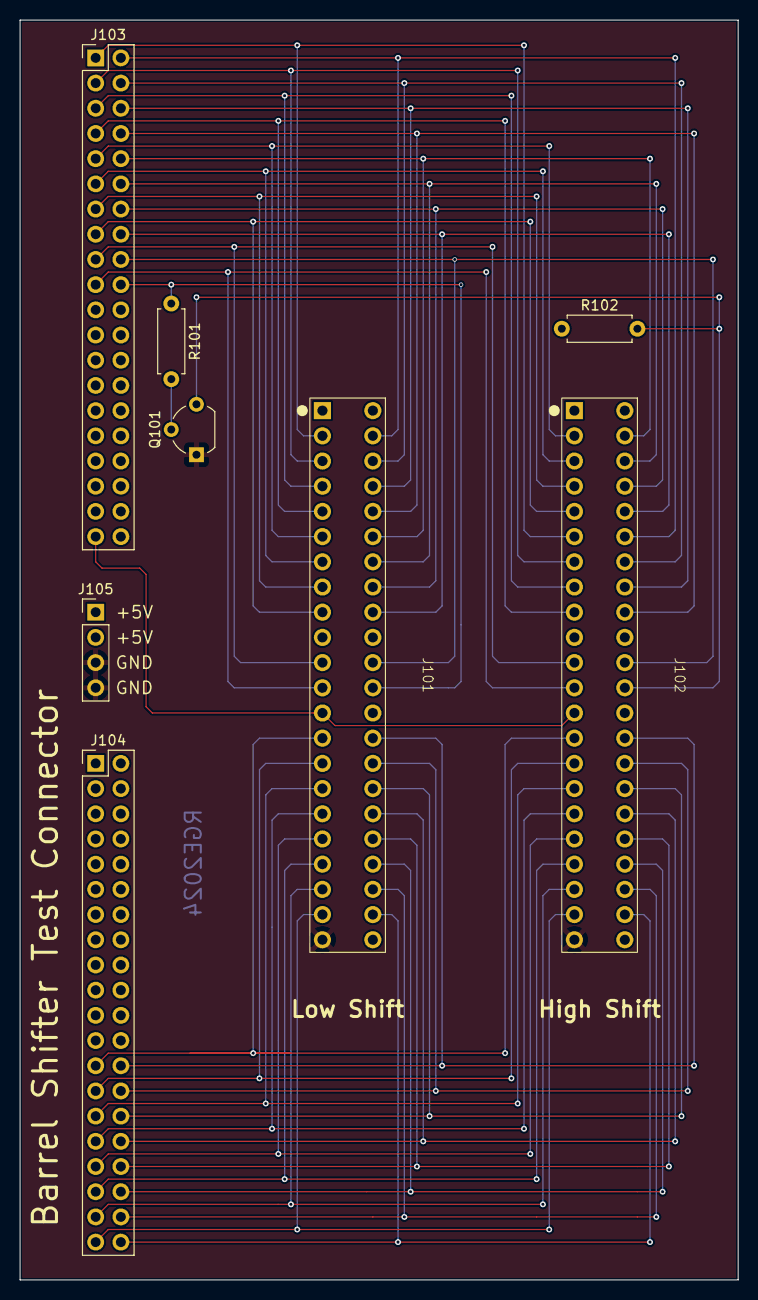
[picture p44: board Barrel Shifter Connector.kicad_pcb from above]

Board: 2 copper layers, 72.4 x 127.0 mm, 8 parts (0 on the bottom side), 41 nets.
