freesurfer-rge/slothpu16/pcbs/Register File Connector/Register File Connector.kicad_pcb

## KiCad design pcbs/Register File Connector/Register File Connector.kicad_pcb (2024-12-08)

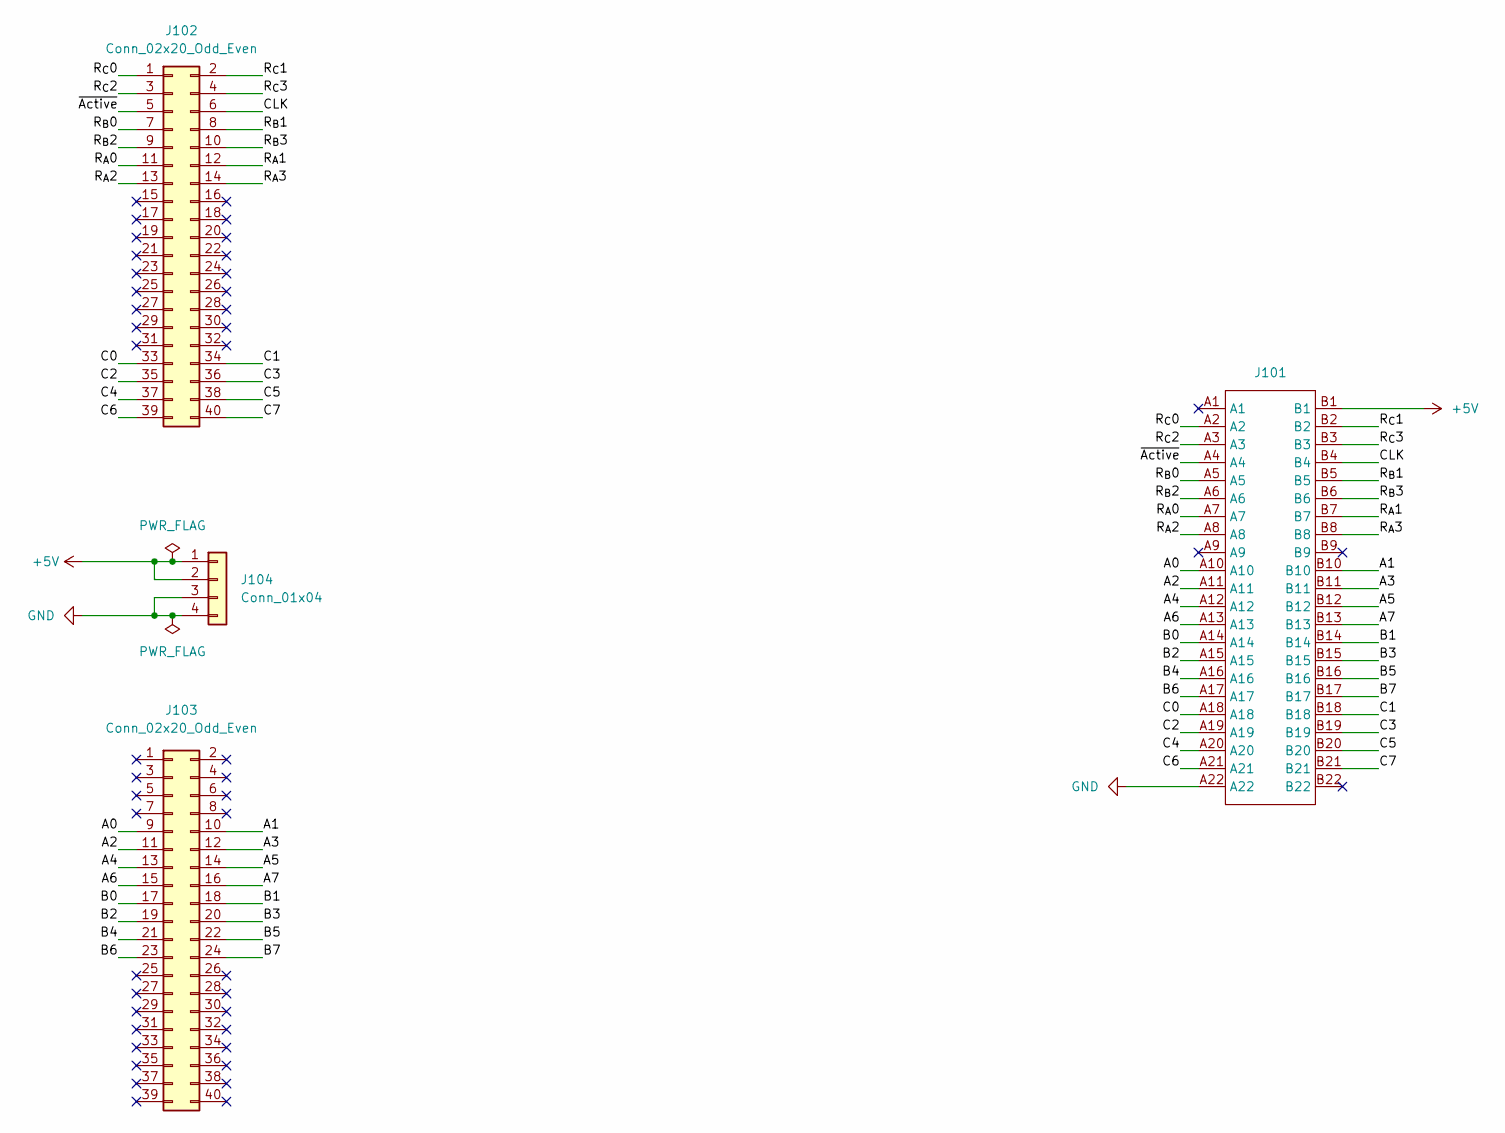
[picture p45: schematic Register File Connector.kicad_sch]

Parts:
J101: TE-5530843-4-Mount
J102, J103: Conn_02x20_Odd_Even; PinHeader_2x20_P2.54mm_Vertical
J104: Conn_01x04; PinHeader_1x04_P2.54mm_Vertical

Connections:
+5V: J101.B1, J104.1, J104.2
/A0: J101.A10, J103.9
/A1: J101.B10, J103.10
/A2: J101.A11, J103.11
/A3: J101.B11, J103.12
/A4: J101.A12, J103.13
/A5: J101.B12, J103.14
/A6: J101.A13, J103.15
/A7: J101.B13, J103.16
/B0: J101.A14, J103.17
/B1: J101.B14, J103.18
/B2: J101.A15, J103.19
/B3: J101.B15, J103.20
/B4: J101.A16, J103.21
/B5: J101.B16, J103.22
/B6: J101.A17, J103.23
/B7: J101.B17, J103.24
/C0: J101.A18, J102.33
/C1: J101.B18, J102.34
/C2: J101.A19, J102.35
/C3: J101.B19, J102.36
/C4: J101.A20, J102.37
/C5: J101.B20, J102.38
/C6: J101.A21, J102.39
/C7: J101.B21, J102.40
/CLK: J101.B4, J102.6
/R_{A}0: J101.A7, J102.11
/R_{A}1: J101.B7, J102.12
/R_{A}2: J101.A8, J102.13
/R_{A}3: J101.B8, J102.14
/R_{B}0: J101.A5, J102.7
/R_{B}1: J101.B5, J102.8
/R_{B}2: J101.A6, J102.9
/R_{B}3: J101.B6, J102.10
/R_{C}0: J101.A2, J102.1
/R_{C}1: J101.B2, J102.2
/R_{C}2: J101.A3, J102.3
/R_{C}3: J101.B3, J102.4
/~Active: J101.A4, J102.5
GND: J101.A22, J104.3, J104.4
