freesurfer-rge/slothpu16/pcbs/Register File Connector/Register File Connector.kicad_pcb

## KiCad design pcbs/Register File Connector/Register File Connector.kicad_pcb (continued)

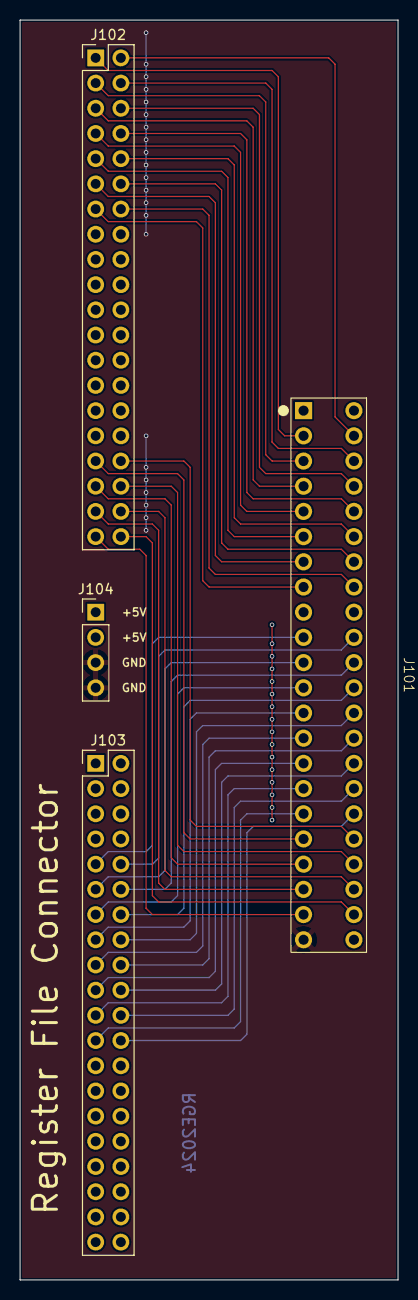
[picture p46: board Register File Connector.kicad_pcb from above]

Board: 2 copper layers, 38.1 x 127.0 mm, 4 parts (0 on the bottom side), 40 nets.
