freesurfer-rge/slothpu16/pcbs/Register File/Register File.kicad_pcb

## KiCad design pcbs/Register File/Register File.kicad_pcb (2024-12-08)

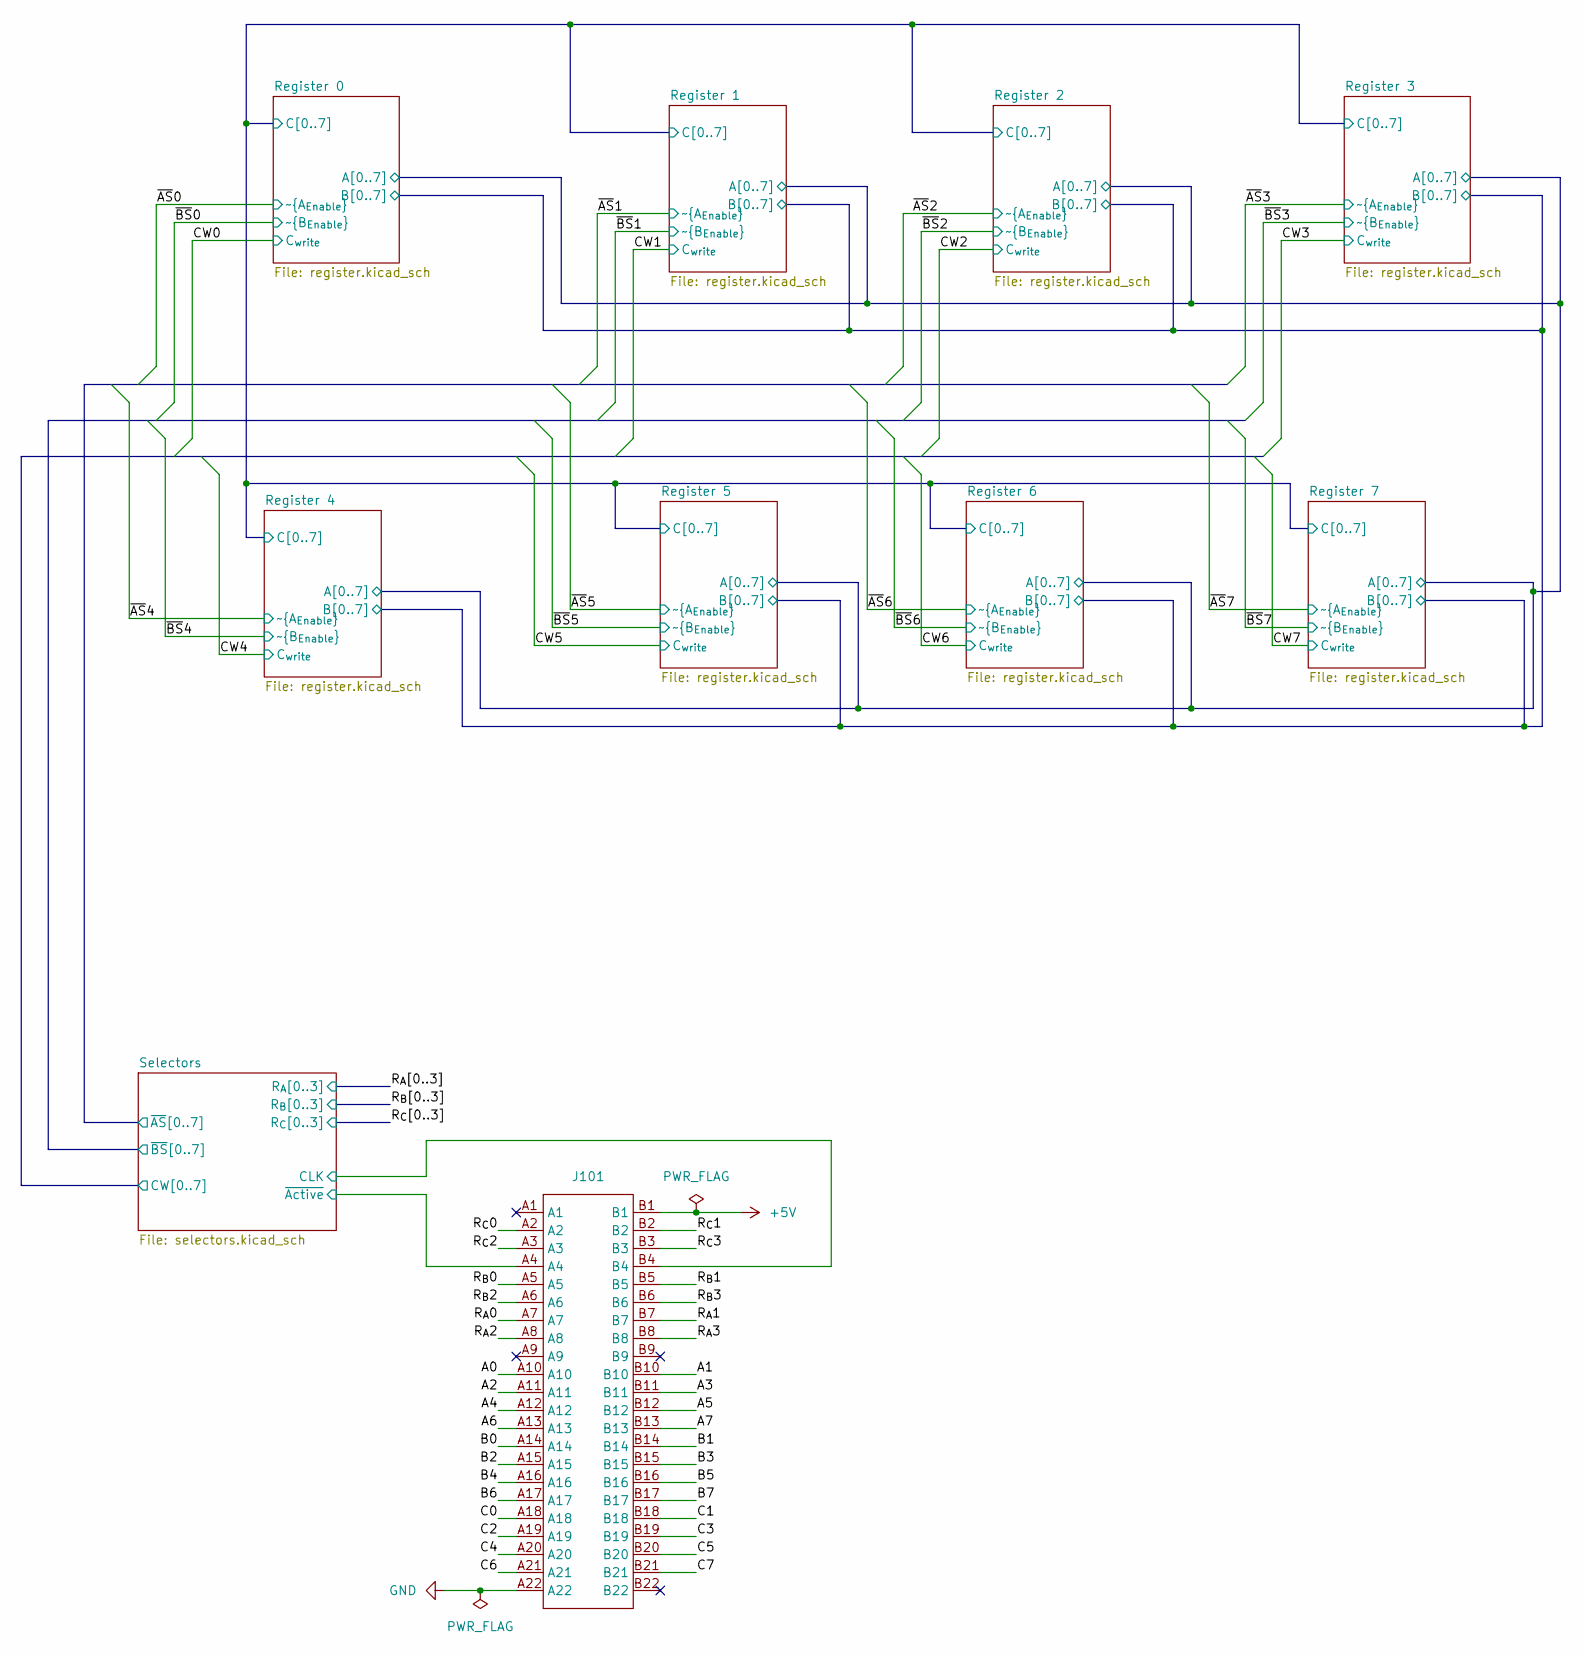
[picture p47: schematic Register File.kicad_sch]

Parts:
J101: TE-5530843-4-Edge

Connections:
+5V: J101.B1; also elsewhere on the board
/R_{A}0: J101.A7; also elsewhere on the board
/R_{A}1: J101.B7; also elsewhere on the board
/R_{A}2: J101.A8; also elsewhere on the board
/R_{A}3: J101.B8; also elsewhere on the board
/R_{B}0: J101.A5; also elsewhere on the board
/R_{B}1: J101.B5; also elsewhere on the board
/R_{B}2: J101.A6; also elsewhere on the board
/R_{B}3: J101.B6; also elsewhere on the board
/R_{C}0: J101.A2; also elsewhere on the board
/R_{C}1: J101.B2; also elsewhere on the board
/R_{C}2: J101.A3; also elsewhere on the board
/R_{C}3: J101.B3; also elsewhere on the board
/Register 0/A0: J101.A10; also elsewhere on the board
/Register 0/A1: J101.B10; also elsewhere on the board
/Register 0/A2: J101.A11; also elsewhere on the board
/Register 0/A3: J101.B11; also elsewhere on the board
/Register 0/A4: J101.A12; also elsewhere on the board
/Register 0/A5: J101.B12; also elsewhere on the board
/Register 0/A6: J101.A13; also elsewhere on the board
/Register 0/A7: J101.B13; also elsewhere on the board
/Register 0/B0: J101.A14; also elsewhere on the board
/Register 0/B1: J101.B14; also elsewhere on the board
/Register 0/B2: J101.A15; also elsewhere on the board
/Register 0/B3: J101.B15; also elsewhere on the board
/Register 0/B4: J101.A16; also elsewhere on the board
/Register 0/B5: J101.B16; also elsewhere on the board
/Register 0/B6: J101.A17; also elsewhere on the board
/Register 0/B7: J101.B17; also elsewhere on the board
/Register 0/C0: J101.A18; also elsewhere on the board
/Register 0/C1: J101.B18; also elsewhere on the board
/Register 0/C2: J101.A19; also elsewhere on the board
/Register 0/C3: J101.B19; also elsewhere on the board
/Register 0/C4: J101.A20; also elsewhere on the board
/Register 0/C5: J101.B20; also elsewhere on the board
/Register 0/C6: J101.A21; also elsewhere on the board
/Register 0/C7: J101.B21; also elsewhere on the board
/Selectors/CLK: J101.B4; also elsewhere on the board
/Selectors/~Active: J101.A4; also elsewhere on the board
GND: J101.A22; also elsewhere on the board

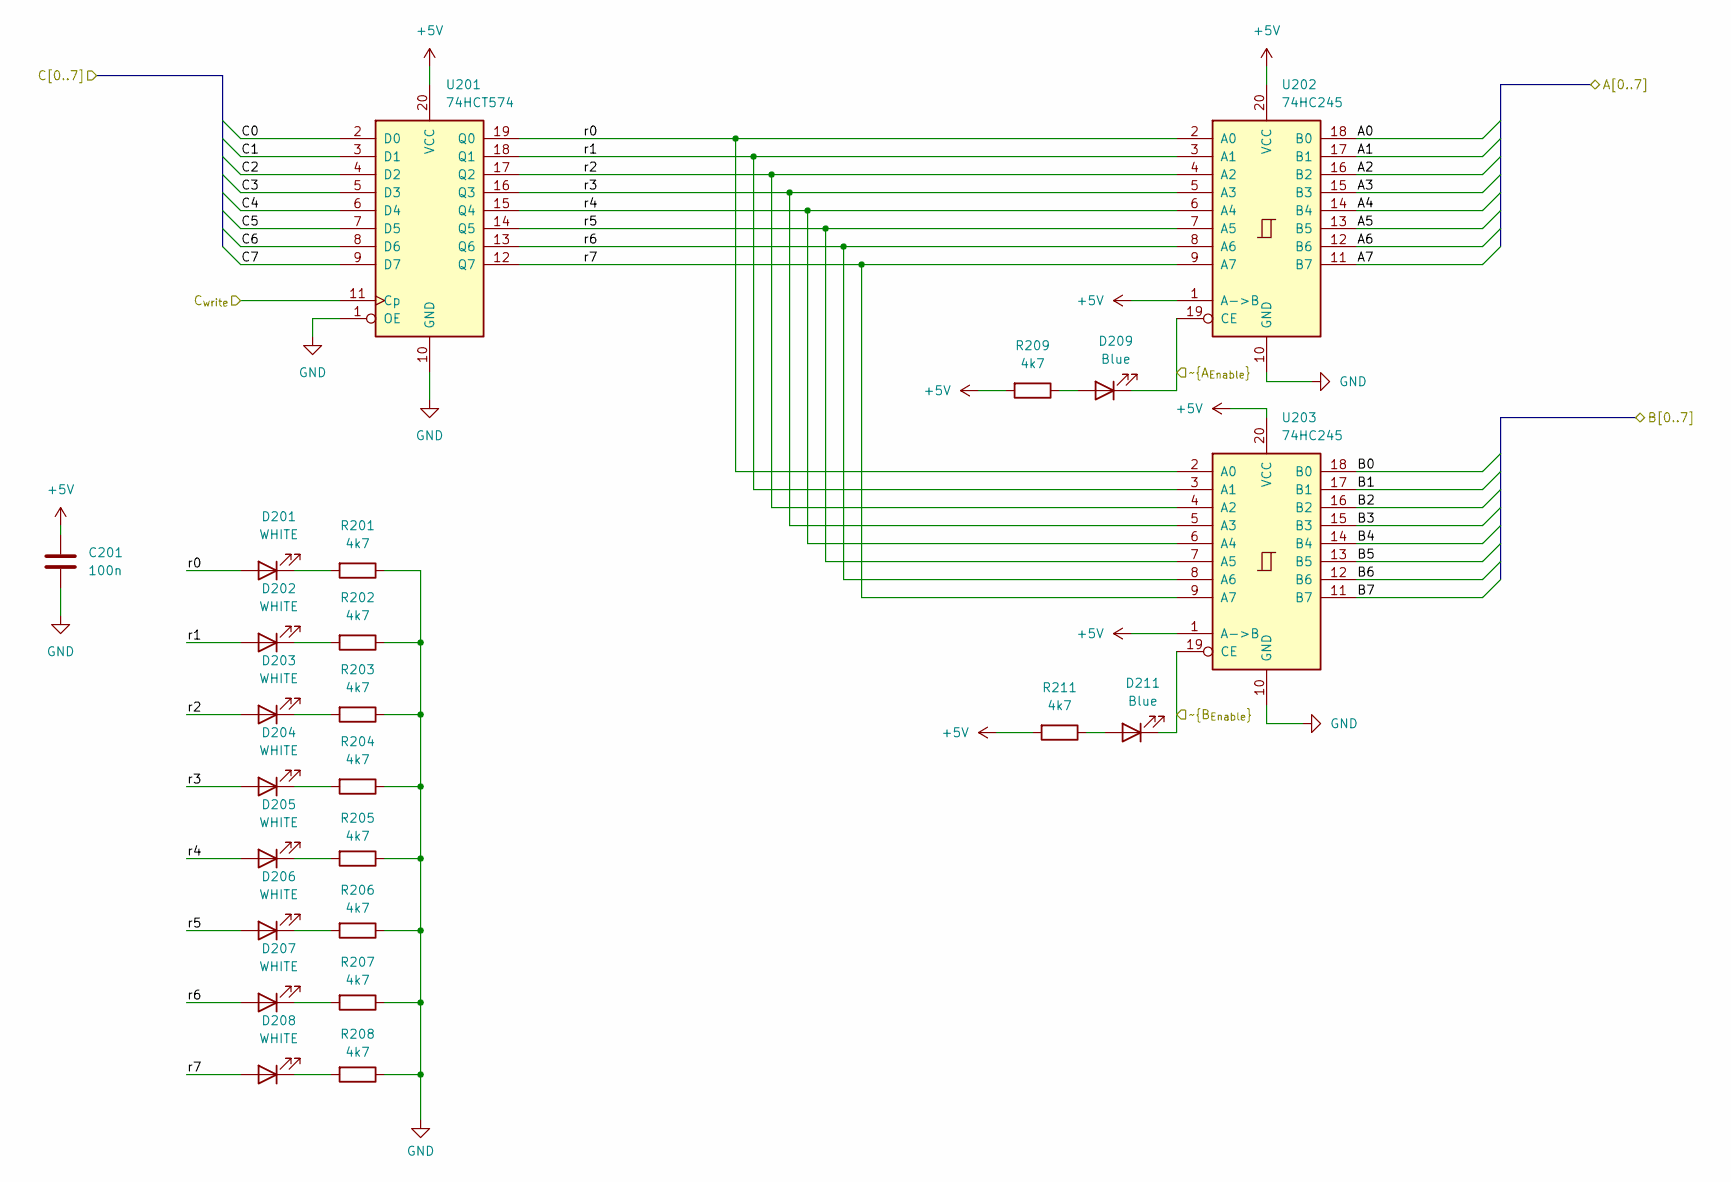
[picture p48: schematic register.kicad_sch]

Parts:
C201: 100n; C_0603_1608Metric; LCSC C14663
D201, D202, D203, D204, D205, D206, D207, D208: WHITE; LED_0603_1608Metric; LCSC C2290
D209, D211: Blue; LED_0603_1608Metric; LCSC C72041
R201, R202, R203, R204, R205, R206, R207, R208, R209, R211: 4k7; R_0603_1608Metric; LCSC C23162
U201: 74HCT574; DIP-20_W7.62mm_Socket
U202, U203: 74HC245; SOIC-20W_7.5x12.8mm_P1.27mm; LCSC C5625

Connections:
+5V: C201.1, R209.2, R211.2, U201.20 (VCC), U202.1 (A->B), U202.20 (VCC), U203.1 (A->B), U203.20 (VCC); also elsewhere on the board
/Register 0/A0: U202.18 (B0); also elsewhere on the board
/Register 0/A1: U202.17 (B1); also elsewhere on the board
/Register 0/A2: U202.16 (B2); also elsewhere on the board
/Register 0/A3: U202.15 (B3); also elsewhere on the board
/Register 0/A4: U202.14 (B4); also elsewhere on the board
/Register 0/A5: U202.13 (B5); also elsewhere on the board
/Register 0/A6: U202.12 (B6); also elsewhere on the board
/Register 0/A7: U202.11 (B7); also elsewhere on the board
/Register 0/B0: U203.18 (B0); also elsewhere on the board
/Register 0/B1: U203.17 (B1); also elsewhere on the board
/Register 0/B2: U203.16 (B2); also elsewhere on the board
/Register 0/B3: U203.15 (B3); also elsewhere on the board
/Register 0/B4: U203.14 (B4); also elsewhere on the board
/Register 0/B5: U203.13 (B5); also elsewhere on the board
/Register 0/B6: U203.12 (B6); also elsewhere on the board
/Register 0/B7: U203.11 (B7); also elsewhere on the board
/Register 0/C0: U201.2 (D0); also elsewhere on the board
/Register 0/C1: U201.3 (D1); also elsewhere on the board
/Register 0/C2: U201.4 (D2); also elsewhere on the board
/Register 0/C3: U201.5 (D3); also elsewhere on the board
/Register 0/C4: U201.6 (D4); also elsewhere on the board
/Register 0/C5: U201.7 (D5); also elsewhere on the board
/Register 0/C6: U201.8 (D6); also elsewhere on the board
/Register 0/C7: U201.9 (D7); also elsewhere on the board
/Register 0/r0: D201.2 (A), U201.19 (Q0), U202.2 (A0), U203.2 (A0)
/Register 0/r1: D202.2 (A), U201.18 (Q1), U202.3 (A1), U203.3 (A1)
/Register 0/r2: D203.2 (A), U201.17 (Q2), U202.4 (A2), U203.4 (A2)
/Register 0/r3: D204.2 (A), U201.16 (Q3), U202.5 (A3), U203.5 (A3)
/Register 0/r4: D205.2 (A), U201.15 (Q4), U202.6 (A4), U203.6 (A4)
/Register 0/r5: D206.2 (A), U201.14 (Q5), U202.7 (A5), U203.7 (A5)
/Register 0/r6: D207.2 (A), U201.13 (Q6), U202.8 (A6), U203.8 (A6)
/Register 0/r7: D208.2 (A), U201.12 (Q7), U202.9 (A7), U203.9 (A7)
/Selectors/CW0: U201.11 (Cp); also elsewhere on the board
/Selectors/~AS0: D209.1 (K), U202.19 (CE); also elsewhere on the board
/Selectors/~BS0: D211.1 (K), U203.19 (CE); also elsewhere on the board
GND: C201.2, R201.1, R202.1, R203.1, R204.1, R205.1, R206.1, R207.1, R208.1, U201.1 (OE), U201.10 (GND), U202.10 (GND), U203.10 (GND); also elsewhere on the board
unnamed: D201.1 (K), R201.2
unnamed: D202.1 (K), R202.2
unnamed: D203.1 (K), R203.2
unnamed: D204.1 (K), R204.2
unnamed: D205.1 (K), R205.2
unnamed: D206.1 (K), R206.2
unnamed: D207.1 (K), R207.2
unnamed: D208.1 (K), R208.2
unnamed: D209.2 (A), R209.1
unnamed: D211.2 (A), R211.1

Parts of its further copies:
C301, C401, C501, C601, C701, C801, C901: 100n; C_0603_1608Metric; LCSC C14663
D301, D302, D303, D304, D305, D306, D307, D308, D401, D402, D403, D404, D405, D406, D407, D408, D501, D502, D503, D504, D505, D506, D507, D508, D601, D602, D603, D604, D605, D606, D607, D608, D701, D702, D703, D704, D705, D706, D707, D708, D801, D802, D803, D804, D805, D806, D807, D808, D901, D902, D903, D904, D905, D906, D907, D908: WHITE; LED_0603_1608Metric; LCSC C2290
D309, D310, D409, D410, D509, D510, D609, D610, D709, D710, D809, D810, D909, D910: Blue; LED_0603_1608Metric; LCSC C72041
R301, R302, R303, R304, R305, R306, R307, R308, R309, R310, R401, R402, R403, R404, R405, R406, R407, R408, R409, R410, R501, R502, R503, R504, R505, R506, R507, R508, R509, R510, R601, R602, R603, R604, R605, R606, R607, R608, R609, R610, R701, R702, R703, R704, R705, R706, R707, R708, R709, R710, R801, R802, R803, R804, R805, R806, R807, R808, R809, R810, R901, R902, R903, R904, R905, R906, R907, R908, R909, R910: 4k7; R_0603_1608Metric; LCSC C23162
U301, U401, U501, U601, U701, U801, U901: 74HCT574; DIP-20_W7.62mm_Socket
U302, U303, U402, U403, U502, U503, U602, U603, U702, U703, U802, U803, U902, U903: 74HC245; SOIC-20W_7.5x12.8mm_P1.27mm; LCSC C5625

Connections of its further copies:
+5V: C301.1, C401.1, C501.1, C601.1, C701.1, C801.1, C901.1, R309.2, R310.2, R409.2, R410.2, R509.2, R510.2, R609.2, R610.2, R709.2, R710.2, R809.2, R810.2, R909.2, R910.2, U301.20 (VCC), U302.1 (A->B), U302.20 (VCC), U303.1 (A->B), U303.20 (VCC), U401.20 (VCC), U402.1 (A->B), U402.20 (VCC), U403.1 (A->B), U403.20 (VCC), U501.20 (VCC), U502.1 (A->B), U502.20 (VCC), U503.1 (A->B), U503.20 (VCC), U601.20 (VCC), U602.1 (A->B), U602.20 (VCC), U603.1 (A->B), U603.20 (VCC), U701.20 (VCC), U702.1 (A->B), U702.20 (VCC), U703.1 (A->B), U703.20 (VCC), U801.20 (VCC), U802.1 (A->B), U802.20 (VCC), U803.1 (A->B), U803.20 (VCC), U901.20 (VCC), U902.1 (A->B), U902.20 (VCC), U903.1 (A->B), U903.20 (VCC); also elsewhere on the board
/Register 0/A0: U302.18 (B0), U402.18 (B0), U502.18 (B0), U602.18 (B0), U702.18 (B0), U802.18 (B0), U902.18 (B0); also elsewhere on the board
/Register 0/A1: U302.17 (B1), U402.17 (B1), U502.17 (B1), U602.17 (B1), U702.17 (B1), U802.17 (B1), U902.17 (B1); also elsewhere on the board
/Register 0/A2: U302.16 (B2), U402.16 (B2), U502.16 (B2), U602.16 (B2), U702.16 (B2), U802.16 (B2), U902.16 (B2); also elsewhere on the board
/Register 0/A3: U302.15 (B3), U402.15 (B3), U502.15 (B3), U602.15 (B3), U702.15 (B3), U802.15 (B3), U902.15 (B3); also elsewhere on the board
/Register 0/A4: U302.14 (B4), U402.14 (B4), U502.14 (B4), U602.14 (B4), U702.14 (B4), U802.14 (B4), U902.14 (B4); also elsewhere on the board
/Register 0/A5: U302.13 (B5), U402.13 (B5), U502.13 (B5), U602.13 (B5), U702.13 (B5), U802.13 (B5), U902.13 (B5); also elsewhere on the board
/Register 0/A6: U302.12 (B6), U402.12 (B6), U502.12 (B6), U602.12 (B6), U702.12 (B6), U802.12 (B6), U902.12 (B6); also elsewhere on the board
/Register 0/A7: U302.11 (B7), U402.11 (B7), U502.11 (B7), U602.11 (B7), U702.11 (B7), U802.11 (B7), U902.11 (B7); also elsewhere on the board
/Register 0/B0: U303.18 (B0), U403.18 (B0), U503.18 (B0), U603.18 (B0), U703.18 (B0), U803.18 (B0), U903.18 (B0); also elsewhere on the board
/Register 0/B1: U303.17 (B1), U403.17 (B1), U503.17 (B1), U603.17 (B1), U703.17 (B1), U803.17 (B1), U903.17 (B1); also elsewhere on the board
/Register 0/B2: U303.16 (B2), U403.16 (B2), U503.16 (B2), U603.16 (B2), U703.16 (B2), U803.16 (B2), U903.16 (B2); also elsewhere on the board
/Register 0/B3: U303.15 (B3), U403.15 (B3), U503.15 (B3), U603.15 (B3), U703.15 (B3), U803.15 (B3), U903.15 (B3); also elsewhere on the board
/Register 0/B4: U303.14 (B4), U403.14 (B4), U503.14 (B4), U603.14 (B4), U703.14 (B4), U803.14 (B4), U903.14 (B4); also elsewhere on the board
/Register 0/B5: U303.13 (B5), U403.13 (B5), U503.13 (B5), U603.13 (B5), U703.13 (B5), U803.13 (B5), U903.13 (B5); also elsewhere on the board
/Register 0/B6: U303.12 (B6), U403.12 (B6), U503.12 (B6), U603.12 (B6), U703.12 (B6), U803.12 (B6), U903.12 (B6); also elsewhere on the board
/Register 0/B7: U303.11 (B7), U403.11 (B7), U503.11 (B7), U603.11 (B7), U703.11 (B7), U803.11 (B7), U903.11 (B7); also elsewhere on the board
/Register 0/C0: U301.2 (D0), U401.2 (D0), U501.2 (D0), U601.2 (D0), U701.2 (D0), U801.2 (D0), U901.2 (D0); also elsewhere on the board
/Register 0/C1: U301.3 (D1), U401.3 (D1), U501.3 (D1), U601.3 (D1), U701.3 (D1), U801.3 (D1), U901.3 (D1); also elsewhere on the board
/Register 0/C2: U301.4 (D2), U401.4 (D2), U501.4 (D2), U601.4 (D2), U701.4 (D2), U801.4 (D2), U901.4 (D2); also elsewhere on the board
/Register 0/C3: U301.5 (D3), U401.5 (D3), U501.5 (D3), U601.5 (D3), U701.5 (D3), U801.5 (D3), U901.5 (D3); also elsewhere on the board
/Register 0/C4: U301.6 (D4), U401.6 (D4), U501.6 (D4), U601.6 (D4), U701.6 (D4), U801.6 (D4), U901.6 (D4); also elsewhere on the board
/Register 0/C5: U301.7 (D5), U401.7 (D5), U501.7 (D5), U601.7 (D5), U701.7 (D5), U801.7 (D5), U901.7 (D5); also elsewhere on the board
/Register 0/C6: U301.8 (D6), U401.8 (D6), U501.8 (D6), U601.8 (D6), U701.8 (D6), U801.8 (D6), U901.8 (D6); also elsewhere on the board
/Register 0/C7: U301.9 (D7), U401.9 (D7), U501.9 (D7), U601.9 (D7), U701.9 (D7), U801.9 (D7), U901.9 (D7); also elsewhere on the board
/Register 1/r0: D301.2 (A), U301.19 (Q0), U302.2 (A0), U303.2 (A0)
/Register 1/r1: D302.2 (A), U301.18 (Q1), U302.3 (A1), U303.3 (A1)
/Register 1/r2: D303.2 (A), U301.17 (Q2), U302.4 (A2), U303.4 (A2)
/Register 1/r3: D304.2 (A), U301.16 (Q3), U302.5 (A3), U303.5 (A3)
/Register 1/r4: D305.2 (A), U301.15 (Q4), U302.6 (A4), U303.6 (A4)
/Register 1/r5: D306.2 (A), U301.14 (Q5), U302.7 (A5), U303.7 (A5)
/Register 1/r6: D307.2 (A), U301.13 (Q6), U302.8 (A6), U303.8 (A6)
/Register 1/r7: D308.2 (A), U301.12 (Q7), U302.9 (A7), U303.9 (A7)
/Register 2/r0: D401.2 (A), U401.19 (Q0), U402.2 (A0), U403.2 (A0)
/Register 2/r1: D402.2 (A), U401.18 (Q1), U402.3 (A1), U403.3 (A1)
/Register 2/r2: D403.2 (A), U401.17 (Q2), U402.4 (A2), U403.4 (A2)
/Register 2/r3: D404.2 (A), U401.16 (Q3), U402.5 (A3), U403.5 (A3)
/Register 2/r4: D405.2 (A), U401.15 (Q4), U402.6 (A4), U403.6 (A4)
/Register 2/r5: D406.2 (A), U401.14 (Q5), U402.7 (A5), U403.7 (A5)
/Register 2/r6: D407.2 (A), U401.13 (Q6), U402.8 (A6), U403.8 (A6)
/Register 2/r7: D408.2 (A), U401.12 (Q7), U402.9 (A7), U403.9 (A7)
/Register 3/r0: D501.2 (A), U501.19 (Q0), U502.2 (A0), U503.2 (A0)
/Register 3/r1: D502.2 (A), U501.18 (Q1), U502.3 (A1), U503.3 (A1)
/Register 3/r2: D503.2 (A), U501.17 (Q2), U502.4 (A2), U503.4 (A2)
/Register 3/r3: D504.2 (A), U501.16 (Q3), U502.5 (A3), U503.5 (A3)
/Register 3/r4: D505.2 (A), U501.15 (Q4), U502.6 (A4), U503.6 (A4)
/Register 3/r5: D506.2 (A), U501.14 (Q5), U502.7 (A5), U503.7 (A5)
/Register 3/r6: D507.2 (A), U501.13 (Q6), U502.8 (A6), U503.8 (A6)
/Register 3/r7: D508.2 (A), U501.12 (Q7), U502.9 (A7), U503.9 (A7)
/Register 4/r0: D601.2 (A), U601.19 (Q0), U602.2 (A0), U603.2 (A0)
/Register 4/r1: D602.2 (A), U601.18 (Q1), U602.3 (A1), U603.3 (A1)
/Register 4/r2: D603.2 (A), U601.17 (Q2), U602.4 (A2), U603.4 (A2)
/Register 4/r3: D604.2 (A), U601.16 (Q3), U602.5 (A3), U603.5 (A3)
/Register 4/r4: D605.2 (A), U601.15 (Q4), U602.6 (A4), U603.6 (A4)
/Register 4/r5: D606.2 (A), U601.14 (Q5), U602.7 (A5), U603.7 (A5)
/Register 4/r6: D607.2 (A), U601.13 (Q6), U602.8 (A6), U603.8 (A6)
/Register 4/r7: D608.2 (A), U601.12 (Q7), U602.9 (A7), U603.9 (A7)
/Register 5/r0: D701.2 (A), U701.19 (Q0), U702.2 (A0), U703.2 (A0)
/Register 5/r1: D702.2 (A), U701.18 (Q1), U702.3 (A1), U703.3 (A1)
/Register 5/r2: D703.2 (A), U701.17 (Q2), U702.4 (A2), U703.4 (A2)
/Register 5/r3: D704.2 (A), U701.16 (Q3), U702.5 (A3), U703.5 (A3)
/Register 5/r4: D705.2 (A), U701.15 (Q4), U702.6 (A4), U703.6 (A4)
/Register 5/r5: D706.2 (A), U701.14 (Q5), U702.7 (A5), U703.7 (A5)
/Register 5/r6: D707.2 (A), U701.13 (Q6), U702.8 (A6), U703.8 (A6)
/Register 5/r7: D708.2 (A), U701.12 (Q7), U702.9 (A7), U703.9 (A7)
/Register 6/r0: D801.2 (A), U801.19 (Q0), U802.2 (A0), U803.2 (A0)
/Register 6/r1: D802.2 (A), U801.18 (Q1), U802.3 (A1), U803.3 (A1)
/Register 6/r2: D803.2 (A), U801.17 (Q2), U802.4 (A2), U803.4 (A2)
/Register 6/r3: D804.2 (A), U801.16 (Q3), U802.5 (A3), U803.5 (A3)
/Register 6/r4: D805.2 (A), U801.15 (Q4), U802.6 (A4), U803.6 (A4)
/Register 6/r5: D806.2 (A), U801.14 (Q5), U802.7 (A5), U803.7 (A5)
/Register 6/r6: D807.2 (A), U801.13 (Q6), U802.8 (A6), U803.8 (A6)
/Register 6/r7: D808.2 (A), U801.12 (Q7), U802.9 (A7), U803.9 (A7)
/Register 7/r0: D901.2 (A), U901.19 (Q0), U902.2 (A0), U903.2 (A0)
/Register 7/r1: D902.2 (A), U901.18 (Q1), U902.3 (A1), U903.3 (A1)
/Register 7/r2: D903.2 (A), U901.17 (Q2), U902.4 (A2), U903.4 (A2)
/Register 7/r3: D904.2 (A), U901.16 (Q3), U902.5 (A3), U903.5 (A3)
/Register 7/r4: D905.2 (A), U901.15 (Q4), U902.6 (A4), U903.6 (A4)
/Register 7/r5: D906.2 (A), U901.14 (Q5), U902.7 (A5), U903.7 (A5)
/Register 7/r6: D907.2 (A), U901.13 (Q6), U902.8 (A6), U903.8 (A6)
/Register 7/r7: D908.2 (A), U901.12 (Q7), U902.9 (A7), U903.9 (A7)
/Selectors/CW1: U301.11 (Cp); also elsewhere on the board
/Selectors/CW2: U401.11 (Cp); also elsewhere on the board
/Selectors/CW3: U501.11 (Cp); also elsewhere on the board
/Selectors/CW4: U601.11 (Cp); also elsewhere on the board
/Selectors/CW5: U701.11 (Cp); also elsewhere on the board
/Selectors/CW6: U801.11 (Cp); also elsewhere on the board
/Selectors/CW7: U901.11 (Cp); also elsewhere on the board
/Selectors/~AS1: D309.1 (K), U302.19 (CE); also elsewhere on the board
/Selectors/~AS2: D409.1 (K), U402.19 (CE); also elsewhere on the board
/Selectors/~AS3: D509.1 (K), U502.19 (CE); also elsewhere on the board
/Selectors/~AS4: D609.1 (K), U602.19 (CE); also elsewhere on the board
/Selectors/~AS5: D709.1 (K), U702.19 (CE); also elsewhere on the board
/Selectors/~AS6: D809.1 (K), U802.19 (CE); also elsewhere on the board
/Selectors/~AS7: D909.1 (K), U902.19 (CE); also elsewhere on the board
/Selectors/~BS1: D310.1 (K), U303.19 (CE); also elsewhere on the board
/Selectors/~BS2: D410.1 (K), U403.19 (CE); also elsewhere on the board
/Selectors/~BS3: D510.1 (K), U503.19 (CE); also elsewhere on the board
/Selectors/~BS4: D610.1 (K), U603.19 (CE); also elsewhere on the board
/Selectors/~BS5: D710.1 (K), U703.19 (CE); also elsewhere on the board
/Selectors/~BS6: D810.1 (K), U803.19 (CE); also elsewhere on the board
/Selectors/~BS7: D910.1 (K), U903.19 (CE); also elsewhere on the board
GND: C301.2, C401.2, C501.2, C601.2, C701.2, C801.2, C901.2, R301.1, R302.1, R303.1, R304.1, R305.1, R306.1, R307.1, R308.1, R401.1, R402.1, R403.1, R404.1, R405.1, R406.1, R407.1, R408.1, R501.1, R502.1, R503.1, R504.1, R505.1, R506.1, R507.1, R508.1, R601.1, R602.1, R603.1, R604.1, R605.1, R606.1, R607.1, R608.1, R701.1, R702.1, R703.1, R704.1, R705.1, R706.1, R707.1, R708.1, R801.1, R802.1, R803.1, R804.1, R805.1, R806.1, R807.1, R808.1, R901.1, R902.1, R903.1, R904.1, R905.1, R906.1, R907.1, R908.1, U301.1 (OE), U301.10 (GND), U302.10 (GND), U303.10 (GND), U401.1 (OE), U401.10 (GND), U402.10 (GND), U403.10 (GND), U501.1 (OE), U501.10 (GND), U502.10 (GND), U503.10 (GND), U601.1 (OE), U601.10 (GND), U602.10 (GND), U603.10 (GND), U701.1 (OE), U701.10 (GND), U702.10 (GND), U703.10 (GND), U801.1 (OE), U801.10 (GND), U802.10 (GND), U803.10 (GND), U901.1 (OE), U901.10 (GND), U902.10 (GND), U903.10 (GND); also elsewhere on the board
unnamed: D301.1 (K), R301.2
unnamed: D302.1 (K), R302.2
unnamed: D303.1 (K), R303.2
unnamed: D304.1 (K), R304.2
unnamed: D305.1 (K), R305.2
unnamed: D306.1 (K), R306.2
unnamed: D307.1 (K), R307.2
unnamed: D308.1 (K), R308.2
unnamed: D309.2 (A), R309.1
unnamed: D310.2 (A), R310.1
unnamed: D401.1 (K), R401.2
unnamed: D402.1 (K), R402.2
unnamed: D403.1 (K), R403.2
unnamed: D404.1 (K), R404.2
unnamed: D405.1 (K), R405.2
unnamed: D406.1 (K), R406.2
unnamed: D407.1 (K), R407.2
unnamed: D408.1 (K), R408.2
unnamed: D409.2 (A), R409.1
unnamed: D410.2 (A), R410.1
unnamed: D501.1 (K), R501.2
unnamed: D502.1 (K), R502.2
unnamed: D503.1 (K), R503.2
unnamed: D504.1 (K), R504.2
unnamed: D505.1 (K), R505.2
unnamed: D506.1 (K), R506.2
unnamed: D507.1 (K), R507.2
unnamed: D508.1 (K), R508.2
unnamed: D509.2 (A), R509.1
unnamed: D510.2 (A), R510.1
unnamed: D601.1 (K), R601.2
unnamed: D602.1 (K), R602.2
unnamed: D603.1 (K), R603.2
unnamed: D604.1 (K), R604.2
unnamed: D605.1 (K), R605.2
unnamed: D606.1 (K), R606.2
unnamed: D607.1 (K), R607.2
unnamed: D608.1 (K), R608.2
unnamed: D609.2 (A), R609.1
unnamed: D610.2 (A), R610.1
unnamed: D701.1 (K), R701.2
unnamed: D702.1 (K), R702.2
unnamed: D703.1 (K), R703.2
unnamed: D704.1 (K), R704.2
unnamed: D705.1 (K), R705.2
unnamed: D706.1 (K), R706.2
unnamed: D707.1 (K), R707.2
unnamed: D708.1 (K), R708.2
unnamed: D709.2 (A), R709.1
unnamed: D710.2 (A), R710.1
unnamed: D801.1 (K), R801.2
unnamed: D802.1 (K), R802.2
unnamed: D803.1 (K), R803.2
unnamed: D804.1 (K), R804.2
unnamed: D805.1 (K), R805.2
unnamed: D806.1 (K), R806.2
unnamed: D807.1 (K), R807.2
unnamed: D808.1 (K), R808.2
unnamed: D809.2 (A), R809.1
unnamed: D810.2 (A), R810.1
unnamed: D901.1 (K), R901.2
unnamed: D902.1 (K), R902.2
unnamed: D903.1 (K), R903.2
unnamed: D904.1 (K), R904.2
unnamed: D905.1 (K), R905.2
unnamed: D906.1 (K), R906.2
unnamed: D907.1 (K), R907.2
unnamed: D908.1 (K), R908.2
unnamed: D909.2 (A), R909.1
unnamed: D910.2 (A), R910.1

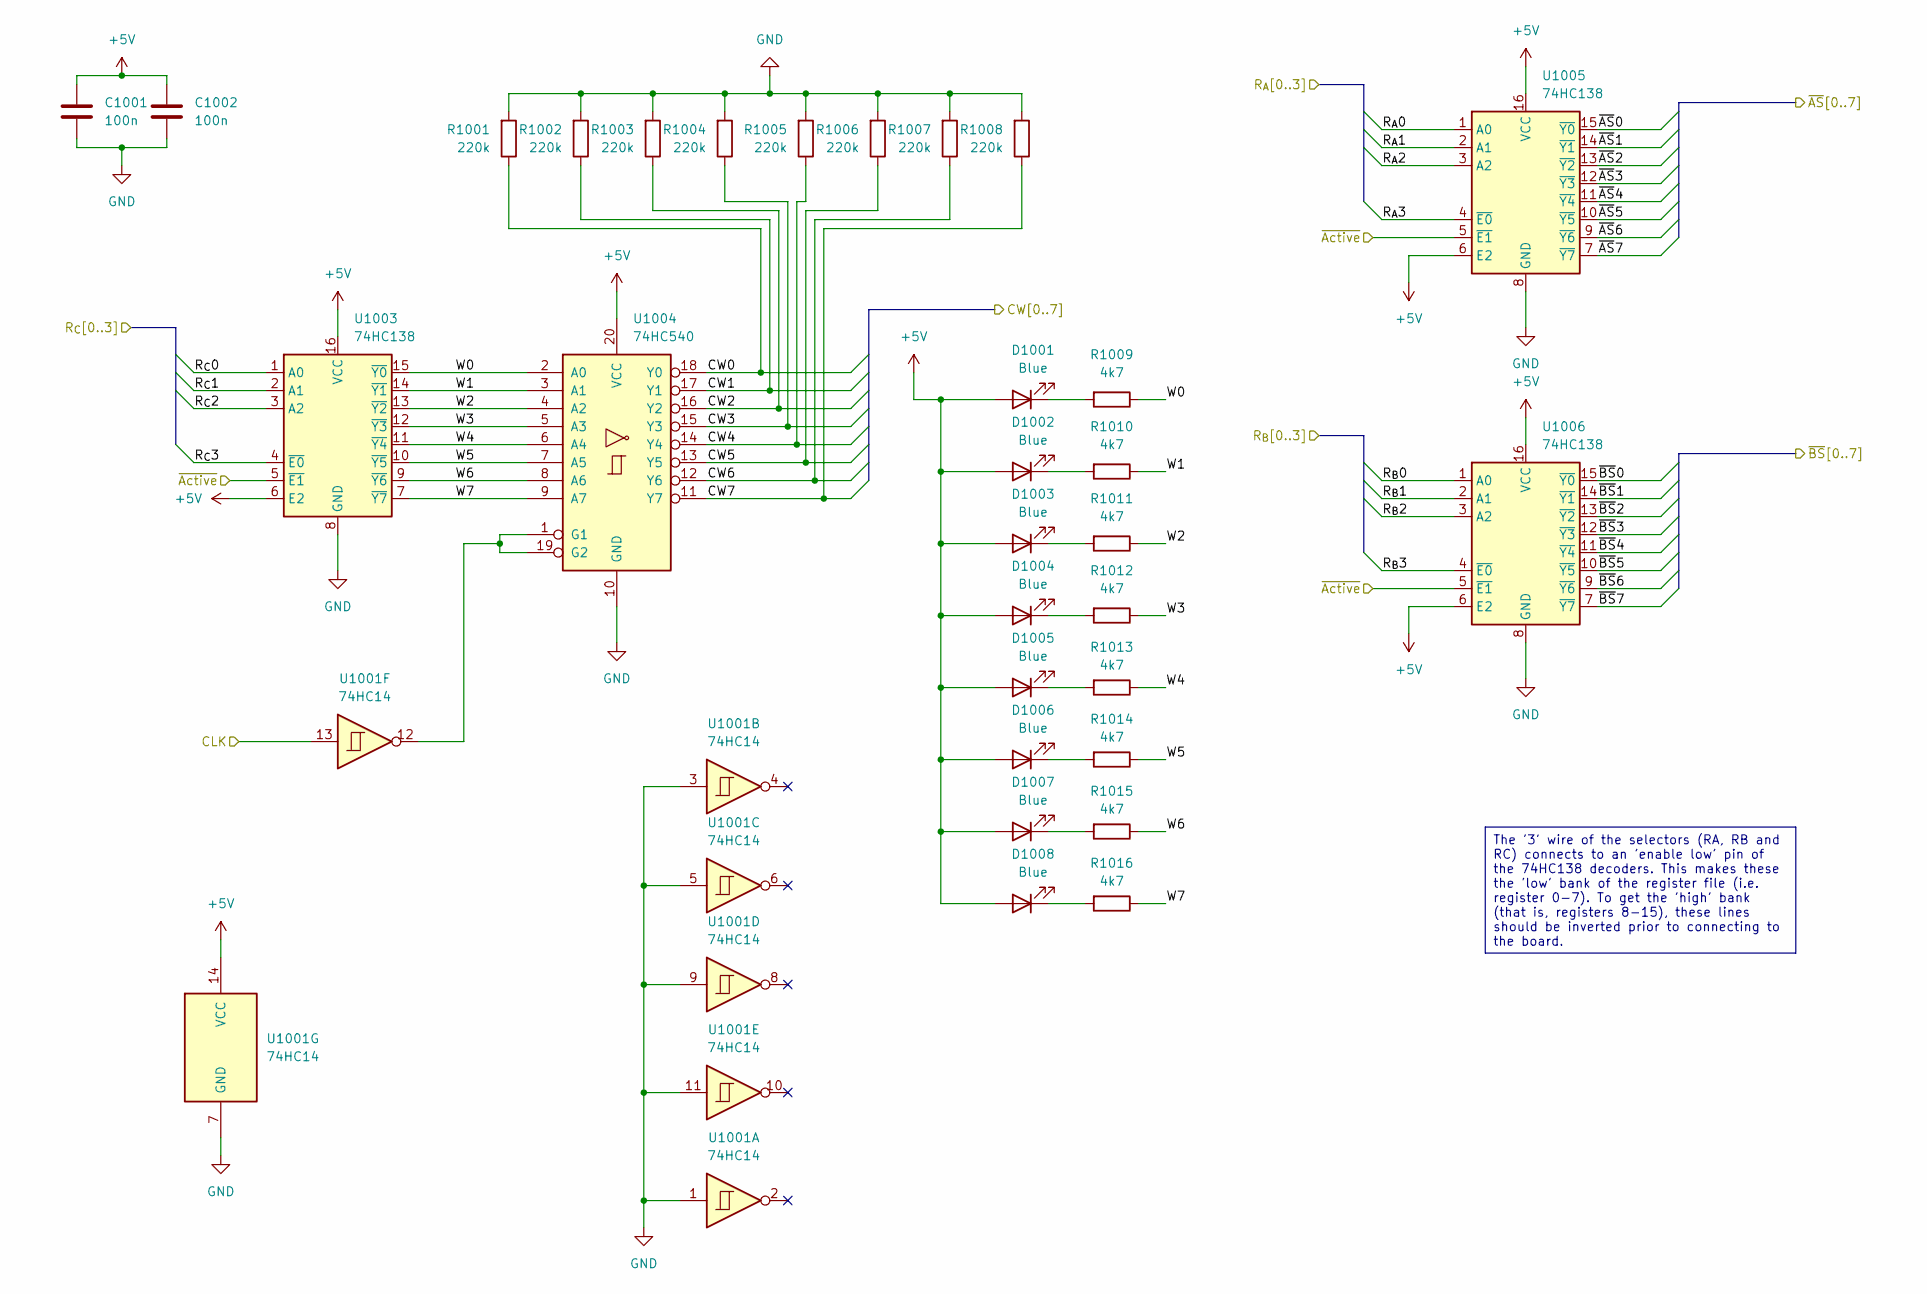
[picture p49: schematic selectors.kicad_sch]

Parts:
C1001, C1002: 100n; C_0603_1608Metric; LCSC C14663
D1001, D1002, D1003, D1004, D1005, D1006, D1007, D1008: Blue; LED_0603_1608Metric; LCSC C72041
R1001, R1002, R1003, R1004, R1005, R1006, R1007, R1008: 220k; R_0603_1608Metric; LCSC C22961
R1009, R1010, R1011, R1012, R1013, R1014, R1015, R1016: 4k7; R_0603_1608Metric; LCSC C23162
U1001: 74HC14; SOIC-14_3.9x8.7mm_P1.27mm; LCSC C5605
U1003, U1005, U1006: 74HC138; DIP-16_W7.62mm_Socket
U1004: 74HC540; DIP-20_W7.62mm_Socket

Connections:
+5V: C1001.1, C1002.1, D1001.2 (A), D1002.2 (A), D1003.2 (A), D1004.2 (A), D1005.2 (A), D1006.2 (A), D1007.2 (A), D1008.2 (A), U1001.14 (VCC), U1003.6 (E2), U1003.16 (VCC), U1004.20 (VCC), U1005.6 (E2), U1005.16 (VCC), U1006.6 (E2), U1006.16 (VCC); also elsewhere on the board
/R_{A}0: U1005.1 (A0); also elsewhere on the board
/R_{A}1: U1005.2 (A1); also elsewhere on the board
/R_{A}2: U1005.3 (A2); also elsewhere on the board
/R_{A}3: U1005.4 (~E0); also elsewhere on the board
/R_{B}0: U1006.1 (A0); also elsewhere on the board
/R_{B}1: U1006.2 (A1); also elsewhere on the board
/R_{B}2: U1006.3 (A2); also elsewhere on the board
/R_{B}3: U1006.4 (~E0); also elsewhere on the board
/R_{C}0: U1003.1 (A0); also elsewhere on the board
/R_{C}1: U1003.2 (A1); also elsewhere on the board
/R_{C}2: U1003.3 (A2); also elsewhere on the board
/R_{C}3: U1003.4 (~E0); also elsewhere on the board
/Selectors/CLK: U1001.13; also elsewhere on the board
/Selectors/CW0: R1001.1, U1004.18 (Y0); also elsewhere on the board
/Selectors/CW1: R1002.1, U1004.17 (Y1); also elsewhere on the board
/Selectors/CW2: R1003.1, U1004.16 (Y2); also elsewhere on the board
/Selectors/CW3: R1004.1, U1004.15 (Y3); also elsewhere on the board
/Selectors/CW4: R1005.1, U1004.14 (Y4); also elsewhere on the board
/Selectors/CW5: R1006.1, U1004.13 (Y5); also elsewhere on the board
/Selectors/CW6: R1007.1, U1004.12 (Y6); also elsewhere on the board
/Selectors/CW7: R1008.1, U1004.11 (Y7); also elsewhere on the board
/Selectors/W0: R1009.1, U1003.15 (~Y0), U1004.2 (A0)
/Selectors/W1: R1010.1, U1003.14 (~Y1), U1004.3 (A1)
/Selectors/W2: R1011.1, U1003.13 (~Y2), U1004.4 (A2)
/Selectors/W3: R1012.1, U1003.12 (~Y3), U1004.5 (A3)
/Selectors/W4: R1013.1, U1003.11 (~Y4), U1004.6 (A4)
/Selectors/W5: R1014.1, U1003.10 (~Y5), U1004.7 (A5)
/Selectors/W6: R1015.1, U1003.9 (~Y6), U1004.8 (A6)
/Selectors/W7: R1016.1, U1003.7 (~Y7), U1004.9 (A7)
/Selectors/~AS0: U1005.15 (~Y0); also elsewhere on the board
/Selectors/~AS1: U1005.14 (~Y1); also elsewhere on the board
/Selectors/~AS2: U1005.13 (~Y2); also elsewhere on the board
/Selectors/~AS3: U1005.12 (~Y3); also elsewhere on the board
/Selectors/~AS4: U1005.11 (~Y4); also elsewhere on the board
/Selectors/~AS5: U1005.10 (~Y5); also elsewhere on the board
/Selectors/~AS6: U1005.9 (~Y6); also elsewhere on the board
/Selectors/~AS7: U1005.7 (~Y7); also elsewhere on the board
/Selectors/~Active: U1003.5 (~E1), U1005.5 (~E1), U1006.5 (~E1); also elsewhere on the board
/Selectors/~BS0: U1006.15 (~Y0); also elsewhere on the board
/Selectors/~BS1: U1006.14 (~Y1); also elsewhere on the board
/Selectors/~BS2: U1006.13 (~Y2); also elsewhere on the board
/Selectors/~BS3: U1006.12 (~Y3); also elsewhere on the board
/Selectors/~BS4: U1006.11 (~Y4); also elsewhere on the board
/Selectors/~BS5: U1006.10 (~Y5); also elsewhere on the board
/Selectors/~BS6: U1006.9 (~Y6); also elsewhere on the board
/Selectors/~BS7: U1006.7 (~Y7); also elsewhere on the board
GND: C1001.2, C1002.2, R1001.2, R1002.2, R1003.2, R1004.2, R1005.2, R1006.2, R1007.2, R1008.2, U1001.1, U1001.3, U1001.5, U1001.7 (GND), U1001.9, U1001.11, U1003.8 (GND), U1004.10 (GND), U1005.8 (GND), U1006.8 (GND); also elsewhere on the board
unnamed: D1001.1 (K), R1009.2
unnamed: D1002.1 (K), R1010.2
unnamed: D1003.1 (K), R1011.2
unnamed: D1004.1 (K), R1012.2
unnamed: D1005.1 (K), R1013.2
unnamed: D1006.1 (K), R1014.2
unnamed: D1007.1 (K), R1015.2
unnamed: D1008.1 (K), R1016.2
unnamed: U1001.12, U1004.1 (G1), U1004.19 (G2)

Notes on the sheet:
The '3' wire of the selectors (RA, RB and RC) connects to an 'enable low' pin of the 74HC138 decoders. This makes these the 'low' bank of the register file (i.e. register 0-7). To get the 'high' bank (that is, registers 8-15), these lines should be inverted prior to connecting to the board.

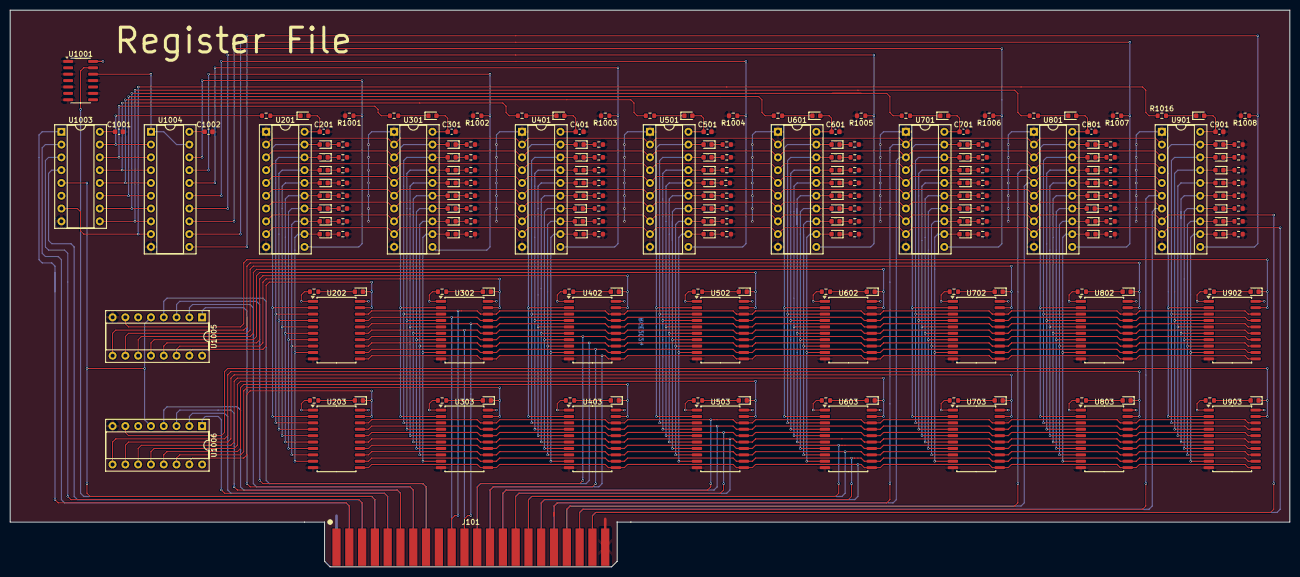
[picture p50: board Register File.kicad_pcb from above]

Board: 2 copper layers, 254.0 x 110.5 mm, 224 parts (0 on the bottom side), 225 nets.
