freesurfer-rge/slothpu16/pcbs/Barrel Shifter/Barrel Shifter.kicad_pcb

## KiCad design pcbs/Barrel Shifter/Barrel Shifter.kicad_pcb (2024-12-08)

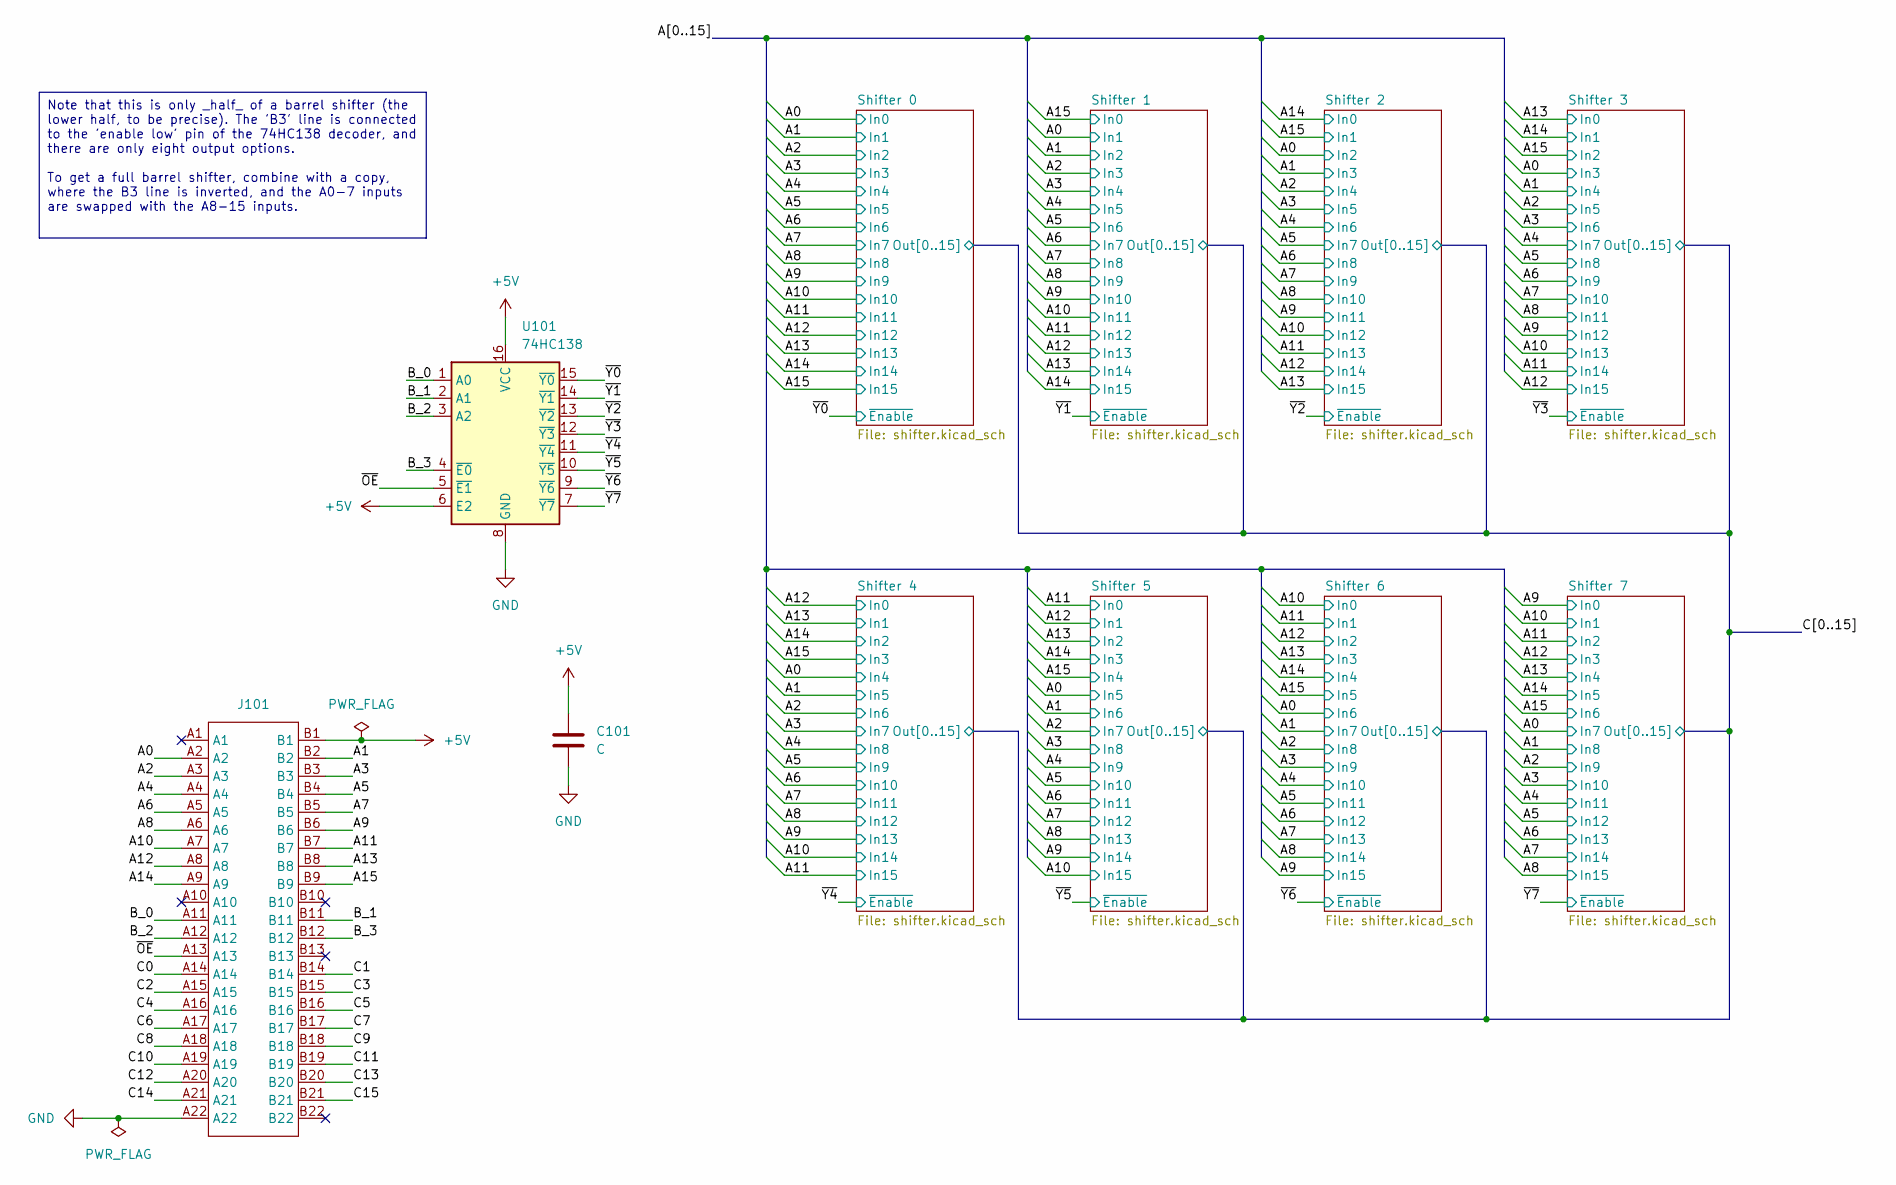
[picture p51: schematic Barrel Shifter.kicad_sch]

Parts:
C101: C; C_0603_1608Metric; LCSC C14663
J101: TE-5530843-4-Edge
U101: 74HC138; DIP-16_W7.62mm_Socket

Connections:
+5V: C101.1, J101.B1, U101.6 (E2), U101.16 (VCC); also elsewhere on the board
/A0: J101.A2; also elsewhere on the board
/A1: J101.B2; also elsewhere on the board
/A2: J101.A3; also elsewhere on the board
/A3: J101.B3; also elsewhere on the board
/A4: J101.A4; also elsewhere on the board
/A5: J101.B4; also elsewhere on the board
/A6: J101.A5; also elsewhere on the board
/A7: J101.B5; also elsewhere on the board
/A8: J101.A6; also elsewhere on the board
/A9: J101.B6; also elsewhere on the board
/A10: J101.A7; also elsewhere on the board
/A11: J101.B7; also elsewhere on the board
/A12: J101.A8; also elsewhere on the board
/A13: J101.B8; also elsewhere on the board
/A14: J101.A9; also elsewhere on the board
/A15: J101.B9; also elsewhere on the board
/B_0: J101.A11, U101.1 (A0)
/B_1: J101.B11, U101.2 (A1)
/B_2: J101.A12, U101.3 (A2)
/B_3: J101.B12, U101.4 (~E0)
/C0: J101.A14; also elsewhere on the board
/C1: J101.B14; also elsewhere on the board
/C2: J101.A15; also elsewhere on the board
/C3: J101.B15; also elsewhere on the board
/C4: J101.A16; also elsewhere on the board
/C5: J101.B16; also elsewhere on the board
/C6: J101.A17; also elsewhere on the board
/C7: J101.B17; also elsewhere on the board
/C8: J101.A18; also elsewhere on the board
/C9: J101.B18; also elsewhere on the board
/C10: J101.A19; also elsewhere on the board
/C11: J101.B19; also elsewhere on the board
/C12: J101.A20; also elsewhere on the board
/C13: J101.B20; also elsewhere on the board
/C14: J101.A21; also elsewhere on the board
/C15: J101.B21; also elsewhere on the board
/~OE: J101.A13, U101.5 (~E1)
/~Y0: U101.15 (~Y0); also elsewhere on the board
/~Y1: U101.14 (~Y1); also elsewhere on the board
/~Y2: U101.13 (~Y2); also elsewhere on the board
/~Y3: U101.12 (~Y3); also elsewhere on the board
/~Y4: U101.11 (~Y4); also elsewhere on the board
/~Y5: U101.10 (~Y5); also elsewhere on the board
/~Y6: U101.9 (~Y6); also elsewhere on the board
/~Y7: U101.7 (~Y7); also elsewhere on the board
GND: C101.2, J101.A22, U101.8 (GND); also elsewhere on the board

Notes on the sheet:
Note that this is only _half_ of a barrel shifter (the lower half, to be precise). The 'B3' line is connected to the 'enable low' pin of the 74HC138 decoder, and there are only eight output options. To get a full barrel shifter, combine with a copy, where the B3 line is inverted, and the A0-7 input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

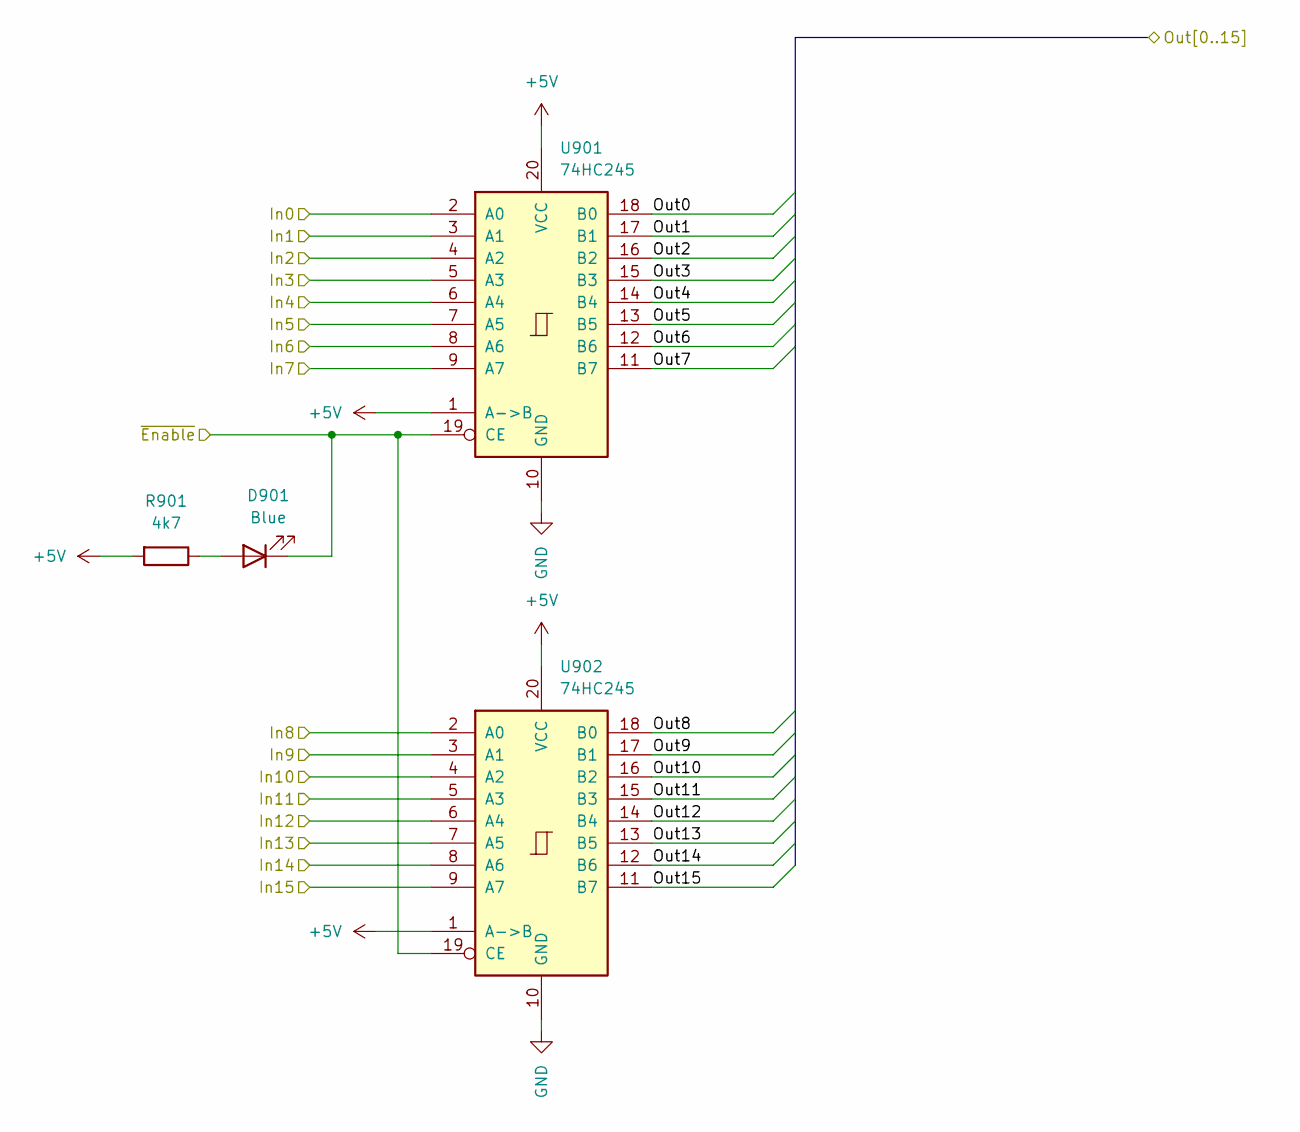
[picture p52: schematic shifter.kicad_sch]

Parts:
D901: Blue; LED_0603_1608Metric; LCSC C72041
R901: 4k7; R_0603_1608Metric; LCSC C23162
U901, U902: 74HC245; SOIC-20W_7.5x12.8mm_P1.27mm; LCSC C5625

Connections:
+5V: R901.2, U901.1 (A->B), U901.20 (VCC), U902.1 (A->B), U902.20 (VCC); also elsewhere on the board
/A0: U901.9 (A7); also elsewhere on the board
/A1: U902.2 (A0); also elsewhere on the board
/A2: U902.3 (A1); also elsewhere on the board
/A3: U902.4 (A2); also elsewhere on the board
/A4: U902.5 (A3); also elsewhere on the board
/A5: U902.6 (A4); also elsewhere on the board
/A6: U902.7 (A5); also elsewhere on the board
/A7: U902.8 (A6); also elsewhere on the board
/A8: U902.9 (A7); also elsewhere on the board
/A9: U901.2 (A0); also elsewhere on the board
/A10: U901.3 (A1); also elsewhere on the board
/A11: U901.4 (A2); also elsewhere on the board
/A12: U901.5 (A3); also elsewhere on the board
/A13: U901.6 (A4); also elsewhere on the board
/A14: U901.7 (A5); also elsewhere on the board
/A15: U901.8 (A6); also elsewhere on the board
/C0: U901.18 (B0); also elsewhere on the board
/C1: U901.17 (B1); also elsewhere on the board
/C2: U901.16 (B2); also elsewhere on the board
/C3: U901.15 (B3); also elsewhere on the board
/C4: U901.14 (B4); also elsewhere on the board
/C5: U901.13 (B5); also elsewhere on the board
/C6: U901.12 (B6); also elsewhere on the board
/C7: U901.11 (B7); also elsewhere on the board
/C8: U902.18 (B0); also elsewhere on the board
/C9: U902.17 (B1); also elsewhere on the board
/C10: U902.16 (B2); also elsewhere on the board
/C11: U902.15 (B3); also elsewhere on the board
/C12: U902.14 (B4); also elsewhere on the board
/C13: U902.13 (B5); also elsewhere on the board
/C14: U902.12 (B6); also elsewhere on the board
/C15: U902.11 (B7); also elsewhere on the board
/~Y7: D901.1 (K), U901.19 (CE), U902.19 (CE); also elsewhere on the board
GND: U901.10 (GND), U902.10 (GND); also elsewhere on the board
unnamed: D901.2 (A), R901.1

Parts of its further copies:
D201, D301, D401, D501, D601, D701, D801: Blue; LED_0603_1608Metric; LCSC C72041
R201, R301, R401, R501, R601, R701, R801: 4k7; R_0603_1608Metric; LCSC C23162
U201, U202, U301, U302, U401, U402, U501, U502, U601, U602, U701, U702, U801, U802: 74HC245; SOIC-20W_7.5x12.8mm_P1.27mm; LCSC C5625

Connections of its further copies:
+5V: R201.2, R301.2, R401.2, R501.2, R601.2, R701.2, R801.2, U201.1 (A->B), U201.20 (VCC), U202.1 (A->B), U202.20 (VCC), U301.1 (A->B), U301.20 (VCC), U302.1 (A->B), U302.20 (VCC), U401.1 (A->B), U401.20 (VCC), U402.1 (A->B), U402.20 (VCC), U501.1 (A->B), U501.20 (VCC), U502.1 (A->B), U502.20 (VCC), U601.1 (A->B), U601.20 (VCC), U602.1 (A->B), U602.20 (VCC), U701.1 (A->B), U701.20 (VCC), U702.1 (A->B), U702.20 (VCC), U801.1 (A->B), U801.20 (VCC), U802.1 (A->B), U802.20 (VCC); also elsewhere on the board
/A0: U201.2 (A0), U301.3 (A1), U401.4 (A2), U501.5 (A3), U601.6 (A4), U701.7 (A5), U801.8 (A6); also elsewhere on the board
/A1: U201.3 (A1), U301.4 (A2), U401.5 (A3), U501.6 (A4), U601.7 (A5), U701.8 (A6), U801.9 (A7); also elsewhere on the board
/A2: U201.4 (A2), U301.5 (A3), U401.6 (A4), U501.7 (A5), U601.8 (A6), U701.9 (A7), U802.2 (A0); also elsewhere on the board
/A3: U201.5 (A3), U301.6 (A4), U401.7 (A5), U501.8 (A6), U601.9 (A7), U702.2 (A0), U802.3 (A1); also elsewhere on the board
/A4: U201.6 (A4), U301.7 (A5), U401.8 (A6), U501.9 (A7), U602.2 (A0), U702.3 (A1), U802.4 (A2); also elsewhere on the board
/A5: U201.7 (A5), U301.8 (A6), U401.9 (A7), U502.2 (A0), U602.3 (A1), U702.4 (A2), U802.5 (A3); also elsewhere on the board
/A6: U201.8 (A6), U301.9 (A7), U402.2 (A0), U502.3 (A1), U602.4 (A2), U702.5 (A3), U802.6 (A4); also elsewhere on the board
/A7: U201.9 (A7), U302.2 (A0), U402.3 (A1), U502.4 (A2), U602.5 (A3), U702.6 (A4), U802.7 (A5); also elsewhere on the board
/A8: U202.2 (A0), U302.3 (A1), U402.4 (A2), U502.5 (A3), U602.6 (A4), U702.7 (A5), U802.8 (A6); also elsewhere on the board
/A9: U202.3 (A1), U302.4 (A2), U402.5 (A3), U502.6 (A4), U602.7 (A5), U702.8 (A6), U802.9 (A7); also elsewhere on the board
/A10: U202.4 (A2), U302.5 (A3), U402.6 (A4), U502.7 (A5), U602.8 (A6), U702.9 (A7), U801.2 (A0); also elsewhere on the board
/A11: U202.5 (A3), U302.6 (A4), U402.7 (A5), U502.8 (A6), U602.9 (A7), U701.2 (A0), U801.3 (A1); also elsewhere on the board
/A12: U202.6 (A4), U302.7 (A5), U402.8 (A6), U502.9 (A7), U601.2 (A0), U701.3 (A1), U801.4 (A2); also elsewhere on the board
/A13: U202.7 (A5), U302.8 (A6), U402.9 (A7), U501.2 (A0), U601.3 (A1), U701.4 (A2), U801.5 (A3); also elsewhere on the board
/A14: U202.8 (A6), U302.9 (A7), U401.2 (A0), U501.3 (A1), U601.4 (A2), U701.5 (A3), U801.6 (A4); also elsewhere on the board
/A15: U202.9 (A7), U301.2 (A0), U401.3 (A1), U501.4 (A2), U601.5 (A3), U701.6 (A4), U801.7 (A5); also elsewhere on the board
/C0: U201.18 (B0), U301.18 (B0), U401.18 (B0), U501.18 (B0), U601.18 (B0), U701.18 (B0), U801.18 (B0); also elsewhere on the board
/C1: U201.17 (B1), U301.17 (B1), U401.17 (B1), U501.17 (B1), U601.17 (B1), U701.17 (B1), U801.17 (B1); also elsewhere on the board
/C2: U201.16 (B2), U301.16 (B2), U401.16 (B2), U501.16 (B2), U601.16 (B2), U701.16 (B2), U801.16 (B2); also elsewhere on the board
/C3: U201.15 (B3), U301.15 (B3), U401.15 (B3), U501.15 (B3), U601.15 (B3), U701.15 (B3), U801.15 (B3); also elsewhere on the board
/C4: U201.14 (B4), U301.14 (B4), U401.14 (B4), U501.14 (B4), U601.14 (B4), U701.14 (B4), U801.14 (B4); also elsewhere on the board
/C5: U201.13 (B5), U301.13 (B5), U401.13 (B5), U501.13 (B5), U601.13 (B5), U701.13 (B5), U801.13 (B5); also elsewhere on the board
/C6: U201.12 (B6), U301.12 (B6), U401.12 (B6), U501.12 (B6), U601.12 (B6), U701.12 (B6), U801.12 (B6); also elsewhere on the board
/C7: U201.11 (B7), U301.11 (B7), U401.11 (B7), U501.11 (B7), U601.11 (B7), U701.11 (B7), U801.11 (B7); also elsewhere on the board
/C8: U202.18 (B0), U302.18 (B0), U402.18 (B0), U502.18 (B0), U602.18 (B0), U702.18 (B0), U802.18 (B0); also elsewhere on the board
/C9: U202.17 (B1), U302.17 (B1), U402.17 (B1), U502.17 (B1), U602.17 (B1), U702.17 (B1), U802.17 (B1); also elsewhere on the board
/C10: U202.16 (B2), U302.16 (B2), U402.16 (B2), U502.16 (B2), U602.16 (B2), U702.16 (B2), U802.16 (B2); also elsewhere on the board
/C11: U202.15 (B3), U302.15 (B3), U402.15 (B3), U502.15 (B3), U602.15 (B3), U702.15 (B3), U802.15 (B3); also elsewhere on the board
/C12: U202.14 (B4), U302.14 (B4), U402.14 (B4), U502.14 (B4), U602.14 (B4), U702.14 (B4), U802.14 (B4); also elsewhere on the board
/C13: U202.13 (B5), U302.13 (B5), U402.13 (B5), U502.13 (B5), U602.13 (B5), U702.13 (B5), U802.13 (B5); also elsewhere on the board
/C14: U202.12 (B6), U302.12 (B6), U402.12 (B6), U502.12 (B6), U602.12 (B6), U702.12 (B6), U802.12 (B6); also elsewhere on the board
/C15: U202.11 (B7), U302.11 (B7), U402.11 (B7), U502.11 (B7), U602.11 (B7), U702.11 (B7), U802.11 (B7); also elsewhere on the board
/~Y0: D201.1 (K), U201.19 (CE), U202.19 (CE); also elsewhere on the board
/~Y1: D301.1 (K), U301.19 (CE), U302.19 (CE); also elsewhere on the board
/~Y2: D401.1 (K), U401.19 (CE), U402.19 (CE); also elsewhere on the board
/~Y3: D501.1 (K), U501.19 (CE), U502.19 (CE); also elsewhere on the board
/~Y4: D601.1 (K), U601.19 (CE), U602.19 (CE); also elsewhere on the board
/~Y5: D701.1 (K), U701.19 (CE), U702.19 (CE); also elsewhere on the board
/~Y6: D801.1 (K), U801.19 (CE), U802.19 (CE); also elsewhere on the board
GND: U201.10 (GND), U202.10 (GND), U301.10 (GND), U302.10 (GND), U401.10 (GND), U402.10 (GND), U501.10 (GND), U502.10 (GND), U601.10 (GND), U602.10 (GND), U701.10 (GND), U702.10 (GND), U801.10 (GND), U802.10 (GND); also elsewhere on the board
unnamed: D201.2 (A), R201.1
unnamed: D301.2 (A), R301.1
unnamed: D401.2 (A), R401.1
unnamed: D501.2 (A), R501.1
unnamed: D601.2 (A), R601.1
unnamed: D701.2 (A), R701.1
unnamed: D801.2 (A), R801.1

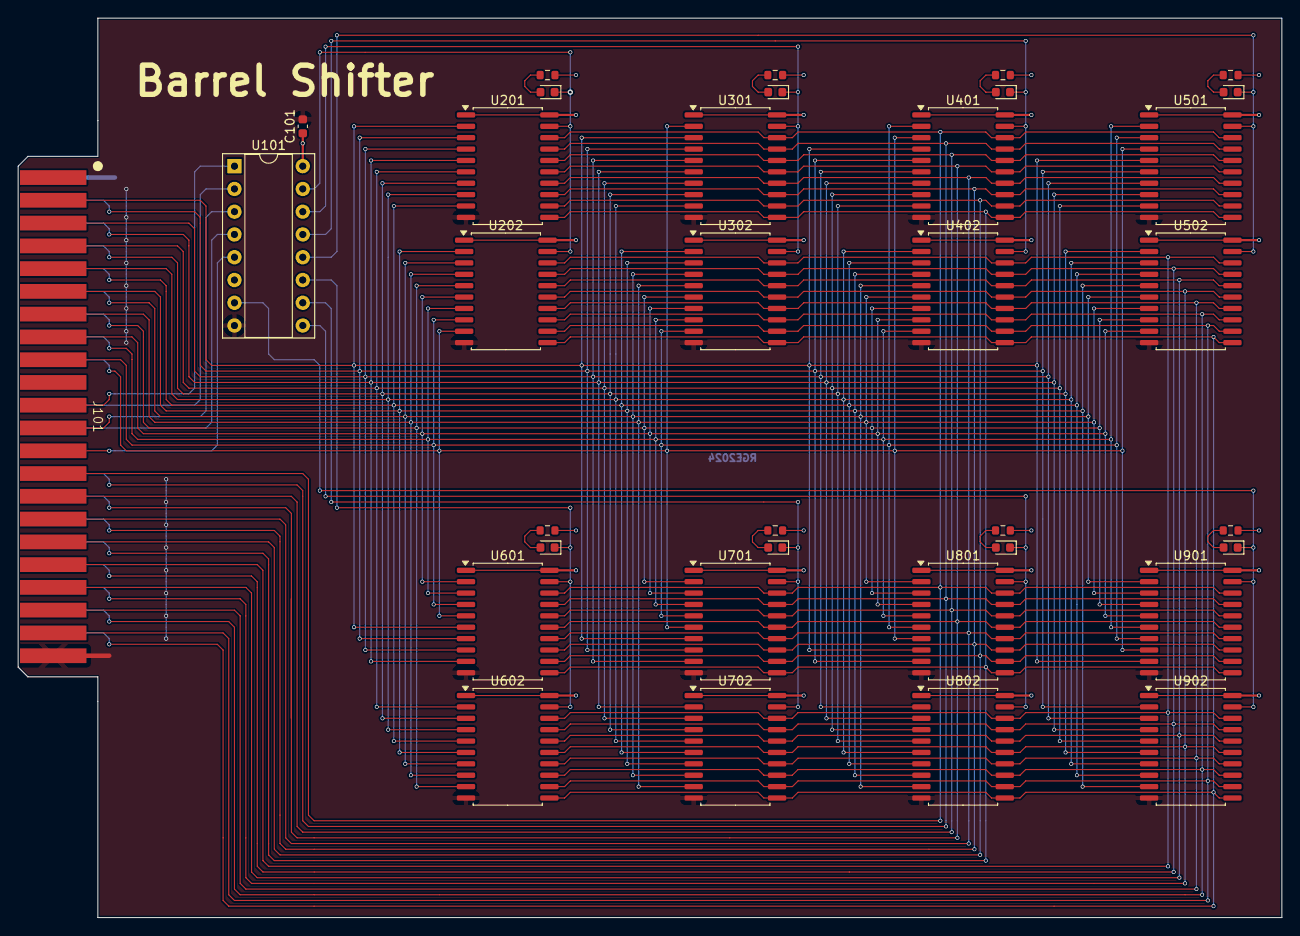
[picture p53: board Barrel Shifter.kicad_pcb from above]

Board: 2 copper layers, 141.0 x 100.3 mm, 35 parts (0 on the bottom side), 55 nets.
