freesurfer-rge/slothpu16/pcbs/Incrementer Connector/Incrementer Connector.kicad_pcb

## KiCad design pcbs/Incrementer Connector/Incrementer Connector.kicad_pcb (2024-11-17)

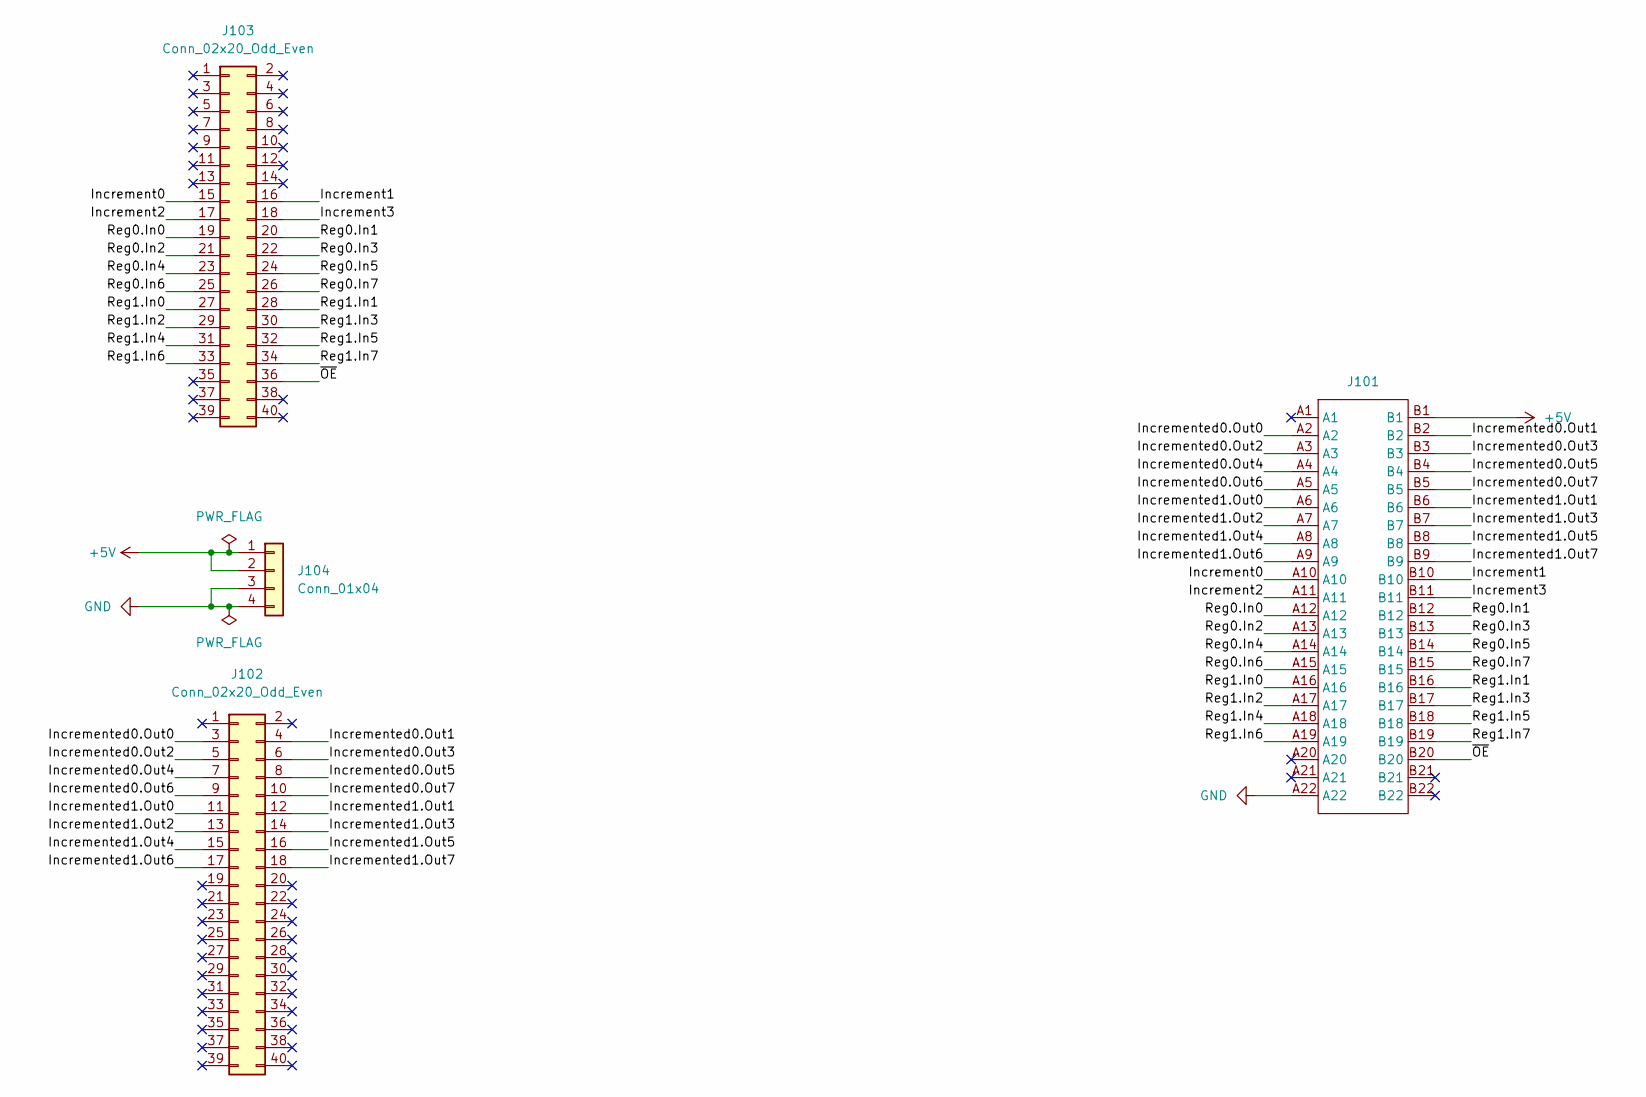
[picture p54: schematic Incrementer Connector.kicad_sch]

Parts:
J101: TE-5530843-4-Mount
J102, J103: Conn_02x20_Odd_Even; PinHeader_2x20_P2.54mm_Vertical
J104: Conn_01x04; PinHeader_1x04_P2.54mm_Vertical

Connections:
+5V: J101.B1, J104.1, J104.2
/Increment0: J101.A10, J103.15
/Increment1: J101.B10, J103.16
/Increment2: J101.A11, J103.17
/Increment3: J101.B11, J103.18
/Incremented0.Out0: J101.A2, J102.3
/Incremented0.Out1: J101.B2, J102.4
/Incremented0.Out2: J101.A3, J102.5
/Incremented0.Out3: J101.B3, J102.6
/Incremented0.Out4: J101.A4, J102.7
/Incremented0.Out5: J101.B4, J102.8
/Incremented0.Out6: J101.A5, J102.9
/Incremented0.Out7: J101.B5, J102.10
/Incremented1.Out0: J101.A6, J102.11
/Incremented1.Out1: J101.B6, J102.12
/Incremented1.Out2: J101.A7, J102.13
/Incremented1.Out3: J101.B7, J102.14
/Incremented1.Out4: J101.A8, J102.15
/Incremented1.Out5: J101.B8, J102.16
/Incremented1.Out6: J101.A9, J102.17
/Incremented1.Out7: J101.B9, J102.18
/Reg0.In0: J101.A12, J103.19
/Reg0.In1: J101.B12, J103.20
/Reg0.In2: J101.A13, J103.21
/Reg0.In3: J101.B13, J103.22
/Reg0.In4: J101.A14, J103.23
/Reg0.In5: J101.B14, J103.24
/Reg0.In6: J101.A15, J103.25
/Reg0.In7: J101.B15, J103.26
/Reg1.In0: J101.A16, J103.27
/Reg1.In1: J101.B16, J103.28
/Reg1.In2: J101.A17, J103.29
/Reg1.In3: J101.B17, J103.30
/Reg1.In4: J101.A18, J103.31
/Reg1.In5: J101.B18, J103.32
/Reg1.In6: J101.A19, J103.33
/Reg1.In7: J101.B19, J103.34
/~OE: J101.B20, J103.36
GND: J101.A22, J104.3, J104.4

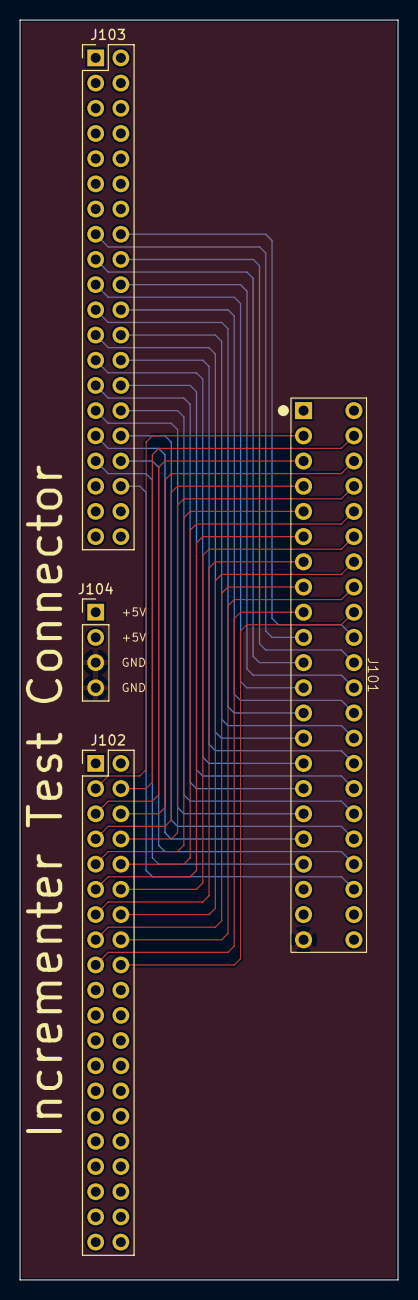
[picture p55: board Incrementer Connector.kicad_pcb from above]

Board: 2 copper layers, 38.1 x 127.0 mm, 4 parts (0 on the bottom side), 39 nets.
