freesurfer-rge/slothpu16/pcbs/Incrementer/Incrementer.kicad_pcb

## KiCad design pcbs/Incrementer/Incrementer.kicad_pcb (2024-11-17)

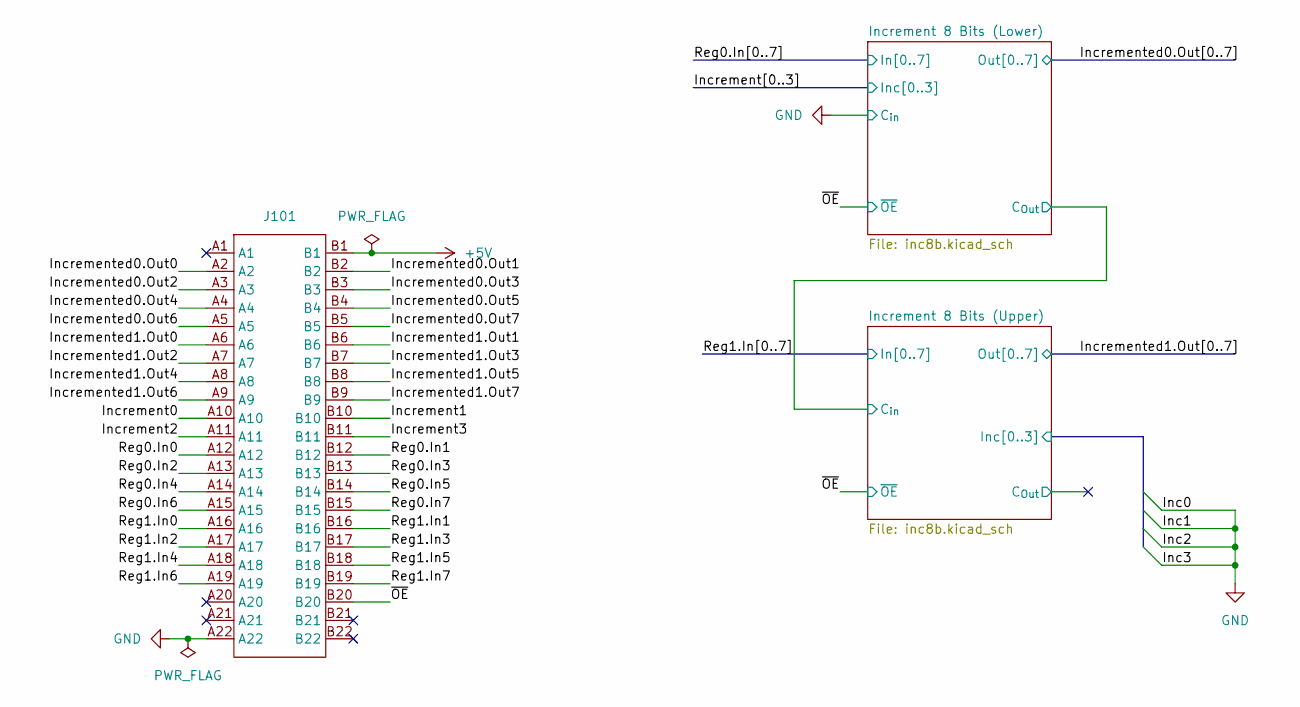
[picture p56: schematic Incrementer.kicad_sch, PC Incrementer]

Parts:
J101: TE-5530843-4-Edge

Connections:
+5V: J101.B1; also elsewhere on the board
/Increment0: J101.A10; also elsewhere on the board
/Increment1: J101.B10; also elsewhere on the board
/Increment2: J101.A11; also elsewhere on the board
/Increment3: J101.B11; also elsewhere on the board
/Incremented0.Out0: J101.A2; also elsewhere on the board
/Incremented0.Out1: J101.B2; also elsewhere on the board
/Incremented0.Out2: J101.A3; also elsewhere on the board
/Incremented0.Out3: J101.B3; also elsewhere on the board
/Incremented0.Out4: J101.A4; also elsewhere on the board
/Incremented0.Out5: J101.B4; also elsewhere on the board
/Incremented0.Out6: J101.A5; also elsewhere on the board
/Incremented0.Out7: J101.B5; also elsewhere on the board
/Incremented1.Out0: J101.A6; also elsewhere on the board
/Incremented1.Out1: J101.B6; also elsewhere on the board
/Incremented1.Out2: J101.A7; also elsewhere on the board
/Incremented1.Out3: J101.B7; also elsewhere on the board
/Incremented1.Out4: J101.A8; also elsewhere on the board
/Incremented1.Out5: J101.B8; also elsewhere on the board
/Incremented1.Out6: J101.A9; also elsewhere on the board
/Incremented1.Out7: J101.B9; also elsewhere on the board
/Reg0.In0: J101.A12; also elsewhere on the board
/Reg0.In1: J101.B12; also elsewhere on the board
/Reg0.In2: J101.A13; also elsewhere on the board
/Reg0.In3: J101.B13; also elsewhere on the board
/Reg0.In4: J101.A14; also elsewhere on the board
/Reg0.In5: J101.B14; also elsewhere on the board
/Reg0.In6: J101.A15; also elsewhere on the board
/Reg0.In7: J101.B15; also elsewhere on the board
/Reg1.In0: J101.A16; also elsewhere on the board
/Reg1.In1: J101.B16; also elsewhere on the board
/Reg1.In2: J101.A17; also elsewhere on the board
/Reg1.In3: J101.B17; also elsewhere on the board
/Reg1.In4: J101.A18; also elsewhere on the board
/Reg1.In5: J101.B18; also elsewhere on the board
/Reg1.In6: J101.A19; also elsewhere on the board
/Reg1.In7: J101.B19; also elsewhere on the board
/~OE: J101.B20; also elsewhere on the board
GND: J101.A22; also elsewhere on the board

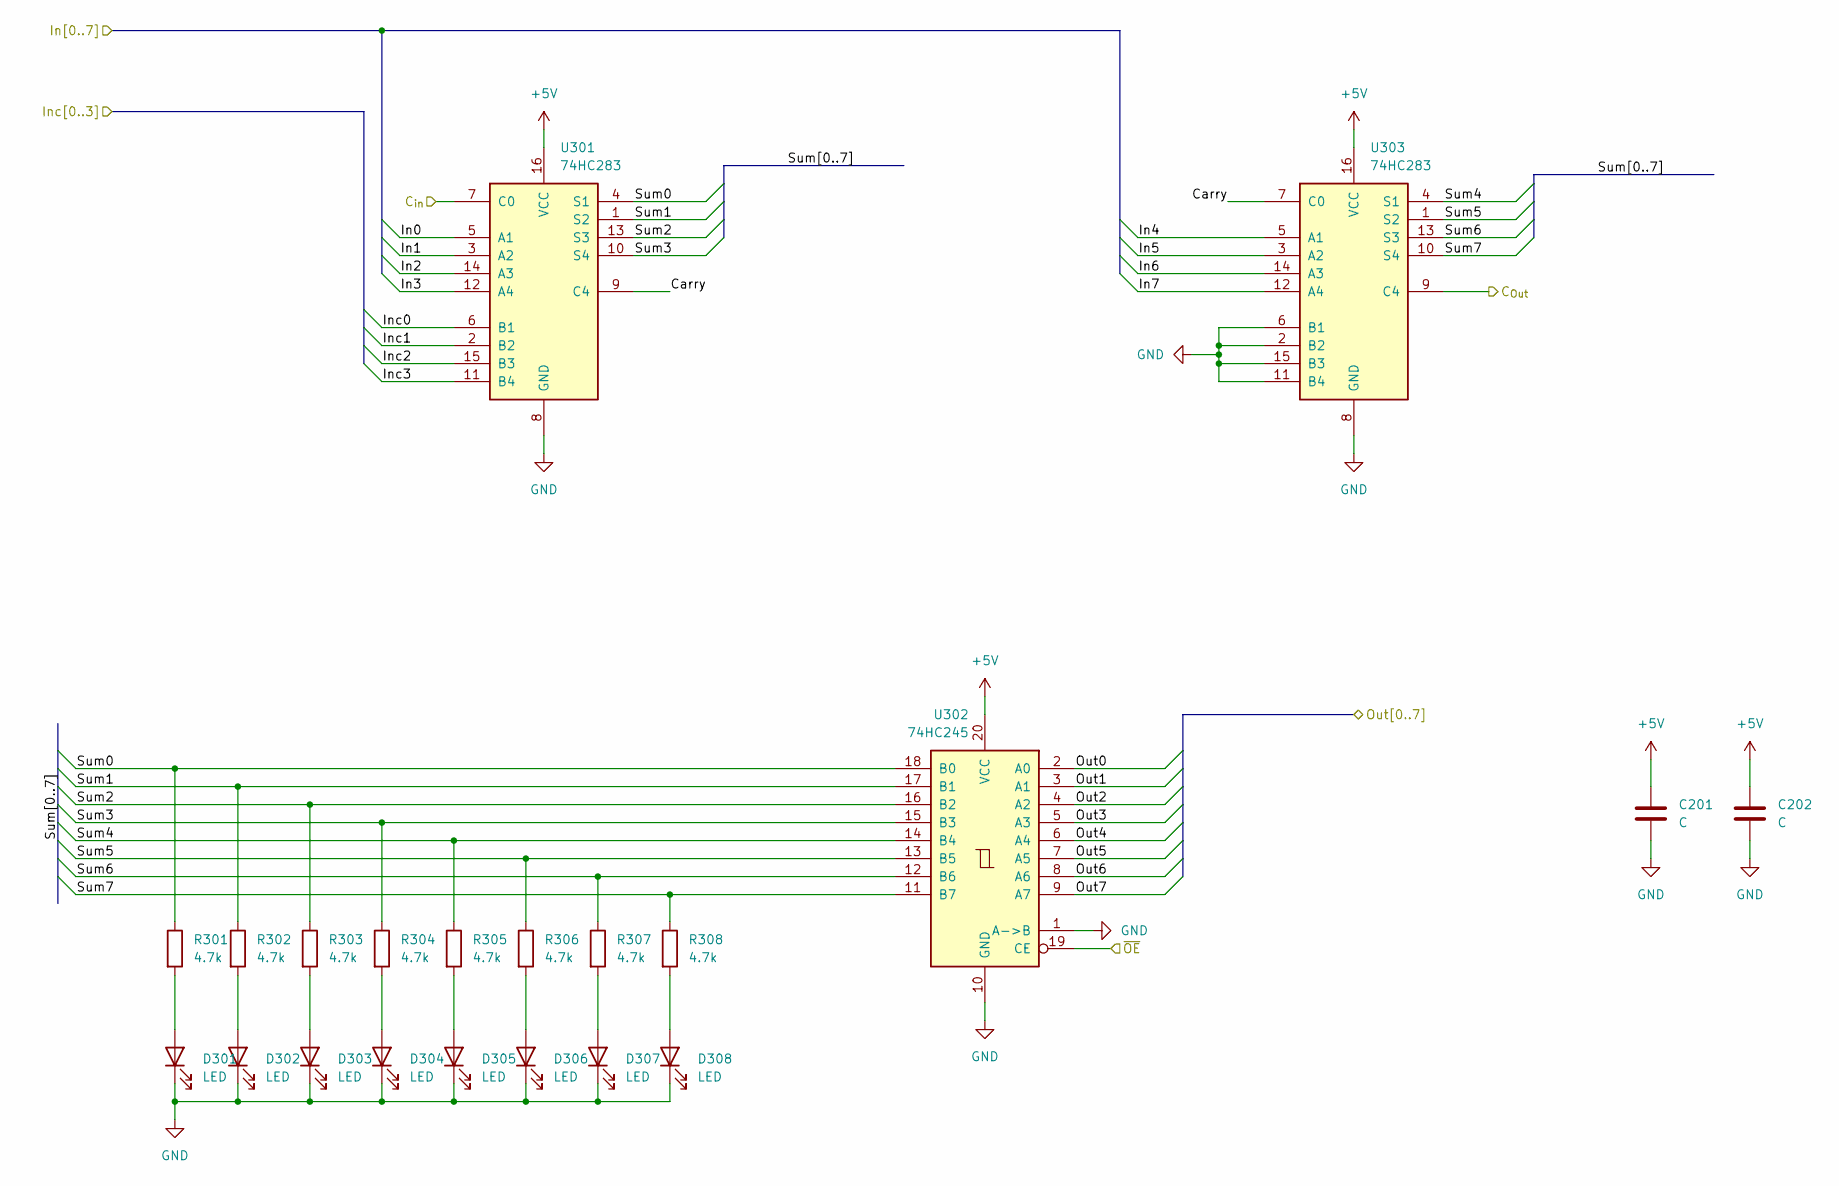
[picture p57: schematic inc8b.kicad_sch]

Parts:
C201, C202: C; C_0603_1608Metric; LCSC C14663
D301, D302, D303, D304, D305, D306, D307, D308: LED; LED_0603_1608Metric; LCSC C2290
R301, R302, R303, R304, R305, R306, R307, R308: 4.7k; R_0603_1608Metric; LCSC C23162
U301, U303: 74HC283; DIP-16_W7.62mm_Socket
U302: 74HC245; SOIC-20W_7.5x12.8mm_P1.27mm; LCSC C5625

Connections:
+5V: C201.1, C202.1, U301.16 (VCC), U302.20 (VCC), U303.16 (VCC); also elsewhere on the board
/Increment 8 Bits (Lower)/C_{Out}: U301.7 (C0); also elsewhere on the board
/Increment 8 Bits (Upper)/C_{Out}: U303.9 (C4)
/Increment 8 Bits (Upper)/Carry: U301.9 (C4), U303.7 (C0)
/Increment 8 Bits (Upper)/Sum0: R301.1, U301.4 (S1), U302.18 (B0)
/Increment 8 Bits (Upper)/Sum1: R302.1, U301.1 (S2), U302.17 (B1)
/Increment 8 Bits (Upper)/Sum2: R303.1, U301.13 (S3), U302.16 (B2)
/Increment 8 Bits (Upper)/Sum3: R304.1, U301.10 (S4), U302.15 (B3)
/Increment 8 Bits (Upper)/Sum4: R305.1, U302.14 (B4), U303.4 (S1)
/Increment 8 Bits (Upper)/Sum5: R306.1, U302.13 (B5), U303.1 (S2)
/Increment 8 Bits (Upper)/Sum6: R307.1, U302.12 (B6), U303.13 (S3)
/Increment 8 Bits (Upper)/Sum7: R308.1, U302.11 (B7), U303.10 (S4)
/Incremented1.Out0: U302.2 (A0); also elsewhere on the board
/Incremented1.Out1: U302.3 (A1); also elsewhere on the board
/Incremented1.Out2: U302.4 (A2); also elsewhere on the board
/Incremented1.Out3: U302.5 (A3); also elsewhere on the board
/Incremented1.Out4: U302.6 (A4); also elsewhere on the board
/Incremented1.Out5: U302.7 (A5); also elsewhere on the board
/Incremented1.Out6: U302.8 (A6); also elsewhere on the board
/Incremented1.Out7: U302.9 (A7); also elsewhere on the board
/Reg1.In0: U301.5 (A1); also elsewhere on the board
/Reg1.In1: U301.3 (A2); also elsewhere on the board
/Reg1.In2: U301.14 (A3); also elsewhere on the board
/Reg1.In3: U301.12 (A4); also elsewhere on the board
/Reg1.In4: U303.5 (A1); also elsewhere on the board
/Reg1.In5: U303.3 (A2); also elsewhere on the board
/Reg1.In6: U303.14 (A3); also elsewhere on the board
/Reg1.In7: U303.12 (A4); also elsewhere on the board
/~OE: U302.19 (CE); also elsewhere on the board
GND: C201.2, C202.2, D301.1 (K), D302.1 (K), D303.1 (K), D304.1 (K), D305.1 (K), D306.1 (K), D307.1 (K), D308.1 (K), U301.2 (B2), U301.6 (B1), U301.8 (GND), U301.11 (B4), U301.15 (B3), U302.1 (A->B), U302.10 (GND), U303.2 (B2), U303.6 (B1), U303.8 (GND), U303.11 (B4), U303.15 (B3); also elsewhere on the board
unnamed: D301.2 (A), R301.2
unnamed: D302.2 (A), R302.2
unnamed: D303.2 (A), R303.2
unnamed: D304.2 (A), R304.2
unnamed: D305.2 (A), R305.2
unnamed: D306.2 (A), R306.2
unnamed: D307.2 (A), R307.2
unnamed: D308.2 (A), R308.2

Parts of its further copies:
C301, C302: C; C_0603_1608Metric; LCSC C14663
D201, D202, D203, D204, D205, D206, D207, D208: LED; LED_0603_1608Metric; LCSC C2290
R201, R202, R203, R204, R205, R206, R207, R208: 4.7k; R_0603_1608Metric; LCSC C23162
U201, U203: 74HC283; DIP-16_W7.62mm_Socket
U202: 74HC245; SOIC-20W_7.5x12.8mm_P1.27mm; LCSC C5625

Connections of its further copies:
+5V: C301.1, C302.1, U201.16 (VCC), U202.20 (VCC), U203.16 (VCC); also elsewhere on the board
/Increment0: U201.6 (B1); also elsewhere on the board
/Increment1: U201.2 (B2); also elsewhere on the board
/Increment2: U201.15 (B3); also elsewhere on the board
/Increment3: U201.11 (B4); also elsewhere on the board
/Increment 8 Bits (Lower)/C_{Out}: U203.9 (C4); also elsewhere on the board
/Increment 8 Bits (Lower)/Carry: U201.9 (C4), U203.7 (C0)
/Increment 8 Bits (Lower)/Sum0: R201.1, U201.4 (S1), U202.18 (B0)
/Increment 8 Bits (Lower)/Sum1: R202.1, U201.1 (S2), U202.17 (B1)
/Increment 8 Bits (Lower)/Sum2: R203.1, U201.13 (S3), U202.16 (B2)
/Increment 8 Bits (Lower)/Sum3: R204.1, U201.10 (S4), U202.15 (B3)
/Increment 8 Bits (Lower)/Sum4: R205.1, U202.14 (B4), U203.4 (S1)
/Increment 8 Bits (Lower)/Sum5: R206.1, U202.13 (B5), U203.1 (S2)
/Increment 8 Bits (Lower)/Sum6: R207.1, U202.12 (B6), U203.13 (S3)
/Increment 8 Bits (Lower)/Sum7: R208.1, U202.11 (B7), U203.10 (S4)
/Incremented0.Out0: U202.2 (A0); also elsewhere on the board
/Incremented0.Out1: U202.3 (A1); also elsewhere on the board
/Incremented0.Out2: U202.4 (A2); also elsewhere on the board
/Incremented0.Out3: U202.5 (A3); also elsewhere on the board
/Incremented0.Out4: U202.6 (A4); also elsewhere on the board
/Incremented0.Out5: U202.7 (A5); also elsewhere on the board
/Incremented0.Out6: U202.8 (A6); also elsewhere on the board
/Incremented0.Out7: U202.9 (A7); also elsewhere on the board
/Reg0.In0: U201.5 (A1); also elsewhere on the board
/Reg0.In1: U201.3 (A2); also elsewhere on the board
/Reg0.In2: U201.14 (A3); also elsewhere on the board
/Reg0.In3: U201.12 (A4); also elsewhere on the board
/Reg0.In4: U203.5 (A1); also elsewhere on the board
/Reg0.In5: U203.3 (A2); also elsewhere on the board
/Reg0.In6: U203.14 (A3); also elsewhere on the board
/Reg0.In7: U203.12 (A4); also elsewhere on the board
/~OE: U202.19 (CE); also elsewhere on the board
GND: C301.2, C302.2, D201.1 (K), D202.1 (K), D203.1 (K), D204.1 (K), D205.1 (K), D206.1 (K), D207.1 (K), D208.1 (K), U201.7 (C0), U201.8 (GND), U202.1 (A->B), U202.10 (GND), U203.2 (B2), U203.6 (B1), U203.8 (GND), U203.11 (B4), U203.15 (B3); also elsewhere on the board
unnamed: D201.2 (A), R201.2
unnamed: D202.2 (A), R202.2
unnamed: D203.2 (A), R203.2
unnamed: D204.2 (A), R204.2
unnamed: D205.2 (A), R205.2
unnamed: D206.2 (A), R206.2
unnamed: D207.2 (A), R207.2
unnamed: D208.2 (A), R208.2
