freesurfer-rge/slothpu16/pcbs/Incrementer/Incrementer.kicad_pcb

## KiCad design pcbs/Incrementer/Incrementer.kicad_pcb (continued)

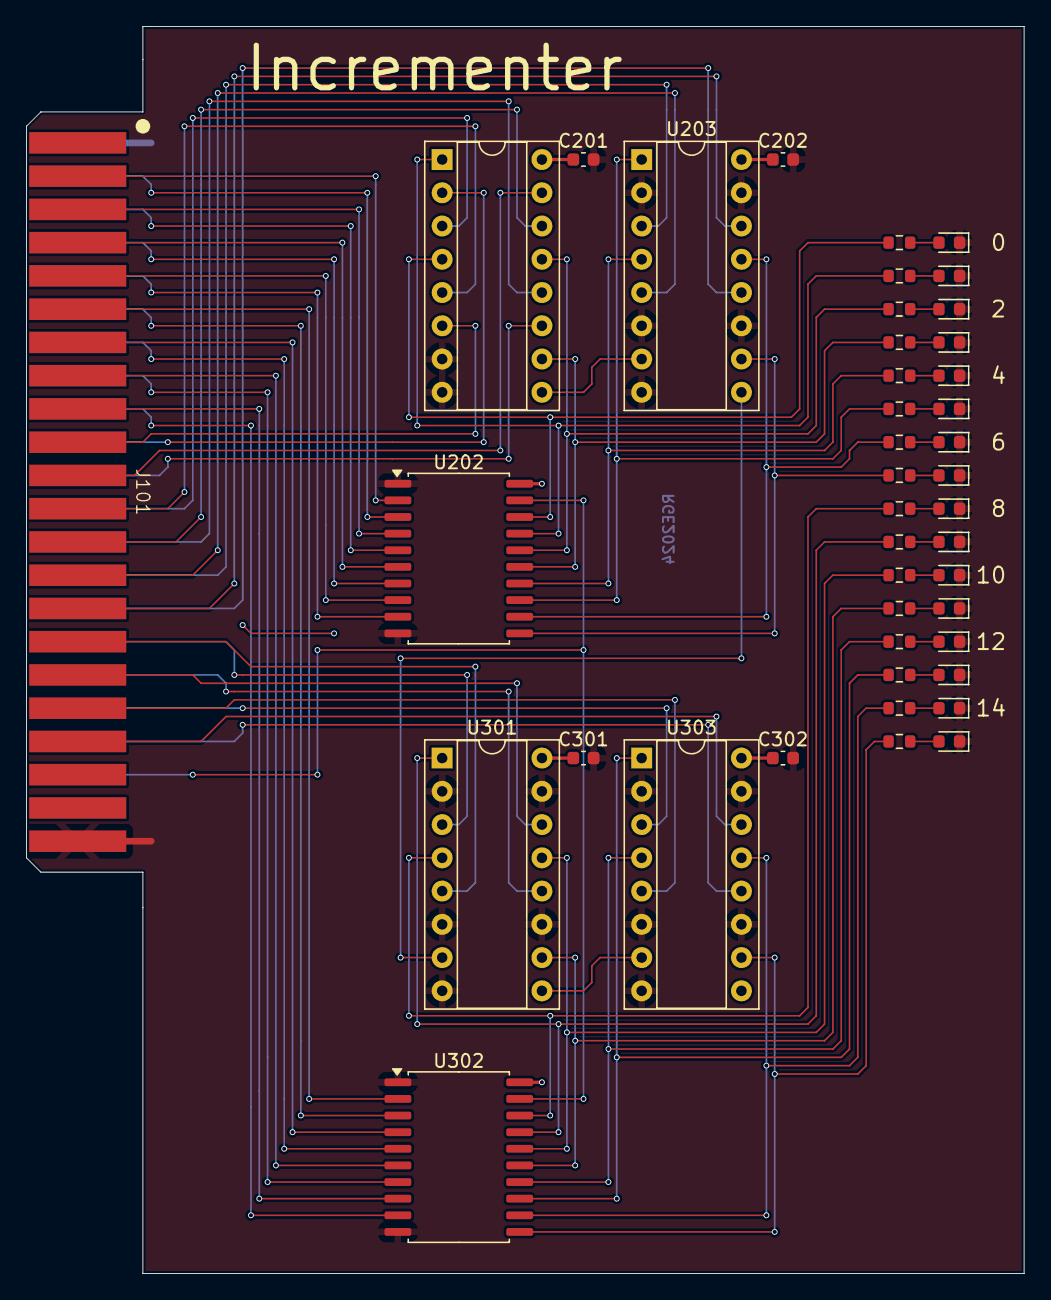
[picture p58: board Incrementer.kicad_pcb from above]

Board: 2 copper layers, 76.2 x 95.2 mm, 43 parts (0 on the bottom side), 74 nets.
