freesurfer-rge/slothpu16/pcbs/RwR Connector/RwR Connector.kicad_pcb

## KiCad design pcbs/RwR Connector/RwR Connector.kicad_pcb (2024-11-03)

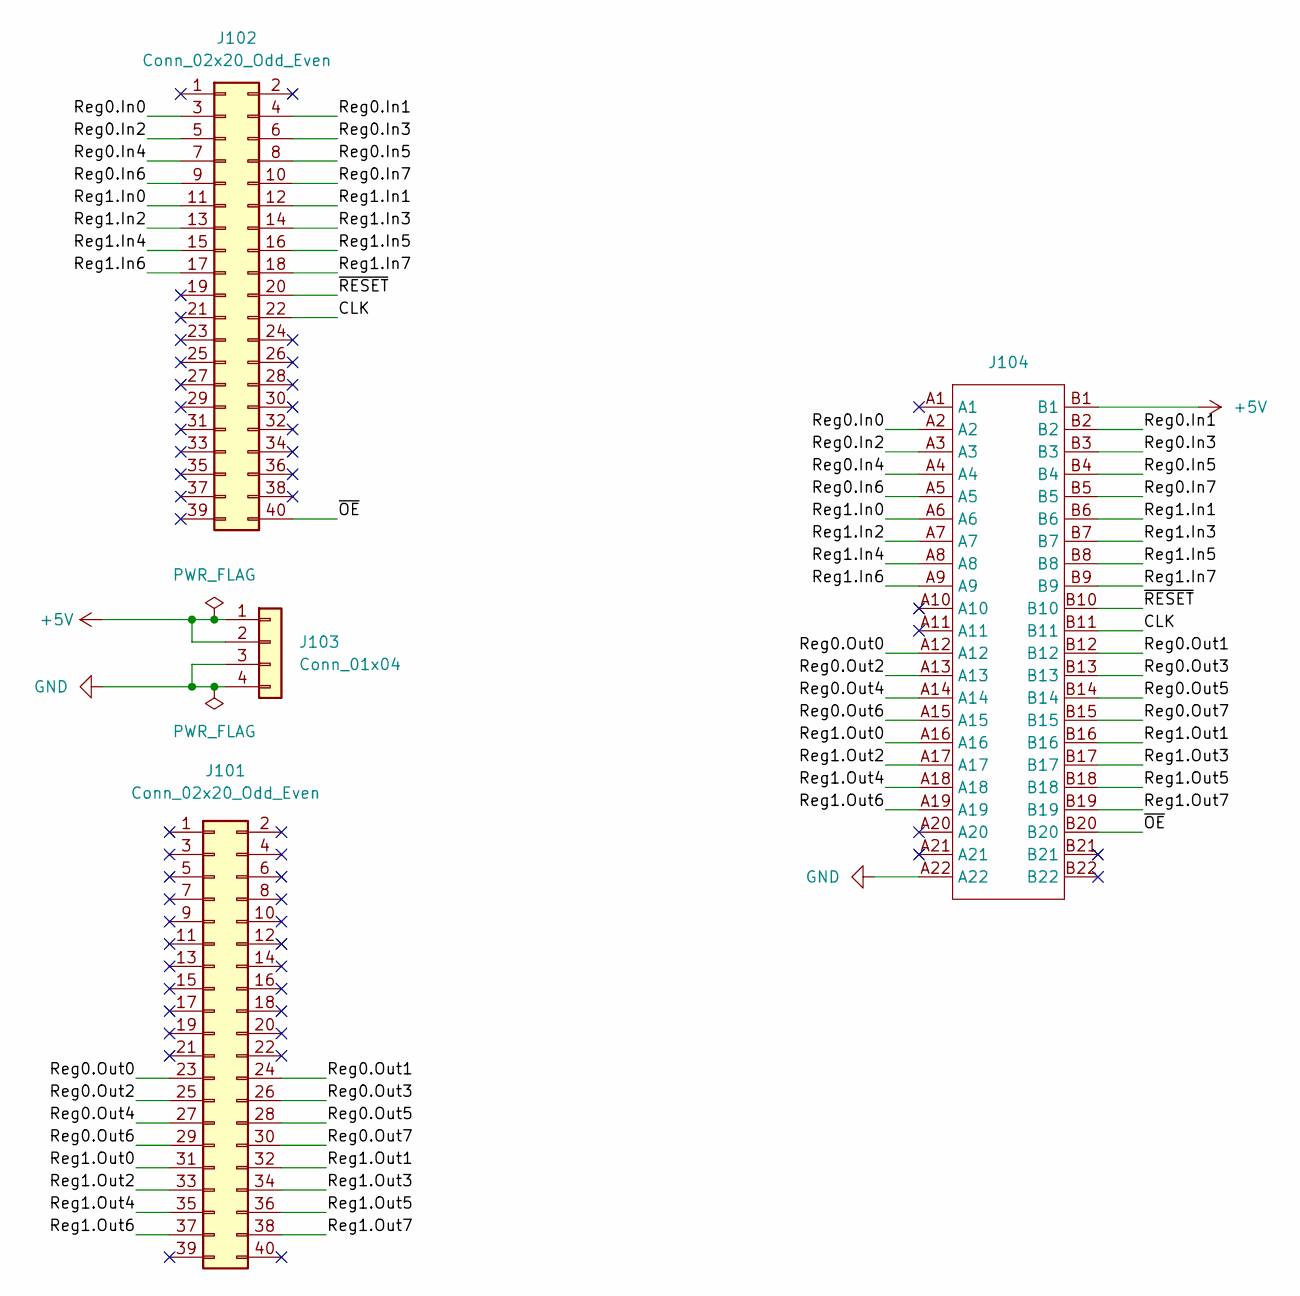
[picture p59: schematic RwR Connector.kicad_sch, Register with Reset Test Connector]

Parts:
J101, J102: Conn_02x20_Odd_Even; PinHeader_2x20_P2.54mm_Vertical
J103: Conn_01x04; PinHeader_1x04_P2.54mm_Vertical
J104: TE-5530843-4-Mount

Connections:
+5V: J103.1, J103.2, J104.B1
/CLK: J102.22, J104.B11
/Reg0.In0: J102.3, J104.A2
/Reg0.In1: J102.4, J104.B2
/Reg0.In2: J102.5, J104.A3
/Reg0.In3: J102.6, J104.B3
/Reg0.In4: J102.7, J104.A4
/Reg0.In5: J102.8, J104.B4
/Reg0.In6: J102.9, J104.A5
/Reg0.In7: J102.10, J104.B5
/Reg0.Out0: J101.23, J104.A12
/Reg0.Out1: J101.24, J104.B12
/Reg0.Out2: J101.25, J104.A13
/Reg0.Out3: J101.26, J104.B13
/Reg0.Out4: J101.27, J104.A14
/Reg0.Out5: J101.28, J104.B14
/Reg0.Out6: J101.29, J104.A15
/Reg0.Out7: J101.30, J104.B15
/Reg1.In0: J102.11, J104.A6
/Reg1.In1: J102.12, J104.B6
/Reg1.In2: J102.13, J104.A7
/Reg1.In3: J102.14, J104.B7
/Reg1.In4: J102.15, J104.A8
/Reg1.In5: J102.16, J104.B8
/Reg1.In6: J102.17, J104.A9
/Reg1.In7: J102.18, J104.B9
/Reg1.Out0: J101.31, J104.A16
/Reg1.Out1: J101.32, J104.B16
/Reg1.Out2: J101.33, J104.A17
/Reg1.Out3: J101.34, J104.B17
/Reg1.Out4: J101.35, J104.A18
/Reg1.Out5: J101.36, J104.B18
/Reg1.Out6: J101.37, J104.A19
/Reg1.Out7: J101.38, J104.B19
/~OE: J102.40, J104.B20
/~RESET: J102.20, J104.B10
GND: J103.3, J103.4, J104.A22

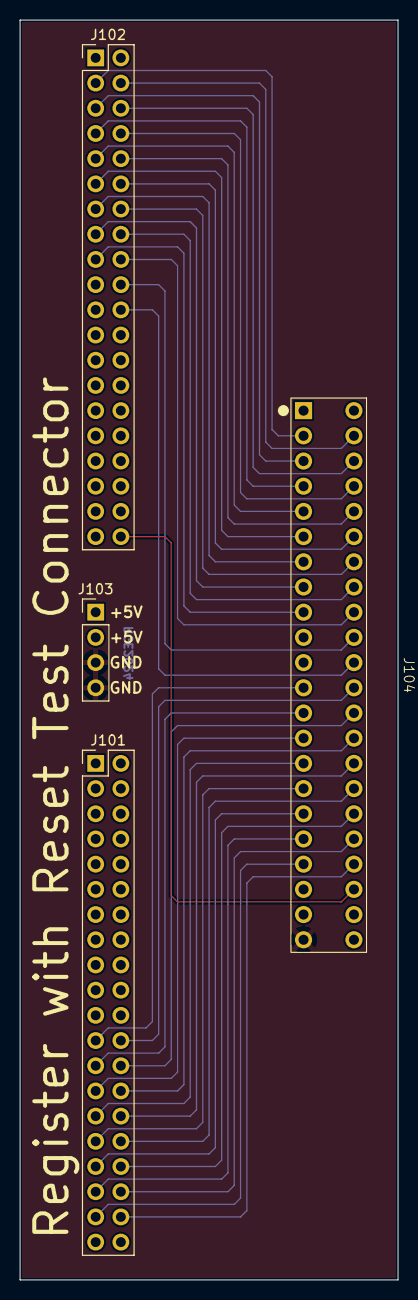
[picture p60: board RwR Connector.kicad_pcb from above]

Board: 2 copper layers, 38.1 x 127.0 mm, 4 parts (0 on the bottom side), 37 nets.
