freesurfer-rge/slothpu16/pcbs/Register with Reset/Register with Reset.kicad_pcb

## KiCad design pcbs/Register with Reset/Register with Reset.kicad_pcb (2024-11-03)

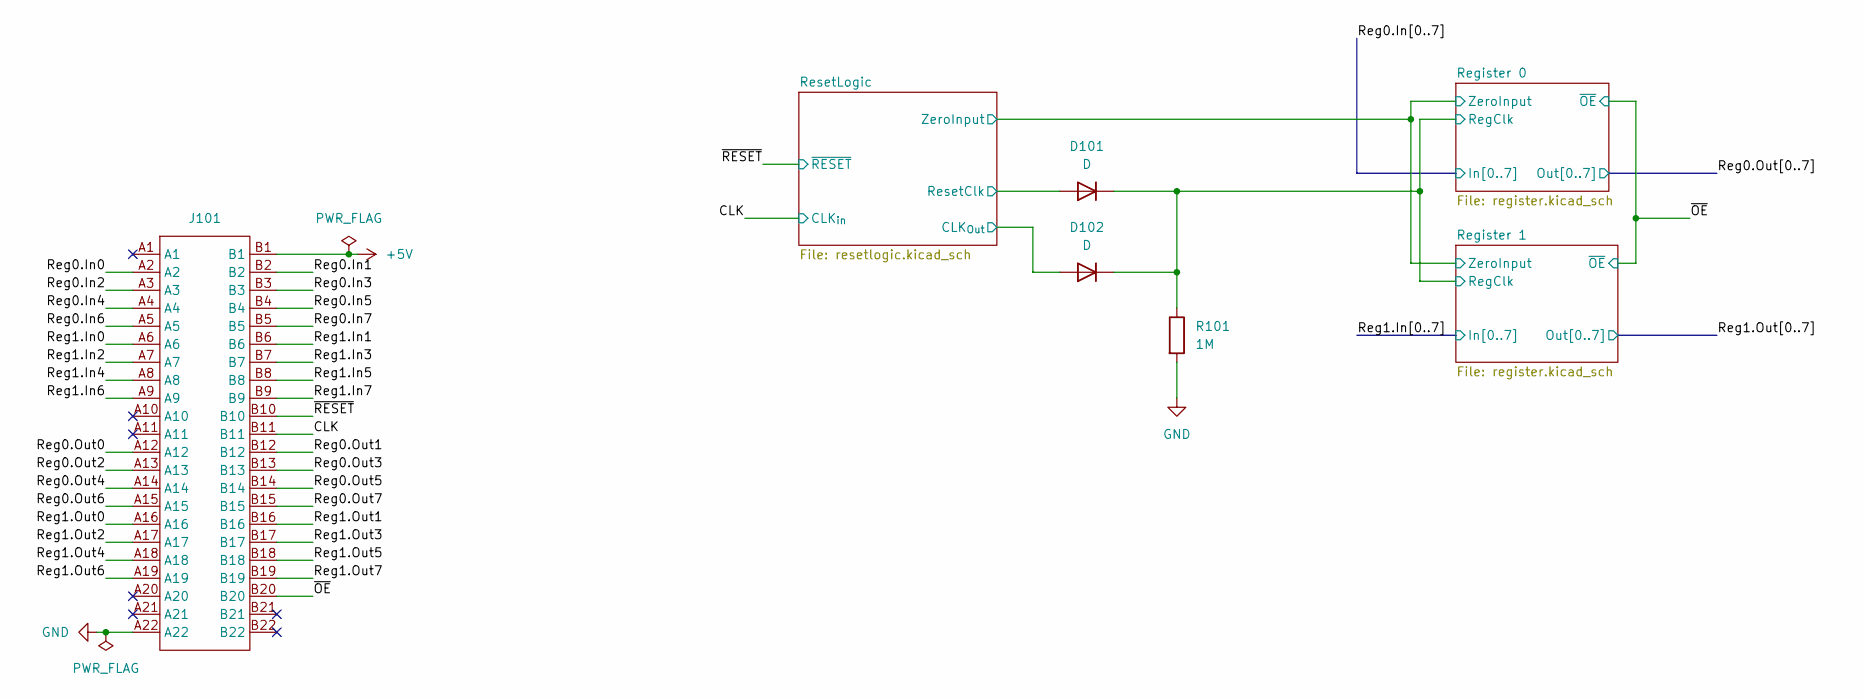
[picture p61: schematic Register with Reset.kicad_sch, 16-bit Register with Reset]

Parts:
D101, D102: D; D_SOD-123; LCSC C7420318
J101: TE-5530843-4-Edge
R101: 1M; R_0603_1608Metric; LCSC C22935

Connections:
+5V: J101.B1; also elsewhere on the board
/CLK: J101.B11; also elsewhere on the board
/Reg0.In0: J101.A2; also elsewhere on the board
/Reg0.In1: J101.B2; also elsewhere on the board
/Reg0.In2: J101.A3; also elsewhere on the board
/Reg0.In3: J101.B3; also elsewhere on the board
/Reg0.In4: J101.A4; also elsewhere on the board
/Reg0.In5: J101.B4; also elsewhere on the board
/Reg0.In6: J101.A5; also elsewhere on the board
/Reg0.In7: J101.B5; also elsewhere on the board
/Reg0.Out0: J101.A12; also elsewhere on the board
/Reg0.Out1: J101.B12; also elsewhere on the board
/Reg0.Out2: J101.A13; also elsewhere on the board
/Reg0.Out3: J101.B13; also elsewhere on the board
/Reg0.Out4: J101.A14; also elsewhere on the board
/Reg0.Out5: J101.B14; also elsewhere on the board
/Reg0.Out6: J101.A15; also elsewhere on the board
/Reg0.Out7: J101.B15; also elsewhere on the board
/Reg1.In0: J101.A6; also elsewhere on the board
/Reg1.In1: J101.B6; also elsewhere on the board
/Reg1.In2: J101.A7; also elsewhere on the board
/Reg1.In3: J101.B7; also elsewhere on the board
/Reg1.In4: J101.A8; also elsewhere on the board
/Reg1.In5: J101.B8; also elsewhere on the board
/Reg1.In6: J101.A9; also elsewhere on the board
/Reg1.In7: J101.B9; also elsewhere on the board
/Reg1.Out0: J101.A16; also elsewhere on the board
/Reg1.Out1: J101.B16; also elsewhere on the board
/Reg1.Out2: J101.A17; also elsewhere on the board
/Reg1.Out3: J101.B17; also elsewhere on the board
/Reg1.Out4: J101.A18; also elsewhere on the board
/Reg1.Out5: J101.B18; also elsewhere on the board
/Reg1.Out6: J101.A19; also elsewhere on the board
/Reg1.Out7: J101.B19; also elsewhere on the board
/Register 0/RegClk: D101.1 (K), D102.1 (K), R101.1; also elsewhere on the board
/ResetLogic/CLK_{Out}: D102.2 (A); also elsewhere on the board
/ResetLogic/ResetClk: D101.2 (A); also elsewhere on the board
/~OE: J101.B20; also elsewhere on the board
/~RESET: J101.B10; also elsewhere on the board
GND: J101.A22, R101.2; also elsewhere on the board

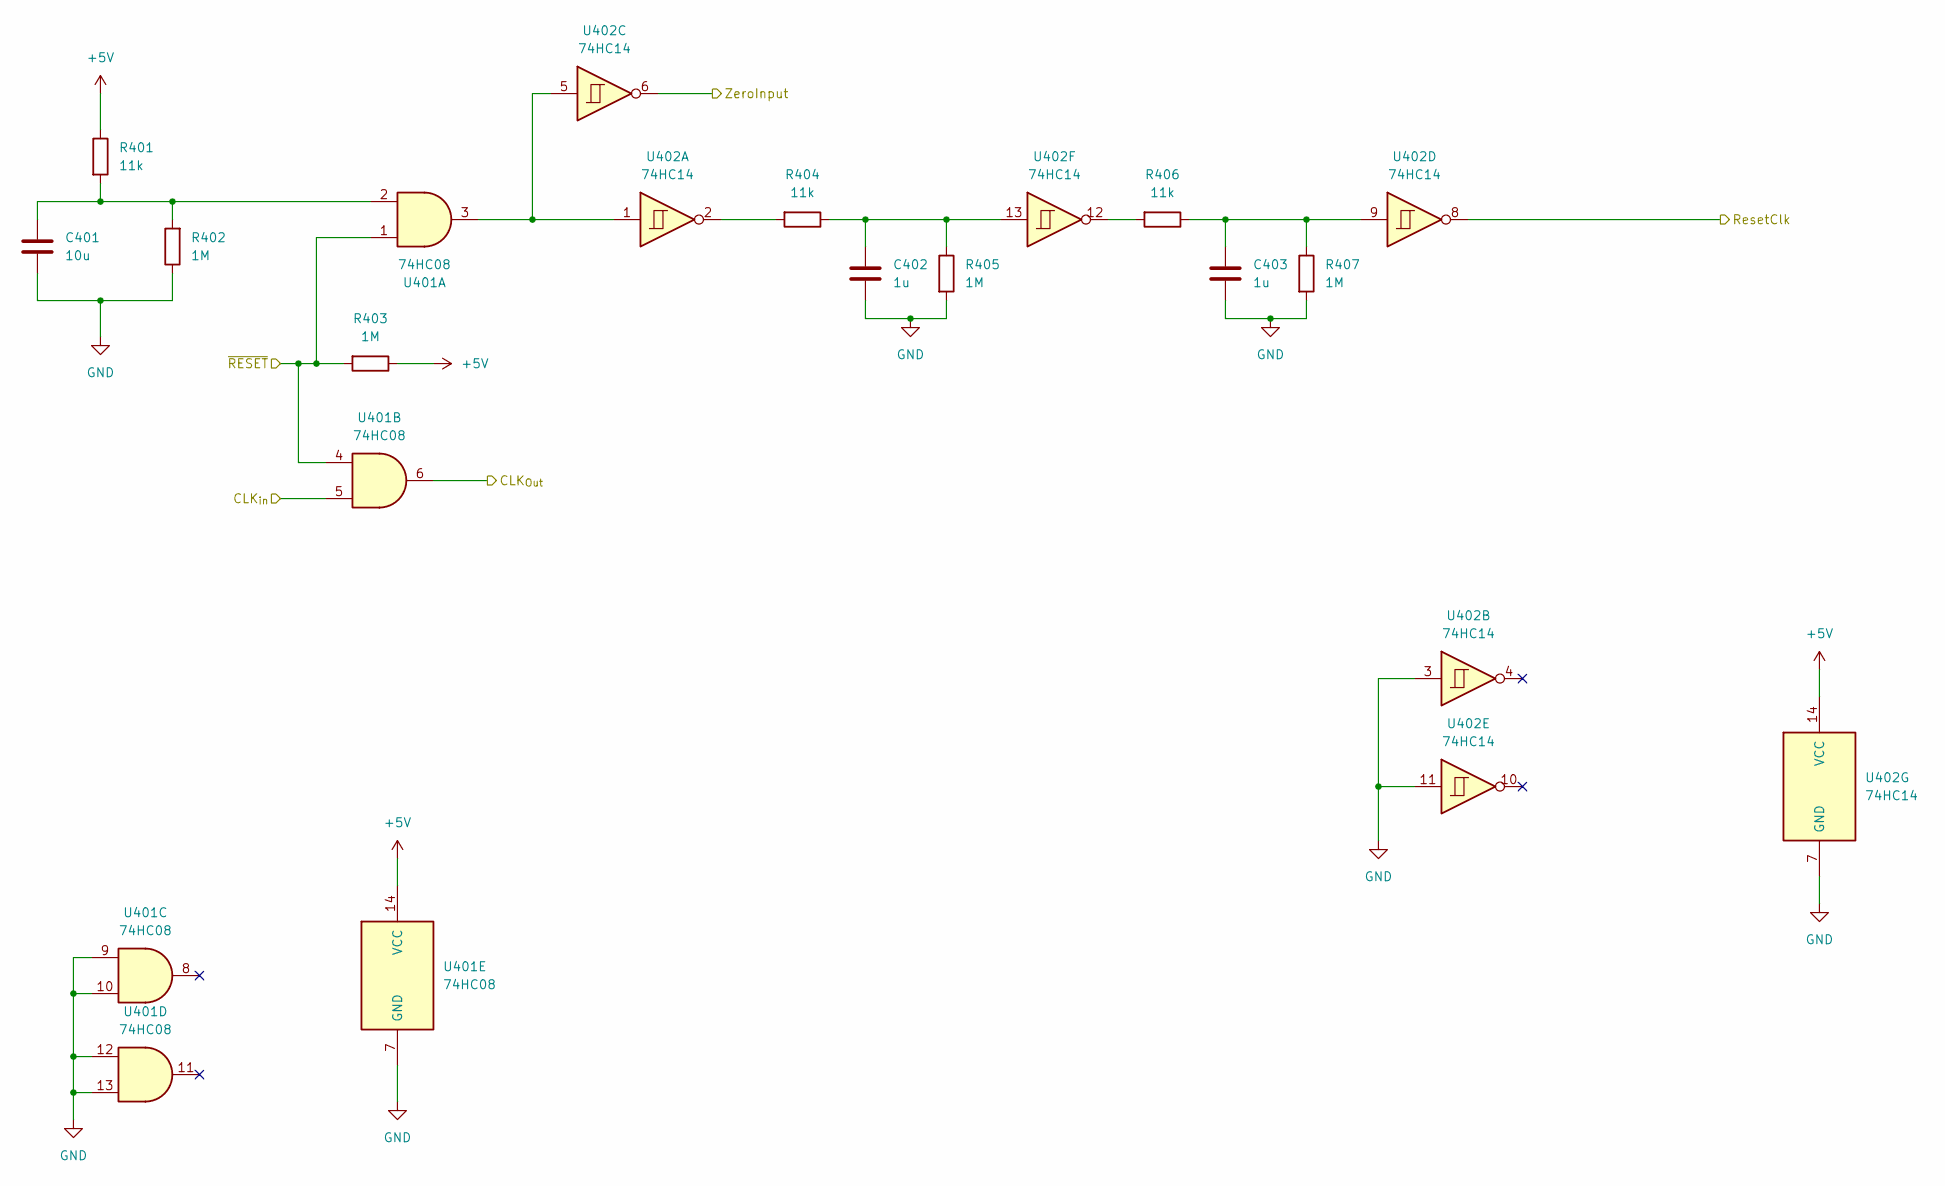
[picture p62: schematic resetlogic.kicad_sch, 16-bit Register with Reset]

Parts:
C401: 10u; C_0603_1608Metric; LCSC C19702
C402, C403: 1u; C_0603_1608Metric; LCSC C15849
R401, R404, R406: 11k; R_0603_1608Metric; LCSC C25950
R402, R403, R405, R407: 1M; R_0603_1608Metric; LCSC C22935
U401: 74HC08; SOIC-14_3.9x8.7mm_P1.27mm; LCSC C5593
U402: 74HC14; SOIC-14_3.9x8.7mm_P1.27mm; LCSC C5605

Connections:
+5V: R401.1, R403.1, U401.14 (VCC), U402.14 (VCC); also elsewhere on the board
/CLK: U401.5; also elsewhere on the board
/Register 0/ZeroInput: U402.6; also elsewhere on the board
/ResetLogic/CLK_{Out}: U401.6; also elsewhere on the board
/ResetLogic/ResetClk: U402.8; also elsewhere on the board
/~RESET: R403.2, U401.1, U401.4; also elsewhere on the board
GND: C401.2, C402.2, C403.2, R402.1, R405.2, R407.2, U401.7 (GND), U401.9, U401.10, U401.12, U401.13, U402.3, U402.7 (GND), U402.11; also elsewhere on the board
unnamed: C401.1, R401.2, R402.2, U401.2
unnamed: C402.1, R404.1, R405.1, U402.13
unnamed: C403.1, R406.1, R407.1, U402.9
unnamed: R404.2, U402.2
unnamed: R406.2, U402.12
unnamed: U401.3, U402.1, U402.5

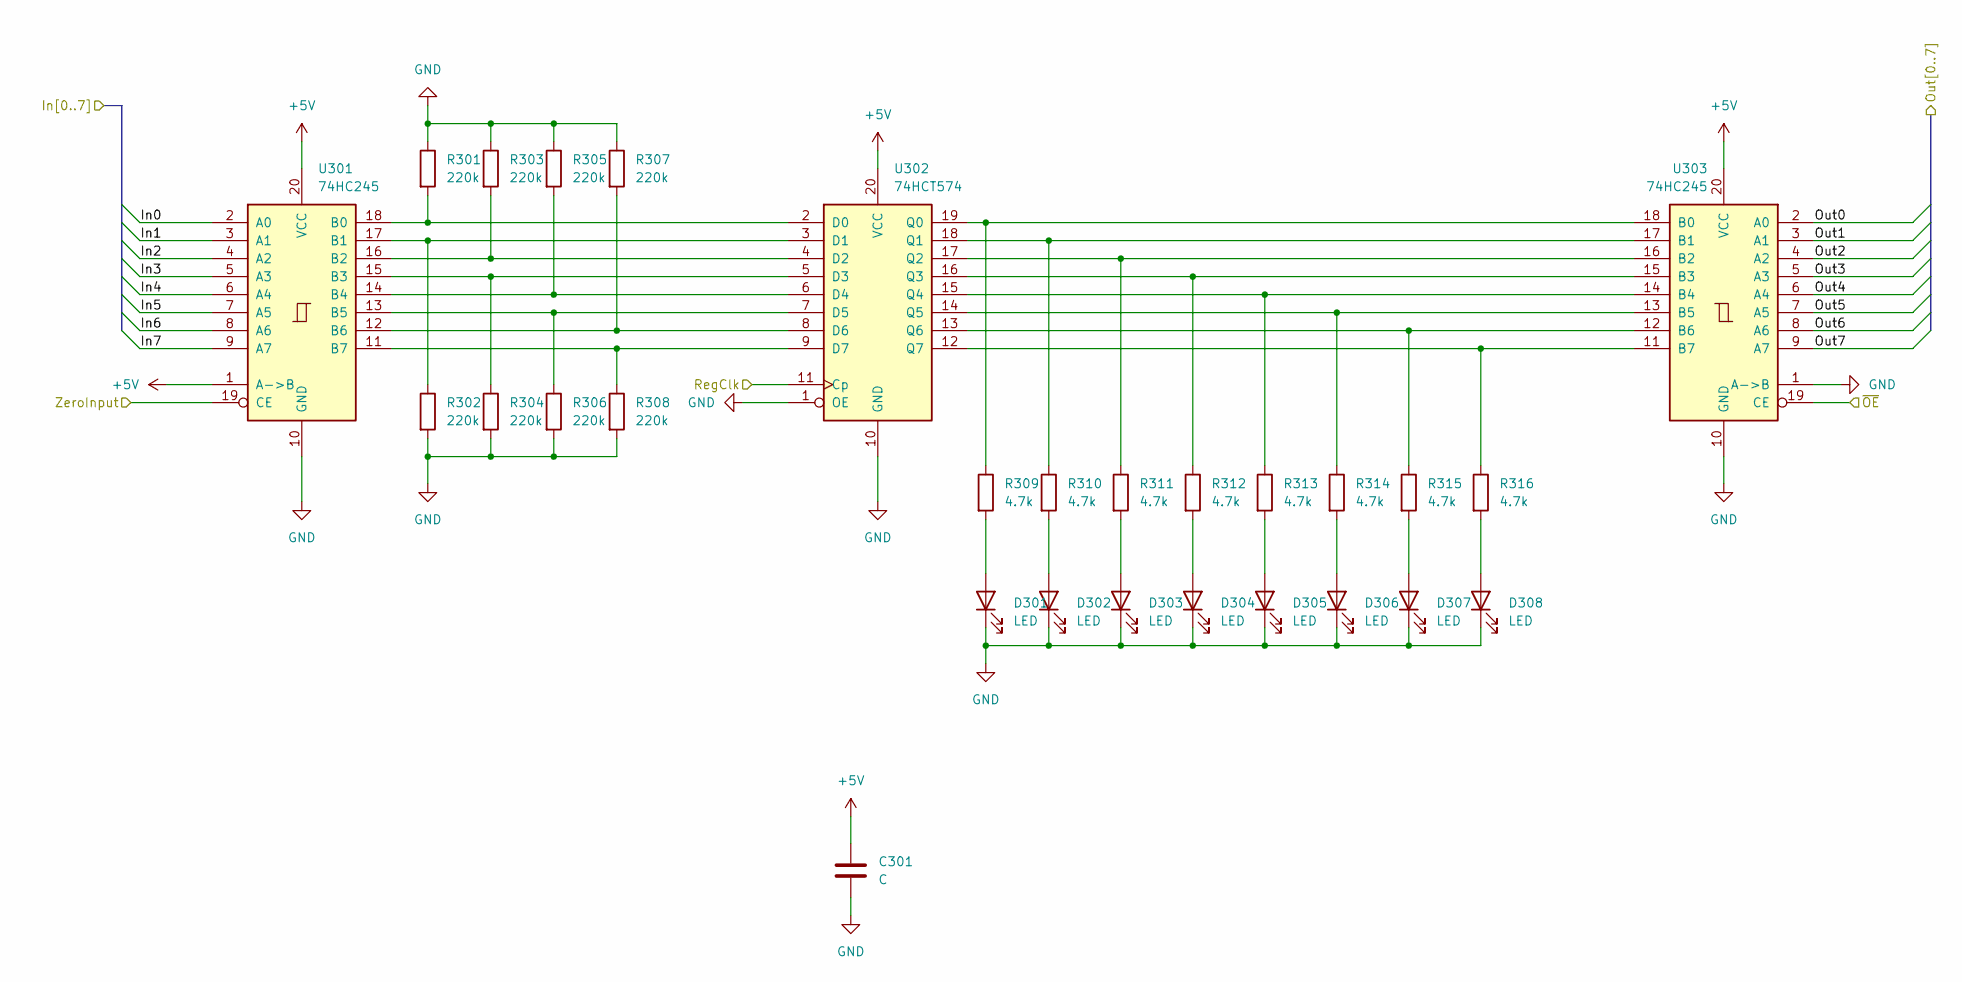
[picture p63: schematic register.kicad_sch, 16-bit Register with Reset]

Parts:
C301: C; C_0603_1608Metric; LCSC C14663
D301, D302, D303, D304, D305, D306, D307, D308: LED; LED_0603_1608Metric; LCSC C2290
R301, R302, R303, R304, R305, R306, R307, R308: 220k; R_0603_1608Metric; LCSC C22961
R309, R310, R311, R312, R313, R314, R315, R316: 4.7k; R_0603_1608Metric; LCSC C23162
U301, U303: 74HC245; SOIC-20W_7.5x12.8mm_P1.27mm; LCSC C5625
U302: 74HCT574; DIP-20_W7.62mm_Socket

Connections:
+5V: C301.1, U301.1 (A->B), U301.20 (VCC), U302.20 (VCC), U303.20 (VCC); also elsewhere on the board
/Reg1.In0: U301.2 (A0); also elsewhere on the board
/Reg1.In1: U301.3 (A1); also elsewhere on the board
/Reg1.In2: U301.4 (A2); also elsewhere on the board
/Reg1.In3: U301.5 (A3); also elsewhere on the board
/Reg1.In4: U301.6 (A4); also elsewhere on the board
/Reg1.In5: U301.7 (A5); also elsewhere on the board
/Reg1.In6: U301.8 (A6); also elsewhere on the board
/Reg1.In7: U301.9 (A7); also elsewhere on the board
/Reg1.Out0: U303.2 (A0); also elsewhere on the board
/Reg1.Out1: U303.3 (A1); also elsewhere on the board
/Reg1.Out2: U303.4 (A2); also elsewhere on the board
/Reg1.Out3: U303.5 (A3); also elsewhere on the board
/Reg1.Out4: U303.6 (A4); also elsewhere on the board
/Reg1.Out5: U303.7 (A5); also elsewhere on the board
/Reg1.Out6: U303.8 (A6); also elsewhere on the board
/Reg1.Out7: U303.9 (A7); also elsewhere on the board
/Register 0/RegClk: U302.11 (Cp); also elsewhere on the board
/Register 0/ZeroInput: U301.19 (CE); also elsewhere on the board
/~OE: U303.19 (CE); also elsewhere on the board
GND: C301.2, D301.1 (K), D302.1 (K), D303.1 (K), D304.1 (K), D305.1 (K), D306.1 (K), D307.1 (K), D308.1 (K), R301.1, R302.2, R303.1, R304.2, R305.1, R306.2, R307.1, R308.2, U301.10 (GND), U302.1 (OE), U302.10 (GND), U303.1 (A->B), U303.10 (GND); also elsewhere on the board
unnamed: D301.2 (A), R309.2
unnamed: D302.2 (A), R310.2
unnamed: D303.2 (A), R311.2
unnamed: D304.2 (A), R312.2
unnamed: D305.2 (A), R313.2
unnamed: D306.2 (A), R314.2
unnamed: D307.2 (A), R315.2
unnamed: D308.2 (A), R316.2
unnamed: R301.2, U301.18 (B0), U302.2 (D0)
unnamed: R302.1, U301.17 (B1), U302.3 (D1)
unnamed: R303.2, U301.16 (B2), U302.4 (D2)
unnamed: R304.1, U301.15 (B3), U302.5 (D3)
unnamed: R305.2, U301.14 (B4), U302.6 (D4)
unnamed: R306.1, U301.13 (B5), U302.7 (D5)
unnamed: R307.2, U301.12 (B6), U302.8 (D6)
unnamed: R308.1, U301.11 (B7), U302.9 (D7)
unnamed: R309.1, U302.19 (Q0), U303.18 (B0)
unnamed: R310.1, U302.18 (Q1), U303.17 (B1)
unnamed: R311.1, U302.17 (Q2), U303.16 (B2)
unnamed: R312.1, U302.16 (Q3), U303.15 (B3)
unnamed: R313.1, U302.15 (Q4), U303.14 (B4)
unnamed: R314.1, U302.14 (Q5), U303.13 (B5)
unnamed: R315.1, U302.13 (Q6), U303.12 (B6)
unnamed: R316.1, U302.12 (Q7), U303.11 (B7)

Parts of its further copies:
C201: C; C_0603_1608Metric; LCSC C14663
D201, D202, D203, D204, D205, D206, D207, D208: LED; LED_0603_1608Metric; LCSC C2290
R201, R202, R203, R204, R205, R206, R207, R208: 220k; R_0603_1608Metric; LCSC C22961
R209, R210, R211, R212, R213, R214, R215, R216: 4.7k; R_0603_1608Metric; LCSC C23162
U201, U203: 74HC245; SOIC-20W_7.5x12.8mm_P1.27mm; LCSC C5625
U202: 74HCT574; DIP-20_W7.62mm_Socket

Connections of its further copies:
+5V: C201.1, U201.1 (A->B), U201.20 (VCC), U202.20 (VCC), U203.20 (VCC); also elsewhere on the board
/Reg0.In0: U201.2 (A0); also elsewhere on the board
/Reg0.In1: U201.3 (A1); also elsewhere on the board
/Reg0.In2: U201.4 (A2); also elsewhere on the board
/Reg0.In3: U201.5 (A3); also elsewhere on the board
/Reg0.In4: U201.6 (A4); also elsewhere on the board
/Reg0.In5: U201.7 (A5); also elsewhere on the board
/Reg0.In6: U201.8 (A6); also elsewhere on the board
/Reg0.In7: U201.9 (A7); also elsewhere on the board
/Reg0.Out0: U203.2 (A0); also elsewhere on the board
/Reg0.Out1: U203.3 (A1); also elsewhere on the board
/Reg0.Out2: U203.4 (A2); also elsewhere on the board
/Reg0.Out3: U203.5 (A3); also elsewhere on the board
/Reg0.Out4: U203.6 (A4); also elsewhere on the board
/Reg0.Out5: U203.7 (A5); also elsewhere on the board
/Reg0.Out6: U203.8 (A6); also elsewhere on the board
/Reg0.Out7: U203.9 (A7); also elsewhere on the board
/Register 0/RegClk: U202.11 (Cp); also elsewhere on the board
/Register 0/ZeroInput: U201.19 (CE); also elsewhere on the board
/~OE: U203.19 (CE); also elsewhere on the board
GND: C201.2, D201.1 (K), D202.1 (K), D203.1 (K), D204.1 (K), D205.1 (K), D206.1 (K), D207.1 (K), D208.1 (K), R201.1, R202.2, R203.1, R204.2, R205.1, R206.2, R207.1, R208.2, U201.10 (GND), U202.1 (OE), U202.10 (GND), U203.1 (A->B), U203.10 (GND); also elsewhere on the board
unnamed: D201.2 (A), R209.2
unnamed: D202.2 (A), R210.2
unnamed: D203.2 (A), R211.2
unnamed: D204.2 (A), R212.2
unnamed: D205.2 (A), R213.2
unnamed: D206.2 (A), R214.2
unnamed: D207.2 (A), R215.2
unnamed: D208.2 (A), R216.2
unnamed: R201.2, U201.18 (B0), U202.2 (D0)
unnamed: R202.1, U201.17 (B1), U202.3 (D1)
unnamed: R203.2, U201.16 (B2), U202.4 (D2)
unnamed: R204.1, U201.15 (B3), U202.5 (D3)
unnamed: R205.2, U201.14 (B4), U202.6 (D4)
unnamed: R206.1, U201.13 (B5), U202.7 (D5)
unnamed: R207.2, U201.12 (B6), U202.8 (D6)
unnamed: R208.1, U201.11 (B7), U202.9 (D7)
unnamed: R209.1, U202.19 (Q0), U203.18 (B0)
unnamed: R210.1, U202.18 (Q1), U203.17 (B1)
unnamed: R211.1, U202.17 (Q2), U203.16 (B2)
unnamed: R212.1, U202.16 (Q3), U203.15 (B3)
unnamed: R213.1, U202.15 (Q4), U203.14 (B4)
unnamed: R214.1, U202.14 (Q5), U203.13 (B5)
unnamed: R215.1, U202.13 (Q6), U203.12 (B6)
unnamed: R216.1, U202.12 (Q7), U203.11 (B7)

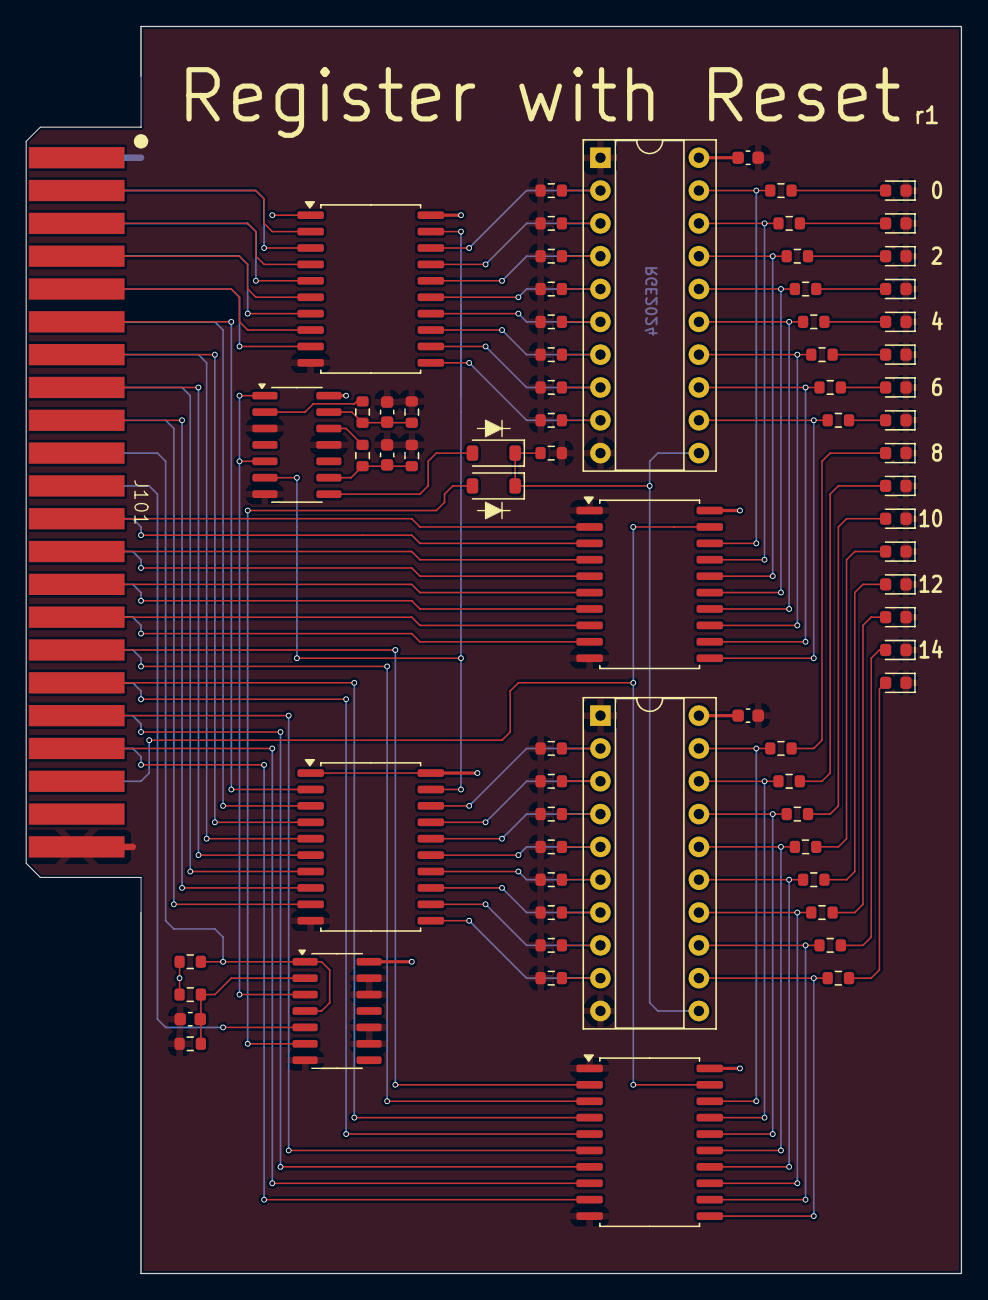
[picture p64: board Register with Reset.kicad_pcb from above]

Board: 2 copper layers, 72.4 x 96.5 mm, 72 parts (0 on the bottom side), 95 nets.
