freesurfer-rge/slothpu16/(commit log)

2024-09-24 [Board] Register with Reset (#1)
    Add a board for a 16-bit register, with a reset line. Includes a test connector to the SlothPU tester board.
    Some notes:
    - Had to increase via size from the 'capabilities' page, since the minimum sizes cost more
    - I believe that the diodes (but not LEDs) were orientated backwards in the default placement. If I'm wrong, there will be an r1 board....
    [Register with Reset.kicad_pcb, Register with Reset.kicad_sch, RwR Connector.kicad_pcb, RwR Connector.kicad_sch, register.kicad_sch, resetlogic.kicad_sch]
2024-10-20 Tester for Register with Reset (#2)
    Bring over the `tester_board.py` from [SlothPU](https://www.github.com/freesurfer-rge/slothpu/) and create tests of the Register with Reset board.
    ReadMe has been updated with notes from the testing.
    [rwr_connector_board.py, test_register_with_reset.py, tester_board.py]
2024-11-03 Revise the Register with Reset (#3)
    Updates to Register-with-Reset:
    - Convert to edge connector
    - Route clock through an 'AND' with the Reset line, so the clock doesn't block reset
    - Shrink the board somewhat by repositioning components
    [Register with Reset.kicad_pcb, Register with Reset.kicad_sch, RwR Connector.kicad_pcb, RwR Connector.kicad_sch, register.kicad_sch, resetlogic.kicad_sch]
2024-11-16 Update Register with Reset tests (#4)
    Having some issues with the tests on the r1 board. Make some updates (which now pass, and appear to be working correctly), but reasons for behaviours observed are not entirely clear.
    [rwr_connector_board.py, test_register_with_reset.py]
2024-11-17 Incrementer (#5)
    Add a PCB (and associated test connector) for the incrementer. This will go on the Program Counter board, next to the Register-with-Reset board (which will be the program counter itself), and handle the 'normal' (i.e. non-branching) updates to the PC.
    [Incrementer Connector.kicad_pcb, Incrementer Connector.kicad_sch, Incrementer.kicad_pcb, Incrementer.kicad_sch, inc8b.kicad_sch]
2024-11-30 Tester for Incrementer (#6)
    Add Python code for testing the incrementer board
2024-12-08 Barrel Shifter & Register File (#7)
    Two more boards:
    - 16-bit half-barrel shifter
    - 8x 8-bit registers
    Both of these boards should ultimately be used in multiple, to make up 16-bit functionality.
    [Barrel Shifter Connector.kicad_pcb, Barrel Shifter Connector.kicad_sch, Barrel Shifter.kicad_pcb, Barrel Shifter.kicad_sch, Register File Connector.kicad_pcb, Register File Connector.kicad_sch, Register File.kicad_pcb, Register File.kicad_sch]
2024-12-24 Further ALU units (#8)
    Three final units for the ALU:
    - Comparator (16-bit)
    - Adder/Subtracter (8-bit)
    - XOR/NAND (8-bit)
    There is also a single test connector board, which should be able to accept any of the boards (but only one at a time).
    [ALU Test Connector.kicad_pcb, ALU Test Connector.kicad_sch, Adder Subtractor.kicad_pcb, Adder Subtractor.kicad_sch, Comparator.kicad_pcb, Comparator.kicad_sch, NAND XOR.kicad_pcb, NAND XOR.kicad_sch]
2024-12-27 [Doc] Getting started (#9)
    Start writing the documentation for SlothPU16. Doing this will unblock creation of the next set of boards, which will hold the various individual functions which I've been creating.
2024-12-31 Further board tests (#10)
    Tests for the register file and barrel shifter
2025-01-01 ALU Testing (#11)
    Add tests for the cards which use the common ALU connector:
    - Comparator
    - NAND/XOR
    - Add/Subtract
2025-01-11 [PCB] Pi Backplane (#12)
    A connector board, designed to link a Pi to the backplane. This will have two purposes:
    - Testing individual functional units (particularly the PC and ALU)
    - Acting as memory for the whole machine
    The core of the design are two banks of shift registers (one output, one input), which are connected to the backplane connector itself. The Pi sends data to the output shift registers, and reads from the input shift registers. The pins in the backplane connector are grouped into buses (A, B etc.), and the corresponding output shift registers set to high impedance for the entire bus. The only pins which are isolatable individually are the clock and reset pins.
    [Pi Backplane Connector.kicad_pcb, Pi Backplane Connector.kicad_sch, inputs.kicad_sch, outputs.kicad_sch, picontrol.kicad_sch]
2025-01-19 [Test] Pi Backplane (#13)
    Add a class for handling the Pi Backplane Connector board (in the `python-testing` directory for now), along with a test file (since the point of the board is that outputs also have connections to inputs).
    The re-ordering going on with the input registers is.... quite something.
2025-02-02 [PCB] ALU Carrier (#14)
    Create the ALU carrier, to hold the various individual boards which have been created so far.
    [ALU Carrier.kicad_pcb, ALU Carrier.kicad_sch, addsub.kicad_sch, barrel.kicad_sch, compare.kicad_sch, decoder.kicad_sch, enabler.kicad_sch, output.kicad_sch]
2025-04-06 Fix for ALU Carrier (#16)
    Fix the connections to the barrel shifter. A copy/paste error had left these the same for both of the connectors, when one was supposed to have the inputs rotated by 8 steps.
    Also name the connectors on the silkscreen (closes #15 )
    [ALU Carrier.kicad_pcb, ALU Carrier.kicad_sch, barrel.kicad_sch]
2025-04-26 ALU Python Tests (#17)
    Tests of the whole ALU carrier board.
2025-04-28 Expanding Register File testing (#18)
    Expand the register file tests a little, making sure that multiple 'static' values are correctly held. Also introduce a constant to replace a magic number.
    [test_registerfile.py]
2025-05-16 [PCB] Register File Carrier (#19)
    Carrier board to combine four of the previously designed register files into a single bank of sixteen 16-bit registers.
    [Register File Carrier.kicad_pcb, Register File Carrier.kicad_sch, connectors.kicad_sch, enabler.kicad_sch, outputbuffer.kicad_sch]
2025-05-26 [PCB] Register File Carrier r01 (#21)
    Update the Register File Carrier to get the 'enable' logic correct. Had constructed an 'Active High' when 'Active Low' was required.
    Also should address #20 , standardising on a single part.
    [Register File Carrier.kicad_pcb, connectors.kicad_sch, enabler.kicad_sch]
2025-06-08 [Test] Test for Register Carrier (#22)
    Add a test file for the Register Carrier board.
2025-07-27 [PCB] Program Counter (#23)
    Initial design of the program counter. Have added a markdown file to the docs which describes the operation.
    [BufferLR.kicad_sch, BufferRL.kicad_sch, Program Counter.kicad_pcb, Program Counter.kicad_sch, bbuscheck.kicad_sch, enabler.kicad_sch]
2025-08-16 [Test] Tests for the Program Counter (#24)
    A small set of tests for the program counter board. We should be considering doing some refactoring of the tests.
2025-08-27 [PCB] Instruction Register (#25)
    Add the instruction register (also contains the 'SET' instruction). Note that it reads the new instruction on B bus, which is a possibly questionable decision.
    [Instruction Register.kicad_pcb, Instruction Register.kicad_sch, control.kicad_sch, setoutput.kicad_sch]
2025-09-07 [Test] Test for Instruction Register (#26)
    Tests of the Instruction Register (which also holds the 'Set' instruction). This refactors some code from other tests into `constants.py` and `utils.py`. These moves have not been fully tested.
    Also note that there needs to be a delay after completing a RESET, in order to allow the RC delays in the RwR logic to fully reset.
    [constants.py, test_instruction_register.py, test_program_counter.py, test_register_carrier.py, utils.py]
2025-09-15 [PCB] Backplane (#27)
    The backplane for connecting the various sub-assemblies together. Will actually need two of these put together, because it would be absurdly large otherwise.
    [SlothPU Backplane.kicad_pcb, SlothPU Backplane.kicad_sch]
2025-12-21 [Feature] Driver for SlothPU16 (#28)
    A Python program to run SlothPU16, supplying the clock signal and memory. This is a minimal implementation (in particular, the four memory related instructions are not yet implemented), with a handful of sample programs which have been tested on the hardware.
2026-09-27 Emulator beginnings (#33)
    Starting work on an emulator for SlothPU16, with the ultimate goal of creating a compiler. This is very much a small beginning, working on the instructions (and at least some of the required conversion to other formats), and the main memory and register file.
    Note that this new code is completely separate from that in the testing directory for the PCBs. There may ultimately be some crossover, but that is for the future.
2026-10-09 [EMU] SlothPU16 Emulator (#35)
    Implementing a simple emulator for SlothPU16.
2026-10-17 [Python] Simple UI for the emulator (#36)
    Putting together a very simple UI for the SlothPU16 emulator using [textual](https://textual.textualize.io/). At this point, testing is minimal, since I may well want to move things around. To make some things easier, iterators were added to the emulator's `RegisterFile` and `MainMemory` classes.
